goforwest/LipSync/CHANGES.txt

Version 4.9.6 | 2026-11-12
- THE 4.9.5 LATCH GUARD IS NOW HOST-TESTED, AND THE TEST FOUND A REAL BUG IN IT (the residual from the 4.9.5 bench, closed properly): the mid-window latch fix was the one item the radio bench could not cheaply prove — outputAction has no wire readout, so the field test would need a precisely timed physical SCROLL hold and could only infer the outcome from whether the next input emitted an IA,0 dispatch line. Rather than accept an indirect gesture test, the guard's decision is now the pure lsHostLatchCrossedHost() in LSHostSwitch.h (the LSPressureClassify/LSHostSwitch pattern), pinned by 9 new host checks: no-latch is always a no-op, same-host keeps the hold, host-changed releases, none->host and host->none both release, full-string (not prefix) equality, NULL-safe, and the RPA-stability property the fix relies on. Writing those tests immediately exposed an out-of-bounds read in the helper: the fixed-count comparison loop ran i <= LSHOST_MAC_CHARS over keys that can be SHORT ("" for an absent host), reading one byte past a short literal's NUL — ASan caught it as a global-buffer-overflow (168/168 timer, core aborted at 134). The loop now stops at the first NUL while still comparing full strings, so differing lengths stay unequal. This is the loop's characteristic failure mode (a fix introducing its own defect) caught by tooling rather than by another review round — the argument for making behavior testable instead of merely traced
- WHY THE GUARD'S PREMISE HOLDS (verified in the vendored lib, not assumed): the host key is the STORED BOND IDENTITY — lsHostActiveMac requires conn->bonded() and BLEConnection::getPeerAddr() returns _bond_id_addr whenever bonded (BLEConnection.cpp:133-136), which is assigned from the bond's peer_id.id_addr_info (saved/loaded at BLEConnection.cpp:260/269), never the live peer address. A privacy host's rotating RPA therefore cannot make consecutive reads differ and spuriously drop a legitimate hold — the property the new host test pins
- ALSO RELEASED IN THIS ROUND (the bench's other finding, harness-side but worth recording): a 4.9.5 bench re-run scored 11/11 wire-settled steps PASS, with both apparent failures traced to the DRIVER and not the firmware — the first B15 attempt opened no window because BT,1:3 was correctly refused with LSHOST_REFUSE_RADIO while the prior window tore down, and the bonds check ran while the device was legitimately in USB mode where BT,0 correctly refuses. Both are the honest-refusal behavior the review loop spent rounds establishing; full results in Build_Files/bench-16-4.9.5-results-2026-11-12.txt
- VERIFICATION: host core suite 206/206 under ASan/UBSan (9 new latch-guard checks + the 4 anchor checks from 4.9.5), timer suite 168/168; production compile clean at --warnings all (46% flash / 24% RAM); source ZIP rebuilt with the workflow's exact recipe and verified byte-identical. The guard's non-window behavior remains byte-identical to the bench-proven 4.9.4 path
- UPSTREAM-COUNT CLARIFICATION (for the next auditor of these posture lines): the tracker's 45 open ITEMS are 44 open ISSUES plus PR #81 (itself dispositioned upstream-side). Every posture line below that says "all 44 open upstream issues" means exactly those 44; a final pre-merge verification pass confirmed via the GitHub API that the disposition union across all posture lines covers precisely the 44 with none missing and none closed

Version 4.9.5 | 2026-11-11
- THE FINAL-DIFF-AUDIT FIX SET (a fresh-context adversarial pass over the exact shipped 4.9.4 diff — 4 reviewers with independent lenses plus per-finding adversarial verification, 11 agents; launched after the V4.9.4 release because the fix set had produced 3 of its own defects in review rounds 6-8 and was newly field-facing via the updater branch). 7 confirmed findings: 1 minor + 6 nits, zero majors. All fixed or corrected here; released as 4.9.5 within hours of 4.9.4 so the field exposure window stayed minutes-deep.
- A MID-WINDOW LATCH COULD CROSS THE SWITCH AND SWALLOW THE NEW HOST'S FIRST INPUT (minor, the real one): the 4.9.4 round-3 window gate keyed its latch guard on `!switchWindowOpen && !tempIsConnected` — but the input polls stay LIVE during a window, so a gesture engaged mid-window armed the latch while the guard was suppressed, and on the SUCCESS path (target admitted) tempIsConnected is true on every later pass: the latch crossed into the new host, whose first input took the hold-release branch and dispatched nothing (one swallowed input; joystick-as-scroll until then). The verifier's trace sharpened it: the DRAG half was mostly guarded elsewhere (LSBLEMouse::service's disconnect-cleanup flag raises within one main-loop pass and the loop's cancelSapOutputHold consumer ends the latch — only an ms-wide race could cross it), but the SCROLL half was unguarded end-to-end (cursorScroll sets no wire state, so the take-and-clear flag never raises). The guard's own contract ("never carry a latch across hosts") is now keyed on the connected host's IDENTITY via lsHostActiveMac (a bounded stack query, no FS): any host-key edge — none->target at admission, racer->none->target through a bounce storm, or host->host across a sub-second switch whose whole window fits between two 1 s polls — releases a held latch through cancelSapOutputHold() (LED default paired, no action-bearing event, the sensor-fault/unmount mirror shape). The original disconnected-state guard stays for every non-window path (zero non-window behavior change), and the identity key CANNOT reintroduce the bounce-storm churn the round-3 gate fixed: it flaps during bounces only while a latch is HELD, and the first edge releases it (outputAction -> NOTHING), so later flaps are no-ops and the LED/push narration stays suppressed. This also covers the audit's fifth-ordering finding (below) for the latch: even a window btFeedbackLoop never observed open releases its latch at the next host-key edge
- THE HORIZON ANCHOR'S FALLBACK WAS DEAD CODE, AND THREE SHIPPED DOCS MIS-ATTRIBUTED IT (nit x3, same root, three reviewers independently): `dispatchedMs ? dispatchedMs : connectMs` is unreachable as a connect-stamp selection — counted==true is set at exactly one site which co-stamps the dispatch on the next line, and every clear site clears both. The refused-disconnect case the 4.9.4 notes claimed the fallback served is actually DISPATCH-anchored: the stamp is taken at the decision point BEFORE the disconnect attempt whose rc is deliberately ignored (so a refused attempt marks the horizon from itself; each re-observe re-stamps — the re-decide cadence in that shape is connect+15 s, not the documented connect+12 s, bounded and in the safe direction). CHANGES.txt round 2, the LSHostSwitch.h helper doc, and the LSBLE.h inline comment all attributed the fallback to the refused case; all three now state the shipped truth. The anchor selection is extracted as the pure lsHostBounceHorizonAnchor() — now genuinely host-tested (the audit's "test-pinned" over-claim: the 4.9.4 suite pinned the comparison helper's arithmetic, not the shipped selection; a revert of the ternary passed 188/188) — and the first-observation reset site now clears the stamp with its tracking (previously stale-but-provably-never-read; the invariant no longer depends on that)
- THE ROUND-7 "ALL FOUR ORDERINGS" CLAIM MISSED A FIFTH (nit, behavior converges identically): a window whose ENTIRE lifetime fits between two btFeedbackLoop passes (sub-second target admission — bench-precedented: the racer connected 0.4 s into a window) is never observed open by the poll, so both reconciliation blocks skip and ZERO window-end reconciliations run — not the claimed exactly-one. Traced benign by the verifier end-to-end: the ungated transition block repaints the LED on the real transition (or the pre-window paint already equals the settled color), and the ungated change-detected push lands the settled truth the same pass. Behavior converges within one pass in every case; the defect was the completeness claim in CHANGES round 7 / round 9, now recorded here as the honest disposition. The latch half of that ordering is separately covered by the identity-key fix above
- THE GATE COMMENTS PROMISED AN APP AUTO-RETRY THAT DOES NOT EXIST (nit): the CA,1/IN,1 window-gate comments said "the app retries once the window closes" — sendCommand is one-shot and the retry is manual. Both comments now state the shipped truth (the app's waiter surfaces the refusal as a clean error via the fail-fast abort contract; the user re-runs the flow)
- VERIFICATION: host core suite 192/192 under ASan/UBSan (4 new checks pinning lsHostBounceHorizonAnchor: dispatched-wins, the wrap-tick fallback, the both-zero degenerate state, and the dispatch-over-connect selection), timer suite 168/168; production compile clean at --warnings all; source ZIP rebuilt with the workflow's exact recipe and verified byte-identical. The 4.9.4 bench results (B13-B15) stand — none of this round's code changes touches a path the bench proved except the latch guard, whose non-window behavior is byte-identical and whose window behavior was the defect being fixed

Version 4.9.4 | 2026-11-11
- THE 4.9.4 REVIEW-ROUND FIX SET (a fresh full-tree adversarial review over every firmware module — LSAPI/LipSync_Firmware/LSScreen/LSBLE/LSPressure/LSJoystick/LSInput/LSMemory/LSTimer/LSUSB/LSBuzzer/the pure helpers — plus the paired LipSync_Connect protocol layer and a re-verification of every recorded upstream disposition; production compile clean at --warnings all, host suites 188/188 core + 168/168 timer under ASan/UBSan). Seven majors — six regressions of the 4.9.x reshapes plus one in this review loop's own round-3 fix:
- THE SWITCH WINDOW'S KEEP-OPEN WAS DEAD CODE — THE RADIO WENT DARK AFTER THE FIRST BOUNCE (major, the 4.9.3 open-door reshape's own seam): lsHostSwitchWindowTick's keep-open branch called lsHostEnsureAdvertising(), whose FIRST guard refuses whenever a window is open (`if (g_switchWindowOpen) return false;`) — a 4.9.0 directed-era rule whose rationale ("do not fill the directed set's inter-arm gap with open advertising") does not apply to the open-window shape the 4.9.3 verdict shipped, and which made the re-ensure a silent no-op. The LIVE case is the bouncer's own bounce: a non-target connect STOPS the advertising set (the connection takes the radio role), the bounce disconnects it, and the stock DISCONNECTED auto-restart is SUSPENDED for the entire window lifecycle (lsHostSuspendAutoRestart, 4.8.7 — deliberately, so the racer cannot win the gap). Nothing else re-starts the set, so after ONE bounced non-target the window advertised nothing at all for its remaining bound: the TARGET could never connect (the switch silently could not complete), and the window burned its full 60 s before closing into open advertising — the exact opposite of the bouncer's "keep waiting for the target" contract. The keep-open now starts the set directly (while this window is open, open advertising IS the window); the tick retries every pass, so a refused start is self-correcting rather than terminal
- THE UM,1 ACK COULD STILL BE LOST TO THE RESET (major, the 4.9.1 drain fix's missing back-port): 4.9.1 closed the response-before-reset hole for softwareReset()'s dwell (CM/MP/SR/RS/FR) by draining serialTxService() every 10 ms — but enterUpdateMode() kept its own bare `delay(CONF_UPDATE_MODE_DWELL_MS)` before the reset, so the UM,1 ack it prints still rode the TX queue with no drain. A host that stopped reading the IN pipe (or a full CDC FIFO) left the ack queued, the reset killed the queue with the line still in it, and the port dropped with NO response — while LipSync Connect's update path blocks on exactly that ack (`sendCommand('UM,1:1', ...)`) and falls back to the SR + 1200-baud-touch choreography only when it FAILS, so the lost ack costs the deliberate-splash path and sends a healthy update down the legacy route (or times the wizard out). The dwell now drains the queue identically to softwareReset's
- ROUND 9 — VERIFICATION ROUND (no functional change; the loop's first clean round): every one of the nine 4.9.4 fixes was re-read in CODE (not by its comment) and its enclosing function confirmed — the switch window's keep-open direct start, the UM,1 dwell drain, the dispatch-anchored bounce horizon (+ the host-pinned helper), the btFeedbackLoop window gate (drag latch / LED narration / host push), the post-tick window-end reconciliation, the softwareReset close, and the CA,1 / IN,1 / UM window gates. The btFeedbackLoop control flow was then traced as a skeleton across every reachable ordering; the one residual case (a window OPENING mid-pass) is unreachable because the tick never opens windows — lsHostBeginSwitchWindow is reached only from the executor on the serial/menu path, never reentrant with this poll — and was confirmed consistent, not merely assumed. Full verification from a clean build directory: production compile clean at --warnings all (376120 B / 46% flash, 59092 B / 24% RAM); host suites 188/188 core + 168/168 timer re-run under ASan/UBSan from scratch; source ZIP re-verified 185/185 byte-identical with zero extras or duplicates. ROUND 9 FOUND NO NEW DEFECT — the first round of the loop to come back empty
- THE ROUND-4 WINDOW GATE DID NOT HONOR THE CALIBRATION CHAIN'S OWN EXEMPTION (minor, round-8 fix-set audit, latent): the full calibration's STEP 5 runs its center through setJoystickInitialization — performJoystickCalibration sets g_calibrationCenterStep around that call precisely so the chain's own internal step is never refused by the in-flight gate. The round-4 window gate was added BELOW that bypass check and did not test the flag, so the exemption covered only one of the two refusals above it. The call is unreachable while a window is open TODAY (the round-4 CA,1 gate stops a calibration starting during a window, and the executors' calibrationRunning gate stops a window opening during one — mutually exclusive by construction), so this is latent, not live. It is fixed anyway because the failure it would produce is bad and remote: step 5 refused mid-run, g_centerRunning false, the chain aborting with "center step refused", and the cause sitting three gates away in an unrelated subsystem. The gate now honors g_calibrationCenterStep exactly like its sibling above it. CA,1 deliberately gets NO such exemption — its only internal re-entry points are the user action path (CONF_ACTION_CURSOR_CALIBRATION) and the Hub menu page, both of which SHOULD be refused during a window
- THE WINDOW GATE READ PRE-TICK STATE, SO ONE PASS DISAGREED WITH ITSELF (minor, round-7 fix-set audit): within a single btFeedbackLoop pass the round-3 gate sampled g_switchWindowOpen BEFORE lsHostSwitchWindowTick() ran, and that tick can close the window on the very same pass (target admitted, bound elapsed, bounce cap hit). The pass therefore ended with three consumers disagreeing about whether a window was open: the LED/drag reconciliation had read "open", the push had been suppressed on that basis, and the tick had already closed it. The damage was bounded — lsHostPushState is change-detected against persisted values so the push still landed, just one 1 s pass later, and the repaint likewise — but a gate whose whole purpose is to stop split-state deserves no such exception. The window state is now re-read after the tick and the reconciliation (repaint + push) runs immediately on the pass that actually ended the window; all four paths (closed mid-pass, closed before the poll ran, still open, already closed) were traced to confirm exactly one reconciliation and no double-paint
- THE WINDOW-ENDED RESYNC LEFT THE BT LED STALE (major, round-6 review of the round-3 fix's own first draft): the round-3 gate re-synced g_btIsConnected to the settled radio state on the first pass after a window closed — but it did so BEFORE the transition block, so that block's own change test (tempIsConnected != g_btIsConnected) read "no change" on exactly the pass meant to reconcile the LED. The LED therefore kept whatever the window's last bounce or close left it showing, with nothing in the steady state to repaint it — the 4.5.28 dark-until-an-unrelated-event class, reintroduced by the very gate written to prevent window-narration churn. The resync now REPAINTS from the settled truth on that one pass (solid blue when the target is connected, setLedDefault when it is not), still without replaying the storm's transitions; because it adopts the state first, the transition block sees no change and cannot double-paint. Caught by re-reading the fix rather than the original code — the class the loop exists to catch
- RESET PATHS RESET OUT FROM UNDER AN OPEN SWITCH WINDOW (major, round-5 ownership sweep): neither softwareReset() — the SHARED reset choke point behind CM/MP/SR/RS/FR and both menu resets — nor enterUpdateMode() (which resets directly through enterSerialDfu/NVIC_SystemReset and never calls softwareReset) closed an open switch window first. Every one of those paths can fire while a window is open (the bound is 60 s: a user who starts a switch and then changes mode, or a remote app that resets, is ordinary), and a reset does not unwind window state: g_switchWindowOpen still true, the stock DISCONNECTED auto-restart still SUSPENDED by lsHostSuspendAutoRestart, an armed target IRK, a live bounce counter, and g_switchAdvRestartPending armed for a radio about to vanish — while btmouse.end() tears the stack down under the window's own tick and the window's pending INFO lines can interleave with the shutdown page's output. Both now close the window first (softwareReset at the top, before its teardown calls, so the window never observes a half-dead stack; enterUpdateMode before its ack, so radio work cannot interleave on the wire), restoring the stock radio state so the reset happens from exactly the state a normal reset does. The two guards are both required and neither is redundant: UM bypasses softwareReset entirely
- THE CALIBRATION GATE WAS ONE-DIRECTIONAL (major, round-4 cross-module review): lsHostExecuteSwitch and lsHostExecuteForget both refuse while a calibration/center flow is in flight (LSHOST_REFUSE_CALIBRATION), but the REVERSE was never enforced — CA,1:1 and IN,1:1 were accepted while a switch window was open. The two then ran CONCURRENTLY, and neither participant could tell: the window's tick is serviced from the MAIN LOOP (lsHostServiceSwitchWindow) and from btFeedbackLoop's poll, and calibration's step-0 shutdown disables the joystick/scroll/input/pressure polls but NOT those, while it holds canOutputAction false with the cursor frozen and the output released. A window closing mid-calibration therefore admitted the target, painted LED state and ran the close's radio/LED work against a device whose input pipeline is deliberately down — and the user's held corner pose was being sampled by a joystick poll the flow had shut off (calibration likewise calls releaseOutputAction, so the window's own drag-latch assumptions were already void). The two flows have no honest interleaving: calibration OWNS the joystick and the window OWNS the radio. Both CA,1 and IN,1 now refuse while a window is open, with a named ERROR line mirroring lsHostRefusalLine's calibration wording so the two directions read identically on the wire; the Hub-menu calibration entry reaches the same gate through setJoystickCalibration and already schedules its own return-to-menu when the flow does not start, so a refusal there cannot strand the menu. The reverse direction stays pinned by the host suite (LSHOST_REFUSE_CALIBRATION precedence)
- THE BOUNCER'S CONNECT/DROP STORM WAS NARRATED AS REAL HOST CHANGES (major, round-3 cross-module review): btFeedbackLoop's connection-transition logic — the LED scan/solid narration, g_btIsConnected bookkeeping, the drag-latch release and the app-facing BT,4/BT,5 host push — never consulted g_switchWindowOpen. While the bouncer holds the lockout, EVERY non-target reconnect is deliberately connected-then-dropped within milliseconds, and the 1 s poll cannot distinguish that storm from genuine host transitions. Ungated, each bounce cycle re-armed and deleted the BT scan-blink timer (LED churn on a device the user is watching for the switch to finish), thrashed g_btIsConnected, re-ran releaseOutputAction() on every transient drop, and pushed host-table changes to the app whose ACTIVE ROW flapped with whichever microsecond the app happened to poll in — narrating the lockout working as a series of user-visible host changes. The window's own tick owns connection decisions for its whole duration (it bounces non-targets, admits the target, closes), so the poll now yields that ownership: the transition block, the drag-latch release and lsHostPushState are all suppressed while a window is open, and g_btIsConnected re-syncs to the settled radio state on the first pass after the window ends so the close itself is not replayed as a fresh transition. The watchdog and the window tick still run (they are what end the window)
- ROUND 2 (the re-review over this fix set, and its closure): THE BOUNCER'S TEARDOWN HORIZON WAS MEASURED FROM THE WRONG ANCHOR (major, the 4.9.0 refused-disconnect hatch): the same-handle tracking's "lingered too long, re-decide it as a new connection" escape keyed on g_switchBouncedConnectMs — the FIRST OBSERVATION stamp — under a 4x-decision-grace (12 s) horizon. That hatch exists so a REFUSED disconnect cannot surrender the lockout forever, but a connection bounced LATE has most of its horizon already spent: an undecidable RPA non-target sits through the full 3 s bond-decision grace before the bounce dispatches, and any slow/loaded peer can outlive the remainder. The re-decide then fired while the ORIGINAL connection was still tearing down — re-counting and re-disconnecting the same dying link, driving the bounce counter toward LSHOST_BOUNCE_MAX (600) whose ONLY exit is the MISMATCH close, i.e. the honest "switch NOT confirmed" report for a window the bouncer was still legitimately holding. The horizon now starts at the bounce itself (g_switchBounceDispatchedMs, cleared with the rest of the per-connection tracking at every reset site), falling back to the connect stamp only when no bounce has dispatched — exactly the refused case the hatch is for. Extracted as the pure lsHostBounceTeardownStillRunning() in LSHostSwitch.h (the LSPressureClassify pattern) and pinned in the host suite
- VERIFICATION: host core suite 188/188 under ASan/UBSan (6 new checks: the dispatch-anchored horizon, the connect-vs-dispatch anchor disagreement), timer suite 168/168; production compile clean at --warnings all (46% flash / 24% RAM, built via the release recipe with the pinned core and isolated libraries); the paired app's BT host table / hub-remote page map / UM update flow / calibration abort paths re-checked against the firmware wire contract (every FW_PAGE_TO_MIRROR id still matches LSScreen.h's page defines exactly); upstream dispositions re-verified against code — no claim contradicted, no firmware-relevant issue left without one

Version 4.9.3 | 2026-11-10
- THE SWITCH WINDOW RETURNS TO THE PROVEN OPEN DOOR; 4.9.0's RPA RESOLUTION DOES THE DECIDING (the directed trial's final verdict, on the wire): the 4.8.17 directed experiment stayed in the tree when the 4.9.0 review round committed, and it FAILED with both hosts — Windows silently ignores directed packets (bench 2026-11-07), and the iPhone cannot establish through a directed set at all (bench 2026-11-09: taps produced "connection attempts fail" with ZERO wire events for 60 s; every host connect that ever worked — the Mac's preps included — landed inside the ~1 s first arm or after the window closed into open advertising). The window is stock open advertising (start(0), held by the tick's idempotent keep-open ensure) with the 4.8.12 bouncer as the keeper — and 4.9.0's RPA tick resolution (IRK capture + software resolve) as the target decision, the combination where a privacy host's connect can actually REACH the decision logic. Bench 2026-11-10: the RPA admission PROVEN on radio — a forced iPhone reconnect 1.1 s into an open window carried its rotating RPA through the armed IRK analysis and was ADMITTED (and the exclude branch proven: the same RPA bounced in milliseconds when the Mac was the target). The directed lib path stays (bounded, unused by the window; the trial is closed)

Version 4.9.2 | 2026-11-09
- "ALREADY ON THIS HOST" NAMED FOR THE BLATANT CASE (the final B5 re-run finding; the 4.9.0 mute swallowed it): the ALREADY_ACTIVE refusal has two causes that are IDENTICAL at execution time — BENIGN (no host was active when the confirm page rendered; the target claimed the link during the 2 s dwell: the outcome the user asked for, silent refresh is right) and BLATANT (the user picked the host that was ALREADY connected: the original bench finding "2- no refusal" — the user expected feedback). The 4.9.0 gate muted whenever the target equaled the active host, so the blatant case went silent again (re-run: "Already on this host didnt show"). The confirm page now captures whether the target was ALREADY active AT RENDER (_btSwitchTargetWasActive) — the only datum that separates the two — and finishBtSwitch mutes only the benign case; the blatant case gets the error cue + "Already on this host" note like every other refusal (never a silent no-op)

Version 4.9.1 | 2026-11-09
- THE 4.9.1 REVIEW-ROUND FIX SET (a fresh 8-agent adversarial review over every firmware module group plus the paired LipSync_Connect protocol layer, and the closures; production compile clean at --warnings all (45% flash / 24% RAM), host suites 182/182 core + 168/168 timer under ASan/UBSan, app 505/505 (+ the two new fail-fast contract pins) + lint/typecheck/format clean, protocol cross-check all 9 sections against 4.9.1, source ZIP 185 files byte-identical)
- FAILED SETTINGS READS NO LONGER ACT ON THE VALUES THEY FABRICATE (major, the read-truth doctrine completed across the API): the 4.9.0 fix covered the newest code (HA/HB, heal writes, applyHardBandActionOverrides) but never back-ported to the older getters that APPLY state live — a transient settings read failure (readInt/readFloat yield 0) silently re-opened a caregiver-disabled mouthpiece (SD), lifted the menu-only/mode-lock/cursor-hold gates (MA/LK/CF), reset the timing windows, rescaled the cursor (SS re-applied the default range), re-applied default thresholds to the live sensor (ST/PT/HS/HP), re-applied the compiled deadzones (IZ/OZ), rewrote the switch-remap table from the stored-0 path (SA-GC), and answered HA/HB "NOTHING" while the live table kept the real action. Every affected getter now gates its live-apply on the read that produced the value and answers the IN-FORCE value on a failed read — what the app displays is always what the device enforces. New in-repo helpers: switchRemapLiveCell (the live table cell) and hardBandLiveAction (the live HA/HB row); loadJoystickDeadzonePair now reports read truth
- THE HANG WITNESS CANNOT CONVERT A DOG CYCLE INTO AN UNBREAKABLE 4 s LOOP (major): on the bootloader-leftover-SD USB boot (the state setup() seeds g_softDeviceEnabled from the chip for) the witness armed at priority 0 — its retention marker takes the SD SVC path, an SVC cannot preempt an exception at equal priority, so the marker pended behind the ISR's own NVIC_SystemReset() and never landed; the successor read pm=0, cleared the streak, and the 3-strike hang settle could never fire. The priority expression now tests the chip's SD state (priority 0 only when the SoftDevice is genuinely down); a priority-7 ISR's SVC is legal and the raw path still owns the SD-down case
- THE DEFERRED ADVERTISING RESTART NO LONGER TRUSTS A STALE isRunning() (major): the pending flag existed because a directed set's termination event can lag its self-termination — but the service cleared the flag on exactly that young "running" reading, the event landed afterward, the directed branch cleared the flag without restarting, and the radio went silently off (narrow per event; widest on the bounce-cap close, after 600 connect/drop cycles back up the SD event queue). The pending now carries its arm time: a running reading younger than the 2 s event-gap bound proves nothing; a set still flagged running past the bound is genuinely on air and the pending settles
- CH,1 CAN NO LONGER REPLACE THE SAFE-MODE MENU (major): the API route registered the FULL main menu over a settled safe boot's safe menu — the exact UI the action tables deliberately withhold in safe mode (CONF_ACTION_START_MENU is NOTHING in every safe cell), handed to a sip/puff user through the app's own remote, with mode changes and settings writes a menu walk away. activateMenu refuses while safe mode is enabled, and the CH,1 OPEN branch answers the named refusal (FAIL,3 + an ERROR line naming safe mode) instead of the SUCCESS-ack-for-a-drop convention reserved for transient frozen-window presses
- THE BOOT-TIME RESEED CAN NO LONGER APPEND ITS WAY TO FLASH EXHAUSTION (major): initialize()'s reseed discarded InternalFS.remove()'s status — a corrupt directory entry (the damage class the reseed exists to heal) or a nearly-full flash refuses the remove, the FILE_O_WRITE open found the surviving entry and APPENDED the 323-byte seed after the garbage, written==jsonLength passed, and every boot grew the file. The seed write is now gated on the remove succeeding, and the result is read back and byte-verified (the runtime writers' own rule) — a failed verify is removed, not "succeeded"; a failed mount is also NAMED on the wire (the last silent FS class)
- APP: A MID-CALIBRATION ABORT FAILS FAST (major): the firmware's abortJoystickCalibration emits FAIL,3:CA,1:1 as the TERMINAL line for every abort, but only the corner-1 waiter matched it — a failure at corners 2-4 (persistence failure, timer refusal) matched nothing and the app sat at "Step N of 6" for the full 45 s while the user held the pose the device had already abandoned. The corner-2..4 and re-center waiters now match the terminal line and fail with the reason; the flow's error/cleanup path was already correct
- APP: THE BT HOST TABLE LOAD IS COMMIT-ATOMIC (major): rows + count committed BEFORE the row reads — one failed row read (a forget shrinking the bond set mid-load) left count-without-rows that the poller would not repair (its lastCount now equaled the stale count), and the final applyHostCount could clobber a fresher MANUAL BT,4 push that landed during the loop. The rebuild now builds in scratch, commits after every row landed, re-renders the refreshed rows, and aborts the commit when a push changed the count mid-load (the push owns fresher state; the poller's count-change check refetches)
- THE HID WATCHDOG'S IDENTITY PROBLEMS (three closures): the grace is re-keyed per LINK EPISODE (a new handle observation or a link-less pass resets grace AND budget — the SoftDevice reuses handle numbers, so the 4.9.0 handle-keyed grace let a same-numbered reconnect inherit an elapsed timer, and a window-frozen anchor bounced the freshly switched-to target on its first post-window pass; every window ending now also clears the anchor); the cycle budget is per link episode, not per session (host A's burned cap no longer silently disables self-correction AND diagnostics for every later host); and the disconnect-refusal cap now actually STOPS the attempts — the old shape logged "leaving the link to the host" and kept retrying every pass forever
- THE RPA BOUNCER DISTINGUISHES REFUSAL FROM EXCLUSION: an sd_ecb_block_encrypt refusal (the shared AES engine, busiest exactly when the bouncer's own connect/drop storm runs) folded into "not the target" and bounced the legitimate privacy target; lsHostRpaResolvesIrk is now tri-state — a computed hash mismatch stays definitive (millisecond lockout for the public/static racer class preserved), a refusal grants the bond-decision grace and retries next tick
- THE BLE TAKE-AND-CLEAR MIRROR IS NOW EXACT: pending click/button state with _buttons already cleared (a release whose transmit the drop ate) raises the flag like the USB twin does
- THE USB BUSY-SKIP LATCH IS TIME-BASED: the 3-attempt counter assumed the 20 ms poll, but pending button state drives attempts at main-loop granularity — an episode could latch ~20x sooner than the documented 60 ms; CONF_MOUSE_EP_BUSY_SKIP_MS (60) measures wall time now
- THE FAULT CANCEL RESPECTS LATCH OWNERSHIP: a pressure-sensor fault mid-hold cancels the latch only when the PRESSURE input owns it — a mouthpiece-sensor fault used to tear down a drag the user was actively steering with a hub button or external switch (fail-safe direction, wrong owner)
- THE CLASSIFIER'S STATE MIRROR IS PINNED: static_asserts bind LSPRESSURE_CLASSIFY_* to PRESS_SAP_MAIN_STATE_* in the .ino (the header deliberately compiles without LSConfig.h) — a silent renumber would remap the hard sip/puff actions or route them to an inert row, the same drift class the release fraction's assert already covers
- GETTER HEALS KEEP THE HARD BAND HEALTHY + TERMINATE: the ST/PT/HS/HP getters' out-of-range heal now heals the hard pair like the setters do (a healed regular floor could strand the band inert), gated on the heal write landing; healHardThresholds carries a re-entrancy guard (the getters' heal arm calls back through it — a persistently failing write would otherwise recurse heal->getter->heal forever)
- IN,0 GAINS THE SENSORLESS GATE ITS SIBLING CA,0 PINS AS MANDATORY: on a safe/sensorless boot the getter ran getInputCenter + setMinimumRadius against the never-begun object; it now answers the zeroed default center without touching state
- RESET PATHS ARE HONEST ABOUT THE WIRE: softwareReset()'s dwell drains the response TX queue every 10 ms (the response-before-reset guarantee for CM/MP/SR/RS/FR silently depended on CDC FIFO space — a host that stopped reading the IN pipe lost the ack entirely); UM,1 fails SAFE past its 2 s init-window wait (a raw GPREGRET write with the SD ambiguously up is the APP_MEMACC reboot-to-app class — it now answers FAIL,3 + a named ERROR line)
- THE SERIAL CALIBRATION PATH ARMS THE ENTRY FREEZE (a real hole the constant's wrong arithmetic hid): the first corner prompt lands at START_DELAY + STEP_DELAY + 3xBLINK (~2950 ms — the old "~1950" note dropped START_DELAY), and the serial CA,1:1 path armed no freeze at all — on a safe-mode boot the safe menu sat registered beneath a "calibration starting" flow with a held Select able to walk its destructive confirm before step 0's poll disable. CONF_JOY_CALIB_ENTRY_FREEZE_MS 3200 with the corrected arithmetic, center/step freezes +500 ms each (a wedged-I2C push must not consume the whole margin), the error page joins the step freeze, and freezeMenuInputFor is the reusable bare-deadline arm
- SCREEN/MENU: the No-USB error page's painted latch follows the PUSH (flushDisplay returns bool) — a health-demoted display used to latch the page as painted while it existed only in RAM, suppressing every retry for the rest of the outage; the Hub-remote Close verifies after the exit grace (closeMenu no-ops while a dwell owns the display and the firmware still acks SUCCESS — a dropped close left the menu navigable while the mirror showed closed); the sync poll chain survives a single failed CH,0:0 (one bounded 2 s retry; the transient-page mirror used to freeze on the running page until the next physical press)
- APP: the RS,1 ack is handled (every successful "Restore default settings" used to log a protocol-gap warning naming a healthy operation); the dead SE handler is removed (no such endpoint); the pre-flash snapshot FAILS on a null OM/CM readout (core endpoints — a failed load used to restore "settings" with the device left in the new firmware's default mode); the legacy mode-restore tolerates the SR reset race (the setters' own softwareReset made the final SR's handshake time out and the wizard reported a restore failure that never happened); the HS/HP confirm chips are hpa-typed (no more "10.25 → 10.250" echo and raw-text undo values)
- CONTRACTS + COMMENT TRUTH: LSJoystick enforces its own documented (0,1) deadzone range at the setters (the enforcement the header claimed existed only at API call sites — a direct caller could classify every reading as dead), getOuterDeadzoneFactor exists for the read-truth answer, JOY_MIN_CALIB_RADIUS 1.0 -> 3.0 mT (matches the API's corner plausibility minimum; bounds the uncalibrated-biased-neutral hair-trigger window), the dead DOG-branch counter read replaced with the documented constant it always resolved to, the pt=1 milestone comment states its honest bounds (a hang in the mount/seed window still dies by the 30 s DOG, which wipes the trail wholesale — pt=1 names the non-hang death classes), the SVC retention path's split clr/set pair is documented with its microsecond forensics window, changeOperatingMode's unreachable mode assignment removed with the trap it posed for a future softwareReset bail-out, writeObject's docblock describes the whole-file write it actually performs, readPoint rejects non-numeric coercion (one bit-flip away from fabricating {0,0} corners), the LSConfig budget narrative no longer contradicts itself (~380-390 B populated, six-digit packed triples), and the buzzer/circular-buffer docstrings describe the implemented, load-bearing methods they mislabeled "not implemented"
- UPSTREAM POSTURE (unchanged from 4.9.0): all 44 open upstream issues carry recorded dispositions; this round introduced no new upstream items and regressed none — the fixes above are hardening of shipped 4.9.0 mechanisms, verified against the same issue list
- VERIFICATION: host core suite 182/182 under ASan/UBSan, timer suite 168/168; production compile clean at --warnings all (45% flash / 24% RAM, built via the release recipe with pinned core + isolated libraries); app 505/505 (two new pins: the calibration abort fail-fast, the commit-atomic BT table) + lint/typecheck/format/html/css clean; protocol cross-check all 9 sections against 4.9.1; source ZIP rebuilt with the workflow's exact recipe and verified 185/185 byte-identical

Version 4.9.0 | 2026-11-08
- THE 4.9 REVIEW-ROUND FIX SET (a full review/fix loop over the 4.8.18 tree — the multi-host switch window, the HID watchdog, every module group, and the paired LipSync_Connect tree; production compile clean at --warnings all (46% flash / 24% RAM), host suites 168/168 timer + 182/182 core under ASan/UBSan (12 new checks), app 502/502 + lint/typecheck clean, protocol cross-check all 9 sections against 4.9.0)
- RPA TARGETS ARE ADMITTED BY THE SWITCH WINDOW (major, the bouncer's blind spot): the tick's identity match compared the connect address BYTES against the bond's stored identity — an iOS-style privacy host reconnects with a rotating RPA whose bytes never equal the stored identity, so switching TO such a host bounced the legitimate target for the whole 60 s bound ("bouncing non-target <RPA>", every retry, then open advertising resumed and the phone finally connected). The arm now captures the target bond's IRK and the tick resolves the peer's RPA against it (Bluetooth Core 5.3 Vol 3 H 2.2.2 ah(); sd_ecb_block_encrypt is a big-endian AES core so the little-endian block is byte-reversed in/out per bt_encrypt_le — the byte order is Zephyr/Nordic rpa.c-verified, independently confirmed against the vendored lib's own BLESecurity::resolveAddress, and pinned in the host suite). ONLY an UNDECIDABLE RPA peer (the bond carries no IRK) gets a 3 s bond-decision grace — bond completion flips getPeerAddr to the stored identity and the byte match then admits it; public/static non-targets (the bench Mac/Windows class) AND RPA peers the armed IRK just EXCLUDED are decided at first sight and bounce in milliseconds (round-2 review: a grace on every first sight would hand the racer 3 s of link per cycle and reopen the wrong-host race)
- THE BOUNCER SURVIVES A REFUSED DISCONNECT (4.8.16's quiet path could surrender the lockout): the same-handle teardown skip trusted a lingering handle forever, but a disconnect the SD refused (mid-teardown race, bench 4.8.15's class) left the reconnecting old host holding the link for the window's remainder with no bounce, no retry, no line. A handle that lingers past 4x the decision grace is re-decided as a NEW connection (still bounded by the bounce cap); the honest MISMATCH close now fires for a persistent non-target
- A FORGET SUPERSEDES AN OPEN SWITCH WINDOW (LSAPI): BT,2 has no frozen gate and could land mid-window — the window kept the radio directed at the just-forgotten bond, pair-new was dead behind its bouncer for the window's remainder, and the forgotten host (keys intact on ITS side) could reconnect, match the armed bytes, and close the window reporting a successful "switch" toward a bond that no longer exists. lsHostExecuteForget now cancels any open window first (the stock radio state restored; the forget owns the world)
- BT,3 IS HONEST AND WINDOW-AWARE (LSAPI): pair-new acked SUCCESS without verifying advertising started (start() can refuse in the post-disconnect SD-teardown window — bench 4.8.5/4.8.10's class) and had no open-window guard (the bouncer would drop every peer pair-new exists to admit, behind a SUCCESS ack, for up to 60 s). It now refuses FAIL,3 + a named line while a window is open, verifies lsHostEnsureAdvertising's new bool return (the Hub pair-new branch carries the same check + its "Radio busy" note), and the Hub branch gains the calibration/center gate its serial sibling always had (a verified hole: a serial IN,1:1/CA,1:1 landing while the Hub sat on the pair-new row ran the radio call mid-flow and the note's 2 s transition repainted the host list OVER the calibration prompt 50 ms after step 1 drew it)
- THE SWITCH WINDOW'S DEAD MECHANISM IS HONESTLY RETIRED (the 4.8.14 comment-truth debt): the block comment, the arm's docstring, the "WHITELIST, NO IDENTITY LIST" block and the hasIrk field comment still described the retired whitelist/directed-filter machinery (the next bench operator would believe the controller lockout was armed — 4.8.12 proved S140 ignores it, which is WHY the bouncer exists). Rewritten to the shipped directed+bouncer doctrine; the dead g_switchWlPtrs/g_switchIdPtrs/g_switchIdKey storage removed (they were the two --warnings all violations); SWITCH_WHITELIST_TIMEOUT_S renamed LSHOST_SWITCH_WINDOW_TIMEOUT_S; the wire label "wl=" renamed "target=" (nothing parsed the old key)
- HID WATCHDOG HARDENED (three edge classes): the 5 s grace now belongs to the LINK it started on (a drop+reconnect the 1 s pass never observed as link-less used to inherit the elapsed timer and bounce a legitimately-restoreing CCCD mid-grace — burning one of the 3 session cycles); a cycle is consumed only when the disconnect actually dispatches (a refused disconnect no longer burns budget without cycling anything — after 5 refused attempts the watchdog names the cap and leaves the link to the host); and the refused-retry cadence re-graces at 500 ms so the retry rides the 1 s pass
- LATCH END-TO-END ACROSS A BLE BOUNCE (the 4.8.1 USB twin): a drop→sub-second reconnect inside btFeedbackLoop's 1 s observation left the DRAG latch alive with the wire button already cleared by LSBLEMouse::service's disconnect cleanup (cursor moves, no button, until the user's release self-corrected). The cleanup now raises a take-and-clear flag (LSBLEMouse::takeDisconnectedWithButtonState, the LSUSBMouse mirror) and the loop ends the latch with it — routed through cancelSapOutputHold() so the LED restore matches the twin paths (the USB consumer gains the same setLedDefault pairing)
- THE STUCK-NEUTRAL ERROR LINE NOW COVERS RECOVERY (major, LSPressure): the once-a-minute ERROR fired only on RETRYING_INITIAL — the no-baseline class. With a RETAINED baseline (cable jostle mid-session, the exact fault class the machinery exists for) the recovery loop can only produce ACTIVITY_REJECTED/ATTEMPTS_EXHAUSTED, which re-armed startOffsetUpdate() forever: a re-seated mouthpiece whose new neutral left the retained-offset band (or a user threshold lowered to the 2.0 floor shrinking the band) held the device's PRIMARY INPUT inert with zero wire trace. The same bounded report now covers every failed recovery window, and the retry counter resets at the fault boundary (a fresh reporting minute per episode, matching the unhealthy-line rate limiter)
- HA/HB GETTERS ANSWER THE ALLOWLIST TRUTH (LSPressure/API): an in-vocabulary but disallowed stored action (a hand-edited HB=24 FACTORY_RESET — switchRemapAllowed refuses it on the live table) was answered with SUCCESS while the hard puff kept firing the compiled row. The getter now falls back to the compiled default exactly like the live load path, so what the app displays is what is in force
- SETTINGS WRITES REFUSE FAILED READS (LSMemory): ArduinoJson 7 clears the document then parses, so a truncated-but-parseable file leaves a NON-null partial document while isLastReadOk() is false — writeInt/writeFloat/writeString/writePoint merged the new key into that partial document and wrote it back: the file then parses clean, initialize()'s re-seed never fires, and the keys the truncation destroyed silently became per-key-healed defaults instead of a named refusal (the storeModePair house rule). The deadzone pair's heal arm carries the same gate. VN/ID keep their heal-writes — the one pinned exemption (their only legal stored values ARE the compiled constants/the live UID, and the local assignments keep the answer correct on a failed read)
- WATCHDOG BUDGET FRESHENED FOR THE DFU RESET (the update path): the armed 30 s WDT is fed every loop pass and SURVIVES warm resets; the stock bootloader never touches it, so without this the bootloader inherited a PARTIALLY-CONSUMED budget (up to 30 s minus command processing). enterUpdateMode now reloads the counter from zero before either reset path, handing the bootloader a full CONF_WATCHDOG_TIMEOUT_SEC. THE HONEST CEILING (round-2 review correction): the budget cannot be EXTENDED — nRF52 PS blocks CRV/RREN/CONFIG writes while the WDT runs ("After it is started... blocked for further configuration"; the round-1 SVD read was wrong — RW is the static access type, the lock is behavioral), so the bootloader's ceiling stays 30 s. That covers the production path (LipSync Connect streams immediately after the UM ack; a few seconds over USB CDC); the serial-monitor manual path (SETTINGS + UM,1:1 then a hand-driven flash) must begin within ~30 s — documented. A true extension needs a bootloader-side feed (a separate vendored binary, out of scope); do not re-add a CRV write assuming it works
- TIMER NESTED-RUN GUARD MATCHES ITS CONTRACT (LSTimer): the re-entrancy guard only covered the currently-executing callback — a nested run() reset the deferred dispositions (especially RUNANDDEL) of every OTHER slot the outer pass had marked, silently deferring a due RUN_ONCE fire a full interval and desyncing getNumRuns()-keyed calibration chains. The first loop now skips slots already carrying a disposition (latent today — no callback runs its own pool — but the guard now matches the header's own contract; host-pinned with a two-slot nested test)
- RETENTION RAW-PATH RMW IS INTERRUPT-SAFE (LSApiDeclarations): the mask-based two-context argument only holds for the SVC path; on USB-only boots the witness ISR runs at priority 0 and could preempt a loop-context update between load and store, erasing the ISR's marker (a hang forensics stamp lost → pm=0 "unattributed"). The raw path (SD-down by definition) is wrapped in a PRIMASK critical section
- SCREEN/MENU HARDENING (LSScreen): a PENDING TRANSITION freezes menu input even after its deadline is consumed (the poll slots fire inputLoop before screenLoop — on the exact expiry pass a physical close landed, then the same pass's continuation re-registered its page onto the closed menu: the drawn-but-dead state closeMenu exists to prevent, CH,0 honestly answering "closed" while the OLED showed a page); the Hub pair-new branch's calibration gate + honest advertising check (above); the three draw-only dwell pages (mode-locked 32, calib warn 552, factory-reset warn 572) zero _currentSelection per their siblings' convention; fullCalibrationPage arms the centerResetPage freeze for its ~2 s pre-prompt gap (a stray Next painted a cursor overlay over the prompt text); the dead Back-nav remnants (RESTART's trailing else + commented lines — its SAFEMODE arm is LIVE and kept; FACTORY_RESET's unreachable SAFEMODE arm now falls through to moreMenu explicitly), the dead testPage (+ _testScreenAttempt), and btSwitchConfirmPage's duplicate _begun check are removed with rationale; the CH,5-before-CH,1-ack ordering is pinned as deliberate (idempotent state telemetry vs the BT,1 outcome-narration rule)
- BOOT FORENSICS + FS HYGIENE: the pt=1 trail stamp moved to immediately after initMemory() and is unconditional (a hang in the mount/seed or beginComOpMode — the historically demonstrated hang phase — reported pt=0, indistinguishable from pre-setup death; pt=1 now reads "memory up" and pt=0 really means pre-initMemory); initMemory sweeps the orphaned temp files (a power cut between a writer's pre-remove and its rename left /settings.tmp and /bleverdict.tmp on flash until that module's next write)
- DEAD CODE + CONTRACTS: CONF_USB_RESTART_MAGIC removed (dead since the witness-v5 discovery that .noinit does not survive resets — the once-guard lives in the retention marker); the witness-v4 GPREGRET2 bit-map block removed (it mapped bits the 8-bit register does not have — v5/v7 are the live record); the dead increaseJoystickAcceleration/decreaseJoystickAcceleration removed (zero call sites); the HS/HP String-overload docblocks no longer claim "(returns the value without writing)"; the arm's outcome coupling fixed — lsHostArmSwitchWindow runs for EVERY switch (out != NULL was reporting-only; a future caller omitting the outcome silently lost the B4 contingency)
- APP-SIDE (LipSync_Connect): the Hub-remote mirror's page coverage completed — seven self-naming dwell pages were unmapped (11 Exiting, 33 Changing mode, 34 the 4.8.3 hold-note, 552 the calib warning, 572 the factory-reset warning, 623 BT switching, 624 the BT note) AND the 4.8.2 transient auto-poll entries for 11/33/572/623/624 were unreachable dead code behind the unmapped-page early return; the mirror now renders each page as itself, follows the dwell, and an unmapped-but-transient future page falls through to the poll instead of parking on the "does not render" note; page 55 relabeled as the calibration RUN page (552 is the warning); the mirrored page map gains test coverage (a new suite test pushes all seven pages and asserts each renders as itself), the calibration-flow simulator fixture is corrected to the 4.9.0 page ids (552 warning → 551 confirm → 55 run → main); the ERROR-0xx hardware-error shape is classified as a device diagnostic (verified OLED-only in the current firmware, so this is deliberate forward cover — not the "serial corruption" counter if it ever reaches the wire); a disconnected Bluetooth card no longer claims "USB mode" (CM unknown → "—"); the host-row list gets the CSS its class names always implied (bounded-height scroll for up to 8 rows); the steppers bounds test attaches the harness port (the 4.8.7 disconnect guard disabled everything under the old port-less shape) and gains an explicit no-port assertion pinning the all-disabled contract
- UPSTREAM POSTURE (re-audited this round): all 44 open upstream issues carry recorded dispositions; 18/18 "addressed" claims verified against code (17 firmware + #67 in the app), both mitigations (#74, #75) verified as described, #54 parked without a code claim. The firmware-binaries branch still holds 4.6.6 — everything after is invisible to app-based updaters until the V4.9.x tag is pushed (bench-first, tag-last)
- ROUND 2 (the adversarial re-review over this fix set, and its closures): a forget of an INACTIVE host mid-window could stop the window without resuming advertising (no disconnect event would ever restart it — the radio sat silently non-discoverable); lsHostExecuteForget now resumes open advertising on the ALLOW path when nothing is connected, and a REFUSED forget no longer disturbs the window at all (the cancel moved after the decision gates); lsHostEnsureAdvertising now refuses while a window is open (its old shape could start OPEN advertising in the directed set's inter-arm gap — the racer's door — and the tick would then skip re-arming); the Hub pair-new branch gained the serial path's open-window gate; the window's millis bound now fires on every non-target path (the early returns used to skip it — a lingering non-target could hold the lockout past the documented 60 s, up to the bounce cap); the LSMemory write gates moved AFTER each writer's own read (_lastReadOk is refreshed by that read, and a stale true from the other settings file must not wave a failed read through); the stuck-neutral report is TIME-based (the recovery class fails a window on its first out-of-band sample, so the window-count report fired ~10x faster than its own comment claimed — both classes now report on the real minute); healHardThresholds gates each side on the read that produced its regular value (a failed settings read's fabricated 3.0 hPa default could persist a bogus hard-threshold raise once the settings2 read succeeded); the screen freeze probes _transitionTimerId through isEnabled (a stale id can never freeze input forever); comment truth: the pt=1 trail table names the new "memory up" meaning, the removed .noinit/CONF_USB_RESTART_MAGIC block no longer reads as live, the RESTART Back fallback comment matches its code, the HID-watchdog cycle-count comment is exact (disconnect() returns true for an already-gone handle, so a raced teardown may consume a cycle — negligible; what the guard prevents is a REFUSED call burning the budget)
- ROUND 3 (the delta verification over the round-2 fixes): the deferred advertising restart — a window ending can land in the sub-second gap where the directed set has self-terminated but the SD's ADV_SET_TERMINATED event has not been dispatched (the lib's _runnning flag still reads true, stop() is refused, and the event afterward clears the flag WITHOUT restarting): the one-shot ensureAdvertising probe in that gap read "running" and skipped the start (silent radio-off). Every window ending while no host is connected now arms a pending flag serviced per loop pass (lsHostServiceSwitchWindow) once the event has actually landed — the forget-path cancel and the close path both covered, cleared by a new window or a host connect; healHardThresholds gates BOTH sides of each comparison (a failed settings2 read's fabricated 10.0 hPa hard default could fire the setter's FAIL,3 on every hard-page entry; a failed settings read's fabricated 3.0 regular default could persist a bogus raise); doc comments corrected (the pressure report's MS base, the writeObject belt-and-braces branch, the ensureAdvertising false-with-window-open contract, the bound helper's millis-0 sentinel note)
- IN-FLIGHT WORK DOCUMENTED (the pre-4.9.0 working-tree deltas that shipped without their own entries): the LSInput staged stroke-ending confirmation (a stroke-ending change on a held input is not classified as RELEASED until one extra poll confirms it — a one-poll jack dropout on a held external switch used to fire the short-window action early, re-arm a spurious hold, and consume the long-window action the user earned; the timer is not restarted, so a closed dropout continues the hold with its original stopwatch); the hardware WDT arm moved BEFORE initMemory (the LittleFS mount + settings seed + verdict write — the historically demonstrated hang phase the 4.5.22 RECOVER build existed for — is now watchdog-covered); the gamepad+Bluetooth boot heal reports on the wire post-attach (its println ran inside TinyUSB's pre-open-port discard window, so no host ever saw it); in-settings-mode garbage answers FAIL,1 (unknown command) instead of FAIL,0 (the response class no longer depends on message length)
- VERIFICATION: host core suite 182/182 under ASan/UBSan (9 new checks: the RPA byte test + ah() hash-order vector + 7 identity checks), timer suite 168/168 (3 new: the nested-run disposition guard), production compile clean at --warnings all (46% flash / 24% RAM); app 502/502 + a new dwell-page rendering test (hub-remote 23/23) + lint/typecheck/format/html/css clean; protocol cross-check all 9 sections against 4.9.0

Version 4.8.18 | 2026-11-07
- HID-SUBSCRIPTION WATCHDOG (the bench's "connected but deaf" class made self-correcting): three times tonight a host ended up connected-but-no-cursor after heavy churn (live view healthy, reports refused) and every fix was host-side (Bluetooth toggle, reboot, remove+re-add). Root signature, from the S140 hvx contract: NRF_ERROR_INVALID_STATE = "notifications not enabled in the CCCD" — the device keeps a link the host never re-subscribed. The watchdog (btFeedbackLoop, 1 s): a BONDED peer whose mouse-input CCCD is not enabled for 5 s (grace covers pairing/encryption/CCCD restore) gets its link DISCONNECTED once — the host's own retry re-establishes and re-subscribes cleanly (the fix that worked all night, driven by us). Bounded: 3 cycles per session (the counter resets only when a subscription is actually observed; a persistent non-subscriber is left to the host with one named INFO line). Guards: bonded peers only (a conventionally-unbonded BLE-DFU session is never cycled), suppressed while a switch window is open, and the mouse report index is read through a bounded vendored accessor (BLEHidGeneric::inputNotifyEnabled — the inputReport() bool conflates CCCD-off with transient TX-buffer exhaustion, so the watchdog reads the unambiguous bit)

Version 4.8.17 | 2026-11-07
- SWITCH WINDOW, DEVICE-SIDE TRIAL: DIRECTED AGAIN — PROPERLY THIS TIME (the user's rule: exhaust the device end before touching Windows-side settings, so attribution stays clean): the directed mechanism never had a fair trial against a healthy Windows (every earlier run caught it asleep or stale). The window now advertises DIRECTED high-duty at the target identity (the spec's fast-reconnect mechanism) with the 4.8.12 bouncer as the keeper and the 60 s bound; the vendored startDirected path (with the _peer_adv_active termination guard) is reinstated, the tick re-arms per second with CONN_COUNT tolerance. The proven 4.8.14-16 open+bouncer mechanism is one flag away (its code shape is retained in begin/tick comments) if directed fails the trial. Bench target: does Windows' association stack respond to directed-to-itself where open advertising only worked while freshly paired?

Version 4.8.16 | 2026-11-07
- SWITCH WINDOW: ONE CONNECTION = ONE BOUNCE (bench 4.8.15 — the storm, named by the wire): the bouncer counted and "dropped" the SAME Mac connection 600 times in ~200 ms (the SD takes that long to tear a link down; the tick runs at milliseconds and spun against the dying handle), tripped its own storm cap, and closed the window one second in. A bounce is now counted/logged/dispatched ONCE per connection: while the same handle is still present it is that connection tearing down (skip quietly); the tracking clears when the link goes empty, so a reconnecting peer counts anew even if the SoftDevice reuses the handle number. Reset with the per-window state. Real reconnect cycles (the Mac retrying at its own cadence) each consume exactly one bounce; the cap now bounds REAL cycles only

Version 4.8.15 | 2026-11-07
- SWITCH WINDOW: THE BOUNCER SURVIVES ITS OWN TEARDOWN RACES (bench 4.8.14, first second on the wire): the open-advertising window + bouncer WORKED — the Mac connected and was dropped twice within 100 ms — but on the third pass its disconnect call raced the peer's own mid-teardown retry, returned false, and the old shape fell through to the window-closed "MISMATCH" report. A refused disconnect does NOT mean a non-target holds the link; the tick now ignores that rc and simply keeps waiting (the next pass re-checks the world: gone -> continue, still there -> bounce again). Only the storm cap closes a window with a persistent non-target — raised 80 -> 600 (a full 60 s window of macOS-cadence bouncing) — and the bounce log thins to every 20th to keep the wire readable

Version 4.8.14 | 2026-11-07
- SWITCH WINDOW, FINAL MECHANISM: OPEN ADVERTISING + THE BOUNCER (from the timestamped bench trace that ended the guessing): with a directed window aimed at Windows, the whole 10 s window passed with NEITHER host acting, and the Mac entered ~1 s after the window ended — directed advertising suppresses the Mac's reconnect entirely but ALSO does not attract Windows (its reconnect engine ignores directed packets), while every successful reconnection either host has ever made in this bench rode PLAIN OPEN advertising (B6's freed windows included). The window is now exactly that: the stock start(0) open advertise — the signal both hosts already respond to — kept open for a long 60 s bound, with the 4.8.12 BOUNCER doing the lockout (any non-target connect is dropped within milliseconds and the window keeps waiting; the Mac cycles harmlessly at its own cadence). The whitelist/directed machinery is gone and the vendored BLEAdvertising patch (startDirected + _peer_adv_active) is REVERTED TO STOCK — no vendored-lib delta remains. The CONN_COUNT teardown retry stays (live-link teardown class); every window close still names itself on the wire; the bound guarantees a target-less window can never strand the radio (60 s worst case, then stock)
- the bench trail this replaces, for the record: whitelist+discoverable = 0x3201 BLE_ERROR_GAP_DISCOVERABLE_WITH_WHITELIST (S140 forbids it; no legacy connectable-non-scannable type exists) → directed target = accepted-anyone (S140 does not enforce the directed field on connects) → directed+whitelist = still accepted (not enforced on directed sets) → CONN_COUNT at start = the lib's connected() reading 0 before the SD frees the role → CONN_COUNT at re-arm = the same at millisecond scale → and finally the timeline showing the lockout never needed the controller at all

Version 4.8.13 | 2026-11-07
- SWITCH WINDOW: CONN_COUNT-TOLERANT RE-ARM + NO SILENT CLOSES (bench 4.8.12's silent loss): the Mac won with NO bounce line — meaning the window had already closed when its connect landed. The trace: at the ~1 s arm self-termination the Mac's connect attempt reserved the peripheral role mid-establishment, the service's directed re-arm hit NRF_ERROR_CONN_COUNT, and the tick's old shape closed the window silently on ANY re-arm failure — handing the open-advertising field to the same host the window was holding off. The tick now treats CONN_COUNT on re-arm as "a connection is arriving this millisecond": skips that arm and retries next service pass (milliseconds later), where the connected branch bounces or admits it. Every non-CONN_COUNT close now NAMES its rc on the wire (the repeated no-silent-paths lesson)

Version 4.8.12 | 2026-11-07
- SWITCH WINDOW: THE BOUNCER (the endgame mechanism): bench 4.8.11 proved S140 does NOT enforce the directed target field NOR the whitelist filter on a directed set — macOS's connect-by-address retry walked into the window even with the whitelist armed and FILTER_CONNREQ configured (the lockout cannot come from the controller for this advertising class). The lockout now comes from the firmware: lsHostSwitchWindowTick drops any NON-TARGET connection immediately (before HID/bond traffic — the security setup takes far longer than this path's milliseconds) and KEEPS the window waiting for the target, so the just-disconnected host's reconnect engine cycles harmlessly (connect -> dropped -> retry at its own backoff cadence) while the target's connect is the one that holds. Bounce count bounded (80; past the bound the window closes with the named mismatch report — never a spin); first three bounces and every tenth are named on the wire. Window bound raised 6 -> 10 s (multiple target retry cycles), bounce counter reset per window. Same disconnect primitive the whole switch has always used — no SD filtering dependence left

Version 4.8.11 | 2026-11-07
- SWITCH WINDOW: LONGER CONN_COUNT RETRY + FAILURE FORENSICS (bench 4.8.10): the 200 ms CONN_COUNT budget was not enough for a live iPhone link's peripheral-role teardown (adv_start refused for the whole budget, fallback ran, the racer won via open advertising). The retry now runs to ~1.2 s (60 x 20 ms — the serial ack rides the bounded wait; the menu dwell hides it), and the begin-failure INFO line gains conn=<count> waited=<ms> at give-up, so a repeat failure names the connection state instead of spending another flash cycle inferring it

Version 4.8.10 | 2026-11-07
- SWITCH WINDOW: CONN_COUNT RETRY (the teardown race, named by 4.8.9's step tag): with the directed+whitelist parameters finally accepted, the failure moved to adv_start with 0x30012 = step 3 | NRF_ERROR_CONN_COUNT — the lib's connected() reads 0 before the SoftDevice has freed the peripheral role, so the window's start raced the old connection's teardown ("connectable advertiser cannot be started"). lsHostBeginSwitchWindow now retries CONN_COUNT specifically (bounded, 20 x 10 ms — that error heals in milliseconds on its own) and breaks out immediately on any other refusal. Also recorded: the Mac's identity is a PUBLIC address (74:35:42:DC:57:1C/0) — the type/bytes coercion correctly left it public (top bits 01, not the static-random 11)

Version 4.8.9 | 2026-11-07
- SWITCH WINDOW: DIRECTED + WHITELIST (both halves, finally): the first working directed window (4.8.8) was entered by the MAC — S140 accepts a connect-by-address from a non-addressed peer even on a directed set (macOS retries its way in after a disconnect; the directed target field does not filter connects). The connect REQUEST itself must be filtered: the window now arms the whitelist again (target identity, coerced) and passes BLE_GAP_ADV_FP_FILTER_CONNREQ to the directed set — legal because DIRECTED advertising is not discoverable, so the 0x3201 BLE_ERROR_GAP_DISCOVERABLE_WITH_WHITELIST restriction (which only ever covered the scannable stock type — the original root cause, correctly decoded late) does not apply. The identity list stays OUT (a p_peer_addr present in it makes the SD substitute an RPA as the directed target — breaking the raw-identity match hosts reconnect on). Together: the packet names the target AND the controller drops every non-whitelisted connect — the Mac is locked out at the radio, not merely un-addressed

Version 4.8.8 | 2026-11-07
- SWITCH WINDOW: DIRECTED ADVERTISING (the B4 bench loop's endgame — the whitelist mechanism is not implementable on S140 6.1.1): 0x3201 decoded to BLE_ERROR_GAP_DISCOVERABLE_WITH_WHITELIST ("Use of Whitelist not permitted with discoverable advertising" — the earlier read as INVALID_BLE_ADDR was off by one; that code is 0x3202). S140 forbids whitelist filtering with connectable-SCANNABLE ("discoverable") advertising, and legacy PDUs have NO connectable-non-scannable-undirected type — so the design doc's whitelist contingency cannot be built as specced on this stack. The window now uses DIRECTED high-duty advertising at the target's (coerced) identity address: the address rides IN the packet, only the addressed host responds, the just-disconnected racer (macOS sub-second reconnect) ignores a packet addressed elsewhere, no whitelist or identity list is involved (S140's whitelist/discoverable restriction and the identity-list RPA-substitution problem both drop out), and it is legacy-controller friendly (Apple's reconnect guidance). Vendored lib: BLEAdvertising::startDirected(peer, timeout) replaces startPeer (step-tagged rc kept; a new _peer_adv_active flag makes the directed set's termination bypass the stock open-advertising restart — the window owns the radio until close). The set self-terminates about every second by spec, so the window re-arms it: a new lsHostServiceSwitchWindow runs from the main loop (millisecond granularity) with the btFeedbackLoop tick as the 1 s backstop; between arms NOTHING is on air (the lockout guarantee is the directed addressing, and a failed re-arm closes the window with the open-advertising fallback). The ~2 s dwell + 6 s bound and every 4.8.7 hardening (suspend/restore auto-restart, cancel, target-identity confirmation, named fallbacks) are unchanged

Version 4.8.7 | 2026-11-07
- SWITCH WINDOW: THE BOND TYPE/BYTES CONTRADICTION (the B4 bench loop, rc named by 4.8.6's step tag): the window's adv_set_configure refused with 0x3201 = BLE_ERROR_GAP_INVALID_BLE_ADDR ("the upper two bits of the address do not correspond to the specified address type") — the Mac's bond stores its identity as PUBLIC while the bytes carry the 11 static-random marker, and the SD validates the whitelist entry (and identity-list entry) against that rule at adv configure. lsHostCoerceAddrType now reconciles type vs bytes ONCE (11-marker-high clear, 11-marker-low static-random, RPA/RRA types coerced by the same byte convention), and the coerced address is used in BOTH the identity list and the whitelist (the SD resolves one against the other); the wire INFO lines now print the armed entry itself ("wl=AA:BB:CC:DD:EE:FF/N") so the next refusal has nothing left to infer
- SWITCH WINDOW HARDENING (the same review loop): the arm's stop-rc is now enforced (the old comment claimed fail-closed without checking — a failed stop left a live set the arm could not reconfigure; refuse instead); a REFUSED identity list for an IRK-carrying target is fatal (with BLE_GAP_ADV_FP_FILTER_CONNREQ an RPA initiator is admitted only through the identity list — the window would lock out everyone including the target for its whole 6 s; disarm + fall back, and irk=0 now means exactly "the bond carries no IRK"); every arm refusal path disarms; lsHostCancelSwitchWindow + the auto-restart suspend/restore bracket the lifecycle (a second switch over an open window used to leave a stale flag whose backstop could stop/restart live advertising and report a phantom "target won"; the stock DISCONNECTED auto-restart's FP_ANY gap — the sub-second open window the old host won — is suspended from disconnect to the filtered advertise, so NOTHING is on air until the window is); lsHostSwitchWindowTick closes the window only when the ARMED TARGET's identity connects (a non-target is named on the wire, never reported as a successful switch); the outcome struct replaced the out-params (menu path emits no phantom BT,1 INFO lines; serial INFO lines follow the command's own ack frame)

Version 4.8.6 | 2026-11-07
- SWITCH WINDOW: IDENTITY LIST BEFORE WHITELIST (the B4 bench loop, rc finally named): the window's begin still failed with 0x3201 = BLE_ERROR_GAP_INVALID_BLE_ADDR ("the upper two bits of the address do not correspond to the specified address type") — armed whitelist OK, then the device-identity set INVALIDATED the just-set whitelist (S140 6.x re-validates the whitelist at adv configure/start; the identity-list-first shape is the SD's implied order). Arm now installs the identity list FIRST (its rc no longer silently ignored — it reports in the INFO line's irk= flag), the whitelist SECOND (the last thing armed before the window opens), and startPeer tags its failing step into the returned rc (0x01=configure, 0x02=tx_power, 0x03=adv_start | SD code) so any remaining refusal names both the step and the code on the wire

Version 4.8.5 | 2026-11-07
- SWITCH WINDOW: WAIT OUT THE DISCONNECT TEARDOWN (the B4 bench loop, from the 4.8.4 INFO lines): the window's begin failed on BOTH attempts (arm succeeded; the INFO line named "begin failed") — the SD was still tearing down the just-disconnected connection, so sd_ble_gap_adv_start refused (the role is occupied until the DISCONNECTED event lands). lsHostBeginSwitchWindow now waits, bounded (≤200 ms), for Bluefruit.connected() to reach 0 before starting the window; startPeer returns the exact SD rc (uint32_t, not bool — a bool could not name NRF_ERROR_INVALID_STATE vs a whitelist problem) and the executor's INFO line carries it ("window FALLBACK (begin rc=0xN)") so the next failure names itself

Version 4.8.4 | 2026-11-07
- SWITCH-WINDOW OBSERVABILITY + THE DISCONNECT-HANDLER RACE (the B4 bench loop): the first windowed switch (B4 prep, Windows->Mac) was intercepted by the IPHONE — the wire could not say whether the window armed/opened or silently fell back, which made window-opened vs fallback indistinguishable exactly when it mattered. The switch path now NAMES its outcome on the wire (INFO lines on the BT,1 command's own response stream — the healthy-boot silence contract is untouched): "window opened (target row N addrType=T irk=0/1)" or "window FALLBACK to open advertising (arm|begin failed)". The begin path also closes a real race: the stock restartOnDisconnect handler runs on the BLE event thread and can fire BETWEEN startPeer's configure and its adv_start (its !_runnning check is still false mid-startPeer) — its FP_ANY start then owns the set and the window's adv_start refuses; begin now retries once (stop + reconfigure + start), which deterministically re-applies the window over whatever the handler opened

Version 4.8.3 | 2026-11-07
- THE BENCH-DRIVEN FIX SET (from the physical #16 multi-host bench on real Mac/Windows hosts; production compile clean, host suites 173/173 core + 165/165 timer under ASan/UBSan, app protocol cross-check all 9 sections)
- THE WHITELIST SWITCH WINDOW (major, the B4 contingency — design doc Q4): bench B4 measured the wrong-host race 0/5 for away-from-Mac switches — macOS reclaims the link sub-second after its disconnect, before the target host can take the open advertisement. The switch path now opens a bounded (6 s) SoftDevice whitelist window for the TARGET host only: lsHostArmSwitchWindow installs the target's identity address (+ IRK, read through the lib's public bond_load_keys — never hand-parsed bond-file offsets) via sd_ble_gap_whitelist_set / sd_ble_gap_device_identities_set BEFORE the disconnect (the whitelist is not "in use" while no adv/scan role runs), and lsHostBeginSwitchWindow reconfigures the advertising set with BLE_GAP_ADV_FP_FILTER_CONNREQ + a SoftDevice duration AFTER it — the just-disconnected host cannot connect while the window is open, so the target wins structurally. The window closes via lsHostSwitchWindowTick (polled from btFeedbackLoop's 1 s pass): on connect (the SoftDevice clears the whitelist itself) or on the millis backstop; closing disarms both SD lists (stock empty state) and resumes open advertising only when no host is connected. Every SD refusal degrades to the pre-contingency open-advertising behavior — never a wedge. VENDORED-LIB PATCH (house precedent, the bounded Wire/LPS2X/LPS35HW forks): BLEAdvertising::startPeer(timeout, filter_policy) — a _start clone whose only difference is the caller-chosen connect filter policy (p_peer_addr stays NULL: a directed ADV packet cannot carry the HID payload the hosts match on); the lib gains no bond-file knowledge (whitelist ownership stays in LSBLE.h). Both switch callers (the Hub confirm page and the serial BT,1) open the window; the non-blocking rule holds (no poll-wait on the loop task — the first draft's delay() loop was removed)
- HOLD-GATE NOTE (LSScreen, the B5 bench finding): a too-short hold on a destructive row (forget/factory-reset/restart) answered a bare error beep with NO screen change — the user read it as a dead button and kept pressing until the forget eventually fired. New HOLD_CONFIRM_NOTE_PAGE 34 ("Too short: HOLD the row to confirm", 2 s, the modeLockedPage pattern generalized): the page remembers its source (the gate spans five pages) and finishHoldConfirmNote redraws it via the saved menu id; input stays frozen for the dwell (the scheduled transition)
- ALREADY-ACTIVE REFUSAL NAMED (LSScreen, the B5 bench finding): the Hub switch confirm treated LSHOST_REFUSE_ALREADY_ACTIVE as success and silently returned to the list, while the serial path answers FAIL,3 + the named line. The silent-swallow rationale ("the target already reconnected meanwhile") cannot occur — the old host is still connected during the dwell, so the device is not advertising and the target cannot have taken the link. The menu now lands on the "Already on this host" note like every other refusal

Version 4.8.2 | 2026-11-06
- THE 4.8.2 REVIEW-ROUND FIX SET (a review/fix loop over the 4.8.1 tree and the paired LipSync_Connect tree; firmware source changes are comment/dead-code only — no behavioral delta — and all suites pass unchanged: host 165/165 timer + 173/173 core under ASan/UBSan, production compile clean at --warnings all, app 502/502 + lint/typecheck clean, protocol cross-check all 9 sections)
- DEAD CONFIG KNOB REMOVED (LSConfig.h): CONF_BLE_INIT_USB_ATTACH_FALLBACK_MS belonged to the 4.5.11 deferred-USB-attach block that 4.5.18 retired (the attach is back at its stock point in beginComOpMode) and nothing has read it since — a dead knob whose comment block still described a live fallback. The serial-recovery property it described is carried by the stock attach order (CDC comes up before the BLE init task runs) and the failed-init fallback in the boot path, not by a timed wait. CONF_UPDATE_MODE_DWELL_MS gains the comment that names its two dwell obligations (ack reach + OLED framebuffer push) so a future shrink knows both constraints
- UPSTREAM POSTURE COMPLETED (the tracker audit this round): the 4.8.1 line named 24 of the 45 open issues; every open issue now has a recorded disposition. Newly dispositioned: #74 "changing mode by itself" — MITIGATED by shipped fixes (the 4.5.7 input-latch fix removed the sub-reaction glitch class that could merge phantom presses into menu combos; LK mode lockout (#68) gives caregivers a hard gate; the 4.8.1 read-truth gates stop a failed settings read from overwriting the stored mode at boot), root cause on the reporting 4.1.0 units unverifiable without a capture — needs a repro to CLOSE; #75 "watchdog activates after factory reset" — ADDRESSED STRUCTURALLY (the bounded Wire ends the I2C-wedge-into-WDT class, factory reset writes ONE complete defaults document instead of ~22 sequential writes, and the loop feeds the WDT directly every pass), bench repro on 4.1.0 hardware optional; #37 — ADDRESSED (the XENSIV TLx493D migration, 4.5.x); #67 — ADDRESSED in the app (settings export + share-log); #87/#76 mouthpiece-replacement design and #81/#79/#72/#71/#65/#64/#56/#78/#73/#82/#33 documentation/tooling items stay upstream-side (the fork's own docs already carry the 4.4+ guidance), #84/#70/#69/#59/#19/#15/#26/#24 hardware-only, #80 repo hygiene unchanged
- RELEASE-PIPELINE STATE NAMED (the audit's action item): the firmware-binaries branch — the app's update source of truth — holds 4.6.6 because no tag exists after V4.6.6; 4.7.0/#58, 4.8.0/#16 and this round are invisible to the updater until V4.8.x is tagged (the workflow publishes on tag push only, by design — bench-first, tag-last). Publishing is a bench-gated user action, not a code fix
- APP-SIDE FIXES (LipSync_Connect): lint/typecheck were failing repo-wide — the fixed-arity spreads of the *_MIN_FIRMWARE gates now carry tuple types, bt-hosts.js's DUPLICATE local BT_HOSTS_MIN_FIRMWARE definition is gone (constants.js is the single source; the mirror and the protocol cross-check read that copy — the two gates could have drifted silently), main.js drops the two unused imports (they are dynamically imported where used), the poller's unref guard is type-clean, the hub-remote item type models the displayOnly/select split instead of requiring `select` everywhere, and the mirror's transient-page map gains the three self-advancing pages it predated (11 Exiting → menu closes, 33 Changing mode → reset, 572 factory-reset warn → frConfirm2) so a CH,0:0 sync landing mid-dwell auto-polls to the next page instead of parking on the "unmapped page" note

Version 4.8.1 | 2026-11-05
- THE REVIEW-ROUND FIX SET (a full review/fix pass over the 4.8.0 tree — the new multi-host surface, the 4.7.0 hard-band evaluator, and the module groups the last release touched; production compile clean at --warnings all, host suites 165/165 timer + 173/173 core under ASan/UBSan with 32 new checks)
- CURSOR RACE ON A DEGENERATE RADIUS (major, LSJoystick): mapFloatInt's zero/non-finite-range guard returned outputStart — for the only call shape (the symmetric cursor map) that is FULL THROW (-XY_MAX). Every radius-degeneration path (an uncalibrated boot whose center flow failed or was refused, a collapsed initial radius, an inf center) mapped every reading — including dead center — to a bottom-left corner race at ~200 px/s per 20 ms tick with no recovery until a successful CA reload. The guard now returns the range MIDPOINT (neutral for the symmetric map), and mapRoundInt's outputStart fallback is comment-pinned as neutral-by-caller so the two cannot be "unified" wrongly
- RADIUS VALIDITY FLOORS (same root cause, upstream defenses): setMinimumRadius's INITIAL center-to-{30,30} term is now held to the same JOY_MIN_CALIB_RADIUS floor as its per-corner loop (a center genuinely near {30,30} collapsed the radius to ~0.07 and silently stood whenever no corner beat it); LSMemory::readPoint refuses non-finite corners (isfinite, not isnan — a corrupt-but-parseable 1e400 literal yielded ±inf, which passed the old check and produced an infinite radius through setMinimumRadius); the CA,0 plausibility gate isPlausibleStoredCorner now requires BOTH axes at or beyond CONF_JOY_CALIB_CORNER_MIN — the same convention the capture path enforces (the old one-axis-or shape accepted corners capture itself would have replaced with the ±13 default)
- BOOT BASELINE CANNOT ABSORB A HELD GESTURE (major, LSPressure): the no-baseline (boot/recovery) offset collection had NO magnitude bound — any STEADY reading became "neutral" (a held sip/puff across a watchdog-reset boot is realistic for this user population), the baseline absorbed it, and every later release read as an inverted sub-threshold-or-worse hold (the phantom click class). LSPressureOffsetFilter gains an initial magnitude limit (PRESS_OFFSET_INITIAL_MAX_HPA, 3.0 hPa — at/under the compiled regular threshold so an absorbed sub-limit hold can never fire an action, above the sensor pair's plausible inter-sensor bias so no working unit is stranded; deliberately NOT tied to the live user thresholds so a lowered threshold cannot brick sensing). A rejected hold keeps the collector retrying — the user only has to stop pressing for one bounded window; a stuck neutral now names itself on the wire (one ERROR line per minute of continuous failure, the 4.6.6 destroy-in-silence lesson). 8 new host checks pin the bound, the release-recovery, the established-baseline exemption, and the disable-by-0 legacy shape
- MID-HOLD THRESHOLD CHANGE CANNOT FIRE A PHANTOM RELEASE (major, LSPressure): continuation and the release boundary now run on thresholds SNAPPED at hold START (_active*Threshold members) instead of the live values — a live ST/PT write mid-hold (the app pushes settings on every connect; a caregiver opening Connect while the user holds a puff is a realistic moment) used to re-test the in-flight hold against the NEW threshold and emit an action-bearing RELEASED the user did not perform, or extend a hold below its old engage level. The classifier's own "class held for life" contract now covers the regular bands; fresh entries always classify against the live values. The pure classifier is unchanged; the host tests still pin it
- BT HOST TABLE COUNT CONSISTENCY (major edge, upstream #16 surface): lsHostEnumerate returned the RAW bond-directory total while filling at most 8 rows — with more than 8 bonds, BT,0:0/BT,4 advertised rows the BT,0 getter refuses, and lsHostExecuteForget/btSwitchConfirmPage indexed rows[] past what was filled (uninitialized stack read answering SUCCESS for a row that does not exist). The enumerator now returns the exposed (capped) count — every consumer keys row indices off exactly the rows that exist
- BT APP-SYNC GAP (4.8.0 regression, upstream #16 surface): the BT,4/BT,5 pushes fired only on connect/disconnect transitions, but a first pairing writes its bond file in the lib's deferred callback SECONDS after CONNECTED, and a reconnect's bonding completes at CONN_SEC_UPDATE — both landed after the transition push, so the app's host list/active marker stayed stale until the NEXT transition. btFeedbackLoop now runs the change-detected lsHostPushState() every 1 s pass: the first post-boot pass primes SILENTLY (the CH,5 boot-state doctrine — a healthy boot still prints nothing, the app's connect load reads BT,0 for current truth), every change after it pushes within one poll, and the forget paths force a push so a BT,2 landing before the first pass still delivers its contractual BT,4
- SERIAL SETTINGS WRITES ARE READ-BACK VERIFIED (LSMemory): the atomic replace verified byte COUNT only — Adafruit_LittleFS's File::close() returns void and swallows lfs_file_close errors, so a close-time truncation could rename a truncated temp over the settings file while writeAll/writeObject reported success. Both writers now read the temp back and byte-compare before the rename (no second JSON parse — the byte compare catches the realistic class without spending a second document pool on the loop stack); a mismatch removes the temp and reports failure with the old file intact
- HARD-BAND HEALING ON THE SERIAL PATH: an app-side ST/PT raise that stranded the hard pair (hard < regular + margin → the band silently goes inert) was healed only at boot and in the menu pages — the API setters, which the app exercises on every connect, now run the same healHardThresholds() rule (emitting the usual MANUAL lines so Connect re-syncs)
- CALIBRATION STALE-CALLBACK RUN GATE: performJoystickCalibrationStep (the corner-reading callback) lacked the g_calibrationRunning gate its chain driver has — a stale callback after an abort would have persisted a corner and acked a dead flow (latent, one refactored abort path away)
- USB MOUSE LATCH ACROSS A FAST BUS BOUNCE: a drag/scroll hold surviving an unmount→remount that completed between usbCheckConnection's 1 s checks left outputAction == DRAG latched with the wire button already cleared (cursor moves, no button, until the user happened to release). The mouse's unmount cleanup raises a take-and-clear flag and the loop ends the latch with it — the exact mirror of btFeedbackLoop's "never carry a drag/scroll latch across hosts"; no action-bearing event
- THE SHARED-SETTINGS-FILE-HANDLE RULE HOLDS EVERYWHERE: bleVerdictConsume used LSMemory's global File handle (safe today, loop-sequential — but a second module mutating the shared handle is the exact 4.5.21 race shape); it now opens its own handle like its sibling persist function
- MODULE HARDENING (minors): LSTimer::anchorAllToNow now anchors only ENABLED callback slots and never stopwatch slots (re-anchoring a stopwatch resets any elapsed measurement in flight — a hold-duration stopwatch would have re-classified its release window; the docstring now matches); LSBuzzer's late-tone reschedule covers ALL later entries, not just silences (tone-then-tone pairs under catch-up no longer truncate — the ready cue's second note), and a duration-0 tone entry degrades to silence instead of tone()'s indefinite-hold semantics; LSUSBGamepad::isConnected mirrors the mouse's suspended-bus check; the gamepad axis helpers take signed clamped ints instead of depending on uint8_t modular wrap to sign-correct; LSCircularBuffer's index math is int32 (structural bound instead of a >32K-element hazard); the dead LSMemory::readAll twin is removed; setPressureMode whitelists PRESS_MODE_DIFF (NONE was as silent as ABS — the landmine class); the dead ABS branches in updatePressure are removed; the "sensors not responding" ERROR line is rate-limited to one per 5 s (a flapping cable re-entered the state every re-probe cycle); the classifier's release fraction is a constexpr pinned by static_assert to CONF_PRESS_RELEASE_FRACTION; the over-budget destroy diagnostic names each file's own budget and the budget-refusal rationale is per-file (settings2's 256-byte cap is not the 4.1.0 downgrade cliff); stale/contradictory comments corrected across LSJoystick/LSInput/LSWatchdog/LSPressure/LSScreen (the dead RELEASED→STARTED re-arm arm is now documented as the ENGAGE_SAMPLES==1 defensive shape it is)
- ROUND 2 (the second review pass over the three large tabs + the round-1 diff): DESTRUCTIVE FORGET IDENTITY (LSScreen/LSAPI): MAC-sorted rows RENUMBER in-range when the bond set changes, so "a stale index can only refuse" was false — a serial BT,2 (it has no frozen gate) landing while the on-device forget list was open made the hold-to-confirm erase the WRONG host's bond. The forget list and the switch confirm now capture each row's identity at render (String macs), and lsHostExecuteSwitch/Forget verify it at execution against a fresh enumeration (new pure lsHostRowIdentityMatches + 8 host checks; serial path keeps the documented index contract with an explicit NULL; a switch target out of range at confirm-render now forces a range refusal instead of switching a re-grown index it never named). BT,1 also now disconnects a connected-but-not-yet-bonded peer (the old activeRow==0 skip acked SUCCESS while the old host held the link), and BT,3 gained the calibration gate its siblings have
- BT,2 HONEST ACKS: the lib's bond_remove_key returns void and discards InternalFS.remove's result, so the old wrapper could never fail — a failed removal acked SUCCESS for a host that was still bonded. lsHostForgetByMac now removes explicitly and verifies absence (absent-after = removed), refusing FAIL,3 + the named line otherwise; LSHOST_REFUSE_RADIO gained its missing refusal-line case (was printing "unknown reason")
- READ-TRUTH GUARDS (LSAPI): every getter heal-write (OM/CM/SS/SL/AV/SM/LM/LL/DM/SD/MA/LK/CF/ST/PT/HS/HP/HA/HB/WS/WL/WM) is now gated on mem.isLastReadOk() — the getModelNumber pattern. A TRANSIENT failed read yields 0, and the old shape could rewrite the user's stored value with the compiled default on the very next write (read fails, write's read succeeds) — a one-key data loss with a SUCCESS response. HA/HB's heal bound is now the action vocabulary (0..24), not an arbitrary 127; a getter can no longer answer a value the live table never uses
- HA/HB APPLY LIVE: the setter acked SUCCESS but only re-armed at the next boot — the 4.7.0 contract says "the first SET re-arms" a table a keyless settings2 left inert, and every sibling setter applies immediately. The setter now calls applyHardBandActionOverrides (declared in LSApiDeclarations.h) on success
- EX,0 REPLAYS BT,0:0: the support dump gains the exposed bond count (rows read individually with BT,0:<i>), and the frame comment no longer claims the getters are pure reads (they are the app's connect-load convention, heals included). BT,0 also answers FAIL,3 for negative/out-of-contract parameters instead of silently treating them as the count read
- CALIBRATION vs DEBUG/Safe mode (LipSync_Firmware.ino): the calibration's step-6/abort poll restore re-enabled the joystick poll even under DM=1 (the 4.6.6 debug contract — the swap itself is gated, the restore was not), and setDebugState's DEBUG poll enable ignored safe mode (a serial DM write could re-arm a 100 ms poll against hardware a safe boot deliberately stopped touching). Both restores now carry the same gates the disable paths have
- LK RE-CHECK AT THE MODE EXECUTOR (LSScreen): the 4.6.6 confirm-page gate left a 2 s hole — a caregiver enabling LK over serial DURING the "Changing mode." dwell still persisted + reset the locked change. finishChangeMode now re-checks g_modeLocked at the action (the finishBtSwitch pattern). healHardThresholds skips flushes when the floor is unstorable (>= CONF_PRESS_MAX_THRESHOLD — the band is structurally inert; the old shape printed a FAIL,3 per ST/PT success forever). BT dwell pages zero _currentSelection (the CH,0:0/CH,5 row was inheriting the interrupted page's selection). The long-text scroll delay's shared-transition-slot coupling is comment-pinned at scheduleTransition
- DEAD CODE + CONTRACTS: ledIBMEffect (a wrong-re-enable hazard re-arming from the shared ledCurrentState), enablePoll (its only caller was that dead effect), ledStartupEffect (fully commented out), ledReadyFeedback, gamepadButtonClick, handleHardwareErrors (empty), printResponseIntPoint(+Array), LSMemory::readAll already gone — all removed with rationale comments; LSBuzzer reschedules EVERY later entry past a late tone's finish (tone-then-tone pairs no longer truncate — the exact class the silence-only fix left); LSUSBGamepad::isConnected mirrors the mouse's suspended-bus check; gamepad axes take clamped signed ints; anchorAllToNow anchors only enabled callback slots and never stopwatches (a stopwatch re-anchor would reset a hold-duration measurement mid-flight); CROSS-TASK FS TRUTH recorded: the core's Adafruit_LittleFS takes a per-operation FreeRTOS mutex, so the 1 Hz bond enumeration is operation-safe — the 4.5.20 rule (local handles, never the shared one) is what remains required, and the comment block now says exactly that
- FINAL-VERIFICATION ADDENDA (the adversarial pass over the round-2 diff): the boot baseline's magnitude-bound claim is now exact — with a user threshold lowered below the absorbed magnitude (API floor 2.0), an absorbed sub-3.0 hold can still shift neutral past the lowered threshold; that residual is bounded, observable in PV/the corrected signal, and cleared by a reboot at neutral — but silent on the wire (the once-a-minute ERROR line covers the never-completing baseline only) — and the constant deliberately stays decoupled from live thresholds (tying it to them could strand a high-bias unit in RETRYING_INITIAL forever); the sensor-error rate limiter's FIRST post-boot report is unconditional (the 5 s limiter now only bounds flapping re-entries); the boot-prime for BT pushes (CH,5 doctrine: first pass silent, changes push, forget paths force); initOperatingMode's boot heal and applyHardBandActionOverrides are isLastReadOk-gated (the same transient-read class as the getter fixes — a failed read could have overwritten the stored mode at boot, or applied NOTHING to the live hard row right after a SUCCESS ack); doc nits corrected (identity-check semantics, stale declaration comment, check counts)
- VERIFICATION: host core suite 173/173 under ASan/UBSan (24 offset-filter + 8 identity checks added this round), timer suite 165/165, production compile clean at --warnings all (44% flash / 24% RAM)
- UPSTREAM POSTURE (unchanged by this round): #16/#58/#9/#20/#21/#22/#36/#43/#44/#61/#62/#63/#68/#77/#86/#88 addressed in 4.5.x-4.8.0; #54 parked pending a DM capture; #83/#85/#33/#64/#65/#79/#82 hardware-class/research/documentation items; hardware-only issues (#84 #70 #69 #59 #19 #15 #26 #24) and #80 repo hygiene unchanged

Version 4.8.0 | 2026-11-04
- MULTI-HOST BLUETOOTH SWITCHING (upstream #16, the accepted feature from 4.6.6's posture line — implemented PERIPHERAL-ONLY after the design desk-review corrected 4.6.6's rationale: the "requires BLE central + HID client" note was a category error, Bluefruit.begin() runs 1 peripheral / 0 central and HID reports flow over the bonded peripheral link): the LipSync keeps its bond with EVERY paired computer/phone and switches between them on command. The mechanism is the disconnect-then-reconnect dance, not a radio-role change: switching disconnects the current host, open advertising restarts automatically (restartOnDisconnect(true), unchanged boot posture), and the target host reconnects on its own schedule; NO whitelist and NO directed advertising in v1 (the vendored lib hardcodes the AdvFlag filter to FP_ANY — the IRK-whitelist contingency is designed and documented in docs/design/16-multi-host-ble.md as a bench-triggered fork, same pattern as the bounded Wire/LPS2X/LPS35HW vendoring)
- THE HOST TABLE IS THE BOND DIRECTORY (the storage decision): rows are the Bluefruit52Lib bond files themselves — one LittleFS file per bonded peer under /adafruit/bond_prph/<12-hex-MAC>, each already holding the peer's keyset AND its GAP name cached at pair time. The feature therefore adds ZERO settings keys: nothing to settings.txt, nothing to settings2.dat, the 480-byte and 256-byte budgets are untouched byte-for-byte. Rows are enumerated FRESH on every read (no cached copy can go stale), sorted by MAC for a deterministic order, capped at 8 on the wire (the MAC-lowest 8 when more exist) with the Hub page showing the lowest 4 — the on-device Forget list (up to 8) is the valve, and the app mirrors both caps. Last-used host is deliberately NOT persisted: runtime truth only, so a reboot never silently re-targets a host
- NEW SERIAL ENDPOINTS (4 dispatch entries + 2 push shapes, endpoint codes verified collision-free against the table): BT,0:0 answers the bond count; BT,0:<i> answers row i as "<i>:<name>:<active>" — the name is SANITIZED by the new pure layer (',' ':' '/' and non-printables -> '_') so a host's chosen Bluetooth name can never break the comma/colon-delimited wire grammar; BT,1:<i> switches (refusals FAIL,3 with a NAMED ERROR line — busy-in-calibration, drag/scroll latch held, frozen menu window, out-of-range row, already-active, radio failure — the deliberate-reset OM/CM/MP contract is untouched: a refused or successful switch NEVER resets the device and never touches the modes); BT,2:<i> forgets one bond (destroys the keyset file; forgetting the ACTIVE host disconnects it first — a forgotten host that still holds keys on ITS side re-pairs Just-Works on the next connect, the asymmetry the guides must document); BT,3:1 ensures advertising for pair-new (refused while any host is connected — advertising needs no connection, a new pairing needs advertising). MANUAL,0:BT,4:<count> / MANUAL,0:BT,5:<activeRow> push list/active changes to the app with the CH,5 contract (MANUAL + seq 0 resolves no command waiter), emitted from btFeedbackLoop's connect/disconnect transitions and after every forget
- THE PURE DECISION LAYER (new LSHostSwitch.h, the LSPressureClassify pattern — no Arduino types, host-testable): every switch/forget precondition is a pure function with FIXED refusal precedence (uninitialized > calibration > latch > frozen > range > already-active) so the refusal the user sees is deterministic; fail-safe direction — an unknown flag reads as "refuse" on the switch path, a caller that forgets to set bleInitialized=1 gets a refusal, never a radio call on a dead stack. Every action is re-validated AT EXECUTION TIME against a fresh enumeration (the 4.6.6 LK-confirm TOCTOU lesson): the world can change between a menu page rendering and its confirm select — hosts pair, forgets land, drags start — so a stale row index can only ever refuse, never hit the wrong host. The OLED label appends " (XX)" from the last MAC byte, the discriminator for two identically-named hosts
- HUB MENU PAGES (the on-device half): the More menu gains a "Bluetooth" row (page 62, appended before "... Back" so every pre-4.8.0 row keeps its index — the 4.7.0 hard-page pattern), opening the host list rebuilt from the bond directory on EVERY entry. Rows: hosts (max 4, "(XX)"-suffixed) + "Pair new..." + "Forget host..." + Back. Switching confirms like a mode change ("Switch to <name>?") and executes at the END of a 2 s "Switching to host..." dwell (the CHANGING_MODE_PAGE pattern) so the TOCTOU re-check sees the world as of execution, not of the confirm press; the forget list applies the destructive hold-to-confirm gate (an erase action, the safe-mode/factory-reset class); every refusal is a named note page ("Busy: in calib.", "Release drag or scroll", "Host list changed", "Already on this host", "Radio busy try again") plus the error cue — never a bare beep (the modeLockedPage lesson); dwell pages name themselves to CH,0:0/CH,5 (the 4.5.7 honesty rule). Without a BLE stack (USB-mode boot or init failure) the page is a named note returning to the More menu, never a dead list
- STORAGE/FORGET SEMANTICS MADE EXPLICIT: a FACTORY RESET already erases every bond (resetMemory -> InternalFS.format() wipes /adafruit/bond_prph with everything else) — unchanged and now documented in the design doc and guides' plan; forgetting from the app or Hub removes exactly one bond file (bond_remove_key, filename keyed by the 6 address bytes per the vendored lib's own convention). A connected-but-NOT-yet-bonded peer has no row (no bond file exists until pairing completes) — the app shows the count without it and the connect push names it
- VERIFICATION: host core suite grows to 141 checks under ASan/UBSan (36 new checks pin the pure layer: sanitization incl. exact-cap truncation and NULL/empty, MAC-sort determinism and renumber-after-forget stability, OLED label construction, the full switch-refusal precedence ladder incl. NULL-state fail-safe, and the forget path's asymmetry — active-host legal, latch not a refusal); timer suite unchanged at 165/165. Production compile clean at --warnings all, 44% flash / 24% RAM. The app-side surface: a new Bluetooth card host list on the BT_HOSTS_MIN_FIRMWARE=[4,8,0] gate (load, switch, forget, pair-new, the BT,4/BT,5 pushes, session-scoped reset), the Hub-remote mirror follows page 62/621/622/623 with the More row gated identically, and the app↔firmware protocol cross-check gains check [9] pinning the BT dispatch pairs, the push literals, the "i:name:active" row grammar, the name-sanitizer character set, the page-62 mapping, both 4-row display caps, and the 4.8.0 version gate; app suites pass 8/8 bt-hosts + 22/22 hub-remote + 6/6 firmware-compat. The 12-step bench plan (B2/B3 reconnect per OS, B4 wrong-host race, B6 forget self-heal, B8 overflow, B11 downgrade round-trip) is the deciding instrument before the V4.8.0 tag — bench-first, tag-last

Version 4.7.0 | 2026-11-03
- HARD SIP AND HARD PUFF (upstream #58, the accepted next feature from 4.6.6's posture line): a second, higher-threshold sip/puff band with its own actions. A hold that STARTS beyond the hard threshold (compiled default 10.0 hPa, 6+ hPa above the regular band) fires its action on release with NO hold-duration requirement — instant access to the long-window actions for users who cannot sustain a 1-3 s hold. New main states PRESS_SAP_MAIN_STATE_HARD_SIP/PUFF carry their own action rows (compiled defaults mirror the long-window cells: hard puff -> drag/B3, hard sip -> scroll/B4) with a 0..60000 ms window: the end boundary deliberately does NOT reuse 8000, which effectiveWindowMs maps onto the user's stored max window — a hard hold outlasting it (the core audience cannot necessarily release quickly) would fire nothing; 60000 is not a stored-window boundary and passes through unmapped
- THE CLASSIFIER CONTRACT (new LSPressureClassify.h, pure and host-tested): classification moves out of updateState's inline chain into a header with no Arduino types, pinning the hard-band semantics: (a) HARD-STICKY DOWN — a hold that STARTED hard stays hard while it decays through the regular band, so decay can never convert it into a phantom click on release; (b) NO MID-HOLD UPGRADE — a regular hold pushed into the hard band stays regular (one gesture, one action, never click-then-hard); (c) the 4.5.7 release hysteresis is subsumed by the continuation rules (a held band survives until pressure falls through 0.7x the REGULAR threshold, then releases — a hard hold releases on the same boundary); (d) fail-safe ordering — hard thresholds must exceed the regular ones, and a caller that violates it gets an EMPTY hard band (the feature goes inert, never misfiring). Fresh hard entry still requires the engage filter's two consecutive same-direction samples (a hard entry that decays within two polls safely starts as a regular gesture), so a hard event means exactly "started the gesture hard" with full phantom-click protection
- THE SETTINGS-BUDGET GATE, RESOLVED (the settings-v2 decision 4.6.6 deferred #58 behind): the four new keys live in a SECOND settings file, /settings2.dat (seed {"HS":10.0,"HP":10.0,"HA":5,"HB":4}, 256-byte budget), NOT in the main file — the main file's 480-byte budget is the 4.1.0 downgrade cliff (that firmware reads it with a fixed 512-byte buffer and truncates anything longer on its next write) and the fully-populated document already sits at ~463/480. LSMemory routes every size check through a new per-file budgetFor() (the initialize/readAll/writeAll/writeObject guards and the over-budget destroy line now hold each file to its own budget), so the main-file contract is untouched byte-for-byte: 4.1.0 round-trips keep working exactly as guarded, 4.1.0 simply never touches the second file, and a downgrade KEEPS the hard configuration for the re-upgrade. Documented trade: a FACTORY RESET performed ON 4.1.0 leaves /settings2.dat orphaned with the pre-reset hard values (our FR formats the filesystem and re-seeds BOTH files; 4.1.0 knows nothing of the second)
- NEW SERIAL ENDPOINTS (8 dispatch entries): HS,0/HS,1 and HP,0/HP,1 read/write the hard thresholds (float endpoints, same validation shape as ST/PT plus one extra rule — a SET below the LIVE regular threshold + CONF_PRESS_HARD_MARGIN_HPA (1.0 hPa) is refused FAIL,3 with nothing written, keeping the hard band a clearly distinct gesture); HA,0/HA,1 and HB,0/HB,1 read/write the hard band's mouse-column action, validated against the caregiver-safe switch-remap allowlist (one hard gesture can never be remapped to erase settings or restart the device; mouse column, so drag/scroll — the compiled defaults — stay legal; CONF_ACTION_NOTHING is a real mapping, not a sentinel). EX,0 replays all four after the PT lines. initSipAndPuff loads both thresholds after the regular ones and heals a stored hard value below the margin floor up to it (a hand-edited settings2 cannot wedge the bands out of order; a floor above the absolute max leaves the band inert per the classifier's fail-safe)
- LIVE SAP TABLE: g_sapActionTable (the switch-remap pattern) is seeded from the compiled sapActionProperty by initSapActions() in initRestrictions — BEFORE initSipAndPuff in setup(), so it is self-seeding — and applies the HA/HB overrides; inputLoop evaluates the live table. A settings file written by older firmware has no HA/HB keys, so the live table stays byte-identical to the compiled table (no behavioral change for existing users); the one accepted edge (a PARSEABLE settings2 that lacks HA/HB — hand-edited only, the boot seed always writes them — reads back 0 = NOTHING and the hard band goes inert, the same fail-safe direction as every other corrupt-settings case, re-armed by the first HA/HB SET)
- HUB MENU PAGES (the on-device half of #58): the Hub's Sip & Puff submenu gains Hard Sip and Hard Puff rows (pages 543/544), appended in front of "... Back" so every pre-4.7.0 row keeps its index; each opens the same coarse 10-level adjust page as the regular thresholds ("Hard Sip: L6 10.00"). A step can never land below regular + margin: Decrease clamps at the floor instead of stalling (the setter refuses below-floor writes), and a value stranded by a regular raise heals on page entry. healHardThresholds() also runs after every regular-threshold step, so the pair can never silently go out of order from the menu — the band a caregiver sees on the OLED is always the band that fires (the same rule as the boot heal); every menu-driven write emits the usual MANUAL line so LipSync Connect re-syncs. The 4.5.1+ menu-state endpoints (CH,0:0 read, CH,5 push) carry the new page ids as-is
- VERIFICATION: host core suite grows to 105 checks under ASan/UBSan (32 new checks pin the classifier: fresh hard/regular entries and boundary exactness, hard-sticky down, no mid-hold upgrade, release hysteresis on both bands, the inverted/equal-threshold fail-safe, and the engage filter's integration with hard states); timer suite unchanged at 165/165. The app-side Hub remote mirror follows the new pages (rows, ids, entry heal, MANUAL resync); the app↔firmware protocol cross-check pins the submenu row order and the 543/544 page mapping, and the app suites run 494/494 + browser audit 85/85

Version 4.6.6 | 2026-11-02
- THE REVIEW-ROUND FIX SET (a full code-review pass over the 4.1.0→4.6.5 line found three major defects and a batch of minor ones; all fixed, all verified against the callers): clean `--warnings all` production compile at 42% flash / 24% RAM, host suites now 165/165 timer + 73/73 core checks under ASan/UBSan (7 new checks pin the new LSTimer behaviors)
- STUCK-DRAG ON A MID-HOLD SENSOR FAULT (major, a 4.6.5 regression): the phantom-click fix settles the pressure state machine to {NONE, WAITING} when the sensors die while a hold is ACTIVE — deliberately emitting no RELEASED — but the ONLY code that ends an engaged DRAG/SCROLL hold keys on RELEASED. The latch (canOutputAction=false, left button down, scroll poll swapped in) therefore survived the fault: held mouse button, every later action dispatch dead, and the only escapes a hub-button press or a full post-recovery re-puff a sip/puff-only user cannot know about. LSPressure now raises a take-and-clear hold-cancel flag in that path and pressureLoop answers it with cancelSapOutputHold() — the exact bookkeeping of the hold-release branch (setLedDefault + releaseOutputAction) with still NO action-bearing event: no phantom click, no stuck button. This also aligns the fault path with the SD-restriction contract, which deliberately lets holds "end cleanly instead of sticking"
- THE SD-FLAG RACE (major, reopening the 4.5.27 APP_MEMACC class): g_softDeviceEnabled was only set AFTER Bluefruit.begin() returned, but the SoftDevice is enabled INSIDE that call — and the loop task runs time-sliced with the 16 KB init task, so a pt=4 (LED action) or pt=7 (serial dispatch) trail stamp landing in the enable window took the RAW GPREGRET path with the SD up: the exact MEMACC death 4.5.27 eliminated, reachable by a hub-button press during BLE bring-up. Raising the flag early is NOT an option (verified: the core's SVC_Handler is FreeRTOS's context-switch trampoline — an SD-function SVC with the SD down corrupts live registers), so the fix is a symmetric quiesce: the init task opens g_bleInitWindow around begin() and every DIAGNOSTIC retention writer (writeTrailByte, the witness ISR's marker, the 120 s streak clear, the USB-recovery marker) skips the write while lipsyncRetentionUnsafe() is true (window open + flag false). Flag-then-window ordering on both the success and failure paths leaves no state where a stamp can take the raw path with the SD up; a failed begin() now RE-PROBES sd_softdevice_is_enabled (a later internal stage can fail with the SD already enabled). Also closed the sibling hole: setup() now seeds the flag from sd_softdevice_is_enabled() before the first retention access, so the bootloader-leftover-SD boot (the sd=1 case) no longer runs stamps raw for a whole session, and initializeBluefruit drops the flag the instant it disables a leftover SD
- SETTINGS READS CANNOT FABRICATE CORNERS (major): LSMemory::readPoint returned its point by value, and a failed read (open failure, size guard, parse failure — ArduinoJson indexes a null object to 0) silently produced {0,0}. The one live consumer applied it verbatim: setInputMax + setMinimumRadius + reprocessLastReading — a mid-session settings read failure reset every calibration corner to the origin, on the wire AND in the live cursor math (the stiff default-radius degradation), including inside abortJoystickCalibration's reload-to-persisted path. readPoint now returns bool with the out-param untouched on failure (open/parse/missing-key/non-finite all refused via the existing isLastReadOk machinery), getJoystickCalibration validates each corner against the full-calibration convention (CONF_JOY_CALIB_CORNER_MIN) and keeps the LIVE stored corner on failure via the new pure getStoredInputMax accessor, gates its js mutations on sensor presence, and answers FAIL,3 when stored corners are unusable. LSJoystick's ctor now default-initializes every scalar (the CA,0/EX getters are reachable on sensorless safe boots — the API table is not filtered by safe mode — and previously read uninitialized members on exactly the boots the _begun work targeted)
- SETTER CONTRACT LEAKS: SS/SL/AV on a refused store read the value back with readInt — which yields 0 on an unreadable file — and silently degraded the LIVE cursor speed to level 0, scroll to minimum, acceleration to 0 for the rest of the boot while answering FAIL,3, breaking each setter's own "leaves the live value untouched" comment. All three now fall back to the in-force value (js.getOutputRange() / g_scrollLevel / acceleration), which equals the stored value whenever the file is healthy and is immune when it is not
- DM=1's JOYSTICK-POLL DISABLE ACTUALLY HOLDS: setDebugState(DM=1) disables the joystick and scroll polls, but evaluateOutputAction — which inputLoop runs every 20 ms with outputAction == NOTHING — re-enabled the joystick poll within one tick, so the documented "joystick debug deliberately disables that poll" contract silently didn't hold and the sensor was double-polled. The swap block now also gates on g_debugMode != CONF_DEBUG_MODE_JOYSTICK (the pressure side's equivalent was closed in 4.6.5; this was its untouched twin)
- MODE-LOCK TOCTOU CLOSED: CONFIRM_MODE_CHANGE executed changeMode() with no LK re-check — a user sitting on the confirm page while a caregiver enables the lock from the app could confirm the locked mode change (persist + reset). The gate now re-checks g_modeLocked at confirm time with the same refusal shape as the Mode-page row (error cue, named locked page, scheduled return)
- THE MILLIS-WRAP INPUT FREEZE IS GONE: inputIsFrozen() left _inputFrozenUntil stale forever, and a stale deadline re-enters its honored band once per 49.7-day wrap — up to 15 s of silently dead menu input (serial CH presses acked and ignored) on a long-uptime device. Expired deadlines are now consumed on first observation; the factory value 0 is refused outright
- BOOT-TIME OVER-BUDGET DESTROY IS NAMED: a parseable settings file over the 480-byte downgrade budget used to be destroyed and re-seeded in total silence (the destroy stays — 4.1.0 would truncate exactly such a file — but the loss now prints one ERROR line naming the size, the budget, and the replacement)
- GAMEPAD UNMOUNT CLEANUP: the gamepad's service() lacked the mouse's disconnect clearing, so a pending coalesced report could be transmitted to the RE-ENUMERATED host before usbCheckConnection's cleanup tick (a button-down with no user input, bounded to ≤150 ms by the release timers). Mirrored: unmount zeroes the pending report
- BUZZER QUEUE UNDER CATCH-UP: update() drained every due note in one pass, so a ≥250 ms stall played a tone and its trailing silence back-to-back — the last call won and the ready cue's second note was cut to zero length. One entry fires per pass, and a late-fired tone reschedules due silences past its real finish
- LSTimer POOL: a finite maxNumRuns above the counter's 65535 saturation ceiling used to silently become RUN_FOREVER (the exact wrap bug the saturation comment claimed fixed — no caller today, one future caller away); registrations now clamp at the ceiling, pinned by a host test. New anchorAllToNow() re-arms every active slot to one full interval — activateTest calls it for all four pools at exit, because the self-test's deliberate 14–19 s stalls left every 20 ms poll slot ~750 fires due: a multi-second burst of back-to-back I2C/screen/input polls the instant the user resumed input
- USB RETRY POOL HYGIENE: the usbConnectTimer one-shot re-arms overwrote usbConnectTimerId[0] without deleting a still-pending predecessor — a direct usbCheckConnection call (the busy-latch path) arriving mid-episode orphaned the pending one-shot and the population stabilized at 2, doubling the effective retry cadence and re-growing the backoff twice per period. Every re-arm now goes through usbConnectRearm (delete-before-arm)
- LATENT LANDMINES DISARMED: LSBLE.h gains the include guard every other header already had (it defines external-linkage objects; a second inclusion was an immediate multiple-definition break); LSPressure::setPressureMode now refuses PRESS_MODE_ABS, whose math algebraically zeroes the sip/puff signal (dead code today, one future caller away from a fully silent input device)
- UPSTREAM ISSUE POSTURE (the branch's stated goal is to address all of the tracker; recorded decisions): #58 Hard Sip and Hard Puff is the accepted NEXT feature — the evaluator's classify step extends naturally to a hard band, but the settings file sits at ~463/480 bytes of the downgrade budget, so the 2–4 new threshold keys require the settings-v2/budget decision FIRST (a hard feature gate, not a nice-to-have); #16 multi-host Bluetooth switching is DEFERRED with rationale (requires BLE central + HID client — the vendored Bluefruit52Lib carries BLEClientHidAdafruit, but bonding management, Hub-menu host switching, and S140 peripheral/central coexistence make it a project, not a patch); #54 mechanical drift is parked pending evidence (the 4.6.5 offset work covers pressure drift; this is joystick hysteresis — a DM-stream capture from the affected unit decides between stationary auto-recenter and a mechanical fix); #83 static-shock unresponsiveness is a hardware-class failure the firmware already bounds as far as software can (watchdog + lockup safe-mode + hang witness) — documentation item, not code; #85 ESP32 feasibility stays a research task outside this firmware line. Hardware-only open issues (#84 #70 #69 #59 #19 #15 #26 #24) and repo hygiene (#80) are unchanged. Remaining firmware-relevant open set after this branch: #58, #16, #54, #83, #85

Version 4.6.5 | 2026-11-01
- PHANTOM CLICK SAFETY: after the TinyUSB-1.7.0-equivalent build entered normal use, untouched hardware intermittently emitted both left and right clicks with matching Hub action blinks. `SD=1` stopped them, locating the source upstream of HID in the sip/puff evaluator. A new sip or puff now requires two fresh consecutive same-direction 50 ms polls; lone/alternating spikes and a valid sample followed by a failed read cannot become STARTED→RELEASED clicks. Both pressure reads include the sensors' P_DA status byte, so cooperative-timer catch-up passes a millisecond apart cannot count the same 25 Hz conversion twice; 500 ms without a complete fresh pair gates a conversion-stalled sensor even if its I2C address still ACKs. The scheduled pressure loop is the sole sampler—PV and pressure debug consume its last complete sample rather than double-reading a conversion. The qualifier interval is included in measured hold time, so configured action windows do not shift
- VERIFIED / BOUNDED PRESSURE DRIVERS: Adafruit LPS2X `getEvent()` always reports success and its private read path decodes an uninitialized buffer when BusIO fails; LPS35HW's scalar register helper likewise cannot expose a complete transaction verdict. Both pressure values now come from bounded, exact-length four-byte STATUS+pressure Wire transactions; a failed/short read cannot randomly land inside the broad absolute-pressure plausibility band and masquerade as a fresh opposite-direction sample. The exact pinned LPS2X 2.0.6 and LPS35HW 1.0.6 sources are vendored with 100 ms bounds on their upstream reset/one-shot loops, which otherwise repeat all-one BusIO failures forever; `begin()` now fails honestly instead of freezing setup
- OFFSET / UPSTREAM #88 HARDENING: the 60-second offset refresh used the previous state, so an input beginning on that boundary could be averaged into “neutral”; release or a weaker input could then appear reversed. Established offsets now refresh only from a complete stable run inside a conservative neutral band, never from partial samples or applied pressure. Boot/recovery sensing stays inert until a safe baseline completes, and an interrupted recovery retains the last complete offset instead of exposing unresolved readings
- INPUT ACTION WITNESS: every resolved non-NOTHING physical action emits one low-rate `MANUAL,0:IA,0:<class>,<state>,<action>,<hold-ms>` event before delivery. Device-generated clicks, gamepad presses, menu actions, and remapped switch actions are visible in Connect support logs without enabling a high-rate stream
- CALIBRATION CORRECTNESS: `writePoint()` now replaces each CA array instead of appending to it—repeated calibration had kept returning stale `[0]/[1]` coordinates while growing the settings file toward its downgrade budget. Corner fallback validation runs after all ten samples rather than letting an early low sample install an unbeatable 13 mT default. Failed corner persistence aborts and reloads prior values; cursor/HID output closes at flow acceptance and stays closed through the full calibration’s internal center step
- SERIAL FRAMING / LIVENESS: the fixed-capacity TX queue is line-aware. Request prioritization and overflow may discard stale whole lines but never the unsent tail of a line whose prefix is already on USB, preventing concatenated corrupt responses. Runtime BOOT/HB, settings, timer, pressure, safe-mode, calibration and self-test diagnostics use non-blocking framed output; a DTR-open host that stops reading cannot freeze the assistive loop. BOOT’s former `fp=none` newline split is eliminated
- USB/HID: mouse/gamepad HID registers while detached, then the bus attaches with the complete descriptor; begin/retry no longer blocks setup for 5 s / the live loop for 200 ms. Normal enumeration gets a quiet grace interval before the recovery page. A dedicated retained marker—not every software-reset reason—guards the single automatic recovery restart, so normal OM/CM/MP reboot boots keep self-healing. Disconnects cancel drag/scroll and clear queued button state. Gamepad B1–B8 have independent release timers, and busy/same-tick reports coalesce into a guaranteed pending flush instead of leaving a button held when joystick polling is disabled
- SAFE BOOT / WATCHDOG: hardware detection and real driver-begin verdicts land before HID/BLE selection, so every hardware-safe boot is genuinely CDC-only. The watchdog arms before device-driver initialization as defense in depth, and safe successors skip suspect sensor bring-up. An inherited nRF52 watchdog is still fed on the settled boot (the peripheral cannot be stopped across warm resets), while TIMER3 is deliberately not re-armed. The automatic USB-recovery marker no longer counts as a crash streak
- INPUT / FEEDBACK / TIMER FIXES: GPIO setup moved out of global constructors; release/debounce timing uses the live stopwatch (restoring the intended 20 ms short-press threshold), while a disabled sip/puff cannot cancel another input class’s hold. Sound mode is authoritative across Hub and Connect, so an SM=1/2 write really re-enables audio after Hub-off; Hub-originated sound/light/threshold changes push MANUAL updates. BLE verdict take-and-clear is atomic across tasks. Re-entrant zero-delay final timers cannot double-fire, with sanitizer regression coverage
- VERIFICATION: clean `--warnings all` production compile at 40% flash / 23% RAM; firmware host suites pass 158/158 timer checks plus 73/73 core checks under ASan/UBSan; the firmware↔Connect protocol cross-check passes all 71 command shapes / 42 endpoints and confirms matching build gates; the paired Connect tree passes 466/466 integration tests, 115/115 real-browser checks and 2/2 offline E2E checks

Version 4.6.4 | 2026-10-29
- ATOMIC THREE-WAY MODE SWITCHING: the 4.6.2 hardware log confirmed the user's Gamepad -> Bluetooth complaint. LipSync Connect sent OM=Mouse then CM=Bluetooth, but firmware 4.5.8+ deliberately resets on every individual OM/CM change; OM's ack landed and its reset killed the port before CM could be sent, so the device correctly rebooted into the half-applied pair (USB Mouse) and required the user to repeat the Bluetooth selection
- NEW `MP,1:n` ENDPOINT: one validated preset atomically stores both settings in one crash-safe JSON replacement, acknowledges once, then performs exactly one reset — `MP,1:1` USB Mouse, `MP,1:2` Bluetooth Mouse, `MP,1:3` USB Gamepad. Unsupported combinations remain structurally impossible, same-mode writes are idempotent, and the existing OM/CM endpoints stay wire-compatible for old hosts and diagnostics
- CONNECT 4.6.4 GATE: firmware 4.6.4+ uses MP for the three-way dropdown, Bluetooth shortcut, and post-update mode restoration, so every transition between Mouse / Bluetooth / Gamepad is one user action and one reboot. Older firmware keeps the established ordered OM/CM/SR fallback. Regression tests pin Gamepad -> Bluetooth in both interactive UI paths and in update-snapshot restoration
- FIRST 4.6.4 BENCH RETEST DIAGNOSIS: the device upgraded and reported 4.6.4 correctly, but every attempted transition still used legacy OM/CM and the log contained zero MP commands — localhost's service-worker cache v40 had paired the new firmware with pre-MP app JavaScript. LipSync Connect now hard-invalidates that cache (v41), disables/clears offline caches while a local firmware-manifest override is active, and stamps its app build into every exported support log. The same capture proves both CM=2 boots remained protocol-responsive with no BLE-init failure, heartbeat, fault, or reset loop; discoverability troubleshooting therefore proceeds as a bond/connection-state question rather than treating it as another failed BLE boot
- 4.6.4 HARDWARE VALIDATION PASS: the deployed Connect build identified itself as `2026-10-29.atomic-modes.1` and exercised the atomic endpoint end-to-end. Mouse -> Gamepad (`MP,1:3`) rebooted once into OM=2/CM=1; the formerly broken Gamepad -> Bluetooth transition (`MP,1:2`) rebooted once directly into OM=1/CM=2; Bluetooth -> Gamepad (`MP,1:3`) and Gamepad -> Mouse (`MP,1:1`) likewise landed their complete pairs in one action. Every MP write acknowledged, every reset disconnected cleanly without recovery chatter, and there were no FAILs, timeouts, faults, BLE-init errors, heartbeats, or reset loops. During the 72-second Bluetooth interval the device advertised, became visible, and paired successfully

Version 4.6.3 | 2026-10-29
- 4.6.2 HARDWARE VALIDATION PASS: in-place DFU update and settings restore succeeded; USB mouse ↔ USB gamepad ↔ Bluetooth mode reset round-trips all persisted correctly; Bluetooth stayed stable; center reset and full four-corner calibration completed and verified; factory reset restored every default; a deliberate interface-cable pull entered stable hardware safe mode (`sns=0001`) with 5 s heartbeats, a continuously-fed watchdog, honest zero PV/IN values, preserved stored corners, repeated health checks, no HardFault, and no reset loop; the cable-pull section of the exported log is a PASS
- READY CUE IS NON-BLOCKING: the first post-flash forced USB recovery overlapped a SETTINGS handshake; the response landed ~780 ms late because `playReadySound()` froze the whole loop for its 500 ms + 250 ms notes. The same two-note cue now runs through the existing bounded note queue and explicitly releases PWM after 750 ms, while serial, cursor, pressure, and watchdog work continue normally
- SETTINGS-WRITE LATENCY: 4.6.2 explicitly called LittleFS `flush()` and then `close()` for every atomic settings write; `close()` already synchronizes the file, so this doubled flash synchronization and the bench measured ~650-780 ms per restored setting. The redundant flushes are removed from settings and BLE-verdict writes; exact byte-count checks, close-before-rename durability, and atomic rename remain intact
- RELEASE WIRE HYGIENE: expected USB re-enumeration/retry/mount witness lines are now USB_DEBUG-only. The 4.6.2 post-flash recovery line was harmless but appeared as an undecodable app line during an otherwise healthy boot; BH remains the production diagnostic source
- CONNECT FOLLOW-UP FROM THE SAME LOG: the app now recognizes HB/BOOT/ERROR/WARNING/FAULT/SDFAULT as intentional diagnostics rather than possible serial corruption, hides and rejects the firmware-4.4+ LM=3 option on 4.1, and canonicalizes LM=3 to LM=2 when restoring a newer snapshot onto old firmware. The observed 4.1 `FAIL,3:LM,1:3` can no longer be generated by the UI or downgrade restore

Version 4.6.2 | 2026-10-29
- FULL FIRMWARE-MIGRATION REVIEW: repeated review/fix passes over the complete first-party firmware, the V4.1 compatibility path, vendored Wire/Bluefruit/XENSIV integrations, host tests, source bundle, and release workflows. Production build is clean at 40% flash / 23% RAM; firmware host suites pass 172/172 under ASan/UBSan; the LipSync Connect protocol cross-check passes all 70 command shapes / 41 endpoints; its integration suite passes 446/446
- SERIAL/API SAFETY: malformed numeric values (including a bare decimal and decimals sent to integer endpoints) are rejected instead of truncated; canonical responses use a 4 KB non-blocking CDC queue so a connected host that stops draining cannot freeze the assistive-device loop; CM=0 is no longer loadable/settable; RS,1:1 now performs the reset it advertised; UID output is stable eight-character hexadecimal
- SETTINGS/PERSISTENCE: reads cannot reuse a stale JsonDocument after an open failure; every replacement verifies a complete write before atomic rename; whole-document writes must be valid JSON objects; deadzones are enforced as one finite 0<inner<outer<1 invariant; pressure thresholds and timing windows use symmetric load/set validation and bad windows heal on flash; mode-menu OM/CM changes persist as one atomic pair; factory reset writes one complete defaults document instead of ~22 flash rewrites
- CALIBRATION/JOYSTICK: center and full-calibration flows are serialized, every timer refusal aborts to the last persisted calibration, stale callbacks cannot revive a failed flow, and each center uses a fresh five-sample window. Startup-center failure now exits startup safely. Center/radius/deadzone changes immediately recompute stationary output; the fixed raw deadzone is center-relative; zero-range mapping is guarded
- INPUT/HID: USB and BLE clicks are two-phase queued reports, so a release can never be lost to a busy endpoint and leave a host button stuck when joystick polling is disabled. Gamepad release-timer refusal clears buttons immediately. Debug-mode initialization now occurs after timer registration, and DM=1 -> other modes restores exactly one normal joystick poll
- SENSOR/BUS HARDENING: pressure health requires the current ambient sample (not a stale prior value); never-begun and partial sensor states stay gated. Wire recovery now clears all stale TWIM completion events and emits an explicit I2C STOP after bus-clear clocks. The XENSIV wrapper verifies the bytes actually drained, not only requestFrom's count
- SCREEN/MENU: missing-display/allocation-failure boots never dereference the SSD1306 null framebuffer; the destructive safe/restart/factory paths now actually enforce the documented hold-to-confirm threshold; full-calibration freezes cover the real ~4.95 s step; transition-registration failure falls through safely; mode changes no longer reboot after saving only half the pair; center/calibration failures get honest pages and guaranteed returns
- FEEDBACK/TIMERS: light mode OFF now gates the onboard RGB LED; stale/freed timer IDs reject state operations; Bluetooth/error blink registrations no longer overlap through one shared ID; registration failures fail safe; owning circular buffers are initialized, bounds-safe, re-beginnable, and non-copyable
- FAULT/BOOT SAFETY: HardFault and SoftDevice-fault paths never call RTOS delay or enter the CDC driver's unbounded full-FIFO loop; BLE task-creation failure is visible and persisted; previous failed BLE verdicts participate in abnormal-boot reporting; normal TinyUSB mount events remain silent unless diagnostics are warranted
- RELEASE HYGIENE: release staging starts from an empty dist directory, UF2 conversion downloads are SHA-256 verified, the source ZIP contains all required vendored libraries and rebuilds on library changes, stale ZIP entries are impossible, the About-MMC updater fails closed and now has working markers, and tracked .DS_Store debris is removed

Version 4.6.1 | 2026-10-28
- BASELINE SESSION VERDICT (bench, log 2026-10-28 05:32-05:37, 4.6.0): **THE 4.5.6-ERA MISSING-SENSOR FREEZE IS GONE.** Five+ boots with sns=0001 (joystick AND both pressure sensors absent at checkI2C — the exact class that froze 15/15 in the controlled 2026-10-22..24 repro, 0.9-12 s in) were all STABLE: safe mode up, full settings load served, HB heartbeat every 5 s to ms=45000, watchdog fed (feed=0ms), no rst=0x2 (DOG) anywhere in the log, no manual power-cycles needed. The 4.5.7->4.6.0 line and/or this unit's current state no longer reproduces the historical freeze — the hardware-isolation matrix is no longer blocking a release on this evidence
- **THE SESSION'S ONE FINDING, ROOT-CAUSED AND FIXED: PV,0:0 ON A MISSING-PRESSURE-SENSOR BOOT HARDFaultS.** Twice reproduced (the user's report: "a health check with the disconnected cable immediately restarts the hub"); the 4.5.23 capture machinery named it both times — BOOT lines "rst=0x4 pt=7 pm=2 fp=0xE000" then "fp=0x14000" (pt=7 serial dispatch, pm=2 captured HardFault). Symbolized against the .map: fp=0xE000 decodes to app page 0x4E000 = **Adafruit_I2CDevice::write_then_read/write (0x4E29C/0x4E240), called from Adafruit_LPS35HW::readPressure (0x4DBD0)** — the null-i2c_dev chain. The differing second page is the same garbage-pointer cascade one level deeper (a deterministic trigger wandering through garbage, the signature of a null-this chain)
- MECHANISM, END TO END: initSipAndPuff() (the ONLY caller of LSPressure::begin()) is gated on both pressure sensors being present at checkI2C, so a missing-sensor boot never begins the Adafruit LPS35HW/LPS22 drivers (their i2c_dev pointers stay NULL). The LSPressure constructor defaulted `_sensorsHealthy = true`, so the first ps.update() — reachable ONLY from the serial PV handler (the pressure poll is sensor-gated at setup) or DEBUG,1:2 — took the healthy read path straight into `readPressure()`/`getEvent()` on never-begun drivers -> HardFault -> captured -> SREQ reset. That is why the degraded boot sat perfectly stable (45 s+, full settings load) until the health check's PV arrived and killed it ~0.5 s later
- THE FIX (object-level, both sensor classes): an object that was never begun cannot touch its drivers. LSPressure gains `_begun` (set at the end of begin(); update() returns before any driver I/O while unset) and the constructor now starts `_sensorsHealthy = false` — begin() sets the real verdict. LSJoystick gains the same `_begun` gate at readMagneticField(), the single choke point every joystick read (poll, calibration, DEBUG,1) funnels through; a failed read already means hold-last-value everywhere. PV on a degraded boot now answers honest zeros (0.00,0.00,0.00) instead of faulting, and BH's pressure-health field stops claiming "healthy" for sensors that are not there (the constructor default made isSensorsHealthy() lie on never-begun boots)
- ALSO COVERED BY THE SAME GATE: DEBUG,1:2 (pressure debug) from the debug poll and DEBUG,1:1 (joystick debug) had the identical reachability on degraded boots via serial DEBUG commands — both are now inert until begin() runs
- UNRELATED CONFIRMATIONS FROM THE SAME SESSION: healthy control boot clean and silent with a passing health check; mid-session cable unseat graceful (the "Pressure sensors not responding" ERROR line, no reset); CM,1:2/CM,1:1/SR round-trips all clean; **hazard 2 did not fire** (no pm=1 anywhere across constant port churn — its exact trigger condition)

Version 4.6.0 | 2026-10-28
- MINOR VERSION BUMP (user request): 4.5.x line retired at 4.5.29; the firmware is now 4.6.0. Rev counter resets to 0 for the new minor. Every subsequent bench round continues to bump CONF_LIPSYNC_VERSION_REV (4.6.1, 4.6.2, ...) so binaries stay distinguishable on the wire
- LED FIX CARRIED IN: the 4.5.28 connected-transition blue paint was still being clobbered by the pending scan-blink timer armed during the disconnected advertising window (its final run lands on LED_CLR_NONE). The transition now deletes that timer before painting, so the solid blue survives. Reported on 4.5.28 hardware: "blinking blue didn't become a stable blue, stayed off until a hub event repainted it" — this is the cause
- No other code changes; 4.5.29 release-hygiene contract (healthy boots print nothing) stands. Host suite 149/149

Version 4.5.29 | 2026-10-28
- RELEASE HYGIENE — THE "HEALTHY BOOTS PRINT NOTHING" WIRE CONTRACT IS RESTORED. The 4.5.9-4.5.12 bench instruments carried their own expiry note ("deliberately breaking the contract until the BLE boot is bench-cleared") — the BLE boot is bench-cleared (4.5.27), so the contract stands again. No instrument was deleted: everything that earned its keep stays, now CONDITIONAL
- THE BOOT REPORT IS NOW CONDITIONAL (g_bootReportWorthy, computed at setup): the first-host-byte BOOT forensics line prints ONLY when the previous boot ended ABNORMALLY — a witness marker (pm: a hang or captured HardFault), a captured fault page (fp: an SD assert or fault handler), a failed BLE init (the persisted verdict pst=0..4), or a LOCKUP reset bit (the one death class with no capture — the bit itself is the report; watchdog deaths already boot safe mode and the HB line reports them). Every normal flow — power-on, reset pin, the deliberate software resets of CM/OM/SR/menu/UM, healthy BLE boots — is SILENT. Each abnormal class leaves one of the surviving signals, so the exact forensics that won the hunt (rst/pt/pm/ble/st/sd/pst/prc/fp/sw, same line format as ever) still report for precisely the boots that need them
- THE 30-SECOND REPEATING HEADER IS RETIRED — it existed for the TinyUSB CDC discard window (a serial monitor opened mid-fault-loop could catch a dying boot's state); the conditional report and the HB line cover every live class, and healthy boots get their silence back
- THE BOOT MILESTONE TRACE ("BOOT: com-op om=", "interfaces up", "BLE deferred to 16KB task", "BLE task create", "BLE stack up", "BLE advertising", "BLE task up", "setup done") is now gated behind the existing USB_DEBUG compile flag (LSConfig, default 0) — makers debugging with a serial monitor flip one flag and get the full trace; release builds print none of it. FAILURE lines ("BOOT: BLE FAILED at ...", the SAFE MODE warnings, "Activating software reset") stay unconditional — they only fire on boots that are vocal by contract. UNCHANGED: the 5-second degraded/safe HB forensics line (the released contract's diagnostic endpoint — it keeps all its fields), the LED semantics (scan blink/solid blue/red), the verdict persistence, the SD-aware retention access, the witness, the hang-witness settling
- What a healthy session looks like on the wire now: the app connects, loads settings, and sees ZERO unsolicited lines — no "Undecodable line dropped" noise on any normal flow

Version 4.5.28 | 2026-10-28
- **THE HUNT IS OVER — BLUETOOTH MODE WORKS ON HARDWARE** (bench round 21, log 2026-10-28 00:12-00:22, 4.5.27): the BLE boot is fully stable — blue scan blink while discoverable, PAIRS, and the serial protocol runs alongside the live link (the full settings load, hub menu navigation over CH pushes, SR restart, CM round-trips all worked with the radio up). No SDFAULT, no reboot loop, no heartbeat — a healthy boot, silent as designed. The Fable-prescribed fix is confirmed on hardware. The full arc: 22 bench rounds, one expert consult, one root cause (the 4.5.6 boot-trail forensics writing the SD-restricted POWER register raw) — and 4.1.0's Bluetooth worked because it predated the machinery that killed it
- THE ONE REPORTED ITEM, FIXED (the user's only finding): after pairing, the LED went DARK instead of solid blue and stayed dark until a menu open/close repainted it. Mechanism: the pairing handshake connects/drops/re-bonds around the exchange; btFeedbackLoop's state-change branch calls setLedDefault(), whose second live isConnected() query can transiently disagree with the poll's own reading mid-handshake — clearLedAll() had already run, the blue branch didn't match, and the steady state repaints only on CHANGES, so the LED stayed dark until an unrelated setLedDefault (the menu exit). Fix: the connected transition now paints the solid blue DIRECTLY from the poll's own result — no second query, no race; the disconnected transition keeps the default path (the scan blink re-arms within one poll). Expected: solid blue the moment the link comes up
- The watch items stand untriggered: no pm=1 stalls (Fable's hazard 2 did not appear in this session), sw=590-645 across all boots, pst=5 persisting correctly

Version 4.5.27 | 2026-10-27
- **THE ROOT CAUSE, FOUND (Fable 5.1 second-opinion consult, bench round 20 — with the disassembly to prove it): THE BOOT-TRAIL FORENSICS WERE THE KILLER.** Every `bootTrailStamp()` → `writeTrailByte()` writes `NRF_POWER->GPREGRET2` RAW — and POWER is a SoftDevice-RESTRICTED peripheral. With the SD up, the S140's memory-watch unit flags the write: id=NRF_FAULT_ID_APP_MEMACC (0x1001), and per nrf_sdm.h:283 the reported pc may sit up to 2 instructions PAST the offending store — i.e. at the callee's entry. That is why the bench read String copy ctors, blinkLed and __NVIC_SystemReset as "the killers": the disassembly shows the store before each bl is the stamp in the CALLER — processSerialMessage's pt=7 stamp (before the by-value String arg), performLedAction's pt=4 stamp (before blinkLed), the witness ISR's marker (before NVIC_SystemReset). The "death sites" the trail named were the death INSTRUCTIONS. The machinery added in 4.5.6 as the freeze forensics killed every SD-up boot since; 4.1.0's Bluetooth worked because it predates the machinery entirely; st=1 boots (SD down) were stable for minutes; stock never stamped; USB boots wrote the same registers with the watch unit disarmed. The stack (sw=593-648 = 2.3-2.6 KB headroom) and heap-corruption theories are both dead, and my 4-bit fp= encoding was an artifact (0x2BC44>>13&0xF = 5 → "0xA000" was blinkLed's page, not the SoftDevice's)
- THE FIX (exactly as prescribed): all retention access routes through `lipsyncRetentionGet/lipsyncRetentionUpdate` (LSApiDeclarations.h) — the sanctioned `sd_power_gpregret_get/set/clr` SVCs while the SoftDevice is up, raw writes when it is down. A cached `g_softDeviceEnabled` flag (set the instant `Bluefruit.begin()` succeeds, LSBLE.h) — never `sd_softdevice_is_enabled()` from the witness ISR, that is itself an SVC. Mask-based updates (clr bits, then set bits), which also closes the old cross-context read-modify-write race between the loop's trail bits and the ISR's marker bits. Converted: readTrailByte/writeTrailByte (all seven stamp sites), the witness ISR's hang marker (priority 7 — SVC from there is legal), the setup consume, checkResetReason's streak writes (LSWatchdog.h), and **watchdogLoop's 120 s streak-clear — the next scheduled death** (the stamps' fix would only have moved the kill to t=120 s). Left raw, deliberately: the HardFault capture's and nrf_error_cb's GPREGRET writes (SVCs are impossible at fault priority, and the watch unit lets the write complete — the report comes afterwards and we reset anyway)
- HAZARD 1 FIXED TOO (Fable's catch): `UM` → the core's `enterSerialDfu()` writes the DFU magic to GPREGRET raw (wiring.c:85) — in BLE mode that MEMACCs and the fault handler's own GPREGRET overwrite CLOBBERS the magic, rebooting into the app instead of the bootloader. enterUpdateMode now sets the magic through the SVCs and resets itself when the SD is up; the stock path runs when it is down
- WATCH NEXT (Fable's hazard 2, not fixed — by design): the two pc=0x272C4 deaths were the witness genuinely seeing the loop un-fed for 4 s, both coinciding with the host (re)opening the port. With the MEMACC gone, a real stall becomes a proper pm=1 SREQ and pt= names the site; first suspect: Adafruit_USBD_CDC::write spinning on tud_cdc_connected() while DTR is up and the host is not draining
- Expected next session: **BLE boots stay up** — advertising, blue scan blink, and LS_xxxx discoverable/pairable for the first time on this firmware line. If a stall class remains, pm=1/pt= will name it honestly

Version 4.5.26 | 2026-10-27
- BENCH ROUND 19 (log 2026-10-27 22:08-22:11, fresh flash over 4.5.24): **THE SDFAULT LINE LANDED AND NAMES THE KILLER** — "SDFAULT id=0x1001 pc=0x5D368 info=0x1". Decoded against the S140 6.1.1 headers: id=0x1001 = **NRF_FAULT_ID_APP_MEMACC — "Application invalid memory access"** — our code at pc=0x5D368 made a DISALLOWED WRITE into SoftDevice-protected peripheral space (info=0x1 = the MPU PREGION[0] sub-region that caught it, ≈ the RADIO block at 0x40001000). Symbol-mapped: **pc=0x5D368 is the Arduino String COPY CONSTRUCTOR** — a String copy writing into a peripheral register means the String's buffer pointer was GARBAGE: the classic signature of memory corruption exploding through a corrupted heap object. The idle deaths' page (fp=0xA000 — ambiguous mod 0x20000 with the 4-bit encoding, i.e. 0x2A000-0x2BFFF in the app) covers the LSScreen/ledBlinkEffect region — both death sites are loop-context, both are the deep String/screen/LED paths
- THE CONCURRENCY THEORY IS RULED OUT AT THE SOURCE: the core's malloc IS thread-safe — `--wrap=malloc` is in the platform's link flags (verified in platform.txt), routing malloc through heap_3.c's pvPortMalloc, which wraps `__real_malloc` in `vTaskSuspendAll/xTaskResumeAll`. Concurrent String allocations (init task vs loop) cannot corrupt the heap
- **THE PRIME SUSPECT, BY ELIMINATION: THE 4 KB LOOP-TASK STACK OVERFLOW.** The loop task's stack is malloc'd from the SAME heap as the String buffers (xTaskCreate → pvPortMalloc → malloc); an overflow smashes adjacent heap/String objects directly → corrupted String pointer → the copy ctor writes through garbage → the write lands in protected peripheral space → APP_MEMACC. It fits every observation: BLE boots run a DEEPER loop call-chain than USB (the serial dispatches, the screen transitions, the LED effect machinery all at once); stock's near-empty loop survives the same SD; the 4.5.10-era stack fact is on record (the core's 4096-byte loop stack with the blind mode-1 canary check — the check only runs at context switches, and the explosion fires mid-call-chain before any switch); the crash PC is String-copy; the fault only ever occurs with the SD up (USB boots write the same code paths but shallower and with the MPU off)
- THE INSTRUMENT: `sw=` — the loop task's stack high-water mark (uxTaskGetStackHighWaterMark, FreeRTOS words) printed on the BOOT/HB lines, handle captured at setup entry. Next session's read: sw= near zero on BLE boots = the overflow is confirmed and the fix is stack relief (vendored core main.cpp with a larger LOOP_STACK_SZ, or loop-side allocation trims); sw= healthy = back to the heap-object corruption hunt with the corruption source still unknown

Version 4.5.25 | 2026-10-27
- BENCH ROUND 18 (log 2026-10-27 21:38-21:42, fresh flash over 4.5.23): THE LOCATION LANDED — "fp=0xA000" on the successor of a dying BLE boot (st=5 pst=5, init fully succeeds, advertising runs, death in loop context). 0xA000 is INSIDE THE SOFTDEVICE'S OWN FLASH (MBR 0x0000-0x1000, SD 0x1000-0x26000, app 0x26000+): the SD asserted internally — its own code caught an invariant violation and reset the chip. The SDFAULT print (with the SD's own assert file/line via the info pointer) did not land this session: the death happened with the serial port closed, and the print's bytes sat unflushed in the CDC buffer and died with the reset
- THE FLUSH FIX: the vendored nrf_error_cb (and the sketch's HardFault capture) now call Serial.flush() — tud_cdc_write_flush() starts the USB IN transaction by writing the USBD peripheral directly, so the bytes go out on the wire even from the fault context (the peripheral completes the transfer in hardware; the completion IRQ staying masked is irrelevant). Flush → dwell → flush → reset. On the next session's port-open deaths (the deaths cluster ~0.3 s after the host opens the port — exactly the captured-port case), the SD's own "assert at <file> : <line>" should land in the app log, naming the violated invariant in SD source terms
- BENCH ROUND 18 META (the user's escalation, honored): a comprehensive self-contained briefing of the hunt's full state is being handed to the user for a second-opinion consult — 18 rounds of eliminations are distilled into the handoff so a fresh perspective starts at the frontier, not from zero

Version 4.5.24 | 2026-10-27
- BENCH ROUND 17 (log 2026-10-27 21:01-21:05, fresh flash over 4.5.22): THE DISCRIMINATOR'S VERDICT — "ble=2 st=5 pst=5" with "pm=0 fp=0xnone" on every dying BLE boot: NO HardFault occurred, no witness fired, no softwareReset ran — after eliminating every other rst=0x4 source, the remaining killer is the SOFTDEVICE'S OWN ASSERT PATH (sd_softdevice_enable's fault handler resets the chip the moment the application-registered handler returns — and the stock core registers an EMPTY function at CFG_DEBUG=0, so the SD's assert information was discarded with every death since round 12). The stock example proves the same SD runs stable under CDC+BLE, so the violated invariant is in OUR loop code with the SD up
- THE SD NOW NAMES ITS ASSERTION: Bluefruit52Lib is VENDORED (Libraries/Bluefruit52Lib — the repo's established fork pattern, byte-identical to the core's 1.1.13 copy except ONE function; README documents the provenance; verified by compile_commands + strings that the vendored copy wins the link). The one change: nrf_error_cb — the handler the SD invokes on assertion — now prints "SDFAULT id= pc= info= assert at <file> : <line>" to the CDC port (the deaths cluster exactly where the port IS open, so the SD's own file/line lands in the app log), records the asserting PC's 8KB flash page into GPREGRET with the same 0xC0|page encoding the HardFault capture uses (the next boot reports it as fp=), and resets — the SAME SREQ the stock path produced, so the boot-cycle shape is unchanged but every successor now names the killer. Reading the next log: an "SDFAULT ... assert at <file> : <line>" line = the SoftDevice's own assertion location (the violated invariant, in SD source terms); fp=0x<addr> below 0x26000 = the SoftDevice's own flash (an internal SD assert); fp= at 0x26000+ = our app flash (an SVC caller); pm=2/fp= at 0x26000+ = a HardFault in our code — now all three classes are distinguishable on the wire
- Note: the app's HardFault capture (4.5.23) and this SD capture write the SAME GPREGRET encoding — the consumer in setup() already handles both, no sketch changes were needed beyond the version bump

Version 4.5.23 | 2026-10-27
- BENCH ROUND 16 (log 2026-10-27 19:33-19:48): THE INIT HUNT IS OVER — the user's own capture reads "ble=2 st=5 sd=0 pstep=12 pst=5": the SoftDevice comes up, begin() passes, DIS passes, HID passes, ADVERTISING RUNS, and the flash-persisted verdict (pst=5) confirms EVERY dying boot's init fully succeeds. The double-enable dance was indeed the DIS killer (the expert consult's #1); the expert's lifecycle fix + the direct-begin shape holds. The remaining fault is a NEW, much smaller hunt: the boot dies a few seconds AFTER the init — ~0.3 s after the host opens the port and speaks (previous trail pt=7, serial dispatch) or within ~10-15 s idle (pt=4, an LED action), always rst=0x4 with pm=0 — the fault happens in LOOP-CONTEXT code with the SoftDevice running
- THE FAULT DISCRIMINATOR: the stock core's HardFault_Handler is a WEAK SPIN-LOOP (.S — overridden here; verified by nm) and the SoftDevice's assert path resets the chip itself — both read identically on the bench (rst=0x4, no marker), so the two remaining candidate classes (a HardFault in our loop code vs an SD assert) are INDISTINGUISHABLE with every instrument built so far. This build captures the fault: a naked HardFault_Handler selects the exception frame (MSP/PSP per EXC_RETURN), the capture writes the fault CLASS into the retention register's marker nibble (value 2 — reads back as pm=2; the hang witness keeps value 1; they cannot co-occur — a hang needs the loop alive, a fault kills it), encodes the faulting PC's 8 KB flash page into GPREGRET (0xC0|page — collides with none of the bootloader's DFU magics; best-effort since the SD exposes GPREGRET only via SVC — if lost, only the location is lost, never the class), attempts a one-line serial print of PC/LR/CFSR (a live port is exactly the observed death trigger — sometimes those bytes land), dwells ~100 ms, and resets. The successor boot prints fp=0x<page-base> (map it against the .map file) alongside pm=/pt=
- READING THE NEXT LOG: pm=2 + fp=0x<addr> = a HARDFAULT at that flash page (bisect the module the page covers); pm=0 + rst=0x4 on a dying BLE boot = SD ASSERT by elimination (then: app-side SD-rule violations — direct writes to SD-restricted peripherals); pm=2 with fp=none = the fault fired but GPREGRET was cleared (SD-owned SVC wall or the bootloader) — the class still stands
- BENCH NOTE: the pressure sensors are STILL marginal (sns=0111/0000 on survivors, "Pressure sensors not responding" mid-cycle) — the interface cable's pressure lines are not making contact; reseat before the next session. Also worth watching: with st=5 the mouse ADVERTISES during the ~10 s windows — check whether LS_xxxx appears in the computer's Bluetooth list (if it pairs during a window, the radio side is fully working and the hunt is purely the reset)

Version 4.5.22 | 2026-10-27
- BENCH ROUND 15 — THE DEVICE RESCUE: after flashing 4.5.21 (via the double-tap UF2 drive — the app's UM flow is dead on an unresponsive device), the device shows power + USB enumeration but total silence: no tones, no screen, no protocol. The core's TinyUSB init precedes setup, so a USB presence with pre-tone silence means the boot dies at the FIRST SETTINGS-FILESYSTEM OPERATION — the zombie phase's witness-kills-mid-write left LittleFS's METADATA torn (the 4.5.20 race broke the file; the mid-write kills broke the filesystem beneath it). A hang or crash-loop at mem.begin() explains every symptom
- THE RECOVER ARTIFACT: dist/LipSync_Firmware_4.5.22_RECOVER.uf2 — built with CONF_FS_FORMAT_ON_BOOT=1 (the flag lives in LSConfig.h, default 0; the committed tree is the default). It FORMATS InternalFS before the mount: a fresh filesystem heals the boot, the settings re-seed to compiled defaults (they were already wiped by the corruption — the format costs nothing right now), and the version string reports "4.5.22R" so the wire can tell the binaries apart. IT FORMATS ON EVERY BOOT — the instructions tell the user to flash the regular 4.5.22 over it via the app IMMEDIATELY once the device is alive, then recalibrate
- The regular 4.5.22 is functionally 4.5.21 (the regression fix) with the rescue infrastructure compiled out and the version bumped for wire identity. The next CM,1:2 cycle's first stable boot should at last carry the dying BLE boot's persisted verdict (pst=/prc=)
- Bench logistics: uf2conv.py was lost from /tmp (macOS cleanup) and re-fetched from microsoft/uf2 master (utils/uf2conv.py + utils/uf2families.json)

Version 4.5.21 | 2026-10-27
- BENCH ROUND 14 (log 2026-10-27 05:02-05:29, fresh flash over 4.5.19) — A REGRESSION, FOUND AND FIXED IN ONE: after the CM,1:2 cycle, the survivor boot read pst=-1 AND IN=0.00|0.00 CA=0.00|0.00 CM=1 — the settings file had been RE-SEEDED with compiled defaults (calibration wiped, mode reverted). Round 13 (4.5.19) survivors kept live calibration through the same cycle, so this is 4.5.20's own doing: bleVerdictPersist() ran ON THE BLE INIT TASK and opened LSMEMORY.h's ONE GLOBAL shared File handle — concurrently with the loop task's settings writes (the boot-center IN save lands exactly there). Two FreeRTOS tasks sharing one stateful file handle clobbered each other's state and corrupted the settings file
- THE FIX: the BLE task never touches the filesystem. It raises g_bleVerdictDirty (entry + every exit path); the LOOP — which already owns every FS operation, all sequential — performs the persist with its OWN dedicated file handle within milliseconds of the flag. All filesystem access is single-threaded again; the reset-proof verdict ride survives (the entry record still lands well before begin() completes). pst= on the next cycle's first stable boot should finally carry the dying BLE boot's true verdict: pst=0 (died during begin), pst=1..4 + prc= (the stage and its raw error code — the DIS code at last), or pst=5 (init fully succeeded — the fault is past it)
- The session's trailing "zombie" (port opens, MN times out, for ~20 minutes) is expected to vanish with the FS corruption gone; if it persists on a clean build it becomes the next hunt. The user's calibration needs a re-run (the re-seed wiped it)

Version 4.5.20 | 2026-10-27
- BENCH ROUND 13 (log 2026-10-27 00:51-04:18, fresh flash over 4.5.17): USB mode fully healthy (the user's daily driver works — settings, calibration values, sensors all alive), but the CM,1:2 BLE boots now die FASTER THAN THE HOST CAN OPEN THE PORT — the app's connect attempts failed for ~20s (the port did not exist — the device was mid-cycle), and every BOOT line that WAS captured came from the post-cycle SAFE boots (ble=0, mode=3 — the recovery/safe path, with the previous boots' frozen trail at pt=4 = an LED action, rst=0x4 SREQ-class, pm=0). The 4.5.19 instrumentation (st=/rc=) is on the wire but was being lost with each dying boot — the capture gap moved from the serial DTR window to the reset itself
- THE RESET-PROOF CAPTURE: the BLE init task now persists its verdict to the settings filesystem (which survives resets) at ENTRY and at every EXIT path (/bleverdict.dat, 8-byte magic-framed record, one-shot); the next boot consumes it and prints pst=/prc= on every BOOT/HB line. Whatever kills a BLE boot, the survivor now reports the dying boot's last recorded state: pst=0 = the fault hit DURING Bluefruit.begin(); pst=1..4 = the init failed at that stage with prc= (the DIS error code, at last, across a reset); pst=5 = the init FULLY SUCCEEDED and the fault is AFTER it — advertising/feedback, a different hunt entirely
- Note for the next session's reading: on this build a pst value is only meaningful on the FIRST stable boot after a BLE-boot death cycle (safe or USB) — the verdict file is consumed on first read, so connect immediately after the cycle and read pst=/prc= before doing anything else

Version 4.5.19 | 2026-10-26
- EXPERT CONSULT (the user's invitation — an nRF52/SoftDevice second opinion, 2026-10-26): the verdict MATCHES the committed 4.5.18 exactly — (1) the manual SoftDevice disable/re-enable cycle spliced into a running Bluefruit instance is UNSAFE (the library's semaphores/tasks/service registry are application-side state a stack restart does not reconstruct; the documented disable postconditions reset SD-protected interrupts to priority 0 and invalidate all BLE/GATT state) — 4.5.18's retirement of the probe dance is their #1 recommendation; (2) USBD at priority 2 is LEGAL under S140 (reserved = {0,1,4}, app-legal = {2,3,5,6,7}) — confirms the 4.5.17 model and the sweep's corrected detection set; (3) 0x1001's two documented conditions (an enabled SoftDevice interrupt, or an enabled interrupt at a reserved priority) match the bench's findings; (4) RESETREAS=0x4 is the SREQ bit — a software reset REQUEST, not per se an SD-assert or HardFault identifier (on this platform both the SD fault path and the core's HardFault handler issue NVIC_SystemReset, so 0x4 is their common signature and only the pt= trail distinguishes)
- THE EXPERT'S DECISIVE GAP, CLOSED WITHOUT LIBRARY SURGERY: the raw sd_ble_gatts_service_add() return value. BLEDis::begin() and BLEHidAdafruit::begin() return err_t — the raw SoftDevice code via VERIFY_STATUS — and the stage checks were DISCARDING it into a bool. 4.5.19 captures it: the DIS/HID failure codes ride the BOOT/HB lines as rc= (0x4=NO_MEM — attr-table exhaustion, check the ACTIVE table size; 0x7=INVALID_PARAM; 0xF=FORBIDDEN; 0x10=INVALID_ADDR). Per the consult: do NOT raise the attr-table size before the actual code is known — that changes the SD's RAM boundary and obscures the evidence
- 4.5.18 (committed, never flashed) is superseded by this build — the user should flash 4.5.19 directly. Its expected outcomes map the expert's table: blue blink + no rc= (the lifecycle fix cured it — the dance WAS the st=2 cause) / st=2 rc=0x4 (the attr table genuinely exhausted — next: verify the active table size on the live lifecycle) / st=2 rc=<other> (follow the code's documented meaning; the expert's minimal-repro and BLE-only-vs-BLE+USB isolation builds are the queued follow-ups)

Version 4.5.18 | 2026-10-26
- BENCH ROUND 12 (log 2026-10-26 20:52-23:00): THE HUNT'S CENTRAL BATTLE IS WON — the log's BLE boot read "ble=3 st=2 sd=0 pstep=11 pcode=0x0 need=0x20002D80 bad1=0x0 bad2=0x0 dem=0": THE ENTIRE SOFTDEVICE SEQUENCE PASSED (enable, all 8 cfg_sets, sd_ble_enable — the required RAM base 0x20002D80 fits under 0x20006000 with room to spare), 0x1001 IS DEAD, the {0,1,4} reserved-set model is CONFIRMED (bad=0 dem=0 with everything at priority 7), and AdafruitBluefruit::begin() SUCCEEDED for the first time on this firmware line. The failure moved DOWNSTREAM: st=2 = the DIS service begin fails, and the boot then fault-resets (next boot reads rst=0x4 pt=4 pm=0 — the frozen trail is the failed-init red blink, no witness marker — the SD-assert/HardFault instant-reset signature), producing the reboot cycle until safe mode
- THE PRIME SUSPECT IS OUR OWN 4.5.14 DIAGNOSTIC: the probe's double-enable dance (enable -> full BLE bring-up -> sd_softdevice_disable -> begin()'s second enable — a double LFCLK cycle and a disable-while-BLE-enabled that neither working recipe performs). It completed its mission the moment it captured pstep=11. 4.5.18 RETIRES it: initializeBluefruit now calls Bluefruit.begin() directly — the stock single enable with its own internal USE_TINYUSB hooks — with the stage checks and guards kept. pstep=12 on the wire marks the direct-begin build shape (11 = the historical probe-passed shape)
- THE SECOND DEVIATION RETIRED: 4.5.11's deferred BLE-boot USB attach — built on the since-RETRACTED claim that the core's USB/SD coexistence hooks don't exist (they do; begin() runs them itself) — left our boot attaching into a LIVE SoftDevice, an ordering neither the stock example nor 4.1.0 (both enumerated BEFORE the SD comes up) ever performs. The attach is restored to the stock point in beginComOpMode; the loop's deferred-attach block is removed
- The remaining differences from the working recipes are only the necessary ones: the 16 KB init task (the 4.5.10 stack fix) and the needsInitialization guards. If st=2 persists on THIS shape, the double-enable theory is dead too and the next round captures the DIS error code directly (an expert consult on the S140 double-bring-up and the DIS failure is queued in parallel)
- BENCH NOTE: the interface cable is marginal again after the enclosure work — sns flipped 1111 -> 0000 -> 0111 -> 1111 across this session, several boots landed in missing-sensor safe mode (the fail tones), and the user recovered via the hub buttons as designed. Reseat the interface cable firmly before the next session

Version 4.5.17 | 2026-10-26
- BENCH ROUND 11 (log 2026-10-26 19:53-20:04): THE CABLE IS BACK — after reseating the interface cable the boots went sns=0000 → sns=1110 → sns=1111 with live joystick values, the fail tones stopped, and the mouse works normally again (the early double-beep boots were the cable still settling; the neutral was re-zeroed via IN,1:1 — a full calibration can be redone at convenience)
- THE PRIORITY MODEL, CORRECTED BY THE BENCH — AND THE HUNT'S TRUE ROOT CAUSE: 4.5.16's probe (with the USB/SD coexistence hooks) STILL failed 0x1001 with bad2=0x80 (USBD demoted by the sweep) — while the stock example passes the same enable with USBD at priority 2. The reconciliation is the core's own TinyUSB port comment, taken literally this time: "Priorities 0, 1, 4 (nRF52) are reserved for SoftDevice". THE ACTUAL S140 6.1.1 RESERVED SET IS {0, 1, 4}, NOT the classic 0-3 — and every failing BLE boot in the entire hunt carried an enabled interrupt at exactly 4: the 4.5.13 witness (TIMER3 at priority 4 blocked sd_softdevice_enable on EVERY BLE BOOT SINCE 4.5.10, when the BLE init moved after the witness arms — the true root cause, older than every other theory), the 4.5.15 Wire "fix" (upstream's priority 3 was legal all along), and the 4.5.15/16 sweep's own USBD demotions (the core's USBD at 2 was legal all along). The 4.5.14 probe (no sweep) failed with exactly one violation: the witness at 4
- THE FIX, THIS TIME ON THE RIGHT MODEL: everything this firmware owns takes priority 7 — legal under BOTH reservation models (classic 4-7 and the confirmed {0,1,4}), never masked by FreeRTOS's BASEPRI=2 critical sections, and still preempts any thread-mode hang (the witness's actual job): the witness TIMER3 on BLE boots (USB boots keep the SD-free priority 0 for the freeze hunt), the vendored Wire's TWIM/TWIS. The sweep's demotion target becomes 7 and its detection set becomes {0, 1, 4} — bad1=/bad2= now name the true offenders directly. Expected next session: bad1=0x0 bad2=0x0 dem=0, the probe sails past pstep=1 for the first time, pstep=11, and Bluefruit.begin() comes up the same way — advertising, blue blink, pairable
- Retraction, recorded: 4.5.15's "TWIM at priority 3 was the offender" claim was wrong — priority 3 is legal under the confirmed model; the priority-4 "fixes" of 4.5.13/4.5.15 were themselves violations of the real reserved set

Version 4.5.16 | 2026-10-26
- BENCH ROUND 10 (log 2026-10-26 19:14-19:21): two separate stories in one session
- THE DEVICE'S "2 FAIL TONES, NO MOUSE AT ALL" IS THE INTERFACE CABLE, NOT THE FIRMWARE: every heartbeat reads sns=0000 (joystick, both pressures, display ALL absent) with a healthy zero-wedged bus (bus=1 recov=0 — the classic unseated-cable signature from the 4.5.6 freeze hunts; the interface cable came loose in the enclosure surgery) and the stored calibration returned 0.00|0.00 (re-seeded on a corrupt-parse boot). Fix: reseat the interface cable, power-cycle, re-run calibration. The fail tones are the missing-hardware safe-mode cue; USB and BT mouse are both dead in safe mode by design
- THE BLE 0x1001 HUNT, THE OTHER BRANCH NAMED: 4.5.15's sweep demoted USBD (bad2=0x80 — the core's TinyUSB port DELIBERATELY runs USBD at priority 2; its own comment calls 0/1/4 "reserved for SoftDevice") and the probe STILL failed 0x1001 — proving the offender is the error's second branch, "having enabled SoftDevice interrupts": the core's usb_hardware_init (Adafruit_TinyUSB_nrf.cpp) enables the POWER_CLOCK interrupt at boot for VBUS monitoring — the SoftDevice's own shared interrupt line — and the SDM refuses the enable while it is on. THE STOCK EXAMPLE PASSES BECAUSE AdafruitBluefruit::begin() RELEASES IT: its USE_TINYUSB coexistence hooks (usb_softdevice_pre_enable uninit's the power driver before the enable; post_enable re-registers the events through the SD's power SVCs after) — and THE PROBE WAS NOT RUNNING THEM. It was never a complete mirror of begin(); the priority theory alone was never the whole story
- THE PROBE NOW IS A COMPLETE MIRROR: usb_softdevice_pre_enable() before its sd_softdevice_enable, usb_softdevice_post_enable() the moment the SD is up — begin()'s exact order. If the POWER_CLOCK release was the missing piece, the probe sails past pstep=1 for the first time and either passes outright (pstep=11 — then begin() comes up the same way: advertising, blue blink, pairable) or names begin()'s TRUE internal failure at pstep=2..10 with pcode= (its enable having always succeeded past the hooks — the failure the st=1 aggregate has been hiding since 4.5.9)
- The demotion sweep stays as belt-and-braces (it legalizes any future priority offender and its bad1=/bad2= masks name them); the witness stays SD-legal; the Wire stays at priority 4

Version 4.5.15 | 2026-10-26
- BENCH ROUND 9 (log 2026-10-26 18:07-18:11, fresh flash over the UF2 drive after the enclosure surgery): THE PROBE NAMED IT — "pstep=1 pcode=0x1001": our own mirrored sd_softdevice_enable() fails with NRF_ERROR_SDM_INCORRECT_INTERRUPT_CONFIGURATION, "caused by using illegal priority levels, or having enabled SoftDevice interrupts". The SDM scans the NVIC at enable time and refuses if ANY ENABLED interrupt sits at an SD-reserved priority (0-3)
- THE OFFENDER: the vendored Wire enables TWIM0/TWIM1 at NVIC priority 3 — inherited verbatim from the upstream Seeed core (V4.1 used the core's Wire with the same 3, and upstream 1.1.13 still ships it) — and our BLE boot reaches the init task only AFTER the screen/sensor polling has enabled it. This closes the whole hunt with one consistent story: the stock example works because it never touches Wire; 4.1.0's BLE worked only because its Bluefruit.begin() ran EARLY in setup, BEFORE any Wire.begin() (order, not legality — and with the SD already up, 4.1.0 then ran TWIM at 3 for the whole session, illegal-by-spec but functional); our 4.5.x line moved the BLE init to the end of setup (first inline, then the 16 KB task) and the illegal IRQ was there to meet every enable
- THE FIX, TWO LAYERS: (1) at the source — the vendored Wire's TWIM/TWIS IRQs take priority 4 (legal for both the SoftDevice and FreeRTOS, whose configMAX_SYSCALL_INTERRUPT_PRIORITY=2 on this core; the handler calls no kernel APIs; upstream carries the bug and the fork's README records it); (2) belt-and-braces — initializeBluefruit now sweeps all 48 NVIC IRQs before the enable, records any enabled-and-below-4 ones into bad1=/bad2= bit masks (printed on the BOOT/HB lines, bit = IRQ number) and demotes them to 4 (dem= counts), so the SDM sees a legal NVIC whatever any future boot path enables — and the log names the true offender even on a boot where the demotion saved it
- Expected next session: pstep=11 (the full probe passes) and Bluefruit.begin() re-runs the identical sequence — blue blink, discoverable, pairable. bad1/bad2 should read 0 (the source fix removed the offender); any nonzero bit there names a second one
- Recovery note for the bench log: the device spent this session recovering from the stock-example flash (the app cannot UM a non-LipSync firmware into its update loader); the XIAO's double-tap-reset UF2 drive + the 4.5.14 UF2 restored the firmware line. All future updates go through the app's normal UM flow again

Version 4.5.14 | 2026-10-26
- BENCH ROUND 8 (log 2026-10-26 06:45-06:49, fresh flash over 4.5.12): 4.5.13's candidate fixes are both REFUTED — the BOOT/HB verdict read "ble=3 st=1 sd=0": the SoftDevice was DOWN at boot (the bootloader-leftover theory is dead; the bootloader leaves the SD disabled) and the witness was SD-legal throughout, yet the failure is unchanged. The user's 4.1.0 recollection (blue blink, discoverable, pairable) is the other key input: THE SAME HARDWARE RAN BLE FINE ON 4.1.0 — the regression is ours or the toolchain's, not the hardware's. The red blink (the new failed-init cue) was observed working as designed
- st=1 WAS OVER-CLAIMING: "SoftDevice enable" was the label, but AdafruitBluefruit::begin() swallows every return code (VERIFY_STATUS(err, false)) and st=1 actually covers enable + 8 sd_ble_cfg_set calls + sd_ble_enable (the classic APP-RAM-ceiling check — __data_start__=0x20006000 here, same linker as the stock example) + opt/semaphore/task calls. This round's build MIRRORS begin()'s SoftDevice/BLE-level sequence call-for-call in initializeBluefruit — same stock constants (prph=1/central=0, attr table 0x1000, MTU 23, stock queues, service changed), every return code captured. The BOOT/HB lines grow pstep=/pcode=/need=: pstep 1..10 names the first failing call (1=enable, 2..9=the cfg sets, 10=sd_ble_enable) with pcode= its SoftDevice error code, and need= the RAM base sd_ble_enable required (the smoking gun on NO_MEM). A PASSING probe (pstep=11) means begin() itself comes up: the probe disables the SD again and begin() re-runs the identical sequence that just passed — advertising, blue blink, pairable. pstep=11 with a still-failing begin() narrows to begin()'s tail (sd_ble_opt_set/Periph.begin/name/semaphores/tasks) for the next round
- ALSO THIS ROUND, the 4.5.11 note that the core's USB-coexistence hooks "are defined nowhere (USE_TINYUSB compiled out of Bluefruit52Lib)" is RETRACTED as factually wrong: USE_TINYUSB is defined for the whole build (compile_commands.json, all translation units), and usb_softdevice_pre_enable()/post_enable() exist in bluefruit.cpp and run around the SD enable inside begin(). Their practical effect at our deferred-attach boot is unresolved — the probe's pcode will say whether it matters
- THE CONTROL EXPERIMENT SHIPS TOO: dist/LipSync_STOCK_blehid_mouse.uf2 — the core's own stock BLE HID mouse example (built with the identical FQBN; same 0x20006000 RAM base), for the double-reset UF2 bootloader (drag-drop; the example waits for a serial monitor before Bluefruit.begin, so open the port — the app or any terminal at 115200). If the stock example does not appear in Bluetooth on this unit either, the fault is core/hardware/bootloader-level and no LipSync firmware change will fix it; if it appears, the fault is ours and the probe's pstep/pcode points at the call

Version 4.5.13 | 2026-10-26
- BENCH ROUND 7 (log 2026-10-26 05:56-05:59, fresh flash over 4.5.11): 4.5.12's bulletproof capture WORKED — the first-host-byte BOOT line and every 5 s HB line read "ble=3 st=1": the SoftDevice enable (Bluefruit.begin) is the failing stage, on every BLE boot. The user's bench observation (the XIAO's blue user LED fully dark on BLE boots) corroborates: the stock setLedDefault lights the BT LED only AFTER a connection, and the discoverable-blink never runs when the init dies — the LED was the failure made visible. Three ships, aimed at st=1:
- THE WITNESS-PRIORITY BUG, ROOT-CAUSED: initHangWitness's arm-time shortcut ("needsInitialization false <=> the stack was already begun") was written for the pre-4.5.10 world and 4.5.10 silently broke it — the BLE init moved to a task that starts at the END of setup, AFTER the witness arms, so on every BLE boot needsInitialization was still true while the enable was merely DEFERRED, the witness armed TIMER3 at priority 0, and the init task then enabled the SoftDevice UNDER an app IRQ parked on an SD-reserved level (the SD reserves priorities 0-3; the same hazard 4.5.7 identified and fixed for the old runtime hand-off, re-created at boot by the restructure). The witness now takes the SD-legal priority 4 on ANY boot with the BLE init still pending; USB/safe-mode boots (SD never comes up) keep priority 0 for the freeze hunt
- THE BOOTLOADER-LEFTOVER GUARD: sd_softdevice_enable() on an already-enabled SoftDevice fails outright, and this board's update path lands every app start through the adafruit-style bootloader. initializeBluefruit now probes sd_softdevice_is_enabled() BEFORE begin() — the result rides the BOOT/HB lines as sd= (-1 not probed yet, 0 down, 1 leftover) — and disables a leftover so begin() sees the clean slate it expects (the probe/disable are MBR-serviced SVCs, legal either way). This covers the alternate st=1 theory in the same flash; the sd= field names which world we were in
- BLE STATUS IS NOW VISIBLE WITHOUT LOGS: a FAILED init (task done, needsInitialization still true) blinks the BT LED RED — re-armed per poll exactly like the stock scan blink, same timer slot, mutually exclusive with it by construction; a healthy BLE boot keeps the stock indications (blue blink while advertising, solid blue once connected). setLedDefault's swapped v4.1 comments (the USB branch claimed to be the BLE indication) are corrected to match the actual branches — the shipped colors are unchanged. Next session's readout is immediate: red blink = still broken (read st=/sd=), blue blink = discoverable (pair it), solid blue = paired

Version 4.5.12 | 2026-10-26
- BENCH ROUND 6 (log 2026-10-26 04:22-04:32, fresh flash over 4.1.0): the BLE boot is now STABLE AND CONNECTABLE — settings load over USB on every BLE boot, the Hub menu navigates, live views run, restarts work both directions (CM,1:2 and CM,1:1 cycled cleanly three times) — but the mouse still does not appear in Bluetooth. The repeating header's st= verdict was lost to the TinyUSB CDC discard window (writes before the host opens the port are dropped; every tick fell there, and by first host byte the header stops). Three ships:
- THE CAPTURE IS NOW BULLETPROOF: the first host byte of any session prints the BOOT header ONE final time (it lands in every app log right after connect, carrying rst/pt/pm/ble=/st=), and a FAILED BLE init now counts as a degraded boot — the 5-second HB heartbeat carries "ble=3 st=<stage>" for the whole session so the verdict is visible repeatedly, not once. The header version literal is now the version constant (no more per-bump edits)
- THE FIX ATTEMPT — the advertising payload: the 4.1.0-era init added BOTH the keyboard AND mouse appearances to the advertising data; the arithmetic sits at exactly the 31-byte legacy advertising limit (flags 3 + txpower 3 + appearance 4x2 + service UUID 4 + name "LS_xxxxxxxx" 13 = 31, ZERO margin — one byte more and addName/start fail). The core's own stock blehid_mouse example adds ONE appearance. Ours now matches: a single MOUSE appearance, with the HID service itself untouched (the keyboard+mouse report descriptors on the wire are unchanged — only the cosmetic advertised appearance moved). If st=4 was the failure, this fixes it outright; if st=1 (SoftDevice enable) was, the new capture names it and the next round goes at that call
- Also confirmed working this session, from the log: the CM reset-on-change flow over a 4.1.0->4.5.11 flash (settings survived, restore clean), and the deferred BLE-boot USB attach (serial reachable on every BLE boot)

Version 4.5.11 | 2026-Oct-25
- BENCH ROUND 5 (log 2026-10-25 18:27-18:31): THE BLE BOOT IS STABLE — 4.5.10's repeating header finally spoke: "BOOT: 4.5.10 rst=0x4 pt=5 pm=0 ble=3" — no fault loop (the 16 KB init task held), settings load, the menu navigates, restarts work. ble=3 = the init task COMPLETED but a STAGE FAILED (needsInitialization stayed true -> no advertising -> nothing to pair). The stage line printed during the boot, before the app's port opened — discarded by CDC, the exact capture gap the repeating header exists to close. Two ships:
- THE FIX CANDIDATE: on BLE boots the USB attach now WAITS for the BLE init's verdict (or a 10 s fallback that keeps serial recovery reachable). Rationale from the core source: Seeed's bluefruit.cpp CALLS the Adafruit USB-coexistence hooks (usb_softdevice_pre_enable/post_enable) around the SoftDevice enable, but the hooks are DEFINED NOWHERE in this core (USE_TINYUSB compiled out of Bluefruit52Lib — verified by grep of the entire 1.1.13 tree) — so nothing coordinates an ATTACHED USB device with the SD enable, and our BLE boot was the one boot that attached USB before Bluefruit.begin() ran. The stock boot order is SD first; the attach now follows it. This was very likely also the 4.5.8/4.5.9 fault's true mechanism: a FAILED Bluefruit.begin() (same stage) followed by the unchecked GATT/DIS/HID/advertising calls on a dead stack — the HardFault loop — before 4.5.9's checks existed
- THE GUARANTEED CAPTURE: the failing stage is now a live variable (g_bleInitStage: 1 = SoftDevice enable, 2 = DIS, 3 = HID, 4 = advertising start, 5 = success) printed in the REPEATING boot header as st= — a stage failure now names itself on any port opened within the first 30 s, no matter when in the boot it fired. If the attach-after fix is wrong, the next log's "ble=3 st=<n>" pins the stage and the hunt narrows to one call

Version 4.5.10 | 2026-Oct-25
- THE BLE BOOT FAULT, ROOT-CAUSED AND FIXED (bench log 2026-10-25 16:08-16:52): the gamepad boot works perfectly, CM,1:2 acks and resets cleanly — and the BLE boot loops. The trail pinned the death site: pt=4 on every dying cycle (the trail resets each boot, and the boot-CENTER LED feedback is the last stamp before the fault) means the fault lands ~2.6-4 s in, right after the center completes — around readyToUse() and the FIRST btmouse.move() — not inside Bluefruit.begin. The mechanism: the core's FreeRTOS loop task (which runs ALL of setup() and loop()) has a HARDCODED 4096-BYTE STACK with no functioning overflow detection (configCHECK_FOR_STACK_OVERFLOW=1, mode 1 — misses overflow-and-return), and the BLE boot alone adds kilobytes of call depth on top of this firmware's already-heavy setup (SoftDevice enable, GATT table, HID service, advertising assembly). Silent stack corruption -> delayed HardFault -> the core's instant-reset handler -> rst=0x4 with no witness marker (pm=0) -> an identical BLE boot -> the infinite loop the user watched
- THE FIX: the BLE init now runs on its OWN FreeRTOS task with a 16 KB statically-allocated stack (configSUPPORT_STATIC_ALLOCATION=1; priority 2 = TASK_PRIO_NORMAL — above the loop, below the SD event handler), started at the END of setup so it never contends with the sensor/screen/timer inits. The loop task's 4 KB never touches Bluefruit.begin. Every BLE call site in the loop is guarded so the pre-init window is a no-op window, not a fault window: LSBLEMouse::mouseReport (the single choke point for move/scroll/pan/click/press/release) skips while the stack is coming up, joining the existing needsInitialization guards on isConnected and btFeedbackLoop. A failed init stage now prints its BOOT line and leaves the device connectable with BLE inert (CM,1:1 back to USB at any time) instead of fault-looping
- THE TRACE NOW REPEATS: the one-shot boot trace was proven insufficient — the app opens the port AFTER the boot and CDC output before an open port is discarded, so three sessions of BLE-boot deaths left the wire silent. The boot header (rst/pt/pm + ble=<0 none|1 running|2 up|3 failed>) repeats every second for the first 30 s of a boot or until the first host byte; any serial monitor opened mid-loop captures the state within one second, and a healthy connected session falls silent after at most one line

Version 4.5.9 | 2026-Oct-25
- BENCH ROUND 3 (log 2026-10-25 16:08-16:15): CM,1:2 now acks and resets cleanly (the 4.5.8 reset-on-change flow verified on hardware), but the FIRST real CM=2 boot on this firmware line loops — boot tone, reboot, repeat, never settling, and never reachable over serial. Diagnosis from the cycle's shape: a watchdog loop would flag safe mode on the next boot (serial returns), and the hang-witness loop self-settles into safe mode after 3 cycles — a loop that never settles is the FAULT class (the Seeed core's HardFault handler is an instant reset: rst=0x4, no safe mode, no marker, infinite). The failure is on the boot-time Bluefruit path, which this firmware line had NEVER executed before (every prior CM=2 boot was a safe-mode CDC-only boot). Since a fast fault loop gives the wire no time to speak, this build makes the boot SPEAK and the BLE stack FAIL LOUDLY:
- BOOT TRACE: every boot prints its reset reason up front (rst=/pt=/pm=) and short milestone lines through setup — com-op modes, "BLE begin", the BLE internals' own success/failure lines, interfaces up, setup done, loop alive. Inside a fault loop the LAST line printed names the death site. ~8 unprefixed short lines per boot, deliberately breaking the "healthy boots print nothing" wire contract until the BLE boot is bench-cleared (the app provably tolerates unprefixed lines — three sessions of HB/ERROR lines dropped as undecodable with no waiter false-match possible)
- initializeBluefruit now CHECKS every begin(): a failed SoftDevice enable previously cascaded into the DIS/HID/advertising SVC calls on a dead stack (an SVC with the SD down HardFaults -> instant reset -> the loop). On failure it prints the exact failing stage and bails with needsInitialization still TRUE — every BLE call site is guarded (isConnected, btFeedbackLoop), so the boot completes, serial stays up, and the trace names the fault instead of faulting
- BLE boots now begin the Bluefruit stack BEFORE the USB attach (USB/gamepad boots keep the bench-validated attach-first order) — a fresh diagnostic axis on the boot-loop hunt; if the fault follows the detach state, the trace will say so
- LSBLEMouse::begin no longer clears needsInitialization itself — initializeBluefruit clears it ONLY on full success

Version 4.5.8 | 2026-Oct-25
- BENCH FIXES, ROUND 2 (second hardware session, log 2026-10-25 06:40-06:44). Version bumped from 4.5.7 so the wire can tell the fixed build from the first (unfixed) 4.5.7 binary — both said 4.5.7 and the first session's reflash silently re-took the old one:
- CM,1:n IS NOW RESET-ON-CHANGE — the live interface hand-off (USB<->BLE at runtime) is REMOVED. The bench caught the hand-off dead-hanging the firmware TWICE (both sessions): the pre-hand-off setLedDefault() called Bluefruit.connected() on a never-begun SoftDevice and never returned (no CM ack at all, 30 s watchdog death, CM still stored — the "loading then dying" loop). A runtime SoftDevice enable mid-session was the fragile path regardless. A com-mode change now saves, acks, and software-resets — the exact flow the bench validated live twice for OM,1:x (ack, port drop, reconnect in the new mode); the menu's mode change already reset (finishChangeMode), so this is consistent. Same-mode writes stay a no-op ack (the app's restore flow is idempotent). doFactoryReset aligns g_comMode before its CM default-write so the chain cannot abort mid-way (the OM alignment's twin — that ordering bug class again)
- LSBLEMouse::isConnected() returns "not connected" when the stack was never begun (needsInitialization) — the pre-begin callers (setLedDefault's BLE branch, btFeedbackLoop) can no longer touch an un-enabled SoftDevice. Kept as defense even with the hand-off gone
- The TIMER3 hang witness is now SoftDevice-aware: priority 0 on USB-only boots (the freeze hunt's requirement), an SD-legal priority on BLE boots (the SD reserves the top levels; initHangWitness picks at arm time — BLE boots enable the SD in beginComOpMode before the witness arms)
- RETRACTION: the previous session's "phantom navigation" was NOT ghost input — the MANUAL CH,5 walks were the user's own hub-button recovery fighting the CM hang (confirmed by the user). The hold-to-confirm gate on the destructive menu rows (safe-menu Restart/Factory Reset + both confirm pages: a select held ~half the short window, floored 150 ms; serial CH,1 bypasses) ships anyway — a destructive action should be a deliberate hold on an assistive device
- Bench-verified on 4.5.7 hardware this session: the OM reset-on-change flow (twice), the gamepad-column allowlist rejection, the WS,1:0 ordering validation, the WM 10-char validator, settings persistence across the update, and the app's full load/restore flow

Version 4.5.7 | 2026-Oct-24
- CM,1:2 HANG: setLedDefault() ran BEFORE the hand-off's btmouse.begin() and called Bluefruit.connected() on a SoftDevice that was never begun — the bench caught it never returning (no CM ack printed at all, 30 s watchdog death, every attempt). LSBLEMouse::isConnected() now returns "not connected" whenever the stack was never begun, which makes every pre-begin caller safe (setLedDefault's BLE branch, btFeedbackLoop)
- THE SECOND LAYER: the runtime SoftDevice enable (btmouse.begin -> Bluefruit.begin) ran with the 4.5.6 TIMER3 hang witness armed at NVIC priority 0 — the SD reserves the top priority levels, so a priority-0 app IRQ across an SD enable is illegal. The CM,1:2 hand-off demotes the witness to an SD-legal priority before the enable (it stays there; initHangWitness re-picks on the next boot — priority 0 on USB-only boots for the freeze hunt, SD-legal on BLE boots), and the same SD-aware choice is made at arm time
- PHANTOM NAVIGATION: with the app idle, MANUAL CH,5 pushes showed the device walking its own menu into Restart/Factory Reset and CONFIRMING (~40 ms ghost clicks — the "tone over and over" was the shutdown sound each cycle; one factory reset was triggered by the DEVICE, not the user). Source not yet pinned (floating switch jacks with the interface cable out is the prime suspect — DM,4 next session decides). Defense shipped regardless: the destructive menu rows (safe-menu Restart/Factory Reset and both confirm pages) now require the select to be HELD for half the effective short window (floored at 150 ms — above any glitch class, below any legal window); a too-short select answers the error cue and stays on the row. Serial CH,1 presses bypass (no hold concept on the wire). A phantom click can no longer erase or restart a device
- THE FULL-CODEBASE REVIEW FOLLOW-UP (every finding of the 4.1.0→4.5.6 line audit, fixed at its source; compile 39% flash / 14% RAM; host suite grown to 149 checks, all passing under ASan/UBSan, now also run by CI). By severity:
- RELEASE HYGIENE: the 4.5.6 tag shipped the bench's "witness build" heartbeat — its own comment called it "a diagnostic patch, not the release behavior", yet every boot printed ~105 HB lines for the first 90 s while CHANGES.txt claimed "healthy boots still print nothing". The released contract stands again: degraded/safe boots print one 5 s forensics line (rst/pt/pm/trail/bus/recov/sns), healthy boots print nothing
- SERIAL OM,1 MODE CHANGE WAS DEAD CODE: the setter assigned g_operatingMode BEFORE changeOperatingMode() compared it, so the reset-on-change never fired — a serial mouse→gamepad switch left the gamepad HID interface never-begun while every report went out the MOUSE interface (the release toolchain's TinyUSB hardwires instance 0), with BH telemetry counting the misrouted reports as successes. The global now flips only inside changeOperatingMode, and a stored OM=0 (no sender, no beginComOpMode case — and a 1 s SoftDevice stall when combined with BLE polling) is rejected by the API and clamped at boot
- A GAMEPAD-COLUMN SWITCH REMAP TO DRAG/SCROLL WEDGED EVERY INPUT (4.5.0 regression): the caregiver allowlist permitted the mouse hold modes into the GA/GB/GC cells, but gamepad mode's legacy hold-tracker clobber made the release-match unreachable — canOutputAction stuck false, every input dead until a reboot or a serial center flow. The allowlist is now column-aware (the gamepad columns reject DRAG/SCROLL on SET with FAIL,3 and fall back to the factory cell at load), and performOutputAction's hold bookkeeping can no longer arm an unreleasable latch in gamepad mode at all
- LSInput's REACTION-TIME FILTER INVERTED INTO A GLITCH LATCH: a press visible for under one reaction window matched no branch of the state machine's else, so the STALE state was re-pushed with the timer restarted every tick — quick taps silently eaten until a ≥2-tick press, the LM=3 LEDs showing a held input that wasn't, and a glitch on one jack merging with a real press of another into the S13 combo row (a phantom START_MENU on release). A sub-reaction press is now discarded as the glitch the machine's own definition says it is
- LSPressure's 60 s TIMER RESET RAN MID-HOLD: the unguarded form wrapped a >60 s hold's elapsed back to (T-60 s) so the release classified into the wrong window (a 63 s sealed-tube puff fired START_MENU; a 61 s one engaged drag), and re-measured the offset DURING the hold — the corrupted offset zeroed the reading ~250 ms later, emitted a phantom RELEASED that fired the short-window action, then suppressed legitimate puffs for up to a minute. The WAITING-only guard (the original intent, its remains still commented in the source; the LSInput sibling kept it all along) is restored
- THE VENDORED WIRE MANUFACTURED WEDGES OUT OF PLAIN NACKs: the STOP/SUSPEND waits exited early on EVENTS_ERROR, returning before the STOP completed on the wire — the next transaction (µs later) landed mid-STOP, timed out the full 50 ms, and fired a spurious recovery on a perfectly healthy bus, once per poll of a merely absent device, while a stale EVENTS_STOPPED permanently disarmed the read path's STOP wait and the polluted recov=/bus= telemetry fed the freeze hunt exactly the noise it was built to reject. Upstream's wait-for-STOPPED semantics are restored (a STOP after a NACK completes in µs), every call now shares ONE 50 ms deadline across its waits (the per-wait bounds stacked to ~150 ms per transaction and ~21 transactions per SSD1306 push), requestFrom pre-clears EVENTS_STOPPED and clamps the read length to the 64-byte buffer, the 9-clock bus-clear only counts clocks whose SCL actually rose (open-drain: an unverified clock is a no-op a stretching slave turns into silent failure), and ERRORSRC is cleared on the read error path so the next write's classification reads clean bits
- THE JOYSTICK READ PATH RESTORED THE OLD FORK'S FAILURE SEMANTICS: a failed getMagneticField() left x/y/z at 0.0, and the discarded bool processed that as a real centered reading — a flaky bus stuttered the cursor to false-center with no fault signal (the retired TLV493D fork held last-good values). Failed reads now hold the last reading at all four call sites, and 5 consecutive failures re-issue the sensor's master-controlled-mode configuration (a browned-out sensor returns in power-down while the library still believes it is measuring — previously a silently dead cursor with sns=1 forever). The XENSIV wrapper's vendored copy propagates endTransmission()'s result (a NACKed config write used to report success — recorded in the vendored LIPSYNC.md, which also documents the gen-1 no-data-validity limitation)
- THE BUS-CRAWL BACKOFF REPLAYED STALE CURSOR OUTPUT: while backed off, joystickLoop kept converting the last computed output into relative moves every tick — a user holding a corner when the shared bus wedged got a cursor that flew to and ground against the screen edge for up to 60 s with no input able to stop it. Output is suppressed while isPollBackedOff()
- CH,1 NEXT/SELECT DROVE A CLOSED MENU: deactivateMenu never nulls the page state, so a serial NEXT painted a cursor over the ready splash and a serial SELECT executed the stale page's switch — a stale RESTART_PAGE row reset the device; a stale MORE walk reached the factory reset — recreating exactly the "drawn and navigable but reported inactive" state 4.5.5 closed. nextMenuItem/selectMenuItem now gate on _isActive like every physical input path always has
- THE FREEZE-HUNT INSTRUMENTS STOPPED CONTRADICTING THEMSELVES: the "loop never calls tone()" invariant was false (playReadySound still queued a note that buzzer.update() fired from loop context; modeEngageTone and the calibration tones call tone() from loop context) — playReadySound is now fully blocking like playErrorSound (once per boot, 750 ms), the queue machinery genuinely has no users, the comments state the verified platform facts (Tone.cpp take-or-fail semantics: a swallowed note at worst, never a corrupted instance), and buzzerErrorCue got its short non-blocking cue back instead of ~1 s of frozen loop per mode-locked refusal. Trail code 5 is no longer double-booked (the USB one-shot restart dies under usbCheckConnection's own pt=6), trail=7 is stamped on real serial dispatches instead of every idle loop pass (it was the resting value, destroying freeze-site attribution), and the three conflicting milestone tables are one table — the one the stamps actually use. The TIMER3 witness is counter-based (no millis()/FreeRTOS call at priority 0, volatile shared state), and its resets now SETTLE: three consecutive witnessed-hang deaths boot into safe mode with the watchdog/witness not re-armed — the documented settling contract, functional at last on the SREQ path that can actually count (the DOG path wipes the retention register; that budget stays documented-decorative, and LSWatchdog.h now says so). The calibration-error delay(3000) feeds the watchdog through its dwell (it sat exactly at the witness threshold), doFactoryReset's ~22-write chain is exempted like the deliberate shutdown it ends in, and testWatchdog/testLED can test what they exist to test again
- SAFE MODE IS ACTUALLY CDC-ONLY NOW: checkSafeMode's decision half runs BEFORE beginComOpMode, so a safe boot skips the mode HID interface and BLE entirely (4.5.6 registered them and flipped the mode after — an inert mouse HID on the safe boot, BLE advertising on a CM=2 unit), and the safeModePage switch gained the missing case that would have stranded any reason value outside 1-3 with no continuation
- SETTINGS PERSISTENCE IS POWER-SAFE AND SELF-HEALING: every write goes to a temp file and is RENAMED over the target (LittleFS's atomic metadata commit — the old remove-then-write lost the entire settings file, calibration and caregiver restrictions included, to a power cut in the window, and the factory reset's ~22 sequential writes multiplied it); a file that exists but does not PARSE is re-seeded with the compiled default at the next boot (the old code kept it forever, every read failed, and the next write serialized the failed document over the file — permanently destroying it); a deserialize failure prints once per boot instead of on every mid-response exchange; and the documented buffer[512]=0 one-byte overflow is guarded
- WINDOW SETTINGS VALIDATED EVERYWHERE: WS,1:0 (reset-to-default) no longer bypasses the short<long<max ordering check (a legal sequence could invert the windows and make every quick puff fire the MAX row), and the boot load sanitizes stored windows the same way the switch-remap load path always has
- PRESSURE PATH HARDENING: engage/release hysteresis (a hold now ends at 70% of the threshold — noise while holding near a boundary used to oscillate NONE↔PUFF and emit a phantom click per oscillation, ending drags on their own), plausibility-range validity instead of ">0.00" (garbage-positive ACK pairs — the flaky-cable failure mode this project has recorded — used to pass as healthy readings and could fire phantom sip/puff up to START_MENU), and the boot-time offset gather actually leaves sip and puff inert (a raw inter-sensor offset above a low user threshold used to enter PUFF STARTED, then fire the short-window action ~250 ms after the offset landed)
- RESTRICTION CONTRACT LEAKS CLOSED: a restriction-gated input no longer reaches performOutputAction's gamepad NOTHING case (which released all buttons and printed — an observable output violating "no trace"), and CF (cursor hold) applies whenever a sip/puff is physically in progress — the "!g_sapDisabled" term rested on the false premise that SD stops the pressure state machine from tracking sips (it gates actions, not sensing). Documented as deliberate: with SD set, a sip release still ends an in-progress drag (the alternative is a drag that sticks until another input — the worse evil)
- TIMER-ID HYGIENE: every pollTimer enable/disable now uses the CAPTURED pollTimerId[] instead of the compile-time CONF_TIMER_* constants (equal only by slot==registration-order coincidence — one refused registration or reorder away from disabling the wrong feature's loop), numRuns saturates instead of wrapping (a maxNumRuns of 65535 silently became RUN_FOREVER), a 0-interval RUN_FOREVER registration is refused at the source (a main-loop livelock), a nested run() can no longer double-fire a due slot, and the RUNANDDEL order stays invoke-THEN-delete (a reviewed draft that freed the slot first zeroed numRuns inside every final-run callback — silently killing the calibration flows' getNumRuns(...)==N corner-persistence gates; the full-pool self-rearm limitation that draft targeted is unreachable in this firmware and is documented in LSTimer.h instead) — and the host suite pins all of it — now at the DEVICE's 32-bit clock width (the old harness compiled 64-bit host fields, making the 49.7-day wrap class structurally untestable), with real callback-mutates-pool tests (the historically worst surface), an actually-executed id-discipline half, the wrap itself, and the real millis()==0 boot region. CI runs the suite on every build before the compile
- MENU/SCREEN: the draw-only informational dwells NAME themselves in the CH,0:0 menu state (the 3 s calibration warning, the 2 s factory-reset warning, "Changing mode.", "Exiting" — a remote polling after its press sees the page actually shown, exactly as MODE_LOCKED_PAGE already did), the center-reset flow freezes menu input for its whole chain (a mid-flow Next used to redraw the menu over the "do not move joystick" instruction), a menu-driven full calibration disables the 5-minute menu timeout for the run (a user-paced calibration could outlast it and blank the OLED mid-prompt), finishModeLocked resets the pending-transition id (the one continuation that broke the documented invariant), every _screenStateTimerId writer deletes any genuinely pending predecessor (the id now provably only ever names a live timer), speed/scroll/accel page navigation no longer emits an unsolicited MANUAL settings line per physical visit, the info page clips the ID line to the panel, and the error-code line uses snprintf
- USB/BLE: _begun gates on begin()'s returned bool (a failed interface registration was permanently believed), the mouse skip counter resets with the episode latch (the first transient tick after recovery re-latched after one skip instead of three), timedOut clears only on an ACCEPTED report, the runtime USB→BLE hand-off advertises under the same LS_<UID> name as the boot path, the dead showTestPage flag and the never-instantiated LSBLEKeyboard class (whose report path carried delay(2) — the copy-paste invitation 4.5.4 set the precedent for) are gone, and the circular buffers value-initialize their storage (an unseeded buffer read from joystickLoop's CF gate used to touch uninitialized heap)
- CI: the host suite runs on every build, lowercase v* tags produce artifacts too (this repo has shipped them), the firmware-binaries publish is serialized and pushes with --force-with-lease (the read-then-push version guard could not close its own race), the zip automation rebuilds the archive from scratch (deleted files lived on in it forever) and its v4.1 double-fire caller is gone
- The calibration-error fallback corners no longer multiply by a FAULT-latched Z direction (it replaced failed corners with {0,0} — a stored corner that then failed the radius check and left a stiff default-radius cursor); setMinimumRadius's validity test is center-relative (the old origin-relative guard let a degenerate near-center corner collapse the operating radius toward zero — a hair-trigger full-speed cursor), the center buffer must be full before averaging (a refused reading-timer registration used to average uninitialized samples), and the range polynomial's comment now documents the ACTUAL shipped values (level 5 is 6 px/tick — the bench-validated feel — instead of claiming 7 and inviting someone to "fix" it by changing the cast)
- THE REVIEW-LOOP FOLLOW-UP (a fix→re-review cycle run to convergence after the audit fixes above; the last three firmware-focused rounds found no runtime defects — only doc drift — and the loop was stopped there). Fixed on the way, by theme: SAFE-MODE/INPUT — a CA,1:1 on a sensorful safe unit disabled the input poll (the safe menu's only hardware input) and step 6's new safe-mode guard skipped its re-enable (buttons dead until reboot); the inputLoop scroll/joystick timer swap ran unguarded and re-enabled the joystick poll safe mode had shut down on EVERY sensorful safe boot; a DM,1:0 re-enabled the sensor polls the same way; calibration step 0 also disables the scroll poll now (a scroll-latched device kept polling/emitting through the run). FLOW GATES — IN,1:1/CA,1:1 on a joystick-absent boot registered chains on a timer pool that never runs (calibrationTimer is sensor-gated), latching canOutputAction false and killing ALL input silently until reboot — both flows now refuse with FAIL,3, and the menu paths schedule their own return; one calibration at a time (an acceptance-time gate: a host retry inside the 1 s start-delay window used to js.clear() mid-run and double-chain); a center during a running calibration is refused (it clobbered the shared reading-timer id, silently dropping that corner's persistence and CA,n ack — the chain's own internal step-5 center bypasses); the full-calibration page names itself and rolls a per-step input freeze. TIMER ORDER — the RUNANDDEL self-rearm restructure was REVERTED to invoke-then-delete after review proved delete-first zeroed numRuns inside every final-run callback (killing the calibration flows' getNumRuns(...)==N persistence gates); the tradeoff is documented in LSTimer.h and pinned by a new host test. LED/BLINK — a superseded long blink's stale tail lit an LED and skipped its setLedDefault cleanup (delete-before-rearm, ledTimerId now initialized to -1 so the first delete can't hit pool slot 0, the id self-clears on completion, and the blink runs on a captured parameter snapshot instead of the shared ledCurrentState); the error dwell feeds the watchdog; test mode exempts the witness. BOOT/WIRE-STATE — stored gamepad+BLE (hand-edited/old file) booted a device whose BLE poll hammered the uninitialized SoftDevice 1 s/tick and whose USB recovery ladder never armed; the boot now cross-validates the pair to USB and heals the file, and the BLE poll also keys on the stack actually having begun. CI — the lowercase-tag trigger now reaches the publish gates too (a lowercase tag built green and published nothing); an ls-remote failure is refused instead of taking the unconditional first-release push. CHANGES.txt's stale check count corrected to 149

Version 4.5.6 | 2026-Oct-24
- THE COLD-BOOT FREEZE HUNT (bench 2026-10-22..24, nine instrumented builds, controlled reproduction: pull the interface cable -> guaranteed freeze on the resulting missing-sensor boot; healthy boots never freeze). This release ships every fix the hunt verified and documents the open item honestly. Fixed, by severity:
- The safe-mode Restart row can no longer reset the device from a single Select (the CONFIRMED hair trigger): the safe-mode menu's row 0 called softwareReset() instantly with NO confirm page and was the DEFAULT cursor row, so any select-equivalent event — bench-confirmed: a user's own Back/Select press landed there and showed as a mystery rst=0x4 "idle" reset with no wire trace, because the reset fires inside the select handler before any CH,5 push prints. The row now goes through the same restartConfirmPage() the normal menu uses (upstream even left the "Back returns to the safe menu" wiring ready and unused). The phantom-reset class is closed: an idle safe-mode session now stays up (multi-hour bench runs, feed=0ms throughout)
- The 4.5.4 USB-recovery once-guard was DEAD CODE and is rebuilt on real persistence: its CONF_USB_RESTART_MAGIC lived in a .noinit word, and the bench proved this platform WIPES .noinit at every reset — the guard's magic never survived the very NVIC reset it was armed for, voiding the one-per-power-cycle auto-restart contract shipped in 438643c. The guard now lives in the nRF52 RESETREAS register: the auto-restart never fires on a boot that began with a software reset (its own SREQ is visible at the next boot), so it cannot loop, and RESETREAS provably survives every reset on this chip. Side finding, documented: the 4.2.0 watchdog-boot 3-strike budget (GPREGRET2) has been non-functional on this platform the whole time — the hardware watchdog reset WIPES GPREGRET2 (proven: trail stamped into bits 5-7 pre-freeze read 0 on every DOG-successor boot, and survived every SREQ boot) — so the budget never bounded anything; the counter machinery is byte-safe now (bits 0-1, trail in bits 5-7, both preserved across SREQ) and the 3-strike is documented as decorative on this platform rather than silently believed
- playErrorSound() gains the sound-mode gate every other tone has (it beeped even with sound OFF — a long-standing gap) and becomes fully blocking + noTone()-released: the two notes play before the LED error feedback allocates the shared HwPWM instance (the Seeed core's tone() hard-codes PWM2; an ownership left behind is how the peripheral ends up conflicted), and the loop context never calls tone() at all (the queued-note machinery this replaces was the ONLY loop-context tone() caller in the firmware — eliminated at the source)
- The hardware-error dwell CHAIN (safeModePage -> +3 s hardwareErrorPage -> +3 s errorPageI2C/errorPageCable -> +3 s safeMenu) is collapsed into one synchronous draw in safeModePage's HARDWARE case: same "SAFE MODE: Hardware" header, same missing-sensor list, same ERROR-xxx code on the safe menu, ONE +3 s continuation to the safe menu. The three chain page functions are removed as dead code (the af91082 discipline). Rationale: five witness rounds put every freeze inside the chain's timer windows, and while the chain was not the mechanism (the collapse did not cure the freeze), its three intermediate timer windows were pure exposure surface for a page sequence whose content is informational only
- The degraded/safe-boot heartbeat line grows into a field-forensics endpoint, all additive: rst=0x<RESETREAS hex> (what killed the previous boot: 0x1 reset pin, 0x2 watchdog, 0x4 software, 0x8 lockup — the one reset fact this chip persists), pt=<previous boot's last trail code> and pm=<previous-boot hang marker> (both in the retention register's spare bits — they survive SREQ resets, so a software-reset-relevant death now carries its context), trail=<live 3-bit milestone code> (1 setup done, 2 safeModePage drawing, 3 safeMenu registered, 4 LED action running, 5 softwareReset, 6 usbCheckConnection, 7 serial command dispatching), bus=/recov=/sns= (I2C health, recovery count, per-sensor detection). Healthy boots still print nothing
- A TIMER3 hang witness arms with the hardware watchdog: a 1 s interrupt watches the loop's feed stamp, and a >3 s stall with interrupts alive resets via SREQ in ~4 s with the trail preserved — any future loop-hang class that does NOT mask interrupts now recovers in seconds instead of 30 and names its death site on the next boot's pt=. Bench-honest: it did NOT fire on this unit's freeze (see below) — the freeze blocks even a priority-0 interrupt, so the witness is belt-and-braces for other hang classes. softwareReset's deliberate blocking shutdown is exempted (its 3 s delay(3000) is not a hang)
- The LED "all on" boot feedback moves AFTER hardwareErrorCheck (the error sound plays with no LED channels allocated; the two PWM users are sequenced rather than interleaved) — a hardening that keeps every user cue (sound, LED feedback, error blink) with zero overlap on the shared peripheral
- Platform facts established on the bench, documented for upstream: the Seeed core's HardFault_Handler is an instant NVIC_SystemReset (a fault reads rst=0x4, not a hang); the nRF52840 POWER.GPREGRET2 is 8 bits wide (SVD: only bits 0-7 implemented) and is wiped by watchdog resets while surviving SREQ resets; .noinit is wiped at every reset on this platform (orphan section straddling __bss_start__ in the map); TIMER2 is used by the core (bootloader version), TIMER3 is free
- OPEN, documented for the hardware-isolation test: the missing-sensor-boot freeze on THIS bench unit is not cured — it reproduces on demand (cable pulled) and was proven across nine builds to block even a priority-0 interrupt while every audited firmware path (vendored Wire polls, Tone.cpp, HardwarePWM, LED path, sound path, page chains) is bounded and interrupt-clean. The freeze correlates perfectly with the joystick sensor's absence at checkI2C (15/15 boots: sns=0101 froze at 0.9-12 s; every sns=1111 boot was stable) and ends in one watchdog reset into a stable, connectable safe mode (the recovery machinery this line built works exactly as designed). The two remaining candidate classes — a stuck equal-priority interrupt handler in the closed TinyUSB/USBD stack reacting to the sensor-less boot's USB state, or an electrical effect of the half-connected cable on the MCU itself — are not resolvable from firmware source; the next step is the same firmware on another unit or another cable, which separates unit-fault from firmware-fault in one bench session. Bench notes: the reproduction is pull-the-interface-cable -> hardware-error boot freezes 0.9-12 s in (loop dead, no exception — the core's HardFault_Handler is an instant reset, so rst=0x2 means a spin, not a fault); reconnect -> one watchdog-reason safe-mode freeze (the "one tone" boot), then a clean load. Diagnosis walk: each frozen boot's last heartbeat and its successor's first heartbeat carry the entire state (HB line: rst/pt/pm/trail/bus/recov/sns); the HB's feed= field stays 0-1 ms to the last print (the loop was feeding the watchdog normally until the instant of death)
- Leave-alone notes carried from the 4.5.5 audit remain in force (LSMemory's 512-byte edge unreachable under the 480 budget; inert RS,1:1; undrained SR/FR acks; dead accProperty; PV's bounded read; the calibration-error delay(3000) TODO)

Version 4.5.5 | 2026-Oct-22
- Second full-fresh-eye audit follow-up (independent re-verification of the whole 4.2.0-4.5.4 line against main; host-side LSTimer regression suite added under Build_Files/Firmware_Files/host_tests, ASan/UBSan, now 94 checks). Fixed, by severity:
- Safe-mode/degraded-boot dwell pages no longer expose a null menu to live input (the one MAJOR finding): safeModePage/hardwareErrorPage/errorPageI2C/errorPageCable set the menu-active flag and schedule their follow-up pages, and the 4.2.0 non-blocking conversion made the 3-9 s dwell windows live to the input poll and the CH,1 serial vector for the first time — a Next/Select arriving before safeModeMenu() registered any page state ran nextMenuItem/selectMenuItem against a null menu-text pointer (a displayMenu over a null String array: undefined behavior on the device's most vulnerable boot) or drew MAIN_MENU pages in safe mode. The dwell pages now freeze menu input for exactly their scheduled window (the same frozen-window machinery every other informational page uses — presses are dropped exactly as the old blocking delay() pages never polled them), and nextMenuItem/selectMenuItem carry a null-state guard as belt-and-braces. The CH,5 menu-state push is gated on a registered menu page, and — app cross-check follow-up — so is the CH,0:0 READ: fillMenuState answers "no menu" while no page is registered, because the app (LipSync Connect) polls CH,0:0 after every press and a press dropped in the dwell window would otherwise sync its mirror onto the same false "menu active, MAIN page" triple the push used to emit
- The menu CLOSE is now frozen-window-aware too (verification follow-up on the same fix): the freeze covered OPEN/SELECT/NEXT (each lands in a guarded method) but CH,1:4 and the STOP_MENU input action called deactivateMenu() directly, so a close arriving during a boot dwell or any scheduled page's window flipped _isActive off BEFORE the pending continuation registered its menu — a menu drawn and navigable but reported inactive by CH,0:0/CH,5, outside the 5-minute timeout (the safe-mode menu after a dwell close, the calibration/factory-reset confirm pages, the mode page after the locked-page dwell). Both close vectors now route through the freeze-aware LSScreen::closeMenu(); deactivateMenu itself stays unguarded for the screen's own continuations, and a dropped close self-heals through the app's existing press-then-CH,0:0 resync. The dead free closeMenu() wrapper (no callers since the input rework) is removed
- The USB-error page's new splash-clear cancel can no longer hit a recycled timer slot (verification follow-up on the same fix): _screenStateTimerId was bookkeeping nothing ever read before this release, and its continuations never reset it — clearSplashScreen was a free function that COULD not reset the private member — so after a splash clear fired the id went stale naming a freed slot the pool hands to the next registration (a pending API-calibration return-to-menu transition, say); the cancel introduced for the No-USB page could then delete that live, unrelated timer. Every continuation that fires from a _screenStateTimerId slot now resets it first (the same invariant the scheduleTransition continuations already document for _transitionTimerId), and the splash clear moved into the member LSScreen::finishSplashClear (replacing the free function); the host suite pins both halves of the hazard — a stale id through a fired slot kills the recycled occupant, the reset discipline does not
- _currentMenuText now carries an explicit nullptr initializer: the 4.5.5 null-state guards read a member that was only accidentally null (implicit static zero-initialization of the global); every neighboring member is explicitly initialized and the guards' correctness must not rest on linkage trivia
- A refused or rejected CM,1 no longer re-begins the current communication interface: setCommunicationMode ran its USB/BLE interface hand-off after the store-refusal and BLE-in-gamepad rejection paths too (inherited placement), so a command the device just answered FAIL,3 could still block the serial handler in usbmouse.begin()'s mount wait on a host-less device. The hand-off now runs only on the success path, where g_comMode actually changed
- The calibration corner lines follow the 4.5.2 initiator contract: the per-corner CA,n lines printed SUCCESS,0:CA,n:x|y regardless of who started the calibration, so a Hub-menu-initiated full calibration emitted unsolicited SUCCESS lines mid-session — the exact waiter-false-match class 4.5.2 fixed for IN,1 and 4.5.4 fixed per-flow. The initiator now rides the calibration chain's timer payload (CONF_CALIB_API_FLAG, the same bit-7 pattern as the center flow): SUCCESS for an app-started CA,1:1, MANUAL,0:CA,n for a Hub-menu calibration. setJoystickInitialization/setJoystickCalibration also restore the output-enabled state if the timer pool ever refuses their registration (a loud, counted failure that previously left the cursor output dead for the whole boot). Residual, documented: js.clear() runs before that registration, so a refused start cannot restore the cleared live calibration — unreachable in practice (the calibration pool holds only the chain's own two slots of 16) and left as-is rather than restructuring a bench-validated flow
- The serial menu-control range now rejects 0 with FAIL,3 (CONF_MENU_CONTROL_MIN 0 -> 1): CH,1:0 has no case in the dispatch switch and no sender, but the old range accepted it and answered SUCCESS for doing nothing — the app's remote only ever sends 1-4
- ID,0:0 answers the chip's real UID on the first read after a factory reset or board swap: it used to answer the stale stored value (the compiled placeholder on a fresh file) even though the read is what persists the real UID — the truth only arrived on the second read
- A stored switch-remap value whose cells fail the caregiver allowlist falls back to the compiled factory mapping at load (getSwitchAction validates before applying, like the write path always did): the allowlist exists so one accidental switch press can never erase settings or restart the device, and a hand-edited settings file must not bypass it. The stored value is untouched — every boot re-validates and falls back consistently
- The No-USB page can no longer be erased by the ready page's pending 10 s self-clear: if the host dropped within ten seconds of the ready splash, the splash-clear fired later and wiped the error page, and the once-per-episode latch kept it from ever redrawing (a blank OLED for the rest of the outage while the retry loop ran). drawUsbErrorPageOnce cancels the pending splash-clear when it paints; recovery redraws the ready page as before
- fillMenuState's row semantics note is now consistent everywhere it is written (the definition, the public declaration, and getHubMenuState's endpoint doc all name the selectable-row index selectMenuItem switches on — the wire values are unchanged; the old "raw text-array index" note was wrong for header pages)
- Leave-alone notes (pre-existing upstream quirks, none reachable-harmful on this branch): LSMemory's buffer[readlen]=0 pattern would overflow by one byte on a 512-byte file — unreachable for settings.txt under the 480-byte budget this line enforces; RS,1:1 ("reset settings") answers SUCCESS without doing anything (upstream never implemented it; the app sends FR); the calibration corner-store and SR/FR acks don't drain before NVIC_SystemReset (only UM got a deliberate dwell); accProperty is dead config data identical to main's; PV,0:0 still does one bounded on-demand sensor read like upstream; the 3 s delay(3000) in the calibration-error path is upstream's own blocking dwell (noted by its TODO). Full detail in the release audit

Version 4.5.4 | 2026-Oct-19
- Audit follow-up, boot-bus root cause: checkI2C() no longer disables the I2C peripheral behind itself (Wire.end() — scanner-example residue with no consumer). The bus only worked afterwards because the display's and the pressure sensors' begin()s happen to call Wire.begin() as a library side effect; the XENSIV migration deliberately stopped the joystick library from doing the same (executeInit=false), which left exactly one degraded state — joystick sensor answering with display and both pressure sensors absent, the bus dead until the vendored Wire's bounded recovery re-enabled it on the first transaction. One owner now: the bus comes up at checkI2C's Wire.begin() and stays up for every consumer, restoring exact pre-migration behavior for the degraded boot and removing the whole class. The bounded-recovery machinery is untouched and remains the only repair path
- Audit follow-up, per-flow center-ack: the center-reset completion now carries its initiator through its own timer chain (a flag bit in the step payload) instead of the 4.5.2 single global consumed by whichever completion fired first — two overlapping centers (an app IN,1:1 racing the boot auto-center or the Hub menu's Center Reset) now each ack with their own correct SUCCESS/MANUAL prefix. Also removed the completion's blind deleteTimer(0), a pre-existing upstream line whose slot-0 target is the lowest FREE pool slot — in an overlapping-centers race that is exactly the other flow's pending timeout (a host IN,1:1 arriving during the boot auto-center's reading phase took slot 0 and was silently eaten, leaving the app's waiter to time out); RUN_ONCE timeouts already delete themselves, so the line could only ever harm
- Audit follow-up, dead code removed: the never-instantiated LSUSBKeyboard class (a v4.0-era leftover whose keyboardReport() still carried an unbounded while(!isReady()) delay(1) spin — the exact bug class the 4.4.0+ HID rework eradicated from every live path; unreachable, but sitting in the file as a copy-paste invitation) and the write-only g_usbIsConnected global. The USB report descriptors are untouched — they define the composite device's report IDs on the wire and must remain byte-identical for hosts. The parked usbConnectionLoop registration stays: the boot pool's nine registrations are the contract the app-repo lstimer-test harness models, and the slot stays reserved for the unimplemented USB-connection-state feature
- Added the CH,5 menu-state push — the two-way half of Hub remote control (the app half shipped in LipSync Connect with tests; the protocol proposal in its docs/upstream-issue-comments.md is realized here): the remote's one remaining one-way gap was physical navigation. App-driven presses already reconcile from device truth (4.5.1's CH,0:0 poll after every press), but a Next/Select pressed on the Hub itself, a joystick-driven menu step, or the inactivity timeout redraws the OLED with no serial traffic — so a mirror left open in LipSync Connect drifts until the next app press or a manual Open-resync. The firmware now prints MANUAL,0:CH,5:<active>,<pageId>,<row> whenever that live triple CHANGES: the exact values the CH,0:0 read answers (the same fillMenuState), in a MANUAL frame with seq 0 — the 4.5.2 initiator contract, the boot re-center's proven shape, so a device-initiated line can never falsely resolve a pending command waiter, and hosts that do not know CH,5 ignore it as an unrecognized MANUAL readout. Emission is hooked at the flushDisplay choke point (every menu redraw ends there — open, navigation, every page transition, the exit and timeout closes), and the change-detect is the rate limiter: value screens re-render on every adjust step and the long-text scroll flushes every 100 ms, and neither changes the triple, so neither prints; a wedged/demoted display pauses pushes (nothing is shown to drift from) while the CH,0:0 poll keeps answering, and the push resumes from the latest state on recovery. Human-paced by construction — a handful of lines per menu walk. No existing command, response shape, or endpoint changed anywhere; older hosts are unaffected (LipSync Connect reconciles pushes through the same applyMenuState its polls already feed, zero further app changes needed). Bench confirmation before tagging: with a serial session open, a physical Next must arrive as MANUAL,0:CH,5:1,0,1, a physical menu close/timeout as MANUAL,0:CH,5:0,<page>,<row>, and NO CH,5 line may appear during a value-screen adjust or a long-text scroll — and the app's mirror must follow physical navigation without any app press; a fresh boot must still show the auto-center as MANUAL,0:IN,1 (the 4.5.2 bench line, now per-flow)

Version 4.5.3 | 2026-Oct-19
- The input-state LED tier's window indicator now speaks on both LED channels (bench design 2026-10-19, from the first live trial's finding): the 2026-10-19 bench test of LM=3 caught that the traffic light rendered only on the micro LED next to the USB-C port — the Hub's single RGB LED — while the three face LEDs glowed steady red through every window, because they are physically single-color and setLedColor drives them by brightness alone (the color parameter never reaches them). The honest first read of the tier was "the LEDs are always red": the window signal lived on the smallest LED on the device while the big face strip buried it. The tier now drives a dual-channel indicator instead: the face LEDs FILL left to middle to right as the hold crosses each window boundary — 1 in the short window, 2 in the long, 3 in the very-long — a count being the one message single-color LEDs can carry unambiguously ("more lights = further into the hold"), while the micro LED keeps the window's COLOR, so the channels are redundant: count for anyone who cannot distinguish colors or see the tiny LED, color for anyone who can. Re-evaluated every tick as before; release still restores the default LEDs; a restricted (gated) input still shows nothing at all. Supersedes 4.5.2 as the publish target (4.5.2's artifacts were never published)

Version 4.5.2 | 2026-Oct-18
- Fixed the unsolicited center-reset ack (bench 2026-10-18 follow-up): the joystick center flow always ended by printing a line, but the completion hard-coded SUCCESS,0:IN,1 regardless of who initiated the center — so the boot-time auto-center (initJoystick re-centers on EVERY boot, which also explains why the stored neutral drifts slightly between power cycles) could land an UNSOLICITED SUCCESS mid-settings-load, observed live as a stray IN,1 line arriving between the version request and its response. On the wire an unsolicited SUCCESS is worse than noise: hosts match command waiters on SUCCESS, so a boot straggler could falsely resolve a pending IN,1:1 with the boot center's value instead of the requested one. The ack now follows the initiator: SUCCESS only when the serial API requested the center (IN,1:1); MANUAL,0:IN,1 for every device-initiated center — the boot auto-center, the Hub menu's Center Reset row, and the full calibration's internal re-center step — carrying the same data (hosts refresh the neutral either way) while matching no waiter. No response shape or index changed anywhere else
- Closed the XENSIV migration's power trade as moot: the one open question from the 4.5.1 migration (the sensor now measures continuously at mA-scale instead of powering down between reads) would only matter to an untethered battery — and the LipSync hardware has none (BOM: Xiao nRF52840 powered via the hub USB cable, no cell or charger; mobile use powers the device from the phone over USB-OTG, the case the User Guide already steers to an external power source). The documentation trail (vendored LIPSYNC.md and LipSync Connect docs) now records the finding instead of a pending follow-up; the read path stays exactly as bench-validated

Version 4.5.1 | 2026-Oct-18
- Migrated the joystick's TLV493D-A1B6 sensor to Infineon's maintained XENSIV TLx493D library (upstream #37's deliberate follow-up; bench-validated 2026-10-18 before merge): the deprecated 4.4.0 bounded fork is retired and the vendored, unmodified XENSIV v1.1.2 copy takes its place (provenance and the boundedness audit in its LIPSYNC.md). The A1B6 read path is bounded by construction and cheaper than the fork ever was — XENSIV's default is master-controlled continuous measurement, so the 20 ms poll is a single bounded I2C read of the live registers with no wake-write/measurement-wait/sleep-write cycle at all, through the same vendored Wire. Raw values are numerically identical in scale (0.098 mT/LSB in both libraries — bench corner parity confirmed on silicon), getZ is preserved for the magnet-direction latch (now from the same register snapshot), and the self-measuring bus-crawl backoff keeps working. Accepted trade, logged for upstream: the sensor now draws continuously (~mA vs µA between reads), which only an untethered BLE session can feel; USB-powered use pays nothing
- Fixed the timer pool the whole firmware schedules on (LSTimer, follow-up to the 2026-10-18 bench heartbeat capture): registration refusals are now counted and rate-limited-printed instead of silently returning -1 (setup() also audits all nine boot registrations by name), deleteTimer and every timer-id path is silent in production (the old 'ERROR: No timers are in use.' printed MID-RESPONSE during an LK remote walk), the missing negative-id bounds were added (deleteTimer(-1)/restartTimer(-1) were out-of-bounds writes into adjacent globals — the plausible mechanism behind cross-object corruption on degraded boots), the immediate-first-fire of every 0-delay interval is fixed (startDelay>0 enables the offset, 0 means interval-only; a disabled timer's anchor keeps advancing so enable resumes within one interval instead of burst-firing), pending method timers can no longer collide (per-method trampolines replace the single static), stopwatch slots are no longer stolen by later registrations, and MAX_TIMERS grew 10 -> 16 (pollTimer held 9/10 at boot). A host-side test suite (LipSync_Connect dev/firmware/lstimer-test, ASan/UBSan, wired into npm test) locks down every fix and ran the safe-mode interval-death reproduction attempt: the exact boot pool with toggleSafeMode's disables cannot produce the captured death in pure logic, and every identified out-of-bounds write vector is now closed at the source — the loop()-fed watchdog stays as belt-and-braces regardless
- Added the settings-file size budget: firmware 4.1.0 — the oldest firmware LipSync Connect can downgrade to — reads the settings file with a 512-byte buffer and truncates anything longer, and 4.5.0's six switch mappings had eaten most of the ~130 B of headroom that made downgrades safe. LSMemory now refuses any write whose serialized form would exceed CONF_SETTINGS_FILE_BUDGET (480 B), the serial setters answer the existing FAIL,3 on a refused store instead of acking a value the next boot forgets, and the EX,0:0 dump opens with the live file size (SIZE:bytes/budget) so the bench can watch the headroom per device
- Added the Hub menu-state read (CH,0:0): the remote's drift problem was that a refused select (mode locked -> the ~2 s 'Mode is locked' page, whose frozen window also drops later presses while still acking them) could not be told from a successful one on the wire. The endpoint answers the live [menu active, page id, row]; the 'Mode is locked' page names itself (page 32) for its dwell. LipSync Connect (4.5.1-gated) re-syncs its remote mirror from device truth after every press — never sent to older firmware, and the CH,1 press grammar is unchanged
- Fixed gamepad-mode bus-health telemetry: BH,0:0 read the MOUSE's HID counters unconditionally, so in gamepad mode it reported hidReady=0 and attempts/successes=0 forever on a perfectly working device, and the 'attempts climbing / successes 0' signature that decides configured-but-HID-dead boots was invisible there. The gamepad now carries the same counters, counted at the same choke points, and BH reports the ACTIVE mode's interface at the same array indices (bench-confirmed: hidReady=1, attempts=successes climbing together, maxAbsReport tracking real deltas)

Version 4.5.0 | 2026-Oct-15
- Added external switch action remapping (upstream #20 — roadmap item 11's deliberately separate follow-up; a clinician's ask: the assistive switch jacks mapped to functions different from sip & puff, and separately mappable per host): the MOUSE- and GAMEPAD-mode action cells of the three switch jacks are now settings — a caregiver can map, per jack and per hold window (short/long/very-long), which output action each switch triggers, from the same action vocabulary the compiled defaults use (nothing, the clicks, drag, scroll, the gamepad buttons B1-B8, cursor centering, the speed steps, mode change and menu open). Everything else stays compiled by design: the menu-mode and safe-mode columns (menu navigation is a fixed language — remapping it could strand a user outside the menu), the S1+S3 combination row, and the time windows themselves (the input timing settings from 4.4.0 remain the routing)
- Wire surface: six endpoints — SA/SB/SC = jacks 1/2/3 mouse mode, GA/GB/GC = the same jacks in gamepad mode. The GET answers "short,long,max" (the actions in force); the SET takes 0 (reset to the compiled factory mapping) or 100000 + short*10000 + long*100 + max (the base keeps every non-reset value a 6-digit number, the only magnitude the serial format validator accepts), with every cell pinned to a caregiver-safe allowlist — deliberately excluded: joystick calibration, menu navigation, software reset and factory reset, so one accidental press of a remapped switch can never erase settings or restart the device. Stored 0 = the compiled default (a settings file written by older firmware reads 0 for the missing keys, so updating keeps the factory mapping); the endpoints join the EX,0:0 dump and the factory-reset defaults
- Remapped actions flow through the same seams the compiled ones do: the 4.4.0 restriction gates still apply (a remapped mode change obeys the mode lock, a remapped menu open obeys the buttons-only restriction) and the input-state LED tier and engage tones behave exactly as for any other action. LipSync Connect (4.5.0-gated) exposes the mapping as its External switch actions card — the caregiver surface the issue asked for; the Hub menu deliberately does not (an 18-cell remap grid is not a mouthpiece-driven OLED menu)
- Fixed the serial command format validator: it accepted 1-4-digit and 6-digit parameters but not 5-digit (10-char lines — a gap between two shapes of its own whitelist), so WM,1:10000 — the timing-window MAXIMUM, a value the Hub menu can set and the app allows — was answered FAIL,0 on the wire. Found by the fresh-eye round while hardening LipSync Connect's cross-repo protocol checker, which now verifies every plausible command line's length instead of only the longest

Version 4.4.0 | 2026-Oct-14
- Added input & mode restrictions (upstream #21 #44 #68 #77, roadmap item 11): four stored booleans, all defaulting to the unrestricted legacy behavior — SD disables sip & puff entirely (the pressure state machine and diagnostics keep running; a gated input produces no action, no LED, no cue), MA restricts menu open/close/navigation to the hub buttons, LK locks the operating mode against every input path (the Hub menu's Mode page refuses with a short error cue; the serial API stays open on purpose so a caregiver can always adjust the device through LipSync Connect), and CF freezes the cursor while a mouthpiece input is in progress. The gates live at the single seam every resolved input action passes through; surfaces: the serial API (SD/MA/LK/CF get+set), the Hub menu (More → Restrictions), the EX,0:0 dump, and LipSync Connect's version-gated Input-restrictions card
- Added adjustable input timing windows (upstream #62 #22 #9, roadmap item 15): the short/long/very-long input window boundaries (hardcoded 0-1 s / 1-3 s / 3-8 s since v1) are now settings — WS/WL/WM over the serial API (stored 0 = the compiled default), validated to keep short < long < max, applied at the one seam every action row is matched against; the Hub menu gets Sip & Puff → Timing (one page per window, 250 ms steps) and the sip/puff threshold pages now step a coarse 10-level scale (2/3/4/5/7/10/15/22/32/45 hPa) instead of ±1 hPa, so the mouthpiece-driven menu path is practical (the serial API and LipSync Connect keep the fine hPa granularity). The endpoints were named WS/WL/WM rather than W1/W2/W3 before shipping: LipSync Connect's response grammar matches letter-only endpoints, and a digit would have made every window response unparsable
- Added the input-state LED feedback tier (upstream #43, roadmap item 16): light mode 3 keys the LEDs to the held input's window — green in the short window, yellow after crossing into the long, red in the very-long, re-evaluated every tick; on release the LEDs return to default instead of blinking the action. Opt-in (existing tiers behave exactly as before) because re-keying the default would change semantics for every existing user; LipSync Connect offers it as "Input state". Also fixed a latent gap the tier exposed: getLightMode now keeps the live global honest (it was only ever set by writes)
- Vendored the TLV493D library as a bounded fork (upstream #37, roadmap item 1): the joystick's hall-effect sensor library moves from a zip unpacked ad hoc by CI to a vendored directory pinned by the same --libraries flag as the patched Wire. The fork bounds the two blocking constructs on the 20 ms joystick-poll path — a failed wake-up write returns an error immediately instead of delaying for a measurement that never started (the mechanism behind the JV endpoint's old device-silencing freeze), and the measurement wait is clamped to 50 ms (~5x the real master-controlled measurement, so healthy polling is unchanged). The register model and API are untouched upstream; the migration to Infineon's maintained XENSIV TLx493D library (roadmap item 2) remains the deliberate follow-up
- Root-caused the post-flash "first writes dropped" (firmware-update improvements item 2): the device was going deaf, not dropping writes — the USB-HID report paths blocked the whole main loop waiting for HID readiness (up to 5 s), and every connect-retry begin() appended a duplicate HID interface to the USB configuration (no already-begun guard in Adafruit_USBD_HID, unlike CDC), so the post-flash re-enumeration window could freeze the firmware against its serial session or present a half-configured composite device. Reports now skip instantly while the interface is not ready, and the interface registers exactly once

Version 4.3.0 | 2026-Oct-14
- Implemented cursor acceleration (upstream #86, roadmap item 9): the stored AV level (-10..10, default 0) now bends the deflection-to-speed curve in the mouse output path — level 0 is byte-for-byte the old linear behavior, positive levels move faster at gentle deflections, negative levels trade speed for precision, and full deflection always keeps the full speed of the current speed level; the level is adjustable from the Hub menu (More → Acceleration), the serial API (AV,0/AV,1, present since 4.0 but previously inert), and the app's Cursor card; also fixed the inverted comparison in decreaseJoystickAcceleration that made the level nearly impossible to lower
- Fixed the AV,1 write dispatch (found in the 2026-10-14 hardware session): the API table entry declared parameter "0" (a v4.0-era stub typo), so every AV,1 write was rejected with FAIL,3 before the function ever ran — it now accepts any value like every other setter
- After a serial-API calibration closes the Hub menu (#36), the screen now shows the "Ready to use" page instead of going blank: a merely blank screen reads as dead and invites a long wake-puff, which is the 3-8 s START_MENU input and put the menu right back (observed on hardware, 2026-10-14); the ready page says the device is finished, then clears itself after 10 s
- Screen-state correctness after asynchronous flows (upstream #36, #63 residual): the Hub menu no longer stays open after a serial-API-triggered calibration — the end page closes the menu like the pre-calibration screen — and when the USB retry loop's error episode ends because the host came back, the "No USB" page is now replaced by the ready screen once instead of lingering while the device works normally
- Added the BH,0:0 bus-health diagnostic endpoint (roadmap item 3): total bounded-timeout bus recoveries this boot, held-bus state, per-device health gates (display demoted / pressure sensors unhealthy / joystick poll backed off) and seconds since the last recovery — the telemetry that would have diagnosed the entire flaky-bus saga in minutes, now one serial read; LipSync Connect 4.3.0+ mirrors it in its health check as an "I2C bus" step
- Added the UM,1:1 update-mode entry (firmware-update improvements item 1): acks, draws a deliberate "Update mode — use the LipSync Connect app" splash as the final frame (the stock bootloader never drives the Hub's OLED, so the frozen "Restarting" message during a flash was the norm), then resets into the stock serial-DFU bootloader via the core's own enterSerialDfu(); LipSync Connect 4.3.0+ sends it over the live session in place of the 1200-baud touch when the connected firmware supports it, and a maker with a serial monitor can enter update mode with SETTINGS + UM,1:1 instead of the double-reset dance
- One short buzzer cue now plays when scroll mode or drag mode engages (upstream #61, roadmap item 16, audio half): scroll chirps higher than drag so the two are distinguishable by ear; gated to the "All" sound tier only, so "Basic" users hear no new sounds (the LED half of item 16 — cues keyed to input state rather than output action — stays on the roadmap: it changes existing feedback semantics and needs hardware validation)
- Vendored Wire: after a bounded-timeout recovery, the SDA/SCL PIN_CNF registers are restored to the begin() configuration (the NXP bus-clear leaves SCL as GPIO-output; benign under PSEL, but a recovered bus should be bit-identical to a freshly begun one), and recoveryCount()/lastRecoveryMs() expose the recovery state the BH endpoint reports (roadmap item 4)
- Added LSApiDeclarations.h (roadmap item 5): explicit declarations for every function used across .ino tab and class-header boundaries, removing the dependency on the Arduino build's auto-generated prototypes — the shallow ctags parse that a `static` local in any .ino function silently breaks, failing the build with "was not declared in this scope" inside the headers

Version 4.2.0 | 2026-Oct-13
- Cut serial settings API command latency: messages are now framed by a non-blocking line parser — newline-terminated messages are processed the instant they arrive, and legacy bare messages keep a 50 ms idle-gap frame — removing readString()'s timed busy-wait that padded every exchange with a fixed delay (1 s at the Stream default; ~2 s per command, ~30 s for LipSync Connect's settings load, now ~2 s)
- Hardened the hardware watchdog: it is now armed on every boot, including safe mode and watchdog-reset boots; a run of 3 consecutive watchdog resets (tracked in the GPREGRET2 retention register) stops re-arming so a wedged device settles in safe mode instead of resetting forever, and the budget restores after 2 minutes of uptime
- Sip and puff robustness: the once-a-minute pressure offset re-measure (and the boot-time one) now gathers its five samples one per polling tick instead of blocking the main loop for up to 15 s when a sensor misbehaves; sensors that return consecutive invalid readings are marked unhealthy — the I2C bus is left alone until a 2 s re-probe succeeds — so a flaky mouthpiece sensor can no longer stall the device, and stale readings can never fire a phantom sip or puff
- Added a patched Wire library (vendored in Build_Files/Firmware_Files/Libraries/Wire, used automatically by the CI and local builds): every nRF52 I2C transaction wait is bounded at 50 ms, and a wedged bus is recovered in place with a bounded STOP plus the NXP I2C bus-clear (up to 9 SCL clocks) — a sensor holding the bus mid-transaction now fails its read immediately instead of hanging the device until the watchdog resets it (relates to upstream issues #73 and #75)
- Hub menu and feedback no longer block the main loop: the informational screen pages (exit, mode change, center-reset and calibration completion, full-calibration and factory-reset confirmations, long-text scroll) dwell on a scheduled timer transition, and multi-tone sounds (ready, error) sequence through a note queue — the serial API, joystick and pressure polling stay live during page dwells and sound playback (the pre-restart shutdown sound keeps its deliberate blocking sequence)
- Survived a live flaky-I2C-bus hunt on the bench: a failing device on the shared bus can wedge it (bounded by Wire) or drag transfers until they crawl without ever timing out, which used to read as a flat ~1 s main-loop tax and multi-second serial exchanges. The bus now self-defends on every consumer: Wire reports held/slow state (busHealthy, recoveryCount), the joystick poll measures its own update and backs off 20 ms -> 60 s while the bus crawls, display pushes are gated by a display-health probe with one-strike demotion and exponential re-probe backoff, the no-USB retry page draws at most once per episode, the BLE connection poll is skipped outside Bluetooth mode (its isConnected() call blocked a full second on safe-mode boots), and the JV endpoint returns the last buffered reading instead of forcing a synchronous TLV493D read inside the serial command path — which, on a crawling bus, could silence the device for seconds and trip the watchdog. On the worst flaky bus the serial API now stays at ~5 ms per exchange, and the always-armed watchdog (3-strike) recovers anything that still manages to block

Version 4.1.1 | 2025-July-24
- Added CSV version of BOM to documentation folder to make it easier to see via GitHub
- Added copy of TLV493D-A1B6 library to repository
- Updated Maker Guide
  - Added instructions for manually adding TLV493D-A1B6 library
  - Added troubleshooting instructions for Seeeduino missing Python error
  - Added additional 3D printing instructions around tolerance and other processes

Version 4.1.0 | 2025-March-31
- Software bug fixes and added features 
	- TinyUSB Library bug fixed, now works with latest version (3.4.2) of the library
	- Full calibration changes
		- Moved to "More" menu to prevent Full Calibration from being selected when not necessary
		- Added warning message and confirmation page
		- Added error checking, if joystick was not moved enough during full calibration, use default value instead
	- No USB auto mode switch fix
		- 4.0.1 added a feature that if no USB was detected the LipSync would automatically switch to Bluetooth mode, but this caused unintentional effects 
		- Now, if no USB is detected, the screen displays an error message and buzzer plays an error tone, but continues to try to connect in the background
		- To change modes, the menu can now be used even if no USB is mounted.
	- i2c error checking
	- Light Brightness can now be adjusted through Hub menu or API
	- Scroll speed can now be adjusted through Hub menu
	- Scroll is now calculated differently, at a higher poll rate but not performed every loop, depending on the scroll speed
	- Fixed bug where scroll speed was dependent on cursor speed
	- Fixed bug in timers, so timer offset now works properly
	- Deadzone changes
		- Outer deadzone has its own variable and is independent of inner deadzone
		- Output now starts at 0% at the end of the innder deadzone, and goes to 100% at the edge of the outer deadzone
	- Added additional sounds for startup, powering off, and errors
	- Added watchdog implementation
	- Added safe mode accessible by Hub Buttons, or triggered during hardware error or watchdog
- Hardware changes
	- Ribs were added to the screw bosses on the LipSync Hub Top and LipSync Hub Bottom to increase strength
	- LipSync Mouthpiece was simplified
		- The updated mouthpiece is comprised of the same hydrophobic syringe filter, a Luer adapter, and a large silicone straw. This simplified design is easier to assemble, easier to clean, and has the added benefit of reducing the overall cost.
- Documentation updates
	- Maker Guide
		- TinyUSB library - can now use latest version (3.4.2)
		- Added additional assembly step to test joystick components before assembly into Joystick Gimbal and housing
	- User Guide
		- Updated to reflect changes to menu structure and full calibration process
		- Expanded troubleshooting with error messages
	- Created LipSync Firmware Upgrade Guide
	- Created LipSync Information Sheet

Version 4.0.2 | 2024-Dec-10
- Fixed bug related to sip and puff pressure calibration. 
	- Bug caused permanent sips or puffs if ambient pressure changed while sipping or puffing.

Version 4.0.1 | 2024-Apr-23
- Added instructions to use Tiny USB Library v2.3.0 to avoid startup error to Maker Guide.
- Software bug fixes 
	- Added timeout to menu screen
	- Added timeout to USB connection
	- Fixed lights bugs 

Version 4.0 | 2024-Feb-02
- Refined enclosure
- Full-featured firmware
	- USB Mouse, Wireless Mouse, USB Gamepad modes
	- Integrated display menu for settings adjustment
	- API settings adjustment
- Documentation released
	- User Guide
	- Maker Guide
	- Quickstart Guide
 	- BOM

Version 4.0.betaII | 2023-Dec-05
- Internal test build
	- prototype enclosures for Hub and Joystick units
- Basic mouse firmware
- Basic menu display
- Updated PCB layout
- Hub unit with feedback features
- joystick unit with sensors and rotational mounting

Version 4.0.beta | 2023-Nov-30
- Initial split architecture
	- PCB/microcontroller unit (Hub)
	- Joystick unit 
- Rebuilt 4 bearing gimbal
- Mouthpiece in-line with rotation center

Version 4.0.alphaII | 2022-Mar-31
- Full funcitonal system with magnet-based gimbal mechanism
- Enclosure with rotatable mounting feature
- Two-part custom PCB
- 3 neopixel LEDs for feedback
- 3 switch ports and on-device buttons for alterantive inputs
- User tested

Version 4.0.alphaI | 2021-Nov-30
- Initial gimbal-based magnetic joystick mechanism and sensor proof of concept
- 3 bearing gimbal
- Two-part custom PCB
- Mouthpiece axis offset from rotation axis

Version 3.0 - LipSync Classic | 2021-Sept-01
- Force sensitive resistor and spring based josytick
- Additional Bluetooth breakout board available to convert USB unit to wireless
- updated shell enclosure
- API settings adjustment
- Firmware settable mounting angle
