goforwest/LipSync/Build_Files/Firmware_Files/LipSync_Firmware/LipSync_Firmware.ino

/* 
* File: LipSync_Firmware.ino
* Firmware: LipSync
* Developed by: MakersMakingChange
* Version: v4.1 (28 March 2025)
  License: GPL v3.0 or later

  Copyright (C) 2024 - 2025 Neil Squire Society
  This program is free software: you can redistribute it and/or modify it under the terms of
  the GNU General Public License as published by the Free Software Foundation,
  either version 3 of the License, or (at your option) any later version.
  This program is distributed in the hope that it will be useful, but WITHOUT ANY WARRANTY;
  without even the implied warranty of MERCHANTABILITY or FITNESS FOR A PARTICULAR PURPOSE.
  See the GNU General Public License for more details.
  You should have received a copy of the GNU General Public License along with this program.
  If not, see <http://www.gnu.org/licenses/>
*/

#include <WString.h>
#include <Wire.h>
#include <FreeRTOS.h>  // 4.5.10: the BLE init task's static allocation (see setup)
#include <task.h>
#include "LSUtils.h"
#include "LSApiDeclarations.h"  // Explicit cross-tab declarations (roadmap item 5) — early so every tab sees them
#include "LSConfig.h"
#define LSTIMER_USE_SERIAL_TX_QUEUE 1  // Normal-context timer diagnostics share the line-safe CDC queue
#include "LSTimer.h"
#include <ArduinoJson.h>
#include "LSOutput.h"
#include "LSUSB.h"
#include "LSBLE.h"
#include "LSCircularBuffer.h"
#include "LSInput.h"
#include "LSPressure.h"
#include "LSJoystick.h"
#include "LSMemory.h"
#include "LSScreen.h"
#include "LSBuzzer.h"
#include "LSWatchdog.h"

// 4.9.1: the host-compiled classifier's state numbers are mirrored into the
// SAP action-table rows by hand (LSPressureClassify.h deliberately compiles
// without LSConfig.h, so the pin lives HERE, where both headers are
// visible) — the same static_assert treatment the release fraction already
// has in LSPressure.h. A silent renumber of either side would remap the
// hard sip/puff actions or route them to an inert row: the hard rows are
// the mobility-critical instant-DRAG/SCROLL path for users who cannot
// sustain holds.
static_assert(LSPRESSURE_CLASSIFY_NONE == PRESS_SAP_MAIN_STATE_NONE &&
              LSPRESSURE_CLASSIFY_SIP == PRESS_SAP_MAIN_STATE_SIP &&
              LSPRESSURE_CLASSIFY_PUFF == PRESS_SAP_MAIN_STATE_PUFF &&
              LSPRESSURE_CLASSIFY_HARD_SIP == PRESS_SAP_MAIN_STATE_HARD_SIP &&
              LSPRESSURE_CLASSIFY_HARD_PUFF == PRESS_SAP_MAIN_STATE_HARD_PUFF,
              "LSPressureClassify state numbers must mirror PRESS_SAP_MAIN_STATE_*");

// Unique ID
String g_deviceUID = "";  // Global variable for storing unique identifier for board

// Communication mode and debug mode variables
int g_comMode;        // 0 = None , 1 = USB , 2 = Wireless
int g_operatingMode;  // 0 = None, 1 = Mouse, 2 = Gamepad, 3 = Safe
int g_soundMode;      // 0 = None, 1 = Basic, 2 = Advanced // TODO 2025-Feb-05 Currently not used - buzzer.begin sets sound mode from memory
int g_lightMode;      // 0 = None, 1 = Basic, 2 = Advanced

int g_debugMode;  // 0 = Debug mode is Off
                  // 1 = Joystick debug mode is On
                  // 2 = Pressure debug mode is On
                  // 3 = Buttons debug mode is On
                  // 4 = Switch debug mode is On
                  // 5 = Sip & Puff state debug mode is On

int g_errorCode = 0;  // Global variable for storing error code. 0 is no error. Additional errors defined in LSConfig.h

uint32_t g_lastRebootReason = 0;
bool g_watchdogReset = false;
uint8_t g_watchdogBootCount = 0;  // Consecutive watchdog-reset boots (see LSWatchdog.h)
uint8_t g_hangBootStreak = 0;     // Consecutive TIMER3-witnessed loop-hang deaths (survives the SREQ resets via GPREGRET2 bits 0-1 — see checkResetReason)
bool g_usbRecoveryRestartedPrev = false; // True only on the immediate successor of the automatic USB-recovery reset
bool g_safeModeEnabled = false;
int  g_safeModeReason = 0;
bool readyToUseFirstTime = true;

bool g_btIsConnected = false;   // Bluetooth connection state

bool g_displayConnected = false;                   // Display connection state
bool g_joystickSensorConnected = false;            // Joystick sensor connection state
bool g_mouthpiecePressureSensorConnected = false;  // Mouthpiece pressure sensor connection state
bool g_ambientPressureSensorConnected = false;     // Ambient pressure sensor connection state

// LED module variables. Static storage avoids a boot-time heap allocation for
// an object that lives for the entire firmware lifetime.
ledStateStruct ledCurrentStateStorage = {0, 0, 0, 0, 0, 0};
ledStateStruct* const ledCurrentState = &ledCurrentStateStorage;
bool ledActionEnabled = false;

// Input module variables
int buttonActionSize, switchActionSize;
unsigned long buttonActionMaxTime, switchActionMaxTime;
inputStateStruct buttonState, switchState;

int inputButtonPinArray[] = { CONF_BUTTON1_PIN, CONF_BUTTON2_PIN };
int inputSwitchPinArray[] = { CONF_SWITCH1_PIN, CONF_SWITCH2_PIN, CONF_SWITCH3_PIN };

LSInput ib(inputButtonPinArray, CONF_BUTTON_NUMBER);  // Instance of input button object (tactile buttons on Hub)
LSInput is(inputSwitchPinArray, CONF_SWITCH_NUMBER);  // Create an instance of the input switch object (external switches)

inputStateStruct sapActionState;

int sapActionSize;
unsigned long sapActionMaxTime = 0;

// Timer related variables
int actionTimerId[8] = {-1, -1, -1, -1, -1, -1, -1, -1};  // Independent B1-B8 pulse-release timers
LSTimer<int> actionTimer;

int calibrationTimerId[2] = {-1, -1};  // 2 calibration timers: 0 - , 1-
LSTimer<int> calibrationTimer;

int pollTimerId[10] = {-1, -1, -1, -1, -1, -1, -1, -1, -1, -1};  // 9 poll timers — the CAPTURED ids (4.5.7 review): every enable/disable path must use these, not the CONF_TIMER_* constants; the two are equal only while every boot registration lands sequentially into an empty pool, and one refused registration or reorder away from the constants is disabling the WRONG feature's loop
LSTimer<void> pollTimer;

int ledTimerId[5] = {-1, -1, -1, -1, -1};  // LED timers 0 - startup feedback, 1 - IBM, 2- normal blinks, 3 - Bluetooth Status, 4 - error — -1 = none registered (4.5.7 review: zero-init made blinkLed's delete-before-rearm guard delete pool slot 0 on its first call)
LSTimer<ledStateStruct> ledStateTimer;

int usbConnectTimerId[1] = {-1};
LSTimer<int> usbConnectTimer;
static void usbConnectRearm(unsigned long delayMs);  // 4.6.6: delete-before-arm one-shot re-arm — defined before usbCheckConnection; called from setup() (no Arduino auto-prototype reliance, the 4.3.0 discipline)

unsigned int g_usbConnectDelay = CONF_USB_HID_INIT_DELAY;
unsigned long g_usbNotReadySinceMs = 0;  // When the current HID-not-ready stretch began; 0 = none in progress
unsigned int g_usbReenumCount = 0;        // Forced re-enumerations spent on the current episode
unsigned long g_watchdogLastFeedMs = 0;   // Loop-liveness witness (bench 2026-10-18): ms timestamp of the last watchdog feed
volatile bool g_watchdogArmed = false;   // True from initWatchdog() until the retry limit stops re-arming (ISR-read by the TIMER3 witness — 4.5.7 review)
// The USB-recovery auto-restart once-guard: a full chip reset is the one cure
// that has cleared every configured-but-HID-dead boot on the bench
// (2026-10-17: a wedge survived all three forced re-enumerations), but an
// automatic restart must never loop. (4.9.0 review: this block formerly
// described a .noinit word written with CONF_USB_RESTART_MAGIC — both the
// macro and the mechanism are GONE: the bench proved .noinit does not
// survive resets on this platform, and the guard lives in the retention
// marker CONF_RETENTION_MARKER_USB_RECOVERY / g_usbRecoveryRestartedPrev
// since witness v5. Do not resurrect the .noinit word.)
// WITNESS v4 + PLATFORM FIX (bench 2026-10-23): the .noinit section DOES NOT
// survive resets on this platform — the bench proved it (every soft-reset and
// watchdog boot read boot#1/ptrail=0 back; the map places the section at
// 0x20007bac but its content is zeroed by the time the next boot's setup()
// runs — the bootloader/core scrubs it). Every cross-reset word therefore
// moves to the nRF52 POWER RETENTION REGISTERS, which survive every warm
// reset and clear only on cold power-on. (4.9.0 review: the v4 bit-map block
// below was removed — it mapped GPREGRET2 bits 8-31 to trail/USB-guard/boot
// counter, a layout the register does not have; witness v5 corrected it
// (GPREGRET2 is 8 bits wide) and v7 is the live record of the real layout.
// A future contributor reading only v4 would have written fields into
// unimplemented bits and silently lost them.)
// WITNESS v5 (bench 2026-10-23): the platform offers NO reliable cross-reset
// storage — the retention register GPREGRET2 is 8 bits wide (SVD: only bits
// 0-7 implemented; the 4.2.0 watchdog counter lives there), GPREGRET belongs
// to the bootloader's DFU magic, and the .noinit section is wiped by the
// boot path (the map even shows its orphan placement straddling
// __bss_start__, so most of it lands inside the bss-clear loop). The trail
// is therefore a plain RAM byte, printed live by the HB line: for a freezing
// boot, the LAST PRINTED trail names the site the loop died at. Cross-reset
// questions are answered by rst= (the nRF52 RESETREAS register — the one
// reset fact that does survive).
// WITNESS v7 (bench 2026-10-23): the freeze's CPU does NOT hardfault (the
// Seeed core's HardFault_Handler is an instant NVIC_SystemReset — a fault
// would read rst=0x4 on the next boot; every freeze successor reads rst=0x2,
// the 30-s watchdog: the CPU is SPINNING, not faulting) — and every bounded
// wait in the Wire/Tone/HardwarePWM paths checks out, so the spin site is
// somewhere no witness has survived to report: RAM dies at the reset. The
// trail therefore moves into the retention register's spare bits
// (GPREGRET2 bits 5-7 — the watchdog counter only needs bits 0-1): the last
// 3-bit milestone a dying boot stamped SURVIVES the watchdog reset, and the
// next boot prints it as pt=. Trail codes (3 bits): 1 setup-done, 2
// safeModePage, 3 safeMenu, 4 LED action, 5 softwareReset, 6
// usbCheckConnection.
uint8_t g_bootTrailPrev = 0;  // The DEAD boot's last trail code (read from retention at setup)
uint8_t g_hangMarkerPrev = 0;  // The DEAD boot's hang-witness marker (retention bits 2-4)
volatile bool g_shutdownInProgress = false;  // witness v9: softwareReset's deliberate blocking shutdown is NOT a hang — the witness exempts it
// (4.5.7 review) Seconds since the loop last fed the watchdog, counted BY
// THE WITNESS ITSELF: the old ISR called millis() (a FreeRTOS xTaskGetTickCount
// read — unsupported use at interrupt priority 0) and read non-volatile
// globals shared with loop context. The counter is a single aligned volatile
// word: the ISR increments it on every 1 s tick, watchdogLoop() (loop
// context) writes it back to 0 on every feed — a 32-bit aligned store/load
// is atomic on the ARM, so the worst case of the race is one tick of lag.
// >3 consecutive un-fed seconds (counter reaches 4) is a loop hang.
volatile uint32_t g_witnessSecondsUnfed = 0;
// 4.5.27 (Fable 5.1 consult): these were RAW POWER-peripheral writes — the
// SoftDevice's watch unit flags every one with the SD up (APP_MEMACC, the
// root cause of the entire 4.5.6-4.5.26 BLE death saga: the stamps were the
// killer, the "death sites" the stamps named were the stamp's own callers).
// Both now route through the SD-aware helper: the SVC path with the stack
// up, the raw write when it is down.
uint8_t readTrailByte()            { return (lipsyncRetentionGet(1) >> 5) & 0x07; }
void writeTrailByte(uint8_t step)  {
  // 4.6.6: inside the Bluefruit.begin() window the SD is already enabled but
  // g_softDeviceEnabled cannot be true yet (raising it early would send SD
  // SVCs into the core's FreeRTOS SVC trampoline with the SD down — worse
  // than the fault). The loop task runs time-sliced with the 16 KB init
  // task, so a pt=4 (LED action) or pt=7 (serial dispatch) stamp landing in
  // that window would take the RAW GPREGRET path with the SD up — the exact
  // APP_MEMACC death 4.5.27 eliminated. Stamps are pure forensics: skip the
  // write for the sub-second window; every post-init path stamps normally.
  if (lipsyncRetentionUnsafe()) return;
  lipsyncRetentionUpdate(1, 0xE0, (uint8_t)((step & 0x07) << 5));
}

// WITNESS v8 — THE HANG WITNESS (bench 2026-10-23): this round proved the
// freeze ends in a WATCHDOG reset that WIPES GPREGRET2 (every freeze
// successor read pt=0 while the dead boot demonstrably stamped trail=1/3;
// SREQ resets preserve it — pt=5 survived every SR). So the freeze's death
// site could never be reported. This converts the freeze's silent DOG death
// into an SREQ the trail survives: TIMER3 (free — the core only touches
// TIMER2 read-only for the bootloader version) fires an interrupt every
// second and watches the loop's watchdog feed stamp — the loop pass
// refreshes it on every iteration. If the loop hangs for >3 s, the IRQ
// writes a hang marker into retention bits 2-4 and resets via
// NVIC_SystemReset (SREQ): the trail bits 5-7 SURVIVE, the next boot prints
// pt= (the last milestone the dead boot stamped) and pm=1 (hang witnessed),
// and the bench cycle drops from 30 s to ~4 s. If the hang instead masks
// interrupts, the IRQ never fires and the hardware DOG still ends it
// (pt=0) — that split (pm=1 vs pm=0) is itself decisive: IRQs-live hang vs
// IRQs-masked hang.
//
// 4.5.13: declared up here because initHangWitness() reads it at ARM time.
// A BLE boot has the SoftDevice enable still PENDING when the witness arms
// (the init task starts at the very END of setup), so the witness must
// take an SD-legal priority from the start — see the priority note in the
// body below. g_bleInitPending is set by beginComOpMode long before this
// point in setup.
static volatile bool g_bleInitPending = false;   // a BLE boot deferred its init to the task
void initHangWitness() {
  NRF_TIMER3->MODE = TIMER_MODE_MODE_Timer << TIMER_MODE_MODE_Pos;
  NRF_TIMER3->BITMODE = TIMER_BITMODE_BITMODE_32Bit << TIMER_BITMODE_BITMODE_Pos;
  NRF_TIMER3->PRESCALER = 9;                       // 16 MHz / 512 = 31.25 kHz
  NRF_TIMER3->CC[0] = 31250;                       // 1 s
  NRF_TIMER3->SHORTS = TIMER_SHORTS_COMPARE0_CLEAR_Enabled << TIMER_SHORTS_COMPARE0_CLEAR_Pos;
  NRF_TIMER3->INTENSET = TIMER_INTENSET_COMPARE0_Msk;
  // witness v9 + bench fix: HIGHEST priority — a hang that still blocks it
  // can only be PRIMASK-level masking. BUT the SoftDevice reserves specific
  // priority levels when it is enabled, and the bench (2026-10-26, rounds
  // 8-11) pinned the ACTUAL reserved set for this S140 6.1.1 to {0, 1, 4} —
  // the core's own TinyUSB port states it verbatim ("Priorities 0, 1, 4
  // (nRF52) are reserved for SoftDevice"), the stock example passes the
  // SDM's enable check with USBD at priority 2, and every failing BLE boot
  // in the hunt had an enabled interrupt at exactly 4 — including this
  // witness itself, whose 4.5.13 move to 4 (based on the WRONG "app-legal
  // = 4-7" model) blocked sd_softdevice_enable with 0x1001 on every BLE
  // boot since 4.5.10, when the BLE init moved AFTER the witness arms.
  // Priority 7 is legal under BOTH models (classic 4-7 and the confirmed
  // {0,1,4}-reserved). MASKING TRUTH (4.8.1 comment fix): a FreeRTOS
  // critical section at BASEPRI=2 DOES mask numeric priorities >= 2 — a
  // hang inside a held critical section is unwitnessed and dies on the
  // 30 s hardware DOG (pt=0) instead of the ~4 s witnessed SREQ; the
  // witness's pm=1/pm=0 split still names which class happened. What
  // priority 7 guarantees is preemption of any ordinary thread-mode hang
  // (BASEPRI = 0 there) — the witness's actual job — plus legality under
  // both priority models. USB-only boots (SD never comes up) keep priority
  // 0 for the freeze hunt — 4.9.1: the leftover-SD USB boot (the
  // bootloader-left-the-SoftDevice-up state this file seeds
  // g_softDeviceEnabled from the chip for) must NOT take priority 0: its
  // retention writes route through the SD's SVCs, and an SVC cannot
  // preempt an exception at equal priority — the hang marker would pend
  // behind the ISR's own NVIC_SystemReset() and never land, the successor
  // read pm=0/streak-cleared, and the 3-strike hang settle became an
  // unbreakable ~4 s SREQ loop (strictly worse than the 30 s DOG cycle it
  // replaces). The SD-up chip state is the decider, not the com mode.
  NVIC_SetPriority(TIMER3_IRQn, (needsInitialization && !g_bleInitPending && !g_softDeviceEnabled) ? 0 : 7);
  NVIC_ClearPendingIRQ(TIMER3_IRQn);
  NVIC_EnableIRQ(TIMER3_IRQn);
  NRF_TIMER3->TASKS_START = 1;
  g_witnessSecondsUnfed = 0;
}
extern "C" void TIMER3_IRQHandler(void) {
  NRF_TIMER3->EVENTS_COMPARE[0] = 0;
  // Counter-based hang detection (4.5.7 review — see g_witnessSecondsUnfed):
  // no millis() call, no non-volatile reads; the only loop-context writer is
  // watchdogLoop()'s reset. 4 consecutive un-fed seconds = the loop stalled
  // past 3 s with interrupts alive.
  if (!g_shutdownInProgress && g_watchdogArmed && ++g_witnessSecondsUnfed >= 4) {
    // 4.6.6: inside the Bluefruit.begin() window neither retention path is
    // safe (see lipsyncRetentionUnsafe) — skip the marker write; the reset
    // itself (SREQ) still fires and the DOG/watchdog successor boots still
    // settle the streak. A witness fire during the init window requires a
    // >3 s loop stall while begin() runs, which the init task's separate
    // stack and priority make effectively unreachable — this gate is
    // belt-and-braces so the marker can never be the MEMACC trigger.
    if (!lipsyncRetentionUnsafe()) {
      lipsyncRetentionUpdate(1, 0x1C, (uint8_t)(CONF_RETENTION_MARKER_HANG << 2));  // SD-aware marker write; trail bits preserved
    }
    NVIC_SystemReset();  // SREQ — retention survives; the next boot reports pt=/pm=
  }
}

// Live boot trail (witness v7, 4.5.7 review reconciliation) — ONE table,
// the one the stamps actually use. 3 bits, codes 1-7:
//   1  memory up                     (stamped immediately after initMemory()
//                                      returns — 4.9.0: the stamp MOVED from
//                                      the end of setup() and is now
//                                      unconditional, so a hang in the
//                                      mount/seed or beginComOpMode names
//                                      itself instead of reading pt=0)
//   2  safeModePage drawing           (LSScreen::safeModePage)
//   3  safe-mode menu registered      (LSScreen::safeModeMenu)
//   4  LED action running             (performLedAction)
//   5  softwareReset starting         (softwareReset — menu/serial/confirm resets)
//   6  usbCheckConnection running     (its entry stamp; the USB one-shot
//                                      restart resets from INSIDE this
//                                      context, so pt=6 names it truthfully
//                                      and pt=5 stays unambiguous)
//   7  serial command dispatching     (processSerialMessage — stamped when
//                                      a real message is handled, not on
//                                      every idle loop pass, so pt=7 names
//                                      an actual dispatch site)
// pt=0 means the dead boot never stamped (a pre-setup death).
void bootTrailStamp(uint8_t step) {
  writeTrailByte(step);
}

// 4.5.23 — THE FAULT DISCRIMINATOR (bench round 16: the BLE init now FULLY
// SUCCEEDS — st=5, pst=5, advertising runs — and the boot dies a few seconds
// AFTER it: ~0.3 s after the host opens the port (pt=7, serial dispatch) or
// within ~10-15 s idle (pt=4, an LED action), always rst=0x4 with pm=0. The
// remaining hunt splits on one question the stock core cannot answer: its
// HardFault_Handler is a WEAK spin-loop (.S) and the SoftDevice's assert
// path resets the chip itself — both read identically (rst=0x4, no marker).
// This override captures the fault: the class marker (retention bits 2-4 =
// 2, reading back as pm=2 — bit 3, the unused half of the marker nibble)
// names "a HARDFAULT killed the previous boot" on the next boot's wire;
// pm=1 keeps its meaning (witnessed hang); pm=0 + a dead BLE boot now means
// "SD assert / non-HardFault reset" by elimination. The capture ALSO
// encodes the faulting PC's 8 KB flash page into GPREGRET (0xC0|page —
  // values 0xC0-0xFF collide with none of the bootloader's DFU magics
// 0x4e/0x57/0xa8; the SD exposes GPREGRET set only via SVC, so the write is
// best-effort from fault context — if the SD eats it or the bootloader
// clears it, only the location is lost, never the class). The successor
// prints it as fp=0x<page-base>. A best-effort serial print of the frame
// is attempted first (usually lost — interrupts are masked in the fault)
// because a live port is exactly the death trigger the bench observed.
volatile uint32_t g_faultFramePc = 0;
volatile uint32_t g_faultFrameLr = 0;
volatile uint32_t g_faultHfsr = 0;
volatile uint32_t g_faultCfsr = 0;
uint8_t g_faultPrevPage = 0xFF;  // the PREVIOUS boot's fault PC page (0xFF = none) — consumed from GPREGRET at setup

extern "C" __attribute__((used, noinline)) void lipsyncFaultCapture(uint32_t* frame, uint32_t hfsr, uint32_t cfsr);
extern "C" __attribute__((used, noinline)) void lipsyncFaultCapture(uint32_t* frame, uint32_t hfsr, uint32_t cfsr) {
  g_faultFramePc = frame[6];  // the stacked PC — the faulting instruction
  g_faultFrameLr = frame[5];  // the stacked LR — the caller
  g_faultHfsr = hfsr;
  g_faultCfsr = cfsr;
  // class marker: retention bits 2-4 = value 2 (bit 3) — reads back as pm=2.
  // The hang witness uses value 1 (bit 2); they cannot both occur in one
  // boot (a hang needs the loop ALIVE, a fault kills it). checkResetReason
  // treats any nonzero marker as streak-worthy — correct here too: three
  // straight fault deaths SHOULD settle in safe mode.
  // RAW, deliberately (4.5.27): SVCs are impossible at fault priority, and
  // the SD's watch unit is a WATCH — the write itself completes, the
  // violation is only reported afterwards, and we reset 100 ms later anyway.
  NRF_POWER->GPREGRET2 = (NRF_POWER->GPREGRET2 & ~0x1CUL) | ((uint32_t)CONF_RETENTION_MARKER_HARDFAULT << 2);
  // location: the faulting PC's 8 KB flash page into GPREGRET (best-effort —
  // see the header note). The app's flash spans 0x26000-0x75000, so
  // (pc >> 13) fits in 6 bits across the whole nRF52840 flash. The previous
  // 4-bit mask aliased app pages 0x26000+ into the SoftDevice range and made
  // fp= point at the wrong module. 0xC0 marks the record; low 6 bits retain
  // the complete 8 KB page index.
  NRF_POWER->GPREGRET = 0xC0UL | ((g_faultFramePc >> 13) & 0x3FUL);
  // Best-effort, strictly non-blocking print. Adafruit_USBD_CDC::write()
  // otherwise yields forever when DTR is up but the host is not draining;
  // fault context must always reach the reset. The retention markers above
  // remain authoritative when the whole line does not fit immediately.
  char faultLine[80];
  int faultLen = snprintf(faultLine, sizeof(faultLine),
                          "FAULT pc=%lx lr=%lx cfsr=%lx\n",
                          (unsigned long)g_faultFramePc,
                          (unsigned long)g_faultFrameLr,
                          (unsigned long)g_faultCfsr);
  if (faultLen > 0 && faultLen < (int)sizeof(faultLine) &&
      Serial.availableForWrite() >= faultLen) {
    Serial.write((const uint8_t*)faultLine, (size_t)faultLen);
    Serial.flush();
  }
  for (volatile uint32_t i = 0; i < 2000000; i++) { }  // ~100 ms dwell for any already-buffered CDC byte to drain
  NVIC_SystemReset();  // SREQ — retention + GPREGRET survive (or the bootloader clears GPREGRET; the class marker survives regardless)
  while (1) { __WFE(); }          // never returns; do not call RTOS delay() from fault context
}

// The strong override of the core's weak (.S) spin-loop handler. Naked: the
// exception frame is still on the stack; select MSP or PSP per EXC_RETURN
// bit 2 and branch to the capture with the frame pointer in r0.
extern "C" __attribute__((naked)) void HardFault_Handler(void);
extern "C" __attribute__((naked)) void HardFault_Handler(void) {
  __asm volatile (
    "tst   lr, #4              \n"  // EXC_RETURN bit 2: 0 = main stack (ISR context), 1 = process stack (task context)
    "ite   eq                  \n"
    "mrseq r0, msp             \n"
    "mrsne r0, psp             \n"
    "ldr   r1, =0xE000ED2C     \n"  // SCB->HFSR
    "ldr   r2, =0xE000ED28     \n"  // SCB->CFSR
    "ldr   r1, [r1]            \n"
    "ldr   r2, [r2]            \n"
    "b     lipsyncFaultCapture \n"
  );
}

// 4.5.10 BENCH FIX — the BLE init task. The core's loop task (which runs
// setup() and loop()) has a hardcoded 4096-byte stack and configCHECK_FOR_
// STACK_OVERFLOW=1 (mode 1 — misses overflow-and-return), and the BLE boot's
// only-in-that-path call depth (Bluefruit.begin: SoftDevice enable, GATT
// table, HID service, advertising assembly — kilobytes) silently corrupted
// it: a delayed HardFault at ~2.6-4 s into the boot (rst=0x4, pm=0, pt=4 —
// after the boot-center LED stamps, around readyToUse and the first
// btmouse.move), instant reset, infinite BLE boot loop. The gamepad boot
// (no Bluefruit.begin) worked perfectly on the same bench session. The BLE
// init now runs on its own task with a 16 KB static stack, started at the
// end of setup; every BLE call site in the loop is guarded so the pre-init
// window is a no-op window, not a fault window.
volatile int g_bleInitStage = 0;                 // 4.5.11: init-task progress/failure stage (see LSApiDeclarations.h)
volatile int8_t g_bleSdWasEnabled = -1;          // 4.5.13: the init task's SD probe: -1 = not probed yet, 0 = the SoftDevice was down (normal), 1 = it was ALREADY enabled when the app started (bootloader leftover — see LSBLE.h)
volatile bool g_softDeviceEnabled = false;      // 4.5.27: THE SoftDevice is up (set right after Bluefruit.begin() succeeds) — every retention-register access routes through the SD SVCs while this is true; see LSApiDeclarations.h
volatile bool g_bleInitWindow = false;          // 4.6.6: the BLE init task raises this for the duration of Bluefruit.begin() — see lipsyncRetentionUnsafe() in LSApiDeclarations.h
volatile uint8_t g_bleProbeStep = 0;             // 4.5.14: the begin()-mirror probe's first failing call (0 = not run/non-BLE, 1..10 = that call failed, 11 = all passed) — see LSBLE.h
volatile uint32_t g_bleProbeCode = 0;            // 4.5.14: the failing call's SoftDevice error code (0 = none)
volatile uint32_t g_bleProbeNeed = 0;           // 4.5.14: sd_ble_enable's required app RAM base (on NO_MEM, the smoking gun vs 0x20006000)
TaskHandle_t g_loopTaskHandle = NULL;             // 4.5.26: the loop task's handle (captured at setup entry — the loop task runs setup) for the stack high-water print
volatile UBaseType_t g_loopStackHwm = 0;
bool g_bootReportWorthy = false;                  // 4.5.29: computed at setup — true only when the PREVIOUS boot ended abnormally (witness marker, captured fault page, failed BLE init, or lockup). The first-host-byte BOOT report prints only when this is set; healthy boots are SILENT (the released wire contract, restored)
bool g_comModeHealedThisBoot = false;             // 4.8.7 review: setup's gamepad+Bluetooth heal fired — the correction must reach the wire (the in-place Serial.println ran pre-attach, inside TinyUSB's pre-open-port discard window, so no host ever saw it); the first-host-byte report block emits the named line           // 4.5.26: the loop task's minimum-ever free stack (FreeRTOS words, 4 bytes each) — printed as sw= on the wire; near-zero on BLE boots = the 4 KB loop stack is overflowing into the heap
volatile uint32_t g_bleInitRc = 0;              // 4.5.19 (expert consult): the RAW err_t from the failing DIS/HID begin — sd_ble_gatts_service_add's own code on the st=2 path (0x4=NO_MEM, 0x7=INVALID_PARAM, 0xF=FORBIDDEN, 0x10=INVALID_ADDR)
volatile uint32_t g_bleIrqBad1 = 0;              // 4.5.15: pre-demotion mask of enabled IRQs 0-31 found at an SD-reserved priority (< 4) at BLE-init time (bit = IRQ number)
volatile uint32_t g_bleIrqBad2 = 0;              // 4.5.15: the same mask for IRQs 32-47
volatile uint8_t g_bleProbeDemoted = 0;          // 4.5.15: how many the sweep demoted to 4 before the enable
volatile int8_t g_blePrevSt = -1;                 // 4.5.20: the PREVIOUS BLE boot's flash-persisted init verdict (-1 = none, 0 = died DURING begin, 1..4 = failed at that stage, 5 = init fully succeeded) — read+consumed from /bleverdict.dat at boot
volatile uint16_t g_blePrevRc = 0;                // 4.5.20: that boot's DIS/HID raw error code
static volatile bool g_bleInitDone = false;       // the task finished (success or failure)

// 4.5.20/4.5.21 — BLE-VERDICT PERSISTENCE (the reset-proof capture): the
// BLE boots of rounds 13+ die faster than the host can open the port, so
// st=/rc=/pstep= were being lost with the boot itself. The verdict goes to
// the settings filesystem (which survives resets), and the next boot prints
// it as pst=/prc= and consumes the file.
//
// 4.5.21 REGRESSION FIX — THE BLE TASK NO LONGER TOUCHES THE FILESYSTEM. The
// 4.5.20 shape called bleVerdictPersist() from the init task, which opened
// LSMEMORY.h's ONE GLOBAL shared File handle concurrently with the loop
// task's settings writes — two FreeRTOS tasks sharing one stateful handle
// clobbered each other's file state and corrupted the settings file (bench
// round 14: after a CM,1:2 cycle the survivor read IN=0.00|0.00 CA=0.00|0.00
// CM=1 — the re-seed signature; the calibration was wiped and the mode
// reverted to the compiled default). The task now only raises a flag; the
// LOOP — which already owns every other FS operation, all sequential —
// performs the persist. All filesystem access is single-threaded again, and
// the verdict ride survives. The entry record still lands well before
// begin() finishes (the loop services the flag within milliseconds).
// 8-byte record with magic headers both ends: a torn write fails the magic
// check and reads as absent.
static const char* const BLE_VERDICT_FILE = "/bleverdict.dat";
static const char* const BLE_VERDICT_TMP_FILE = "/bleverdict.tmp";
volatile bool g_bleVerdictDirty = false;  // raised by the init task, serviced by the loop — the ONLY cross-task handoff (no FS access off-loop)
void bleVerdictPersist() {  // LOOP-CONTEXT ONLY (see the 4.5.21 note above)
  File verdictFile(InternalFS);  // its own handle — never the shared settings object
  InternalFS.remove(BLE_VERDICT_TMP_FILE);
  delay(1);
  if (verdictFile.open(BLE_VERDICT_TMP_FILE, FILE_O_WRITE)) {
    uint8_t rec[8] = { 0xB5,
                       (uint8_t)g_bleInitStage,
                       (uint8_t)g_bleProbeStep,
                       (uint8_t)(g_bleSdWasEnabled & 0xFF),
                       (uint8_t)(g_bleInitRc & 0xFF),
                       (uint8_t)((g_bleInitRc >> 8) & 0xFF),
                       g_bleProbeDemoted,
                       0xA5 };
    const size_t written = verdictFile.write(rec, sizeof(rec));
    delay(1);
    verdictFile.close();
    if (written == sizeof(rec)) {
      if (!InternalFS.rename(BLE_VERDICT_TMP_FILE, BLE_VERDICT_FILE)) {
        InternalFS.remove(BLE_VERDICT_TMP_FILE);
      }
    } else {
      InternalFS.remove(BLE_VERDICT_TMP_FILE);
    }
  }
}
void bleVerdictConsume() {
  g_blePrevSt = -1;  // absent until proven present
  g_blePrevRc = 0;
  File verdictFile(InternalFS);  // its own handle — never the shared settings object (the 4.5.21 single-task-FS rule)
  if (verdictFile.open(BLE_VERDICT_FILE, FILE_O_READ)) {
    uint8_t rec[8];
    const size_t n = verdictFile.read(rec, sizeof(rec));
    verdictFile.close();
    if (n == sizeof(rec) && rec[0] == 0xB5 && rec[7] == 0xA5) {
      g_blePrevSt = (int8_t)rec[1];
      g_blePrevRc = (uint16_t)rec[4] | ((uint16_t)rec[5] << 8);
    }
    InternalFS.remove(BLE_VERDICT_FILE);  // one-shot: the verdict describes the immediately-previous boot only
  }
}
static char g_bleDeviceName[CONF_BLE_DEVICE_NAME_SZ] = {0};  // the advertising name (static: outlives setup's frame)
static StackType_t g_bleInitStack[CONF_BLE_INIT_TASK_STACK_BYTES / sizeof(StackType_t)];
static StaticTask_t g_bleInitTCB;
static volatile bool g_hostHasSpoken = false;     // 4.5.10: the repeating boot header stops at the first host byte

// Joystick module variables and structures
int acceleration = 0;
int g_scrollLevel = 0;
uint32_t g_scrollNumRuns = 0;  // unsigned wrap is defined for long-lived scroll sessions

int outputAction;
bool canOutputAction = true;
int g_outputHoldInputClass = -1;  // Input class that owns the active drag/scroll latch
// 4.5.7 bench fix: the hold duration (ms) of the input that is CURRENTLY
// dispatching, for selectMenuItem's hold-to-confirm gate on the destructive
// rows. Set fresh on every evaluateOutputAction pass (0 = no input in
// flight — a stale value can never leak into a later decision), set from
// the releasing input's elapsed right before performOutputAction, and set
// to "always pass" by the serial CH,1 path (no hold concept on the wire).
unsigned long g_menuInputHoldMs = 0;
bool g_startupCenterReset = true;
bool g_resetCenterComplete = false;  // global variable for center reset status
bool g_centerRunning = false;        // center sample buffer/timer ids are shared; serialize center and full-calibration flows
bool g_calibrationError = false;     // Global variable for error in full calibration
bool g_calibrationRunning = false;   // 4.5.7 review: a full-calibration chain is in flight — CA,0/EX reads must not overwrite the accumulating corner slots (see getJoystickCalibration)
bool g_calibrationCenterStep = false;  // 4.5.7 review: the calibration chain's OWN internal step-5 center is starting (synchronous bypass for the center-flow in-flight gate — both chains share the calibrationTimerId[] variables, so a concurrent center would clobber the corner reading-timer id and silently drop the corner's persistence + ack)

bool settingsEnabled = false;  // Serial input settings command mode enabled or disabled

// Input restriction state (roadmap item 11) — loaded from the stored settings
// by initRestrictions(); the serial API setters keep them live.
bool g_sapDisabled = false;        // SD — sip & puff inputs cannot fire actions
bool g_menuButtonsOnly = false;    // MA — only the hub buttons may control the menu
bool g_modeLocked = false;         // LK — inputs cannot change the operating mode
bool g_freezeCursorDuringSap = false;  // CF — cursor output freezes while a sip/puff is in progress

// Input timing windows (roadmap item 15, upstream #62/#9) — stored 0 means
// the compiled default; the getters/setters keep these live. These are the
// STORED values; effectiveWindowMs() maps them onto the action tables.
unsigned long g_inputWindowShortMs = 0;  // WS — short | long boundary
unsigned long g_inputWindowLongMs = 0;   // WL — long | very-long boundary
unsigned long g_inputWindowMaxMs = 0;    // WM — very-long boundary

// External switch action remapping (roadmap item 11's #20 follow-up,
// firmware 4.5.0): the live copy of switchActionProperty the input loop
// evaluates against. initInput() seeds it from the compiled table and
// initSwitchActions() (called from initRestrictions, with the other
// input-related stored settings) overlays any stored remaps — so a device
// with no stored mapping (every settings file written by older firmware)
// behaves byte-for-byte like the compiled table.
inputActionStruct g_switchActionTable[sizeof(switchActionProperty) / sizeof(inputActionStruct)];

// Upstream #58: live SAP action table. initSapActions() (called from
// initRestrictions, with the other input-related stored settings) seeds it
// from the compiled sapActionProperty and overlays the hard-band action
// overrides (HA/HB) — a settings file written by older firmware has no
// HA/HB keys, so the live table stays byte-identical to the compiled table
// (no behavioral change for existing users).
inputActionStruct g_sapActionTable[sizeof(sapActionProperty) / sizeof(inputActionStruct)];

// Timing Variables for Debugging
unsigned long beginMillis;
unsigned long beforeComOpMillis;
unsigned long afterComOpMillis;


// Create instances of classes
LSMemory mem;     // Create an instance of LSMemory for managing flash memory.
LSJoystick js;    // Create an instance of the LSJoystick object
LSPressure ps;    // Create an instance of the LSPressure object
LSOutput led;     // Create an instance of the LSOutput LED object
LSScreen screen;  // Create an instance of the LSScreen Object for OLED Screen
LSBuzzer buzzer;  // Create an instance of the LSBuzzer Object

LSUSBMouse usbmouse;   // Create an instance of the USB mouse object
LSBLEMouse btmouse;    // Create an instance of the BLE mouse object
LSUSBGamepad gamepad;  // Create an instance of the USB gamepad object


//***BLE INIT TASK BODY***//
// Function   : bleInitTaskBody
//
// Description: Runs the full BLE stack bring-up (btmouse.begin ->
//              initializeBluefruit: SoftDevice enable, DIS, HID, advertising)
//              on a 16 KB static stack instead of the loop task's 4 KB.
//              On failure the failing stage's BOOT line has already printed
//              (initializeBluefruit checks every begin()); needsInitialization
//              stays true and every guarded call site stays inert. The task
//              suspends itself — it never returns.
static void bleInitTaskBody(void* arg) {
  (void)arg;
  btmouse.begin(g_bleDeviceName);
  g_bleInitDone = true;               // completion flag first...
  if (needsInitialization) {          // ...then the verdict (true = a stage failed)
    if (USB_DEBUG) { Serial.println(F("BOOT: BLE task FAILED (see stage line above)")); }
  } else {
    if (USB_DEBUG) { Serial.println(F("BOOT: BLE task up")); }
  }
  vTaskSuspend(NULL);  // a FreeRTOS task must never return
}

//***MICROCONTROLLER AND PERIPHERAL CONFIGURATION***//
// Function   : setup
//
// Description: This function handles the initialization of variables, pins, methods, libraries. This function only runs once at powerup or reset.
//
// Parameters :  void
//
// Return     : void
//*********************************//
void setup() {
  g_loopTaskHandle = xTaskGetCurrentTaskHandle();  // 4.5.26: the loop task runs setup — capture its handle for the stack high-water print
  initGlobals();  //  Intialize global variables to default values
  // 4.6.6: seed the SD-up flag from the chip itself BEFORE the first
  // retention access. checkResetReason() below writes through the SD-aware
  // helper, and on the bootloader-leftover-SD boot (the sd=1 case the 4.5.13
  // guard exists for) initializeBluefruit never runs on a USB-only boot —
  // the flag would stay false for the whole session and every stamp would
  // take the raw GPREGRET path with the SD up. sd_softdevice_is_enabled is
  // the MBR-serviced SVC that is legal in every state (LSBLE.h probes it the
  // same way); from setup's thread mode it is the canonical context.
  {
    uint8_t sdUpAtEntry = 0;
    (void) sd_softdevice_is_enabled(&sdUpAtEntry);
    g_softDeviceEnabled = (sdUpAtEntry != 0);
  }
  checkResetReason();  //  Check reason for reset and reset the reset-reason register

  // Witness v7: capture what the DEAD boot last stamped (survives the reset
  // in the retention register), then start this boot's trail.
  g_bootTrailPrev = readTrailByte();
  g_hangMarkerPrev = (lipsyncRetentionGet(1) >> 2) & 0x07;
  lipsyncRetentionUpdate(1, 0x1C, 0);  // consume the marker — one hang reports once (4.5.27: SD-aware)
  // Marker 3 is a deliberate USB-recovery reset, not an abnormal boot. Its
  // boolean guard was captured by checkResetReason(); suppress it from the
  // crash report while retaining the one-shot decision for this whole boot.
  if (g_hangMarkerPrev == CONF_RETENTION_MARKER_USB_RECOVERY) {
    g_hangMarkerPrev = 0;
  }
  // 4.5.23: consume the previous boot's HardFault PC page (written by
  // lipsyncFaultCapture into GPREGRET; 0xC0|page — see the discriminator
  // note above the handler). Absent/cleared → 0xFF = "no fault recorded".
  const uint32_t faultReg = lipsyncRetentionGet(0);
  if ((faultReg & 0xC0UL) == 0xC0UL) {
    g_faultPrevPage = (uint8_t)(faultReg & 0x3FUL);
    lipsyncRetentionUpdate(0, 0xFF, 0);  // consume — one fault reports once (4.5.27: SD-aware)
  } else {
    g_faultPrevPage = 0xFF;
  }
  writeTrailByte(0);

  // 4.5.29 — THE CONDITIONAL BOOT REPORT (release hygiene, restoring the
  // "healthy boots print nothing" wire contract the 4.5.9-4.5.12 bench
  // instruments deliberately broke "until the BLE boot is bench-cleared" —
  // it now is). The first-host-byte BOOT line prints ONLY when the previous
  // boot ended abnormally; every normal flow (power-on, reset pin, the
  // deliberate software resets of CM/OM/SR/menu/UM) is silent. The
  // abnormal classes, each covered by a surviving signal:
  //   - a witnessed loop hang or a captured HardFault → the retention
  //     marker (pm) is nonzero;
  //   - an SD assert or our fault capture → the fault page (fp) is present;
  //   - a failed BLE init → the persisted verdict (pst) is 0..4;
  //   - a LOCKUP reset → the RESETREAS lockup bit (no capture exists for
  //     this class — the bit itself is the report);
  //   - a watchdog reset → already boots safe mode → the HB line reports it.
  // If a future death class leaves none of these, it stays silent by design
  // — silence IS the contract, and the degradation that matters (a dead or
  // broken boot) always has the HB line or this report.
  g_bootReportWorthy = (g_hangMarkerPrev != 0)
                     || (g_faultPrevPage != 0xFF)
                     || (g_blePrevSt >= 0 && g_blePrevSt < 5)
                     || ((g_lastRebootReason & NRF_POWER_RESETREAS_LOCKUP_MASK) == NRF_POWER_RESETREAS_LOCKUP_MASK);

  beginMillis = millis();  // Intialize timer

  // Keep the bus dark until the composite descriptor is complete. The core
  // pulls D+ (so the host can start enumerating) before setup() runs, and
  // the slow parts of boot (LittleFS mount, settings load) leave a long
  // window where only the CDC interface is registered: a host that is
  // actively hunting for the post-flash port can enumerate that CDC-only
  // device and never re-enumerate, leaving the HID interface down for the
  // whole boot (bench 2026-10-16: BH showed usbMounted=1, hidReady=0,
  // attempts climbing, successes=0 until a manual restart). Detaching here
  // makes every premature enumeration attempt fail; beginComOpMode()
  // attaches once the full descriptor exists.
  USBDevice.detach();

  Serial.begin(115200);

  // BOOT TRACE (4.5.9 bench round 3) — 4.5.29 RELEASE HYGIENE: the
  // unconditional announcement is retired with the bench hunt it carried
  // ("until the BLE boot is bench-cleared" — cleared at 4.5.27). The line
  // now prints only when the previous boot ended abnormally (see
  // g_bootReportWorthy above); the milestone prints below are gated behind
  // USB_DEBUG. Unprefixed lines remain app-tolerated (proven across many
  // sessions; dropped as undecodable, no waiter false-match possible).
  if (USB_DEBUG || g_bootReportWorthy) {
    Serial.print(F("BOOT: "));
    Serial.print(CONF_LIPSYNC_VERSION_STRING);
    Serial.print(F(" rst=0x"));
    Serial.print(g_lastRebootReason, HEX);
    Serial.print(F(" pt="));
    Serial.print(g_bootTrailPrev);
    Serial.print(F(" pm="));
    Serial.println(g_hangMarkerPrev);
  }

  // Arm the hardware watchdog BEFORE the filesystem and third-party device
  // code runs (4.8.7 review: the arm used to sit after checkSafeMode, so the
  // historically demonstrated hang phase — the LittleFS mount + settings
  // seed + persisted-verdict write inside initMemory(), the exact phase the
  // 4.5.22 incident needed a custom RECOVER build for — was unrescued: a
  // hang there got no DOG reset, no safe-mode settling, and a power cycle
  // cleared the streak). The arm decision keys on state computed in
  // checkResetReason() above, so the earlier arm is decision-identical;
  // checkSafeMode() below still runs under the same armed (or inherited)
  // watchdog, and the pinned Adafruit pressure drivers' unbounded
  // software-reset-bit loops stay covered exactly as before: on an I2C
  // failure their BusIO read returns all ones, which those loops interpret
  // as "still resetting" forever. A normal boot can now lose at most one
  // watchdog interval, and its watchdog-safe successor skips the suspect
  // sensor initialization below and remains recoverable over CDC.
  if (CONF_ENABLE_WATCHDOG && g_watchdogBootCount < CONF_WATCHDOG_BOOT_RETRY_LIMIT) {
    initWatchdog();
  } else if (NRF_WDT->RUNSTATUS != 0) {
    // nRF52 WDT cannot be stopped once started and survives warm resets.
    // The settled safe boot (or a developer build that disables future WDT
    // starts) must keep feeding an inherited instance even though it does not
    // arm another hang-witness cycle.
    g_watchdogArmed = true;
    watchdogLoop();
  }

  initMemory();  // Initialize Memory
  // (4.9.0 review; 4.9.1 HONEST BOUNDS) the trail's mid-boot milestone:
  // writeTrailByte(0) means "pre-setup death", so a NON-hang death inside
  // initMemory or beginComOpMode — a fault-capture SREQ, the classes that
  // preserve GPREGRET2 — now names its phase as pt=1 instead of pt=0.
  // A HANG in that window still reads pt=0/pm=0 on the successor: the 30 s
  // hardware DOG catches it (the arm above covers the phase — this is the
  // fix that matters operationally), and a DOG reset wipes the retention
  // register wholesale (the witness-v8 fact), stamp included. pt=1 therefore
  // reads "memory up" for every death class the trail can observe; it does
  // NOT claim hang forensics for the mount/seed window — the DOG -> g_watchdogReset
  // -> safe-mode settle is that hang's recovery path. Trail codes 0-7 are all
  // assigned (v7), so this milestone REUSES code 1 with the narrowed meaning,
  // stamped unconditionally (the old stamp sat behind the witness gate, so a
  // settled safe boot never stamped anything either). Deaths after this
  // point are loop-phase as before.
  bootTrailStamp(1);

  // bleVerdictConsume() runs inside initMemory(), so only now can a failed
  // previous BLE initialization contribute to the abnormal-boot report.
  // The pre-filesystem calculation above still covers fault/retention data
  // for the early setup print.
  if (g_blePrevSt >= 0 && g_blePrevSt < 5) {
    g_bootReportWorthy = true;
  }

  //initUID(); // Intilize unique identifier
  getDeviceID(false, false);       // Retrieve Device ID from memory
  getVersionNumber(false, false);  // Retrieve version number from memory

  initLed();  // Initialize LED Feedback

  initBuzzer();  // Initialize Buzzer

  initInput();  // Initialize input buttons and input switches

  initRestrictions();  // Load the input restriction settings (roadmap item 11) before any input can fire

  // Safe-mode decision BEFORE any interface begins (4.5.7 review): the
  // decision half of checkSafeMode (button debounce + reset reason + the
  // hang-witness settling below) has no side effects on timers or the
  // screen — those live in toggleSafeMode, still called at its original
  // place below. Deciding first lets beginComOpMode skip the mode HID
  // interface and BLE on a safe boot, making the documented "safe mode
  // comes up CDC-only: serial recovery is the whole point" actually true
  // (4.5.6 shipped with the interfaces registered BEFORE the flip — an
  // inert-but-present mouse HID on a safe boot and BLE advertising on a
  // CM=2 safe boot).
  checkSafeMode();

  // Missing required hardware is also a safe-mode DECISION and must land
  // before beginComOpMode() registers HID or defers a BLE initialization
  // task. The old order probed I2C afterwards, so a degraded CM=BLE boot
  // still attached and started the SoftDevice task before calling itself
  // safe. Every safe boot's recovery surface is CDC-only, regardless of the
  // reason that selected it.
  checkI2C();  // Check that I2C devices are connected

  if (!g_displayConnected || !g_mouthpiecePressureSensorConnected
      || !g_ambientPressureSensorConnected || !g_joystickSensorConnected) {
    g_safeModeEnabled = true;
    g_safeModeReason = CONF_SAFE_MODE_REASON_HARDWARE;
    g_operatingMode = CONF_OPERATING_MODE_SAFE;
  }

  // Initialize every detected device before committing to an HID/BLE
  // interface. An address scan can ACK while the driver's configuration
  // still fails; the begin verdicts below update the same connection globals
  // used by the hardware-safe decision.
  if (g_displayConnected) {
    initScreen();
  }
  if (!g_safeModeEnabled && g_mouthpiecePressureSensorConnected && g_ambientPressureSensorConnected) {
    initSipAndPuff();
  }
  if (!g_safeModeEnabled && g_joystickSensorConnected) {
    initJoystick();
  }
  initAcceleration();  // Load the stored cursor acceleration level (roadmap item 9)

  if (!g_displayConnected || !g_mouthpiecePressureSensorConnected
      || !g_ambientPressureSensorConnected || !g_joystickSensorConnected) {
    g_safeModeEnabled = true;
    g_safeModeReason = CONF_SAFE_MODE_REASON_HARDWARE;
    g_operatingMode = CONF_OPERATING_MODE_SAFE;
  }

  beforeComOpMillis = millis() - beginMillis;  // Note time before USB/BT connection
  beginComOpMode();                            // Initialize Operating Mode, Communication Mode, and start instance of mouse or gamepad
  afterComOpMillis = millis() - beginMillis;   // Note time after USB/BT connection

  if (USB_DEBUG) {
    unsigned long startSerialWaitTime = millis();
    unsigned long currentSerialWaitTime = millis();
    const unsigned long SERIAL_WAIT_TIMEOUT = 30000;
    if (g_displayConnected && !Serial) {
      screen.print4LineString("Waiting", "for serial", "connection", "...");
    }
    while (!Serial) {  //wait for serial connection to establish
      if (g_watchdogArmed) watchdogLoop();
      delay(1);
      currentSerialWaitTime = millis();
      if (currentSerialWaitTime - startSerialWaitTime > SERIAL_WAIT_TIMEOUT){
        break;
      }
    }
    Serial.println("USBDEBUG: Serial Connected");
    if (g_displayConnected) {
      screen.print4LineString(" ", "Serial", "connected.", " ");
    }
  }

  if (g_displayConnected) {
    screen.splashScreen();
  }

  startupFeedback();  // Startup LED Feedback

  if (USB_DEBUG) { Serial.println("USBDEBUG: Initialize timers."); }
  // Configure poll timer to perform each feature as a separate loop
  pollTimerId[CONF_TIMER_JOYSTICK] = pollTimer.setInterval(CONF_JOYSTICK_POLL_RATE, 0, joystickLoop);  // poll rate, start delay, function
  pollTimerId[CONF_TIMER_PRESSURE] = pollTimer.setInterval(CONF_PRESSURE_POLL_RATE, 0, pressureLoop);
  pollTimerId[CONF_TIMER_INPUT] = pollTimer.setInterval(CONF_INPUT_POLL_RATE, 0, inputLoop);
  pollTimerId[CONF_TIMER_BLUETOOTH] = pollTimer.setInterval(CONF_BT_FEEDBACK_POLL_RATE, 0, btFeedbackLoop);
  pollTimerId[CONF_TIMER_DEBUG] = pollTimer.setInterval(CONF_DEBUG_POLL_RATE, 0, debugLoop);
  pollTimerId[CONF_TIMER_SCROLL] = pollTimer.setInterval(CONF_SCROLL_POLL_RATE, 0, joystickLoop);
  pollTimerId[CONF_TIMER_SCREEN] = pollTimer.setInterval(CONF_SCREEN_POLL_RATE, 0, screenLoop);
  pollTimerId[CONF_TIMER_USB] = pollTimer.setInterval(CONF_USB_POLL_RATE, 0, usbConnectionLoop);
  pollTimerId[CONF_TIMER_WATCHDOG] = pollTimer.setInterval(CONF_WATCHDOG_POLL_RATE, 0, watchdogLoop);

  // Boot-time registration audit (bench 2026-10-18, pool hygiene): a refused
  // registration returns -1 and every caller used to ignore it — a
  // "registered" loop that silently never ran is how a pool death hides
  // (the LSTimer now refuses loudly and counts, but the ids must be checked
  // at least once at the place they're captured). With the pool raised to
  // 16 this cannot fire today; if a future feature exhausts it, this line
  // names the dead feature at boot instead of leaving it a mystery.
  for (int timerIdx = 0; timerIdx < CONF_TIMER_NUM; timerIdx++) {
    if (pollTimerId[timerIdx] < 0) {
      String timerError = "ERROR: poll timer ";
      timerError += String(timerIdx);
      timerError += " failed to register — that loop WILL NOT RUN";
      serialTxEnqueueLine(timerError);
    }
  }


  pollTimer.disable(pollTimerId[CONF_TIMER_USB]); // TODO 2025-Feb-21 Disable usbConnectionLoop until implemented
  // If USB is not connected, try to reconnect
  if (g_comMode == CONF_COM_MODE_USB) {
    usbConnectRearm(g_usbConnectDelay);  // 4.6.6: delete-before-arm (first arm — the id holder starts at -1)
  }


  // (enablePoll(true) — removed 4.8.1 with the function; setup's explicit
  // per-poll registration/enable below is the single source of truth.)

  ledActionEnabled = true;

  // (ledReadyFeedback() — removed 4.8.1 with the function; the ready cue is
  // the buzzer's playReadySound plus the LED defaults.)

  if (g_displayConnected) {
    pollTimer.enable(pollTimerId[CONF_TIMER_SCREEN]);
  } else {
    pollTimer.disable(pollTimerId[CONF_TIMER_SCREEN]);
  }

  if (g_mouthpiecePressureSensorConnected && g_ambientPressureSensorConnected) {
    pollTimer.enable(pollTimerId[CONF_TIMER_PRESSURE]);
    if (USB_DEBUG) { Serial.println("USBDEBUG: Pressure timer started."); }
  } else {
    pollTimer.disable(pollTimerId[CONF_TIMER_PRESSURE]);
    if (USB_DEBUG) { Serial.println("USBDEBUG: Pressure timer NOT started."); }
  }

  if (g_joystickSensorConnected) {
    pollTimer.enable(pollTimerId[CONF_TIMER_JOYSTICK]);
    pollTimer.enable(pollTimerId[CONF_TIMER_SCROLL]);
  } else {
    pollTimer.disable(pollTimerId[CONF_TIMER_JOYSTICK]);
    pollTimer.disable(pollTimerId[CONF_TIMER_SCROLL]);
  }

  // Timer IDs are valid only after registration. Running initDebug before
  // this point made every enable/disable target slot 0 from zero-initialized
  // storage, while the real debug timer subsequently started enabled.
  initDebug();

  // If any devices are not connected, handle error
  if (!g_displayConnected || !g_mouthpiecePressureSensorConnected || !g_ambientPressureSensorConnected || !g_joystickSensorConnected) {
    hardwareErrorCheck();
  }

  // THE FREEZE FIX, round 2 (bench 2026-10-23, the correlation that closed the
  // hunt): ledWaitFeedback used to run BEFORE checkI2C, allocating the LED
  // brightness channels on the shared HwPWM instance; hardwareErrorCheck's
  // playErrorSound then called tone(), and the Seeed core's tone() CLAIMS
  // THAT SAME PWM PERIPHERAL (Tone.cpp hard-codes PWM2) and rewrites its
  // sequence/loop configuration under the live LED channels — the first
  // note plays, the peripheral is left in a conflicted state, and the loop
  // froze 0.9-8.6 s later on 15/15 boots whose joystick sensor was absent
  // (the only boots that ever play the error sound; all-sensor safe boots
  // and healthy boots never froze). The two PWM users are now SEQUENCED:
  // the error sound plays first (with no LED channels allocated), releases
  // the peripheral via noTone(), and the all-LEDs-on feedback runs here —
  // after any sound, on every boot. Same cues for the user, no overlap.
  ledWaitFeedback();  // Turn on all LEDS (moved from before checkI2C — see above)

  // (handleHardwareErrors() — removed 4.8.1 with the empty function; the
  // real hardware-error handling is checkI2C + checkSafeMode + BH.)

  toggleSafeMode(g_safeModeEnabled);

  // The hardware WDT was armed before device-driver initialization above.
  // Arm its TIMER3 hang witness only while the crash budget remains. On the
  // settled safe boot an inherited (unstoppable) WDT is still fed, but no new
  // witness SREQ is allowed to extend the reset chain.
  if (CONF_ENABLE_WATCHDOG && g_watchdogArmed && g_watchdogBootCount < CONF_WATCHDOG_BOOT_RETRY_LIMIT) {
    initHangWitness();  // witness v8: the TIMER3 hang witness — converts a loop hang into an SREQ that preserves the trail
    // (4.9.0 review: the pt=1 trail stamp moved to immediately after
    // initMemory() and is unconditional there — see the milestone comment.
    // This gate now arms only the witness.)
  }

  // 4.5.10: the BLE init task starts LAST — after every sensor, screen and
  // timer init has completed on the loop task's stack, so the two never
  // contend for stack and the loop's guarded BLE calls stay inert until the
  // stack is up (needsInitialization is the gate).
  if (g_bleInitPending) {
    if (USB_DEBUG) { Serial.println(F("BOOT: BLE task create")); }
    TaskHandle_t bleTask = xTaskCreateStatic(bleInitTaskBody, "bleInit",
                                             CONF_BLE_INIT_TASK_STACK_BYTES / sizeof(StackType_t),
                                             NULL, CONF_BLE_INIT_TASK_PRIORITY,
                                             g_bleInitStack, &g_bleInitTCB);
    if (bleTask == NULL) {
      g_bleInitStage = 1;
      g_bleInitDone = true;
      g_bleVerdictDirty = true;
      if (USB_DEBUG) { Serial.println(F("BOOT: BLE FAILED to create init task")); }
    }
  }

  if (USB_DEBUG) { Serial.print("USBDEBUG: lastRebootReason: "); Serial.println(g_lastRebootReason); }
  if (USB_DEBUG) { Serial.println("USBDEBUG: Setup complete."); }

  if (USB_DEBUG) { Serial.println(F("BOOT: setup done")); }

}  // end setup


//***START OF MAIN LOOP***//
// Function   : loop
//
// Description: This function loops consecutively and responses to changes.
//
// Parameters :  void
//
// Return     : void
//*********************************//
void loop() {
  serialTxService();
  bool bootReportPendingThisPass = false;
  // 4.5.10: any host byte stops the repeating boot header (below) — the
  // app's connect sends SETTINGS within milliseconds of opening the port,
  // so a connected session falls silent after one extra line at most.
  static bool finalBootLinePrinted = false;
  if (Serial.available() > 0) {
    // 4.5.12: the FIRST host byte also prints the header one final time —
    // the repeating ticks all fall inside TinyUSB's DTR-gated discard
    // window (writes before the host opens the port are dropped), which
    // is how three BLE boots' worth of st= data was lost. This line lands
    // in every session log right after connect, carrying the BLE verdict.
    if (!g_hostHasSpoken && !finalBootLinePrinted) {
      finalBootLinePrinted = true;
      // 4.5.29: the report prints ONLY when the previous boot ended
      // abnormally (g_bootReportWorthy — see setup). Healthy boots stay
      // SILENT on the wire: the released contract ("healthy boots print
      // nothing") is restored now that the BLE boot is bench-cleared. The
      // 4.5.12 "bulletproof capture" served its hunt; the abnormal-boot
      // classes keep it — each one leaves a marker, a fault page, a failed
      // verdict, or a lockup bit, and this line still carries the full
      // forensics for exactly those boots.
      bootReportPendingThisPass = g_bootReportWorthy;
    }
    g_hostHasSpoken = true;
  }

  // REPEATING BOOT HEADER — RETIRED (4.5.29): the 1 s × 30 s repeat lived
  // for the TinyUSB CDC discard window (pre-open-port writes are dropped),
  // so a dying boot could still be caught on a serial monitor mid-loop.
  // The hunt it served is closed and the conditional first-host-byte report
  // above carries every abnormal class — healthy boots are silent again.

  // Feed the hardware watchdog directly from the live loop (bench
  // 2026-10-18, the unbreakable safe-mode reset cycle): the heartbeat
  // witness proved that in a safe-mode boot the feed's soft timer on the
  // shared pollTimer pool stops firing — feed= froze at 4428 ms while
  // mode=3 safe=1 wdt=1 and the loop printed heartbearts for another
  // minute — so the armed 30 s watchdog starved, reset the device, whose
  // watchdog flag booted it into safe mode again, where the feed died
  // again: a 30 s reset cycle unbreakable until the cable was re-seated.
  // The loop itself demonstrably stays alive, so feed here on every pass:
  // the feed no longer depends on any timer machinery, and the watchdog
  // keeps its true job — catching a genuinely dead loop. The 5 s
  // pollTimer registration stays as a harmless second feeder.
  if (g_watchdogArmed) {
    watchdogLoop();
  }

  // Button/click transitions must not depend on a later joystick movement
  // report to reach the host (joystick debug mode deliberately disables that
  // poll). This service is non-blocking and sends only when HID is ready.
  usbmouse.service();
  btmouse.service();
  gamepad.service();

  // 4.8.1: the mouse's unmount cleanup raised its take-and-clear flag — the
  // USB host went away while click/drag state was held. End the DRAG mode
  // latch the same way btFeedbackLoop does for a BLE host change ("never
  // carry a drag/scroll latch across hosts"): usbCheckConnection's not-ready
  // branch misses a fast unmount->remount between its checks, and without
  // this the latch survived with the wire button already cleared. No
  // action-bearing event is emitted — the hold simply ends. (The scroll
  // latch is deliberately NOT ended here: a scroll hold carries no wire
  // button state — see LSUSBMouse::service's unmount comment — and ends at
  // the input release as usual.)
  // 4.9.0: routed through cancelSapOutputHold() — the mirror paths (the
  // sensor-fault hold-cancel, the hold-cancel branch) pair the release with
  // setLedDefault(), and the USB-bounce consumer used to leave the hold's
  // window color on the LEDs until the next input event repainted.
  if (usbmouse.takeUnmountedWithButtonState()
      && (outputAction == CONF_ACTION_DRAG || outputAction == CONF_ACTION_SCROLL)) {
    cancelSapOutputHold();
  }

  // 4.9.0: the exact BLE mirror — a drop→sub-second-reconnect inside
  // btFeedbackLoop's 1 s disconnected-observation (bench 4.8.14: macOS
  // reclaims the link sub-second) left the DRAG latch alive with the wire
  // button already cleared by LSBLEMouse::service's disconnect cleanup.
  // The flag bridges the gap; same scroll-latch caveat and same
  // no-action-bearing-event rule as the USB twin above.
  if (btmouse.takeDisconnectedWithButtonState()
      && (outputAction == CONF_ACTION_DRAG || outputAction == CONF_ACTION_SCROLL)) {
    cancelSapOutputHold();
  }

  // Degraded-state heartbeat (bench 2026-10-18, boot-with-unseated-cable
  // forensics): a 4.5.0 boot with the interface cable unseated reset at an
  // exact 30 s cadence — the app connected into the window, loaded ~19
  // settings, then the device vanished ("connection lost"), cycle after
  // cycle, unrecoverable until the cable was re-seated. Every static
  // suspect is ruled out (the vendored Wire bounds every transaction at
  // 50 ms and recovers wedges; the joystick/pressure/screen paths back
  // off; the safe-mode path leaves the watchdog timer enabled; the API
  // table is not filtered by safe mode) — so the freeze mechanism needs a
  // witness that survives it. A degraded or safe-mode boot prints one line
  // every 5 s; a healthy boot prints nothing. The line's very existence
  // proves the main loop is alive, and the three numbers split the
  // remaining hypotheses: feed= growing past 30 s while lines keep
  // printing = the feed timer died while the loop lives; lines stopping =
  // the loop froze; wdt=1 feed=never = the watchdog was armed but its
  // timer never registered (the LSTimer pool has shown "No free timers").
  static unsigned long lastHeartbeatMs = 0;
  // 4.5.12: a BLE boot whose init FAILED is degraded — the heartbeat now
  // carries the verdict (ble=/st=) for the whole session, so a connected
  // app sees the failure state repeatedly instead of a silent unpairable
  // device. A successful BLE boot (needsInitialization false) is healthy.
  const bool bleInitFailed = (g_bleInitPending && g_bleInitDone && needsInitialization);
  const bool degradedNow = g_safeModeEnabled || !g_displayConnected || !g_joystickSensorConnected
                         || !g_mouthpiecePressureSensorConnected || !g_ambientPressureSensorConnected
                         || bleInitFailed;
  // RELEASED BEHAVIOR (4.5.7 review): the bench's 2026-10-23 "witness
  // window" (every boot printing at 250 ms/1 s cadence for the first 90 s)
  // shipped in the V4.5.6 tag even though its own comment called it "a
  // diagnostic patch, not the release behavior" and CHANGES.txt claimed
  // "healthy boots still print nothing" — ~105 unsolicited HB lines
  // interleaved into every app connect + settings load, the exact
  // wire-noise class 4.5.2/4.5.5 eliminated. The released contract stands
  // again: degraded/safe boots print one line every 5 s (the freeze-hunt
  // forensics endpoint — rst/pt/pm/trail/bus/recov/sns all ride the line),
  // healthy boots print nothing. Bench instrumentation belongs in bench
  // builds, not the tag.
  const unsigned long heartbeatIntervalMs = 5000;
  if (degradedNow && (millis() - lastHeartbeatMs >= heartbeatIntervalMs)) {
    lastHeartbeatMs = millis();
    static char diagnosticLine[512];  // Static: do not consume the loop task's 4 KB stack
    char feedText[24];
    if (g_watchdogLastFeedMs == 0) snprintf(feedText, sizeof(feedText), "never");
    else snprintf(feedText, sizeof(feedText), "%lums", (unsigned long)(millis() - g_watchdogLastFeedMs));
    char faultText[16];
    if (g_faultPrevPage == 0xFF) snprintf(faultText, sizeof(faultText), "none");
    else snprintf(faultText, sizeof(faultText), "%lX", (unsigned long)(((uint32_t)g_faultPrevPage) << 13));
    int diagnosticLen;
    if (bleInitFailed) {
      diagnosticLen = snprintf(diagnosticLine, sizeof(diagnosticLine),
        "HB: ms=%lu mode=%d safe=%d wdt=%d feed=%s rst=0x%lX pt=%u pm=%u trail=%u bus=%d recov=%lu sns=%d%d%d%d ble=3 st=%d sd=%d pstep=%u pcode=0x%lX need=0x%lX bad1=0x%lX bad2=0x%lX dem=%u rc=0x%lX pst=%d prc=0x%X fp=0x%s sw=%lu",
        (unsigned long)millis(), g_operatingMode, g_safeModeEnabled ? 1 : 0,
        g_watchdogArmed ? 1 : 0, feedText, (unsigned long)g_lastRebootReason,
        g_bootTrailPrev, g_hangMarkerPrev, readTrailByte(), Wire.busHealthy() ? 1 : 0,
        (unsigned long)Wire.recoveryCount(), g_joystickSensorConnected ? 1 : 0,
        g_mouthpiecePressureSensorConnected ? 1 : 0, g_ambientPressureSensorConnected ? 1 : 0,
        g_displayConnected ? 1 : 0, g_bleInitStage, (int)g_bleSdWasEnabled,
        g_bleProbeStep, (unsigned long)g_bleProbeCode, (unsigned long)g_bleProbeNeed,
        (unsigned long)g_bleIrqBad1, (unsigned long)g_bleIrqBad2, g_bleProbeDemoted,
        (unsigned long)g_bleInitRc, (int)g_blePrevSt, (unsigned int)g_blePrevRc,
        faultText, (unsigned long)(g_loopTaskHandle ? uxTaskGetStackHighWaterMark(g_loopTaskHandle) : 0));
    } else {
      diagnosticLen = snprintf(diagnosticLine, sizeof(diagnosticLine),
        "HB: ms=%lu mode=%d safe=%d wdt=%d feed=%s rst=0x%lX pt=%u pm=%u trail=%u bus=%d recov=%lu sns=%d%d%d%d",
        (unsigned long)millis(), g_operatingMode, g_safeModeEnabled ? 1 : 0,
        g_watchdogArmed ? 1 : 0, feedText, (unsigned long)g_lastRebootReason,
        g_bootTrailPrev, g_hangMarkerPrev, readTrailByte(), Wire.busHealthy() ? 1 : 0,
        (unsigned long)Wire.recoveryCount(), g_joystickSensorConnected ? 1 : 0,
        g_mouthpiecePressureSensorConnected ? 1 : 0, g_ambientPressureSensorConnected ? 1 : 0,
        g_displayConnected ? 1 : 0);
    }
    if (diagnosticLen > 0 && diagnosticLen < (int)sizeof(diagnosticLine)) {
      serialTxEnqueueLine(diagnosticLine, (size_t)diagnosticLen);
    }
  }

  // 4.5.21: the verdict-persist service point — the BLE init task raises the
  // flag, the loop (sole owner of all filesystem access) performs the write.
  // Runs within milliseconds of the flag, well before begin() completes.
  if (g_bleVerdictDirty) {
    // Atomic take-and-clear across the higher-priority BLE init task. Without
    // the critical section, that task could set dirty between this loop's
    // test and clear, and the clear would erase the final stage-5 verdict.
    bool persistVerdict = false;
    taskENTER_CRITICAL();
    persistVerdict = g_bleVerdictDirty;
    g_bleVerdictDirty = false;
    taskEXIT_CRITICAL();
    if (persistVerdict) bleVerdictPersist();
  }

  ledStateTimer.run();  // Timer for lights
  
  usbConnectTimer.run();
  

  if (g_joystickSensorConnected) {
    calibrationTimer.run();  // Timer for calibration measurements
  }
  

  if (g_operatingMode == CONF_OPERATING_MODE_GAMEPAD) {
    actionTimer.run();  
  }

  pollTimer.run();  // Timer for normal joystick functions

  buzzer.update();  // Fire queued buzzer notes (non-blocking sound sequencing)

  settingsEnabled = serialSettings(settingsEnabled);  // Process Serial API commands
  if (bootReportPendingThisPass) {
    static char bootLine[384];  // Static: keep the diagnostic off the loop task stack
    char faultText[16];
    if (g_faultPrevPage == 0xFF) snprintf(faultText, sizeof(faultText), "none");
    else snprintf(faultText, sizeof(faultText), "%lX", (unsigned long)(((uint32_t)g_faultPrevPage) << 13));
    int bleStateFinal = 0;
    if (g_bleInitPending) bleStateFinal = g_bleInitDone ? (needsInitialization ? 3 : 2) : 1;
    int bootLen = snprintf(bootLine, sizeof(bootLine),
      "BOOT: %s rst=0x%lX pt=%u pm=%u ble=%d st=%d sd=%d pstep=%u pcode=0x%lX need=0x%lX bad1=0x%lX bad2=0x%lX dem=%u rc=0x%lX pst=%d prc=0x%X fp=0x%s sw=%lu",
      CONF_LIPSYNC_VERSION_STRING.c_str(), (unsigned long)g_lastRebootReason,
      g_bootTrailPrev, g_hangMarkerPrev, bleStateFinal, g_bleInitStage,
      (int)g_bleSdWasEnabled, g_bleProbeStep, (unsigned long)g_bleProbeCode,
      (unsigned long)g_bleProbeNeed, (unsigned long)g_bleIrqBad1,
      (unsigned long)g_bleIrqBad2, g_bleProbeDemoted, (unsigned long)g_bleInitRc,
      (int)g_blePrevSt, (unsigned int)g_blePrevRc, faultText,
      (unsigned long)(g_loopTaskHandle ? uxTaskGetStackHighWaterMark(g_loopTaskHandle) : 0));
    if (bootLen > 0 && bootLen < (int)sizeof(bootLine)) {
      serialTxEnqueueLine(bootLine, (size_t)bootLen);
    }
    // 4.8.7 review: setup's gamepad+Bluetooth heal fired — name the
    // correction here, post-attach, where a host can actually read it (the
    // heal's own println ran in the pre-attach discard window).
    if (g_comModeHealedThisBoot) {
      serialTxEnqueueLine("ERROR: stored gamepad+Bluetooth is not a supported combination -- communication mode reset to USB");
    }
  }
  serialTxService();

  // Multi-host switch window (upstream #16, 4.8.8): the directed advertise
  // self-terminates about every second (high-duty directed spec limit), so
  // the window needs millisecond-granularity re-arms — the 1 s btFeedbackLoop
  // tick alone left the target's background scan too sparse a duty cycle.
  // This service is a no-op unless a window is open; single-threaded with
  // every other window path (all on the loop task).
  lsHostServiceSwitchWindow();

  //yield();
}


//***INITIALIZE GLOBALS FUNCTION***//
// Function   : initGlobals
//
// Description: This function initializes global variables to default values
//
// Parameters : void
//
// Return     : void
//****************************************//
void initGlobals() {
  if (USB_DEBUG) { Serial.println("USBDEBUG: initGlobals()"); } //  Won't display as function called before serial established

  g_lastRebootReason = 0;
  g_ambientPressureSensorConnected = false;
  g_mouthpiecePressureSensorConnected = false;
  g_joystickSensorConnected = false;
  g_displayConnected = false;
  g_btIsConnected = false;
  g_errorCode = 0;
  g_debugMode = 0;
  g_usbNotReadySinceMs = 0;
  g_usbReenumCount = 0;
  //g_lightMode = 1;  //  Currently unused
  //g_soundMode = 1; //  Currently unused
  g_operatingMode = 1;
  g_comMode = 1;
  //g_firstLoop = true;

  g_watchdogReset = false;
  g_watchdogBootCount = 0;
  g_safeModeEnabled = false;
  g_safeModeReason = 0;

  g_sapDisabled = false;
  g_menuButtonsOnly = false;
  g_modeLocked = false;
  g_freezeCursorDuringSap = false;

  g_inputWindowShortMs = 0;
  g_inputWindowLongMs = 0;
  g_inputWindowMaxMs = 0;

  g_centerRunning = false;
  g_calibrationRunning = false;
  g_calibrationCenterStep = false;

}


//***HARDWARE ERROR CHECK FUNCTION***//
// Function   : hardwareErrorCheck
//
// Description: This function checks for errors with the LipSync hardware
//
// Parameters : void
//
// Return     : void
//****************************************//
void hardwareErrorCheck(void) {
  if (USB_DEBUG) { Serial.println("USBDEBUG: hardwareErrorCheck()"); }

  // I2C Connection Errors (Display, Joystick, Mouthpiece Pressure, Ambient Pressure)
  if (!g_displayConnected) {
    // Display not connected / detected
    buzzer.playErrorSound();
    static const char displayError[] = "ERROR: Display not detected";
    serialTxEnqueueLine(displayError, sizeof(displayError) - 1);
    ledError(3);
    g_safeModeEnabled = true;
    g_safeModeReason = CONF_SAFE_MODE_REASON_HARDWARE;
  }

  if (!g_joystickSensorConnected && !g_mouthpiecePressureSensorConnected && !g_ambientPressureSensorConnected) {
    // All joystick sensors not detected
    buzzer.playErrorSound();
    static const char cableError[] = "ERROR: No sensors detected in joystick. Check interface cable.";
    serialTxEnqueueLine(cableError, sizeof(cableError) - 1);
    g_safeModeEnabled = true;
    g_safeModeReason = CONF_SAFE_MODE_REASON_HARDWARE;
    
  } else if (!g_joystickSensorConnected || !g_mouthpiecePressureSensorConnected || !g_ambientPressureSensorConnected) {
    // One or more sensors but not all
    
    g_safeModeEnabled = true;
    g_safeModeReason = CONF_SAFE_MODE_REASON_HARDWARE;
    
    buzzer.playErrorSound();
    if (!g_joystickSensorConnected) {
      static const char joystickError[] = "ERROR: Joystick sensor not detected.";
      serialTxEnqueueLine(joystickError, sizeof(joystickError) - 1);
    }
    if (!g_mouthpiecePressureSensorConnected) {
      static const char mouthpieceError[] = "ERROR: Mouthpiece Pressure Sensor not detected.";
      serialTxEnqueueLine(mouthpieceError, sizeof(mouthpieceError) - 1);
    }
    if (!g_ambientPressureSensorConnected) {
      static const char ambientError[] = "ERROR: Ambient Pressure Sensor not detected.";
      serialTxEnqueueLine(ambientError, sizeof(ambientError) - 1);
    }
    
  }


}


// (handleHardwareErrors REMOVED — 4.8.1 review: an empty body whose only
// call was commented out ("Currently not implemented"). The real hardware
// error handling is checkI2C + checkSafeMode + the BH health fields.)


//***ERROR CHECK FUNCTION***//
// Function   : errorCheck
//
// Description: This function checks for errors with the LipSync device
//
// Parameters : void
//
// Return     : void
//****************************************//
void errorCheck(void) {
  if (USB_DEBUG) { Serial.println("USBDEBUG: errorCheck()"); }

  if ((g_operatingMode == CONF_OPERATING_MODE_MOUSE) && (g_comMode == CONF_COM_MODE_USB)
      && (!usbmouse.isReady() || usbmouse.usbRetrying || usbmouse.timedOut)) {
    g_errorCode = CONF_ERROR_USB;
  } else if ((g_operatingMode == CONF_OPERATING_MODE_GAMEPAD) && !gamepad.isReady()) {
    g_errorCode = CONF_ERROR_USB;
  } else {
    g_errorCode = CONF_ERROR_NONE;  // 0
  }

  if (USB_DEBUG) { Serial.print("USBDEBUG: errorCode: "); Serial.println(g_errorCode); }
  // Add if cases for other errors
}


//***ERROR SCREEN FUNCTION***//
// Function   : errorScreen
//
// Description: This function calls the corresponding error screen function
//
// Parameters : void
//
// Return     : void
//****************************************//
void errorScreen(void) {
  if (USB_DEBUG) { Serial.println("USBDEBUG: errorScreen()"); }
  errorCheck();

  if (!screen.isMenuActive()) {
    if (g_errorCode == CONF_ERROR_USB) {
      // Only draw when there is a display on an answerable bus — a draw against
      // held I2C hardware costs seconds of bounded timeouts (see usbCheckConnection)
      if (g_displayConnected && Wire.busHealthy()) {
        screen.noUsbPage();
      }
    }
  }
}


//***CHECK SAFE MODE FUNCTION***//
// Function   : checkSafeMode
//
// Description: Checks if both hub buttons are pressed on startup in order to enter safe boot mode.
//
// Parameters : void
//
// Return     : void
//****************************************//
void checkSafeMode(void) {

  if (USB_DEBUG) { Serial.println("USBDEBUG: checkSafeMode()"); }

  // Read Hub button values
  int buttonSelectState1 = !digitalRead(CONF_BUTTON1_PIN);
  int buttonNextState1 =   !digitalRead(CONF_BUTTON2_PIN);

  delay(50);

  // Read Hub button values again
  int buttonSelectState2 = !digitalRead(CONF_BUTTON1_PIN);
  int buttonNextState2 =   !digitalRead(CONF_BUTTON2_PIN);

  if (buttonSelectState1 == HIGH && buttonSelectState2 == HIGH && buttonNextState1 == HIGH && buttonNextState2 == HIGH) {
    g_safeModeEnabled = true;
    g_safeModeReason = CONF_SAFE_MODE_REASON_INPUT;  //  Both hub buttons pushed on startup

  } else if (g_watchdogReset && CONF_ENABLE_WATCHDOG) {
    g_safeModeEnabled = true;
    g_safeModeReason = CONF_SAFE_MODE_REASON_WATCHDOG;

  } else if (g_hangBootStreak >= CONF_WATCHDOG_BOOT_RETRY_LIMIT) {
    // Hang-witness settling (4.5.7 review): the previous three-or-more
    // consecutive boots each died in a TIMER3-witnessed loop hang (an
    // interrupts-alive stall — the SREQ resets PRESERVE the retention
    // register, so unlike the watchdog-reset budget this streak actually
    // accumulates). Rest this boot in safe mode: the safe-mode loop is the
    // minimal machinery, and TIMER3 is not re-armed (an inherited hardware
    // WDT remains fed; the streak feeds g_watchdogBootCount in setup()) — the
    // documented "after N straight crash boots, the device settles in
    // safe mode instead of resetting forever" contract, finally
    // functional on the path that can actually count.
    g_safeModeEnabled = true;
    g_safeModeReason = CONF_SAFE_MODE_REASON_HANG;
    static const char hangWarning[] = "WARNING: SAFE MODE ENABLED - Repeated witnessed loop hangs";
    serialTxEnqueueLine(hangWarning, sizeof(hangWarning) - 1);

  } else {
    g_safeModeEnabled = false;
  }

  if (g_safeModeEnabled) {
    g_operatingMode = CONF_OPERATING_MODE_SAFE; // Change operating mode to safe mode
  }


}

//***TOGGLE SAFE MODE FUNCTION***//
// Function   : toggleSafeMode
//
// Description: Checks if both hub buttons are pressed on startup in order to enter safe boot mode.
//
// Parameters : bool : safeModeEnabled : Whether safe mode is enabled or disabled
//
// Return     : void
//****************************************//
void toggleSafeMode(bool safeModeEnabled) {
  
  if (safeModeEnabled) {
    // Prevent mouse and gamepad outputs from being sent
    
    // Provide feedback based on reason for activating safe mode
    switch(g_safeModeReason) {
      case CONF_SAFE_MODE_REASON_INPUT:
      {
        static const char inputWarning[] = "WARNING: SAFE MODE ENABLED - Hub Buttons";
        serialTxEnqueueLine(inputWarning, sizeof(inputWarning) - 1);
        break;
      }
      case CONF_SAFE_MODE_REASON_WATCHDOG:
      {
        static const char watchdogWarning[] = "WARNING: SAFE MODE ENABLED - Watchdog";
        serialTxEnqueueLine(watchdogWarning, sizeof(watchdogWarning) - 1);
        break;
      }
      case CONF_SAFE_MODE_REASON_HARDWARE:
      {
        static const char hardwareWarning[] = "WARNING: SAFE MODE ENABLED - Hardware";
        serialTxEnqueueLine(hardwareWarning, sizeof(hardwareWarning) - 1);
        break;
      }
      default:
      {
        static const char safeWarning[] = "WARNING: SAFE MODE ENABLED";
        serialTxEnqueueLine(safeWarning, sizeof(safeWarning) - 1);
        break;
      }
         
    }

    g_operatingMode = CONF_OPERATING_MODE_SAFE; // Set working operating mode to safe mode to prevent unwanted input in case of hardware error

    // activate safe boot mode screen on display
    screen.safeModePage(g_safeModeReason);
    screen.disableTimeout();
    screen.update();

      
    // Disable poll timers
    //pollTimer.disable(pollTimerId[CONF_TIMER_SCREEN]);
    pollTimer.disable(pollTimerId[CONF_TIMER_PRESSURE]);
    pollTimer.disable(pollTimerId[CONF_TIMER_JOYSTICK]);
    pollTimer.disable(pollTimerId[CONF_TIMER_SCROLL]);
    pollTimer.disable(pollTimerId[CONF_TIMER_DEBUG]);
    pollTimer.disable(pollTimerId[CONF_TIMER_BLUETOOTH]);

    } else {
    

  }


}



//***READY TO USE FUNCTION***//
// Function   : readyToUse
//
// Description: This function checks for errors and startup conditions, and then displays the Ready To Use screen.
//              If errors are present, the error screen function is called.
//
// Parameters : void
//
// Return     : void
//****************************************//
void readyToUse(void) {
  if (USB_DEBUG) { Serial.println("USBDEBUG: readyToUse()"); }

  errorCheck();  // Check for errors

  if (readyToUseFirstTime && g_resetCenterComplete && !g_safeModeEnabled) {

    if (g_errorCode == CONF_ERROR_NONE) {
      buzzer.playReadySound();
      screen.splashScreen2();
      readyToUseFirstTime = false;
    } else {
      buzzer.playErrorSound();
      errorScreen();
    }

    if (SHOW_CONNECTION_TIME) {
      screen.connectionTimingPage(beforeComOpMillis, afterComOpMillis);
      Serial.print("Time until before com op mode: ");
      Serial.println(beforeComOpMillis);
      Serial.print("Time until after com op mode: ");
      Serial.println(afterComOpMillis);
    }
  }
}

// (enablePoll REMOVED — 4.8.1 review: its only call site was the removed
// dead ledIBMEffect (plus a commented-out one). It force-enabled
// PRESSURE/INPUT/BLUETOOTH polls with no safe-mode or debug-mode gate — the
// exact wrong-re-enable class the poll restore paths now gate individually.
// Safe mode and setDebugState own the poll enables.)

//*********************************//
// Memory Functions
//*********************************//

//***INITIALIZE MEMORY FUNCTION***//
// Function   : initMemory
//
// Description: This function initializes flash memory to store settings
//
// Parameters : void
//
// Return     : void
//****************************************//
void initMemory() {
  if (USB_DEBUG) { Serial.println("USBDEBUG: initMemory()"); }
#if CONF_FS_FORMAT_ON_BOOT
  // 4.5.22 RESCUE PATH (see LSConfig.h): a fresh format before the mount
  // heals a filesystem torn by the 4.5.20 race + mid-write witness kills —
  // the class of corruption that hangs/crash-loops the boot at the FIRST FS
  // operation, before any tone, screen, or serial protocol. Runs on the
  // RECOVER build only; mem.begin() below mounts the fresh filesystem.
  InternalFS.format();
  delay(2);
#endif
  mem.begin();  // Begin memory
  // (4.9.0 review) orphaned temp files: every writer pre-removes its temp
  // before writing, so a power cut between that remove and the rename leaves
  // /settings.tmp (and /bleverdict.tmp) on flash until that module's next
  // successful write. Nothing reads a stale temp as settings (the writers
  // own the tmp name), but a unit that crashes mid-write and never writes
  // again carried the orphaned block indefinitely — sweep both at boot.
  InternalFS.remove(CONF_SETTINGS_TMP_FILE);
  InternalFS.remove(BLE_VERDICT_TMP_FILE);
  bleVerdictConsume();  // 4.5.20: consume the previous BLE boot's flash-persisted verdict (pst=/prc= on the wire) — after the FS is up, before any header prints it
  
  // Open settings file (CONF_SETTINGS_FILE) from flash memory.
  // If not present, create file based on defaults in CONF_SETTINGS_JSON
  mem.initialize(CONF_SETTINGS_FILE, CONF_SETTINGS_JSON);
  // Upstream #58: the second settings file (hard sip/puff keys HS/HP/HA/HB).
  // Same seed-on-missing contract as the main file, its own budget (see
  // LSMemory::budgetFor) — a file 4.1.0 never touches, so the main file's
  // downgrade cliff is unaffected.
  mem.initialize(CONF_SETTINGS2_FILE, CONF_SETTINGS2_JSON);
}

//***RESET MEMORY FUNCTION***//
// Function   : resetMemory
//
// Description: This function formats and removes existing text files in flash memory.
//              It initializes flash memory to store settings after formatting.
//
// Parameters : void
//
// Return     : void
//****************************************//
bool resetMemory() {
  if (USB_DEBUG) { Serial.println("USBDEBUG: resetMemory()"); }
  mem.format();  // Format and remove existing text files in flash memory
  // Write the complete default document once. The old factory-reset path
  // followed initialization with ~22 read/modify/write cycles, multiplying
  // flash wear and exposing many intermediate states for no benefit—the next
  // boot reloads this document anyway.
  bool mainOk = mem.writeAll(CONF_SETTINGS_FILE, CONF_SETTINGS_JSON);
  // Upstream #58: the hard-band file gets the same treatment. Both files are
  // re-seeded from compiled defaults, so FR also restores the hard sip/puff
  // thresholds and actions (this is also what makes a downgrade-then-4.1.0-FR
  // orphan harmless: the orphaned /settings2.dat would be re-adopted by the
  // re-upgrade — but after an FR on our firmware the values are factory).
  bool hardOk = mem.writeAll(CONF_SETTINGS2_FILE, CONF_SETTINGS2_JSON);
  return mainOk && hardOk;
}

//***Read UID FUNCTION***//
// Function   : readUID
//
// Description: This function reads the device's unique ID from the microcontroller
//
// Parameters : void
//
// Return     : const char* : deviceIDString : 8 hexadecimal string UID from board
//****************************************//
const char* readUID() {
  if (USB_DEBUG) { Serial.println("USBDEBUG: readUID()"); }

  static char deviceIDString[9];
  uint32_t deviceID = 0;

  //#ifdef NRF52480_XXAA
  deviceID = NRF_FICR->DEVICEID[0];  // First part of Device ID for NRF52840 boards
  //#endif

  // The wire and BLE-name contract is exactly eight hexadecimal characters.
  // itoa() dropped leading zeroes, producing variable-length identifiers.
  snprintf(deviceIDString, sizeof(deviceIDString), "%08lx", (unsigned long)deviceID);

  return deviceIDString;
}


//*********************************//
// Screen Functions
//*********************************//

//***INITIALIZE SCREEN FUNCTION***//
// Function   : initScreen
//
// Description: This function initializes the screen
//
// Parameters : void
//
// Return     : void
//****************************************//
void initScreen() {
  if (USB_DEBUG) { Serial.println("USBDEBUG: initScreen()"); }
  screen.begin();         // Begin screen module
  //screen.splashScreen();  // Show splash screen
}

// (4.5.5 audit follow-up) The free closeMenu()/clearSplashScreen() wrappers
// that used to live here are gone: closeMenu had no callers (the serial
// CH,1:4 close and the STOP_MENU input action now call the freeze-aware
// LSScreen::closeMenu), and clearSplashScreen's body moved into
// LSScreen::finishSplashClear — a member so the continuation can reset
// _screenStateTimerId when it fires (the free function could not, which
// left the id naming a freed pool slot).

//***SCREEN TRANSITION CONTINUATION FUNCTIONS***//
// Free-function continuations for LSScreen::scheduleTransition() — the
// non-blocking replacements for the delay() calls that used to freeze the
// main loop while informational pages were shown. The screen timer calls
// these when a page's dwell time ends.
//
// Function   : screen transition continuations
//
// Description: Each hands the follow-up action to the matching LSScreen
//              method, which also clears the pending-transition state.
//
// Parameters : void
//
// Return     : void
//****************************************//
void screenExitTransitionDone() {
  screen.finishExitMenu();
}

void screenScrollTransitionDone() {
  screen.beginLongTextScroll();
}

void screenChangeModeTransitionDone() {
  screen.finishChangeMode();
}

void screenReturnToMenuTransitionDone() {
  screen.returnToMenu();
}

void screenFullCalibConfirmTransitionDone() {
  screen.fullCalibrationConfirmMenu();
}

void screenFactoryResetConfirm2TransitionDone() {
  screen.factoryResetConfirm2Menu();
}

void screenModeLockedTransitionDone() {
  screen.finishModeLocked();
}

// Destructive hold-gate note continuation (bench 2026-11-06): redraw the page
// the too-short hold came from (see finishHoldConfirmNote's dispatch).
void screenHoldConfirmNoteTransitionDone() {
  screen.finishHoldConfirmNote();
}

// Upstream #16: the Bluetooth host pages' dwell continuations (the switch
// EXECUTES at the end of its dwell — the CHANGING_MODE_PAGE pattern).
void screenBtSwitchTransitionDone() {
  screen.finishBtSwitch();
}

void screenBtNoteTransitionDone() {
  screen.finishBtNote();
}

//***SHOW CENTER RESET COMPLETE PAGE SCREEN FUNCTION***//
// Function   : showCenterResetComplete
//
// Description: This function shows the center reset complete page
//
// Parameters : void
//
// Return     : void
//****************************************//
void showCenterResetComplete() {
  // Show center reset complete page once center reset is done
  screen.centerResetCompletePage();
}

//***SCREEN LOOP FUNCTION***//
// Function   : screenLoop
//
// Description: This function handles updates to the screen.
//
// Parameters : void
//
// Return     : void
//****************************************//
void screenLoop() {
  //if (USB_DEBUG) { Serial.println("USBDEBUG: screenLoop"); }

  screen.update();  // Update the menu and screen

  //if (USB_DEBUG) { Serial.println("USBDEBUG: end of screenLoop"); }
}

//*********************************//
// Buzzer Functions
//*********************************//

//***INITIALIZE BUZZER FUNCTION***//
// Function   : initBuzzer
//
// Description: This function initializes the Buzzer as feedback method.
//
// Parameters : void
//
// Return     : void
//****************************************//
void initBuzzer() {
  if (USB_DEBUG) { Serial.println("USBDEBUG: Initializing Buzzer"); }

  buzzer.begin();             // Initialize buzzer for sound feedback
  buzzer.playStartupSound();  // Play a sound to indicate power-up
}

//***BUZZER ERROR CUE FUNCTION***//
// Function : buzzerErrorCue
//
// Description: One short, non-blocking error tone for refused interactions
//              (e.g. selecting a mode while the mode lock is on, roadmap
//              item 11) — "that input is locked", not "the device is
//              broken". Forwards to LSBuzzer::playErrorCue (4.5.7 review:
//              this used to call the ~1 s blocking playErrorSound, freezing
//              the whole loop on every refused press).
//
// Parameters : void
//
// Return : void
//****************************************//
void buzzerErrorCue() {
  buzzer.playErrorCue();
}


//*********************************//
// Acceleration Functions
//*********************************//

//***INITIALIZE ACCELERATION FUNCTION***//
// Function   : initAcceleration
//
// Description: This function loads the stored cursor acceleration level into
//              the live global the joystick output path reads (roadmap item
//              9 — the level is a stored setting since v4.0; the output
//              curve now actually applies it).
//
// Parameters : void
//
// Return     : void
//****************************************//
void initAcceleration() {
  if (USB_DEBUG) { Serial.println("USBDEBUG: initAcceleration()"); }
  acceleration = getJoystickAcceleration(false, false);
}

//*********************************//
// Communication Mode Functions
//*********************************//

//***INITIALIZE COMMUNICATION FUNCTION***//
// Function   : initCommunicationMode
//
// Description: This function initializes communication mode or configures communication mode
//              based on stored settings in the flash memory (0 = None , 1 = USB , 2 = Wireless)
//
// Parameters : void
//
// Return     : void
//****************************************//
void initCommunicationMode() {
  if (USB_DEBUG) { Serial.println("USBDEBUG: initCommunicationMode()"); }

  g_comMode = getCommunicationMode(false, false);

  if (USB_DEBUG) {
    Serial.print("USBDEBUG: g_comMode: ");
    Serial.println(g_comMode);
  }
}


//***USB CONNECTION LOOP FUNCTION***//
// Function   : usbConnectionLoop
//
// Description: This function checks status of USB connection
//
// Parameters : void
//
// Return     : void
//****************************************//
void usbConnectionLoop() {
  // Parked since 2025-Feb-21 (upstream TODO: "Disable usbConnectionLoop
  // until implemented"): the USB connection state it computed had no
  // consumer — errorCheck/usbCheckConnection read usbmouse.isReady()
  // directly — and the write-only global it fed is gone. The registration
  // below stays: the boot pool's nine registrations (including this one)
  // are what the app-repo lstimer-test harness models, and the slot stays
  // reserved for the feature. Disabled at boot; never runs.
}


//***USB CHECK CONNECTION FUNCTION***//
// Function   : usbConnectRearm
//
// Description: 4.6.6: the one-shot re-arm with delete-before-arm. Overwriting
//              usbConnectTimerId[0] while a predecessor one-shot is still
//              pending ORPHANED it — a direct call into usbCheckConnection
//              (the mouse busy-latch path can invoke it while a timer-fired
//              check is mid-episode) then left two pending one-shots that
//              each re-arm on fire, so the population stabilizes at 2: the
//              effective retry cadence doubles and g_usbConnectDelay grows
//              twice per period, defeating the documented 10 s backoff cap.
//              The id holder starts at -1 and deleteTimer(-1) is a no-op, so
//              delete-first is safe on every path including the first arm.
//
// Parameters : delayMs : unsigned long : delay before the next check
//
// Return     : void
//****************************************//
static void usbConnectRearm(unsigned long delayMs) {
  if (usbConnectTimerId[0] >= 0) usbConnectTimer.deleteTimer(usbConnectTimerId[0]);
  usbConnectTimerId[0] = usbConnectTimer.setTimeout(delayMs, usbCheckConnection);
}

// Function   : usbCheckConnection
//
// Description: This function checks if the USB connection is attempting to retry mounting, not ready, or timed out
//              In this case an error screen is shown, and the function is called again after a set time.
//              If the USB connection has not been made, it calls another instance of usb.begin.
//
// Parameters : void
//
// Return     : void
//****************************************//
void usbCheckConnection(void) {
  if (USB_DEBUG) { Serial.println("USBDEBUG: usbCheckConnection()"); }
  bootTrailStamp(6);  // witness v7: the USB connection check is running

  // Self-healing re-enumeration (bench 2026-10-16, second stuck-boot capture):
  // twice now a post-flash 4.5.0 boot came up CONFIGURED but permanently
  // HID-less — serial alive (the host completed SET_CONFIGURATION; TinyUSB's
  // tud_mounted() is cfg_num != 0 in this stack), every mouse report refused
  // (attempts climbing, successes 0) until a manual restart, and the
  // detach-until-descriptor-complete boot order did not prevent it. Whatever
  // the host's exact misstep (locking in a HID-less configuration, or wedging
  // the interrupt endpoint), it does not recover on its own, so the device
  // must force the issue: after CONF_USB_REENUM_AFTER_MS of continuous
  // not-ready, drop and re-raise the bus once — a fresh enumeration rebuilds
  // both the host's configuration and TinyUSB's endpoint state. Bounded at
  // CONF_USB_REENUM_MAX per episode, tracked only in the modes where a USB
  // HID interface is expected (BLE mouse and safe mode legitimately have
  // none). The detach drops the CDC session with it — but a device in this
  // state is already unusable, and on the post-flash boots where it strikes
  // the cycle lands within seconds of boot, before the app reconnects.
  bool usbHidExpected = ((g_operatingMode == CONF_OPERATING_MODE_MOUSE) && (g_comMode == CONF_COM_MODE_USB))
                      || (g_operatingMode == CONF_OPERATING_MODE_GAMEPAD);
  bool usbEpisodeJustStarted = false;
  if (usbHidExpected) {
    bool hidReadyNow = ((g_operatingMode == CONF_OPERATING_MODE_MOUSE) && usbmouse.isReady())
                    || ((g_operatingMode == CONF_OPERATING_MODE_GAMEPAD) && gamepad.isReady());
    if (hidReadyNow) {
      if (g_usbReenumCount > 0) {
        if (USB_DEBUG) {
          Serial.print("USB recovered after forced re-enumeration #");
          Serial.println(g_usbReenumCount);
        }
      }
      g_usbNotReadySinceMs = 0;  // Episode over
      g_usbReenumCount = 0;
      g_usbConnectDelay = CONF_USB_HID_INIT_DELAY;  // A later outage starts with the fast recovery cadence
      // The once-guard now lives in the reset reason itself: this healthy
      // boot will end in whatever reset ends it, and the auto-restart only
      // ever fires on boots that did NOT begin with a software reset.
    } else {
      if (outputAction == CONF_ACTION_DRAG || outputAction == CONF_ACTION_SCROLL) {
        releaseOutputAction();  // A disconnected host must not inherit a held mode on reconnect
      }
      if (g_usbNotReadySinceMs == 0) {
        g_usbNotReadySinceMs = millis();  // Episode begins
        usbEpisodeJustStarted = true;
      } else if ((millis() - g_usbNotReadySinceMs >= CONF_USB_REENUM_AFTER_MS) && (g_usbReenumCount < CONF_USB_REENUM_MAX)) {
        g_usbReenumCount++;
        if (USB_DEBUG) {
          Serial.print("USB forced re-enumeration #");
          Serial.print(g_usbReenumCount);
          Serial.print(" at ");
          Serial.println(millis());
        }
        USBDevice.detach();
        delay(CONF_USB_REENUM_DWELL_MS);  // Dark long enough for the host to tear the old configuration down
        USBDevice.attach();
        g_usbConnectDelay = CONF_USB_HID_INIT_DELAY;  // Resume fast checks while the fresh enumeration settles
        g_usbNotReadySinceMs = millis();              // Fresh budget for the fresh enumeration
      } else if ((millis() - g_usbNotReadySinceMs >= CONF_USB_REENUM_AFTER_MS) && (g_usbReenumCount >= CONF_USB_REENUM_MAX)
                 && !g_usbRecoveryRestartedPrev) {
        // The re-enumeration budget is spent and the HID interface is still
        // dead while serial lives — the host is not recovering this
        // composite, and no bus-level cycle left will change that (bench
        // 2026-10-17: a wedge survived three forced cycles). A full device
        // restart has cleared every such boot on the bench — fresh USB
        // peripheral, fresh address, seconds of bus darkness — so spend the
        // one auto-restart this recovery chain allows. The next boot wins the
        // enumeration the way every restart boot has; if it somehow wedges
        // again, the dedicated retained marker keeps this branch from firing and the
        // page + retry ticks carry on for the app/user to see honestly.
        // (4.5.7 review: the bootTrailStamp(5) that used to live here is
        // GONE — pt=5 is softwareReset's code, and double-booking it made
        // a post-mortem unable to tell a deliberate user/menu reset from
        // this USB-recovery restart. The stamp(6) at this function's entry
        // already names the true death context.)
        if (USB_DEBUG) {
          Serial.print("USB restarting device to recover the HID interface at ");
          Serial.println(millis());
        }
        screen.restartPage();
        delay(500);  // Bounded: drain the serial line and let the framebuffer push complete (bounded by Wire)
        // 4.6.6: skip the marker inside the Bluefruit.begin() window (neither
        // retention path is safe there — see lipsyncRetentionUnsafe). The
        // restart itself still fires; the only cost is the next boot treating
        // the reset as unattributed instead of USB-recovery, and a USB
        // recovery episode cannot even run on a BLE boot before its deferred
        // USB attach — this gate is symmetry with the other diagnostic writes.
        if (!lipsyncRetentionUnsafe()) {
          lipsyncRetentionUpdate(1, 0x1C, (uint8_t)(CONF_RETENTION_MARKER_USB_RECOVERY << 2));
        }
        NVIC_SystemReset();
      }
    }
  } else {
    g_usbNotReadySinceMs = 0;
    g_usbReenumCount = 0;
  }

  // Normal host enumeration is asynchronous and commonly outlives the first
  // few 20 ms report ticks. On the first observation, arm a quiet check and
  // return—do not draw an error page or call begin() again while the host is
  // still completing a healthy enumeration. Persistent outages re-enter the
  // normal ladder on that timeout.
  if (usbEpisodeJustStarted) {
    usbConnectRearm(CONF_USB_HID_INIT_DELAY);  // 4.6.6: delete-before-arm (was the one site that already deleted first)
    return;
  }


  if (usbmouse.usbRetrying || gamepad.usbRetrying) {

    if (usbmouse.usbRetrying) {
      if (USB_DEBUG) {
        Serial.print("Reattempting USB Mouse ");
        Serial.println(millis());
      }

      usbmouse.begin();
    } else if (gamepad.usbRetrying) {
      if (USB_DEBUG) {
        Serial.print("Reattempting USB Gamepad ");
        Serial.println(millis());
      }

      gamepad.begin();
    }

    screen.drawUsbErrorPageOnce();  // Draw at most once per episode (LSScreen gates display/bus health)

    // increase variable g_usbConnectDelay. Capped at 10 s (bench-observed
    // 2026-10-15): the ×1.2 growth used to run to 120 s to space an EXPENSIVE
    // tick — the old retry branch re-ran begin() and redrew the full
    // framebuffer every time (the 4.2.0 amplifier). Today's tick is cheap
    // (isReady reads, at most one draw), so a long backoff only delays the
    // ready screen behind actual host recovery: after a post-flash boot the
    // first ticks land before the host finishes configuring the composite
    // device, and by the time it is ready the next tick can be ~40 s out —
    // the No-USB page lingers on a device that is already working.
  if (g_usbConnectDelay < 10000) {
      unsigned int nextDelay = (unsigned int)(g_usbConnectDelay * 1.2f);
      g_usbConnectDelay = (nextDelay > 10000U) ? 10000U : nextDelay;
    }

    usbConnectRearm(g_usbConnectDelay);  // 4.6.6: delete-before-arm — keep retrying connection until USB connection is made

  } else if (((g_operatingMode == CONF_OPERATING_MODE_MOUSE) && (g_comMode == CONF_COM_MODE_USB) && (!usbmouse.isReady()))  // in usb mouse mode and usb mouse is not ready
      || ((g_operatingMode == CONF_OPERATING_MODE_GAMEPAD) && !gamepad.isReady())){                                         // in usb gamepad mode and usb gamepad is not ready

    screen.drawUsbErrorPageOnce();

    usbConnectRearm(g_usbConnectDelay);  // 4.6.6: delete-before-arm — keep retrying connection until USB connection is made


  } else if (usbmouse.timedOut && !usbmouse.isReady()) {
    // A report was attempted and the interface is genuinely still down —
    // keep the page and keep checking. A latched timedOut with a READY
    // interface (mouse reports suspended in gamepad/debug mode never clear
    // the latch themselves) falls through to the healthy branch instead of
    // parking here forever.
    screen.drawUsbErrorPageOnce();
    usbConnectRearm(g_usbConnectDelay);  // 4.6.6: delete-before-arm — keep retrying connection until USB connection is made
  } else {
    usbmouse.timedOut = false;  // Stale latch: the interface is ready, the episode is over
    usbmouse.consecutiveSkips = 0;  // 4.5.7 review: the skip counter must reset with the latch, or the first transient not-ready tick after recovery re-latches after ONE skip instead of three
    gamepad.timedOut = false;
    g_usbConnectDelay = CONF_USB_HID_INIT_DELAY;

    // Connection healthy. The page clear used to be one-shot — this branch
    // never re-armed — and resetUsbErrorPage cleared the episode latch even
    // when its draw was gated off, so a single tick landing while the bus
    // sat in its post-recovery window stranded the No-USB page on the OLED
    // for the rest of the boot (bench 2026-10-16, twice: stuck until a
    // manual restart on a device whose serial session worked the whole
    // time). The clear now reports success only when the ready page actually
    // landed; while it has not, re-arm and try again. The retry is cheap
    // (a gate check, at most one draw) and ends for good once the page
    // clears or there was never anything painted.
    if (screen.resetUsbErrorPage()) {
      readyToUse();
    } else {
      usbConnectRearm(1000);  // 4.6.6: delete-before-arm
    }
  }
}

//***TINYUSB MOUNT/UNMOUNT WITNESS CALLBACKS***//
// Function   : tud_mount_cb / tud_umount_cb
//
// Description: TinyUSB calls tud_mount_cb once the host has completed
//              SET_CONFIGURATION (in this stack tud_mounted() is cfg_num != 0)
//              and tud_umount_cb when the bus resets away from that state.
//              These hooks print one line per event so an exported session log
//              carries the host's configure/unconfigure timeline — the missing
//              witness in the post-flash stuck-boot forensics (bench
//              2026-10-16: BH showed "configured but HID never ready" with no
//              way to see WHEN the host configured or whether it ever tried
//              twice). extern "C" is required: TinyUSB looks for these as C
//              symbols and the sketch compiles as C++.
//
// Parameters : void
//
// Return     : void
//****************************************//
extern "C" void tud_mount_cb(void) {
  if (!USB_DEBUG) return;
  Serial.print("USB-EVT: configured at ");
  Serial.println(millis());
}

extern "C" void tud_umount_cb(void) {
  if (!USB_DEBUG) return;
  Serial.print("USB-EVT: unconfigured at ");
  Serial.println(millis());
}



//*********************************//
// Operating Mode Functions
//*********************************//



//***INITIALIZE OPERATING MODE FUNCTION***//
// Function   : initOperatingMode
//
// Description: This function initializes the operating mode from the stored
//              settings in flash memory (1 = Mouse, 2 = Gamepad; SAFE (3) is
//              a runtime-only state and never a valid stored value — see the
//              clamp below)
//
// Parameters : void
//
// Return     : void
//****************************************//
void initOperatingMode() {

  //g_operatingMode = getOperatingMode(false,false);
  g_operatingMode = mem.readInt(CONF_SETTINGS_FILE, "OM"); // retrieve operating mode from memory
  // Boot-load clamp (4.5.7 review): mode 0 has no beginComOpMode case and no
  // sender (the API now rejects it, CONF_OPERATING_MODE_MIN is 1) — but a
  // stored 0 from an old/hand-edited file booted a device whose BLE-poll
  // switch then hammered an uninitialized SoftDevice with a 1 s stall per
  // tick. Out of range falls back to the default mouse mode.
  if ((g_operatingMode < CONF_OPERATING_MODE_MIN) || (g_operatingMode > CONF_OPERATING_MODE_SETTABLE_MAX)) {
    g_operatingMode = CONF_OPERATING_MODE_DEFAULT;  // also catches a stored SAFE(3) — not a valid boot mode (4.5.7 review)
    if (mem.isLastReadOk()) {  // boot-path heal: a transient failed read is 0 too — never rewrite the stored mode from it (the getModelNumber pattern; the getOperatingMode fix's boot-side twin)
      mem.writeInt(CONF_SETTINGS_FILE, "OM", g_operatingMode);
    }
  }

}

//***CHANGE OPERATING MODE FUNCTION***//
// Function   : changeOperatingMode
//
// Description: Applies an operating-mode change by restarting the device —
//              the interfaces are re-begun for the stored mode on the next
//              boot. 4.9.1 (dead-store removal): persistence happens in the
//              CALLERS before this call (OM/CM store the pair, the menu's
//              finishChangeMode runs storeModePair), and softwareReset()
//              never returns — the trailing g_operatingMode assignment this
//              function used to carry was unreachable, and its "this is
//              where the mode is set" shape was a trap for exactly the
//              future editor who adds a bail-out return to softwareReset()
//              (the assignment would then flip the global AFTER
//              usbmouse.end()/btmouse.end() ran — the 4.5.7 "live mode
//              claims a mode the interfaces never entered" bug, recreated).
//
// Parameters : inputOperatingMode : int : The operating mode to change to
//
// Return     : void
//****************************************//
void changeOperatingMode(int inputOperatingState) {
  if (inputOperatingState != g_operatingMode) {
    softwareReset();  // never returns
  }
}


//***INITIALIZE OPERATING MODE FUNCTION***//
// Function   : beginComOpMode                  // TODO: rename this?
//
// Description: This function calls functions to initialize communication mode and operating mode
//              and begins instance of either USB mouse, Bluetooth mouse, or USB Gamepad
//
// Parameters : void
//
// Return     : void
//****************************************//
void beginComOpMode() {

  // Safe mode comes up CDC-only (4.5.7 review): checkSafeMode() runs BEFORE
  // this function now, so the decision is already made. Attach the bus for
  // serial recovery, but read NEITHER the stored operating mode (which would
  // overwrite the SAFE that checkSafeMode set) NOR the stored communication
  // mode (a stored BLE mode must not initialize the SoftDevice on a safe
  // boot), and begin NO mode interface. usbCheckConnection's episode
  // machinery already excludes safe mode from its HID-expected modes.
  if (g_safeModeEnabled) {
    if (USB_DEBUG) { Serial.println("USBDEBUG: beginComOpMode: Safe Mode (CDC-only)"); }
    USBDevice.attach();
    return;
  }

  initCommunicationMode();  // Retrieve communication mode from memory (None, USB, Bluetooth)
  initOperatingMode();      // Retrieve operating mode from memory (USB Mouse, Bluetooth Mouse, Gamepad)

  if (USB_DEBUG) {
    Serial.print(F("BOOT: com-op om="));
    Serial.print(g_operatingMode);
    Serial.print(F(" cm="));
    Serial.println(g_comMode);
  }

  // Cross-validate the loaded pair (4.5.7 review): the setters reject
  // gamepad+BLE, but the boot loaders clamp each value to its own range
  // only — a hand-edited/old settings file with OM=2+CM=2 booted a device
  // whose btFeedbackLoop then hammered the UNINITIALIZED SoftDevice for a
  // full second per poll (the bench-documented 1 s stall), and whose USB
  // recovery ladder never armed (it keys on the com mode, and the gamepad
  // paths never call usbCheckConnection themselves). Force the com mode to
  // USB, mirroring the setter contract, and persist the correction so the
  // file heals.
  if ((g_operatingMode == CONF_OPERATING_MODE_GAMEPAD) && (g_comMode == CONF_COM_MODE_BLE)) {
    g_comMode = CONF_COM_MODE_USB;
    mem.writeInt(CONF_SETTINGS_FILE, "CM", CONF_COM_MODE_USB);
    // 4.8.7 review: this in-place Serial.println ran BEFORE the USB attach —
    // inside TinyUSB's pre-open-port discard window — so the correction was
    // invisible to every host. The first-host-byte report block (which the
    // flag below arms) now carries the named line instead.
    g_comModeHealedThisBoot = true;
    g_bootReportWorthy = true;
  }

  // Bus up only after the selected interface is registered: setup() detached
  // at the top, CDC registered at Serial.begin(), and USB mouse/gamepad add
  // HID while still detached. This structurally closes the old CDC-only
  // descriptor race instead of relying on a host taking longer than the
  // attach->begin call gap to fetch descriptors. BLE/safe boots intentionally
  // attach CDC-only.
  switch (g_operatingMode) {
    case CONF_OPERATING_MODE_MOUSE:
      switch (g_comMode) {
        case CONF_COM_MODE_USB:  // USB Mouse
          usbmouse.begin();
          USBDevice.attach();
          break;
        case CONF_COM_MODE_BLE:  // Bluetooth Mouse
          {
            // 4.5.10: the name is copied to a STATIC buffer and the init is
            // DEFERRED to the 16 KB task (started at the end of setup) —
            // the loop task's 4 KB stack must not carry Bluefruit.begin.
            // 4.5.18: the USB attach is RESTORED TO THE STOCK ORDER —
            // enumerated BEFORE the SoftDevice comes up, exactly like the
            // stock blehid_mouse example and 4.1.0. The 4.5.11 deferral
            // was built on a since-RETRACTED claim (the core's USB/SD
            // coexistence hooks DO exist and begin() runs them itself),
            // and it left our boot attaching into a live SoftDevice — a
            // deviation no working recipe performs.
            USBDevice.attach();
            snprintf(g_bleDeviceName, sizeof(g_bleDeviceName), "LS_%s", g_deviceUID.c_str());
            g_bleInitPending = true;
            if (USB_DEBUG) { Serial.println(F("BOOT: BLE deferred to 16KB task")); }
          }
          break;
      }
      break;
    case CONF_OPERATING_MODE_GAMEPAD:  // USB Gamepad
      gamepad.begin();
      USBDevice.attach();
      break;
      // default: (SAFE is handled by the early return above)
  }
  if (USB_DEBUG) { Serial.println(F("BOOT: interfaces up")); }


  if (USB_DEBUG) {
    Serial.print("USBDEBUG: g_operatingMode: ");
    Serial.println(g_operatingMode);
  }

}  // end beginComOpMode

//*********************************//
// Input Functions
//*********************************//


//***INITIALIZE INPUTS FUNCTION***//
// Function   : initInput
//
// Description: This function initializes inputs including input buttons and input switches.
//
// Parameters : void
//
// Return     : void
//****************************************//
void initInput() {
  if (USB_DEBUG) { Serial.println("USBDEBUG: Initializing Input"); }
  
  // Hub Input Buttons
  ib.begin();                                                                      // Begin input buttons
  buttonActionSize = sizeof(buttonActionProperty) / sizeof(inputActionStruct);     // Size of total available input button actions
  buttonActionMaxTime = getActionMaxTime(buttonActionSize, buttonActionProperty);  // Maximum button action end time

  // Hub External Switch Inputs
  is.begin();                                                                      // Begin input switches
  switchActionSize = sizeof(switchActionProperty) / sizeof(inputActionStruct);     // Size of total available switch input actions
  switchActionMaxTime = getActionMaxTime(switchActionSize, switchActionProperty);  // Maximum switch action end time
  // Seed the live switch action table from the compiled one — remappable
  // cells (roadmap item 11's #20 follow-up) are overlaid by initSwitchActions()
  memcpy(g_switchActionTable, switchActionProperty, sizeof(switchActionProperty));
}

//***INITIALIZE RESTRICTIONS FUNCTION***//
// Function   : initRestrictions
//
// Description: Loads the input restriction settings (roadmap item 11) from
//              flash memory into the live gates. Runs before any input can
//              fire, so a locked-down configuration is in force from the
//              first tick of the input timers.
//
// Parameters : void
//
// Return     : void
//****************************************//
void initRestrictions() {
  if (USB_DEBUG) { Serial.println("USBDEBUG: initRestrictions()"); }
  getSapDisabled(false, false);
  getMenuButtonsOnly(false, false);
  getModeLocked(false, false);
  getCursorHoldDuringSap(false, false);
  // Input timing windows (roadmap item 15) load with the same stroke so the
  // first tick of the input timers already sees the user's windows.
  getInputWindowShort(false, false);
  getInputWindowLong(false, false);
  getInputWindowMax(false, false);
  sanitizeInputWindows();
  // External switch action remaps (#20) join the same stroke — the getters
  // apply any stored mapping onto the live table before the first tick.
  initSwitchActions();
  // Upstream #58: the hard-band action overrides (HA/HB) are applied onto the
  // live SAP table before the first input tick. A device without stored
  // HA/HB (any settings file written by older firmware) keeps the compiled
  // table byte-for-byte.
  initSapActions();
}

//***SANITIZE INPUT WINDOWS FUNCTION***//
// Function   : sanitizeInputWindows
//
// Description: Boot-load validation for the input timing windows (4.5.7
//              review): the getters apply whatever the settings file holds
//              with no range or ordering checks — asymmetric with the
//              switch-remap load path, which validates against its
//              allowlist. A hand-edited, corrupted, or foreign file could
//              load inverted windows (a quick puff firing the MAX row) or
//              out-of-range values. An offending stored value falls back to
//              the compiled default (0) IN MEMORY ONLY — the stored value
//              is healed to 0 (the compiled default) so a later API getter
//              cannot reload the bad value and undo the boot sanitizer.
//
// Parameters : void
//
// Return     : void
//****************************************//
void sanitizeInputWindows() {
  unsigned long shortEff = (g_inputWindowShortMs > 0) ? g_inputWindowShortMs : CONF_INPUT_WINDOW_SHORT_DEFAULT_MS;
  if (g_inputWindowShortMs > 0
      && (g_inputWindowShortMs < CONF_INPUT_WINDOW_SHORT_MIN_MS || g_inputWindowShortMs > CONF_INPUT_WINDOW_SHORT_MAX_MS
          || shortEff >= ((g_inputWindowLongMs > 0) ? g_inputWindowLongMs : CONF_INPUT_WINDOW_LONG_DEFAULT_MS))) {
    g_inputWindowShortMs = 0;
    mem.writeInt(CONF_SETTINGS_FILE, "WS", 0);
  }
  unsigned long longEff = (g_inputWindowLongMs > 0) ? g_inputWindowLongMs : CONF_INPUT_WINDOW_LONG_DEFAULT_MS;
  shortEff = (g_inputWindowShortMs > 0) ? g_inputWindowShortMs : CONF_INPUT_WINDOW_SHORT_DEFAULT_MS;
  if (g_inputWindowLongMs > 0
      && (g_inputWindowLongMs < CONF_INPUT_WINDOW_LONG_MIN_MS || g_inputWindowLongMs > CONF_INPUT_WINDOW_LONG_MAX_MS
          || longEff <= shortEff || longEff >= ((g_inputWindowMaxMs > 0) ? g_inputWindowMaxMs : CONF_INPUT_WINDOW_MAX_DEFAULT_MS))) {
    g_inputWindowLongMs = 0;
    mem.writeInt(CONF_SETTINGS_FILE, "WL", 0);
  }
  unsigned long maxEff = (g_inputWindowMaxMs > 0) ? g_inputWindowMaxMs : CONF_INPUT_WINDOW_MAX_DEFAULT_MS;
  longEff = (g_inputWindowLongMs > 0) ? g_inputWindowLongMs : CONF_INPUT_WINDOW_LONG_DEFAULT_MS;
  if (g_inputWindowMaxMs > 0
      && (g_inputWindowMaxMs < CONF_INPUT_WINDOW_MAX_MIN_MS || g_inputWindowMaxMs > CONF_INPUT_WINDOW_MAX_MAX_MS
          || maxEff <= longEff)) {
    g_inputWindowMaxMs = 0;
    mem.writeInt(CONF_SETTINGS_FILE, "WM", 0);
  }
}
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
