goforwest/LipSync/Build_Files/Firmware_Files/LipSync_Firmware/LSAPI.ino

/* 
* File: LSAPI.h
* Firmware: LipSync
* Developed by: MakersMakingChange
* Version: v4.1 (28 March 2025)
  License: GPL v3.0 or later

  Copyright (C) 2024 - 2025 Neil Squire Society
  This program is free software: you can redistribute it and/or modify it under the terms of
  the GNU General Public License as published by the Free Software Foundation,
  either version 3 of the License, or (at your option) any later version.
  This program is distributed in the hope that it will be useful, but WITHOUT ANY WARRANTY;
  without even the implied warranty of MERCHANTABILITY or FITNESS FOR A PARTICULAR PURPOSE.
  See the GNU General Public License for more details.
  You should have received a copy of the GNU General Public License along with this program.
  If not, see <http://www.gnu.org/licenses/>.
*/


//***API FUNCTIONS***// - DO NOT CHANGE
#include "LSApiDeclarations.h"  // Explicit declarations for the API surface (roadmap item 5) — the function table below references functions defined further down the merged tabs
#include "LSSerialTxQueue.h"
typedef void (*FunctionPointer)(bool, bool, String);      // Type definition for API function pointer

typedef struct {                                  // Type definition for API function list
  String endpoint;                                // Unique two character end point
  String code;                                    // Unique one character command code
  String parameter;                               // Parameter that is passed to function
  FunctionPointer function;                       // API function pointer
} _functionList;

// Declare individual API functions with command, parameter, and corresponding function
_functionList getModelNumberFunction =            {"MN", "0", "0", &getModelNumber};
_functionList getVersionNumberFunction =          {"VN", "0", "0", &getVersionNumber};
_functionList getDeviceIDFunction =               {"ID", "0", "0", &getDeviceID};
_functionList getOperatingModeFunction =          {"OM", "0", "0", &getOperatingMode};
_functionList setOperatingModeFunction =          {"OM", "1", "",  &setOperatingMode};
_functionList getCommunicationModeFunction =      {"CM", "0", "0", &getCommunicationMode};
_functionList setCommunicationModeFunction =      {"CM", "1", "",  &setCommunicationMode};
_functionList setModePresetFunction =             {"MP", "1", "",  &setModePreset};

_functionList getJoystickInitializationFunction = {"IN", "0", "0", &getJoystickInitialization};
_functionList setJoystickInitializationFunction = {"IN", "1", "1", &setJoystickInitialization};
_functionList getJoystickCalibrationFunction =    {"CA", "0", "0", &getJoystickCalibration};
_functionList setJoystickCalibrationFunction =    {"CA", "1", "1", &setJoystickCalibration};

_functionList getJoystickInnerDeadzoneFunction =  {"IZ", "0", "0", &getJoystickInnerDeadzone};
_functionList setJoystickInnerDeadzoneFunction =  {"IZ", "1", "",  &setJoystickInnerDeadzone};
_functionList getJoystickOuterDeadzoneFunction =  {"OZ", "0", "0", &getJoystickOuterDeadzone};
_functionList setJoystickUpperDeadzoneFunction =  {"OZ", "1", "",  &setJoystickOuterDeadzone};
_functionList getJoystickAccelerationFunction =   {"AV", "0", "0", &getJoystickAcceleration};
_functionList setJoystickAccelerationFunction =   {"AV", "1", "",  &setJoystickAcceleration};

_functionList getCursorSpeedFunction =            {"SS", "0", "0", &getCursorSpeed};
_functionList setCursorSpeedFunction =            {"SS", "1", "",  &setCursorSpeed};
_functionList getScrollLevelFunction =            {"SL", "0", "0", &getScrollLevel};
_functionList setScrollLevelFunction =            {"SL", "1", "",  &setScrollLevel};

_functionList getPressureValueFunction =          {"PV", "0", "0", &getPressureValue};
_functionList getBusHealthFunction =              {"BH", "0", "0", &getBusHealth};
_functionList getSipPressureThresholdFunction =   {"ST", "0", "0", &getSipPressureThreshold};
_functionList setSipPressureThresholdFunction =   {"ST", "1", "",  &setSipPressureThreshold};
_functionList getPuffPressureThresholdFunction =  {"PT", "0", "0", &getPuffPressureThreshold};
_functionList setPuffPressureThresholdFunction =  {"PT", "1", "",  &setPuffPressureThreshold};
// Upstream #58: hard sip/puff band (four keys living in /settings2.dat).
_functionList getHardSipPressureThresholdFunction =   {"HS", "0", "0", &getHardSipPressureThreshold};
_functionList setHardSipPressureThresholdFunction =   {"HS", "1", "",  &setHardSipPressureThreshold};
_functionList getHardPuffPressureThresholdFunction =  {"HP", "0", "0", &getHardPuffPressureThreshold};
_functionList setHardPuffPressureThresholdFunction =  {"HP", "1", "",  &setHardPuffPressureThreshold};
_functionList getHardSipActionFunction =              {"HA", "0", "0", &getHardSipAction};
_functionList setHardSipActionFunction =              {"HA", "1", "",  &setHardSipAction};
_functionList getHardPuffActionFunction =             {"HB", "0", "0", &getHardPuffAction};
_functionList setHardPuffActionFunction =             {"HB", "1", "",  &setHardPuffAction};

_functionList getSoundModeFunction =              {"SM", "0", "0", &getSoundMode};
_functionList setSoundModeFunction =              {"SM", "1", "",  &setSoundMode};
_functionList getLightModeFunction =              {"LM", "0", "0", &getLightMode};
_functionList setLightModeFunction =              {"LM", "1", "",  &setLightMode};
_functionList getLightBrightnessLevelFunction =   {"LL", "0", "0", &getLightBrightnessLevel};
_functionList setLightBrightnessLevelFunction =   {"LL", "1", "",  &setLightBrightnessLevel};

_functionList getSapDisabledFunction =             {"SD", "0", "0", &getSapDisabled};
_functionList setSapDisabledFunction =             {"SD", "1", "",  &setSapDisabled};
_functionList getMenuButtonsOnlyFunction =         {"MA", "0", "0", &getMenuButtonsOnly};
_functionList setMenuButtonsOnlyFunction =         {"MA", "1", "",  &setMenuButtonsOnly};
_functionList getModeLockedFunction =              {"LK", "0", "0", &getModeLocked};
_functionList setModeLockedFunction =              {"LK", "1", "",  &setModeLocked};
_functionList getCursorHoldFunction =              {"CF", "0", "0", &getCursorHoldDuringSap};
_functionList setCursorHoldFunction =              {"CF", "1", "",  &setCursorHoldDuringSap};

_functionList getInputWindowShortFunction =        {"WS", "0", "0", &getInputWindowShort};
_functionList setInputWindowShortFunction =        {"WS", "1", "",  &setInputWindowShort};
_functionList getInputWindowLongFunction =         {"WL", "0", "0", &getInputWindowLong};
_functionList setInputWindowLongFunction =         {"WL", "1", "",  &setInputWindowLong};
_functionList getInputWindowMaxFunction =          {"WM", "0", "0", &getInputWindowMax};
_functionList setInputWindowMaxFunction =          {"WM", "1", "",  &setInputWindowMax};

_functionList getSwitchActionSAFunction =          {"SA", "0", "0", &getSwitchActionSA};
_functionList setSwitchActionSAFunction =          {"SA", "1", "",  &setSwitchActionSA};
_functionList getSwitchActionSBFunction =          {"SB", "0", "0", &getSwitchActionSB};
_functionList setSwitchActionSBFunction =          {"SB", "1", "",  &setSwitchActionSB};
_functionList getSwitchActionSCFunction =          {"SC", "0", "0", &getSwitchActionSC};
_functionList setSwitchActionSCFunction =          {"SC", "1", "",  &setSwitchActionSC};
_functionList getSwitchActionGAFunction =          {"GA", "0", "0", &getSwitchActionGA};
_functionList setSwitchActionGAFunction =          {"GA", "1", "",  &setSwitchActionGA};
_functionList getSwitchActionGBFunction =          {"GB", "0", "0", &getSwitchActionGB};
_functionList setSwitchActionGBFunction =          {"GB", "1", "",  &setSwitchActionGB};
_functionList getSwitchActionGCFunction =          {"GC", "0", "0", &getSwitchActionGC};
_functionList setSwitchActionGCFunction =          {"GC", "1", "",  &setSwitchActionGC};

_functionList controlHubMenuFunction =            {"CH", "1", "",  &controlHubMenu};
_functionList getHubMenuStateFunction =           {"CH", "0", "0", &getHubMenuState};

// Upstream #16: multi-host Bluetooth switching (firmware 4.8.0+). BT,0 reads
// the host table (0 = count, 1..n = row), BT,1 switches, BT,2 forgets one
// bond, BT,3:1 ensures advertising for pair-new. The bond store is the
// vendored lib's /adafruit/bond_prph files — no settings keys involved.
_functionList getBluetoothHostFunction =          {"BT", "0", "",  &getBluetoothHost};
_functionList switchBluetoothHostFunction =       {"BT", "1", "",  &switchBluetoothHost};
_functionList forgetBluetoothHostFunction =       {"BT", "2", "",  &forgetBluetoothHost};
_functionList pairNewBluetoothHostFunction =      {"BT", "3", "1", &pairNewBluetoothHost};

_functionList getDebugModeFunction =              {"DM", "0", "0", &getDebugMode};
_functionList setDebugModeFunction =              {"DM", "1", "",  &setDebugMode};
_functionList getJoystickValueFunction =          {"JV", "0", "0", &getJoystickValue};

_functionList exportSettingsFunction =             {"EX", "0", "0", &exportSettings};

_functionList runTestFunction =                   {"RT", "1", "",  &runTest};
_functionList softResetFunction =                 {"SR", "1", "1", &softReset};
_functionList resetSettingsFunction =               {"RS", "1", "1", &resetSettings};
_functionList factoryResetFunction =               {"FR", "1", "1", &doFactoryReset};
_functionList enterUpdateModeFunction =            {"UM", "1", "1", &enterUpdateMode};

// Declare array of API functions
_functionList apiFunction[] = { //Let compiler determine number of functions
  getModelNumberFunction,
  getVersionNumberFunction,
  getDeviceIDFunction,
  getOperatingModeFunction,
  setOperatingModeFunction,
  getCommunicationModeFunction,
  setCommunicationModeFunction,
  setModePresetFunction,
  getJoystickInitializationFunction,
  setJoystickInitializationFunction,
  getJoystickCalibrationFunction,
  setJoystickCalibrationFunction,
  getJoystickInnerDeadzoneFunction,
  setJoystickInnerDeadzoneFunction,
  getJoystickOuterDeadzoneFunction,
  setJoystickUpperDeadzoneFunction,
  getCursorSpeedFunction,
  setCursorSpeedFunction,
  getScrollLevelFunction,
  setScrollLevelFunction,
  getJoystickValueFunction,
  getPressureValueFunction,
  getBusHealthFunction,
  getSipPressureThresholdFunction,
  setSipPressureThresholdFunction,
  getPuffPressureThresholdFunction,
  setPuffPressureThresholdFunction,
  getHardSipPressureThresholdFunction,
  setHardSipPressureThresholdFunction,
  getHardPuffPressureThresholdFunction,
  setHardPuffPressureThresholdFunction,
  getHardSipActionFunction,
  setHardSipActionFunction,
  getHardPuffActionFunction,
  setHardPuffActionFunction,
  getJoystickAccelerationFunction,
  setJoystickAccelerationFunction,
  getSoundModeFunction,
  setSoundModeFunction,
  getLightModeFunction,
  setLightModeFunction,
  getLightBrightnessLevelFunction,
  setLightBrightnessLevelFunction,
  getSapDisabledFunction,
  setSapDisabledFunction,
  getMenuButtonsOnlyFunction,
  setMenuButtonsOnlyFunction,
  getModeLockedFunction,
  setModeLockedFunction,
  getCursorHoldFunction,
  setCursorHoldFunction,
  getInputWindowShortFunction,
  setInputWindowShortFunction,
  getInputWindowLongFunction,
  setInputWindowLongFunction,
  getInputWindowMaxFunction,
  setInputWindowMaxFunction,
  getSwitchActionSAFunction,
  setSwitchActionSAFunction,
  getSwitchActionSBFunction,
  setSwitchActionSBFunction,
  getSwitchActionSCFunction,
  setSwitchActionSCFunction,
  getSwitchActionGAFunction,
  setSwitchActionGAFunction,
  getSwitchActionGBFunction,
  setSwitchActionGBFunction,
  getSwitchActionGCFunction,
  setSwitchActionGCFunction,
  controlHubMenuFunction,
  getHubMenuStateFunction,
  getBluetoothHostFunction,
  switchBluetoothHostFunction,
  forgetBluetoothHostFunction,
  pairNewBluetoothHostFunction,
  getDebugModeFunction,
  setDebugModeFunction,
  exportSettingsFunction,
  runTestFunction,
  softResetFunction,
  resetSettingsFunction,
  factoryResetFunction,
  enterUpdateModeFunction
};

//***SERIAL SETTINGS FUNCTION TO CHANGE SPEED AND COMMUNICATION MODE USING SOFTWARE***//

// Non-blocking input framing for the settings API. A host may terminate a
// message with a newline — it is framed and processed the instant it
// arrives, with no added latency — or, like the current LipSync Connect,
// send it bare and rely on an idle gap to delimit messages
// (SERIAL_FRAMING_GAP_MS, kept for wire compatibility with the tuned v4.x
// host). serialSettings() never blocks: it drains whatever bytes have
// arrived and returns, so the 20 ms joystick / 50 ms pressure ticks stay
// alive even mid-message. readString()'s timed busy-wait — whose timeout was
// the message delimiter, padding every exchange with a fixed delay (1 s per
// message at the Stream default) and freezing the loop while it spun — is
// gone entirely.
const unsigned long SERIAL_FRAMING_GAP_MS = 50;   // Idle that ends a legacy (bare) message
const size_t SERIAL_RX_MAX_LEN = 32;              // Longest legal command is 11 bytes; past this it is a flood
String serialRxBuf = "";
unsigned long serialRxBufLastByteMs = 0;

// Non-blocking response queue. Adafruit_USBD_CDC::write() spins/yields while
// DTR is asserted and its TX FIFO is full; a host that opens the port but
// stops reading could therefore freeze the assistive-device loop indefinitely.
// Canonical API/MANUAL/DEBUG lines enqueue here and loop() drains at most the
// FIFO space currently available. On overflow, stale whole lines are
// discarded so the newest response wins; a line whose prefix already reached
// USB is protected through its newline (LSSerialTxQueue).
const size_t SERIAL_TX_BUFFER_SIZE = 4096;
LSSerialTxQueue<SERIAL_TX_BUFFER_SIZE> serialTxQueue;

void serialTxService() {
  if (serialTxQueue.size() == 0 || !Serial) return;
  int available = Serial.availableForWrite();
  if (available <= 0) return;
  size_t toWrite = serialTxQueue.nextChunkSize((size_t)available);
  size_t written = Serial.write((const uint8_t*)serialTxQueue.readPointer(), toWrite);
  serialTxQueue.consume(written);
}

bool serialTxEnqueueLine(const char* line, size_t length) {
  // Preserve the stock CDC behavior: output generated before DTR opens is
  // discarded, not replayed as stale unsolicited traffic on the next session.
  if (!Serial) return false;
  if (!serialTxQueue.enqueueLine(line, length)) return false;
  serialTxService();
  return true;
}

bool serialTxEnqueueLine(const String &line) {
  return serialTxEnqueueLine(line.c_str(), line.length());
}

// Process one delimited message. Returns the settings-mode flag for the
// caller to carry across loop iterations.
bool processSerialMessage(String commandString, bool settingsFlag) {
  commandString.trim();  // Tolerate CR/LF line endings and stray whitespace
  // A newly received request takes priority over stale queued DEBUG/MANUAL
  // output. The host protocol is request/response sequential, so no valid
  // command response is pending when the next request arrives.
  serialTxQueue.prioritizeRequest();

  if (settingsFlag == false && commandString == "SETTINGS") {
    // SETTINGS received
    bootTrailStamp(7);  // witness v7: an actual serial message is being dispatched (stamped HERE, not on every idle loop pass, so pt=7 names a real dispatch site — 4.5.7 review)
    printResponseInt(true, true, true, 0, commandString, false, 0);
    return true;  // Enter settings mode
  } else if (settingsFlag == true && commandString == "EXIT") {
    bootTrailStamp(7);  // witness v7: an actual serial message is being dispatched
    // EXIT received
    printResponseInt(true, true, true, 0, commandString, false, 0);
    return false;  // Leave settings mode
  } else if (settingsFlag == true && isValidCommandFormat(commandString)) {
    bootTrailStamp(7);  // witness v7: an actual serial message is being dispatched
    performCommand(commandString);  // Valid command — run it and leave settings mode
    return false;
  }

  // Unrecognized input in either mode
  bootTrailStamp(7);  // witness v7: an actual serial message is being dispatched (unrecognized shape, but a dispatch)
  if (settingsFlag == true) {
    // 4.8.7 review: in-settings-mode garbage used to answer the SUCCESS
    // errno (FAIL,0) — the same numeral the not-in-settings-mode signal uses
    // — so the refusal class depended on message length (an 11-char bad
    // value got FAIL,3 from the setter's range check; a 12-char one got
    // FAIL,0 here). Answer the unknown-command errno instead. The mode still
    // exits (the deliberate recovery — a garbage flood ends the mode, and
    // the app's per-command SETTINGS handshake re-enters cleanly).
    printResponseInt(true, true, false, 1, commandString, false, 0);
  } else {
    printResponseInt(true, true, false, 0, commandString, false, 0);
  }
  return false;
}

// Function   : serialSettings
//
// Description: Drains pending serial bytes, framing messages on newline or
//              idle gap, and processes each through processSerialMessage().
//              Called every loop() pass; must never block.
//
// Parameters :  enabled : bool : The current settings-mode flag
//
// Return     : bool : The settings-mode flag to carry to the next pass
//*********************************************************************//
bool serialSettings(bool enabled) {
  bool settingsFlag = enabled;

  while (Serial.available() > 0) {
    char c = (char)Serial.read();
    serialRxBufLastByteMs = millis();

    if (c == '\n' || c == '\r') {
      if (serialRxBuf.length() == 0) continue;  // Blank line (e.g. the \n of a \r\n pair)
      String message = serialRxBuf;
      serialRxBuf = "";
      settingsFlag = processSerialMessage(message, settingsFlag);
      Serial.flush();
    } else {
      serialRxBuf += c;
      if (serialRxBuf.length() > SERIAL_RX_MAX_LEN) {
        // A flood with no terminator: discard and answer once (echo truncated).
        // 4.8.7 review: the unknown-command errno, not the SUCCESS errno —
        // an over-length line is a malformed command, not the "settings mode
        // not enabled" signal.
        String overflow = serialRxBuf.substring(0, SERIAL_RX_MAX_LEN);
        serialRxBuf = "";
        printResponseInt(true, true, false, 1, overflow, false, 0);
        settingsFlag = false;
      }
    }
  }

  // Legacy framing: a bare message ends when the line falls idle
  if (serialRxBuf.length() > 0 && millis() - serialRxBufLastByteMs >= SERIAL_FRAMING_GAP_MS) {
    String message = serialRxBuf;
    serialRxBuf = "";
    settingsFlag = processSerialMessage(message, settingsFlag);
    Serial.flush();
  }

  return settingsFlag;
}

//***PERFORM COMMAND FUNCTION TO CHANGE SETTINGS USING SOFTWARE***//
// Function   : performCommand
//
// Description: This function takes processes an input string from the serial and calls the
//              corresponding API function, or outputs an error.
//
// Parameters :  inputString : String : The input command as a string.
//
// Return     : void
//*********************************//
void performCommand(String inputString) {
  int inputIndex = inputString.indexOf(':');
  if (inputIndex < 0) {
    printResponseInt(true, true, false, 1, inputString, false, 0);
    return;
  }

  // Extract command string from input string
  String inputCommandString = inputString.substring(0, inputIndex);

  int inputCommandIndex = inputCommandString.indexOf(',');
  if (inputCommandIndex < 0) {
    printResponseInt(true, true, false, 1, inputString, false, 0);
    return;
  }

  String inputEndpointString = inputCommandString.substring(0, inputCommandIndex);

  String inputCodeString = inputCommandString.substring(inputCommandIndex + 1);

  // Extract parameter string from input string
  String inputParameterString = inputString.substring(inputIndex + 1);

  // Determine total number of API commands
  int apiTotalNumber = sizeof(apiFunction) / sizeof(apiFunction[0]);

  // Iterate through each API command
  for (int apiIndex = 0; apiIndex < apiTotalNumber; apiIndex++) {

    // Test if input command string matches API command and input parameter string matches API parameter string
    if (inputEndpointString == apiFunction[apiIndex].endpoint &&
        inputCodeString == apiFunction[apiIndex].code) {

      // Matching Command String found
      // Only the six analog settings accept a decimal point. Every other
      // endpoint is integer-valued; accepting "1.9" and then calling toInt()
      // silently executed it as 1 instead of rejecting malformed input.
      bool floatParameter = (inputCodeString == "1") &&
                            (inputEndpointString == "IZ" || inputEndpointString == "OZ" ||
                             inputEndpointString == "ST" || inputEndpointString == "PT" ||
                             inputEndpointString == "HS" || inputEndpointString == "HP");
      if (!isValidCommandParameter(inputParameterString) ||
          (!floatParameter && inputParameterString.indexOf('.') >= 0)) {
        printResponseInt(true, true, false, 2, inputString, false, 0);
      }
      else if (inputParameterString == apiFunction[apiIndex].parameter || apiFunction[apiIndex].parameter == "") {
        apiFunction[apiIndex].function(true, true, inputParameterString);
      }
      else { // Invalid input parameter

        // Outut error message
        printResponseInt(true, true, false, 3, inputString, false, 0);
      }
      break;
    } else if (apiIndex == (apiTotalNumber - 1)) { // api doesn’t exist

      // Output error message
      printResponseInt(true, true, false, 1, inputString, false, 0);

      //delay(5);
      break;
    }
  } // end iterate through API functions

}

//***VALIDATE INPUT COMMAND FORMAT FUNCTION***//
// Function   : isValidCommandFormat
//
// Description: This function confirms command string has correct format.
//              It returns true if the string has a correct format.
//              It returns false if the string doesn't have a correct format.
//
// Parameters :  inputCommandString : String : The input string
//
// Return     : boolean
//***********************************************//
bool isValidCommandFormat(String inputCommandString) {
  bool isValidFormat = false;
  if ((inputCommandString.length() == (6) || // XX,d:d
       inputCommandString.length() == (7) || // XX,d:dd
       inputCommandString.length() == (8) || // XX,d:ddd
       inputCommandString.length() == (9) || // XX,d:dddd
       inputCommandString.length() == (10) || // XX,d:ddddd
       inputCommandString.length() == (11)) && inputCommandString.charAt(2) == ',' && inputCommandString.charAt(4) == ':') { // XX,d:dddddd
    isValidFormat = true;
  }
  return isValidFormat;
}

//***VALIDATE INPUT COMMAND PARAMETER FUNCTION***//
// Function   : isValidCommandParameter
//
// Description: This function checks if the input string is a valid command parameters.
//              It returns true if the string includes valid parameters.
//              It returns false if the string includes invalid parameters.
//
// Parameters :  inputParamterString : String : The input string
//
// Return     : boolean
//*************************************************//
bool isValidCommandParameter(String inputParameterString) {
  if (isStrNumber(inputParameterString)) {
    return true;
  }
  return false;
}

//***CHECK IF STRING IS A NUMBER FUNCTION***//
// Function   : isStrNumber
//
// Description: This function checks if the input string is a number.
//              It returns true if the string includes all numeric characters.
//              It returns false if the string includes a non numeric character.
//
//              (4.5.7 review) A real numeric grammar, not a per-character
//              test: the old form accepted '+'/'-'/'.' ANYWHERE, so
//              "1-2-3" and "1.2.3" passed and relied on downstream range
//              checks to catch the toInt() truncations. Optional single
//              leading sign, digits, at most one decimal point.
//
// Parameters :  str : String : The input string
//
// Return     : boolean
//******************************************//
boolean isStrNumber(String str) {
  if (str.length() == 0) return false;
  unsigned int startIndex = 0;
  boolean hasDecimal = false;
  boolean hasDigit = false;
  if (str.charAt(0) == '-' || str.charAt(0) == '+') {
    startIndex = 1;
    if (str.length() == 1) return false;  // A bare sign is not a number
  }
  for (unsigned int i = startIndex; i < str.length(); i++) {
    char c = str.charAt(i);
    if (isDigit(c)) {
      hasDigit = true;
      continue;
    }
    if (c == '.' && !hasDecimal) {
      hasDecimal = true;
      continue;
    }
    return false;  // Non numeric character detected
  }
  return hasDigit;  // A decimal point (with or without a sign) is not a number
}

//***CHECK IF CHAR IS A VALID DELIMITER FUNCTION***//
// Function   : isValidDelimiter
//
// Description: This function checks if the input char is a valid delimiter.
//              It returns true if the character is a valid delimiter.
//              It returns false if the character is not a valid delimiter.
//
// Parameters :  inputDelimiter : char : The input char delimiter
//
// Return     : boolean
//******************************************//
bool isValidDelimiter(char inputDelimiter) {
  bool validOutput;

  (inputDelimiter == ',' || inputDelimiter == ':' || inputDelimiter == '-') ? validOutput = true : validOutput = false;

  return validOutput;
}


//***GET MODEL NUMBER FUNCTION***//
// Function   : getModelNumber
//
// Description: This function retrieves the current LipSync firmware model number.
//
// Parameters :  responseEnabled : bool : The response for serial printing is enabled if it's set to true.
//                                        The serial printing is ignored if it's set to false.
//               apiEnabled : bool : The api response is sent if it's set to true.
//                                   Manual response is sent if it's set to false.
//
// Return     : void
//*********************************//
void getModelNumber(bool responseEnabled, bool apiEnabled) {
  String commandKey = "MN";
  int tempModelNumber = mem.readInt(CONF_SETTINGS_FILE, commandKey);
  if (tempModelNumber != CONF_LIPSYNC_MODEL) {                          // If the previous firmware was different model then reset the settings
    // MN=0 is the compiled fresh-file placeholder, not another model. Only
    // reset a successfully read, genuinely different model; a transient
    // failed read also converts to 0 and must never erase valid settings.
    if (mem.isLastReadOk() && tempModelNumber != 0) {
      resetSettings(false, false);
    }

    tempModelNumber = CONF_LIPSYNC_MODEL;                               // And store the model number
    if (mem.isLastReadOk()) {
      mem.writeInt(CONF_SETTINGS_FILE, commandKey, tempModelNumber);
    }
  }
  printResponseInt(responseEnabled, apiEnabled, true, 0, "MN,0", true, tempModelNumber);

}
//***GET MODEL NUMBER API FUNCTION***//
// Function   : getModelNumber
//
// Description: This function is redefinition of main getModelNumber function to match the types of API function arguments.
//
// Parameters :  responseEnabled : bool : The response for serial printing is enabled if it's set to true.
//                                        The serial printing is ignored if it's set to false.
//               apiEnabled : bool : The api response is sent if it's set to true.
//                                   Manual response is sent if it's set to false.
//               optionalParameter : String : The input parameter string should contain one element with value of zero.
//
// Return     : void
void getModelNumber(bool responseEnabled, bool apiEnabled, String optionalParameter) {
  if (optionalParameter.length() == 1 && optionalParameter.toInt() == 0) {
    getModelNumber(responseEnabled, apiEnabled);
  }
}

//***GET VERSION FUNCTION***//
// Function   : getVersionNumber
//
// Description: This function retrieves the current LipSync firmware version number.
//
// Parameters :  responseEnabled : bool : The response for serial printing is enabled if it's set to true.
//                                        The serial printing is ignored if it's set to false.
//               apiEnabled : bool : The api response is sent if it's set to true.
//                                   Manual response is sent if it's set to false.
//
// Return     : void
//*********************************//
void getVersionNumber(bool responseEnabled, bool apiEnabled) {
  String commandKey = "VN";
  
  int tempMajorVersionNumber = mem.readInt(CONF_SETTINGS_FILE, "VN1");
  int tempMinorVersionNumber = mem.readInt(CONF_SETTINGS_FILE, "VN2");
  int tempRevVersionNumber   = mem.readInt(CONF_SETTINGS_FILE, "VN3");

  // (4.9.0 review) These heal-writes are deliberately NOT wrapped in an
  // extra isLastReadOk gate of their own — the one exemption to pin, with
  // its argument: the only legal stored values for VN1/2/3 ARE the compiled
  // constants, so even on a transient failed read (which yields 0) the
  // local assignments above restore the true constants and VN,0 answers
  // correctly; the writer family's own read-truth refusal skips the file
  // write on the failed read (harmless — the next good read heals it), and
  // a truly corrupt file is initialize()'s re-seed at the next boot.
  // Gating the LOCAL assignments instead would answer VN,0:0 on a transient
  // read failure and desync the app's version detection for nothing. Any
  // future key added to this path must re-derive this argument.
  
  if (tempMajorVersionNumber != CONF_LIPSYNC_VERSION_MAJOR) {                          // If the previous firmware was different version then reset the settings
    // could add factory reset here if version number saved in memory is different
    tempMajorVersionNumber = CONF_LIPSYNC_VERSION_MAJOR;                               // And store the version number
    mem.writeInt(CONF_SETTINGS_FILE, "VN1", tempMajorVersionNumber);
    
    tempMinorVersionNumber = CONF_LIPSYNC_VERSION_MINOR;                               // And store the version number
    mem.writeInt(CONF_SETTINGS_FILE, "VN2", tempMinorVersionNumber);

    tempRevVersionNumber = CONF_LIPSYNC_VERSION_REV;                               // And store the version number
    mem.writeInt(CONF_SETTINGS_FILE, "VN3", tempRevVersionNumber);
  }

  else if (tempMinorVersionNumber != CONF_LIPSYNC_VERSION_MINOR) {                     // If the previous firmware was different version then reset the settings
    // could reset some settings here if version number saved in memory is different
    tempMinorVersionNumber = CONF_LIPSYNC_VERSION_MINOR;                               // And store the version number
    mem.writeInt(CONF_SETTINGS_FILE, "VN2", tempMinorVersionNumber);

    tempRevVersionNumber = CONF_LIPSYNC_VERSION_REV;                                    // And store the version number
    mem.writeInt(CONF_SETTINGS_FILE, "VN3", tempRevVersionNumber);
  }

  else if (tempRevVersionNumber != CONF_LIPSYNC_VERSION_REV) {                          // If the previous firmware was different version then reset the settings
    tempRevVersionNumber = CONF_LIPSYNC_VERSION_REV;                                    // And store the version number
    mem.writeInt(CONF_SETTINGS_FILE, "VN3", tempRevVersionNumber);
  }
  

  String tempLipsyncVersionStr = String(tempMajorVersionNumber) + "." + String(tempMinorVersionNumber) + "." + String(tempRevVersionNumber);
  
  printResponseString(responseEnabled, apiEnabled, true, 0, "VN,0", true, tempLipsyncVersionStr);
}
//***GET VERSION API FUNCTION***//
// Function   : getVersionNumber
//
// Description: This function is redefinition of main getVersionNumber function to match the types of API function arguments.
//
// Parameters :  responseEnabled : bool : The response for serial printing is enabled if it's set to true.
//                                        The serial printing is ignored if it's set to false.
//               apiEnabled : bool : The api response is sent if it's set to true.
//                                   Manual response is sent if it's set to false.
//               optionalParameter : String : The input parameter string should contain one element with value of zero.
//
// Return     : void
void getVersionNumber(bool responseEnabled, bool apiEnabled, String optionalParameter) {
  if (optionalParameter.length() == 1 && optionalParameter.toInt() == 0) {
    getVersionNumber(responseEnabled, apiEnabled);
  }
}

//***GET DEVICE ID FUNCTION***//
// Function   : getDeviceID
//
// Description: This function retrieves the UID from the device
//
// Parameters :  responseEnabled : bool : The response for serial printing is enabled if it's set to true.
//                                        The serial printing is ignored if it's set to false.
//               apiEnabled : bool : The api response is sent if it's set to true.
//                                   Manual response is sent if it's set to false.
//
// Return     : void
//*********************************//
void getDeviceID(bool responseEnabled, bool apiEnabled) {
  String commandKey = "ID";
  String tempDeviceID = mem.readString(CONF_SETTINGS_FILE, commandKey);
  String deviceID = readUID();
 
  if (tempDeviceID != deviceID) {  // If string doesn't match, store to memory
    mem.writeString(CONF_SETTINGS_FILE, commandKey, deviceID);
  }
  // (4.9.0 review) Deliberately NOT wrapped in its own isLastReadOk gate —
  // the same pinned exemption as getVersionNumber: the answer is the chip's
  // live UID (always the truth), and the write family's read-truth refusal
  // skips the file write on a failed read (harmless — the next good read
  // heals the file).
  if (deviceID.length() > 0) {
    g_deviceUID = deviceID; // Update global variable
  }
  
  // Answer the ID now in force (the chip's real UID): on a fresh settings
  // file the stored value is the compiled placeholder, and answering it made
  // the FIRST read after a factory reset (or any board swap) report a value
  // the device had already replaced in memory — the truth only arrived on
  // the second read.
  if (deviceID.length() == 0) {
    deviceID = tempDeviceID;
  }
  printResponseString(responseEnabled, apiEnabled, true, 0, "ID,0", true, deviceID);

}
//***GET DEVICE ID API FUNCTION***//
// Function   : getDeviceID
//
// Description: This function is redefinition of main getDeviceID function to match the types of API function arguments.
//
// Parameters :  responseEnabled : bool : The response for serial printing is enabled if it's set to true.
//                                        The serial printing is ignored if it's set to false.
//               apiEnabled : bool : The api response is sent if it's set to true.
//                                   Manual response is sent if it's set to false.
//               optionalParameter : String : The input parameter string should contain one element with value of zero.
//
// Return     : void
void getDeviceID(bool responseEnabled, bool apiEnabled, String optionalParameter) {
  if (optionalParameter.length() == 1 && optionalParameter.toInt() == 0) {
    getDeviceID(responseEnabled, apiEnabled);
  }
}

//***GET OPERATING MODE STATE FUNCTION***//
// Function   : getOperatingMode
//
// Description: This function retrieves the state of operating mode.
//
// Parameters :  responseEnabled : bool : The response for serial printing is enabled if it's set to true.
//                                        The serial printing is ignored if it's set to false.
//               apiEnabled : bool : The api response is sent if it's set to true.
//                                   Manual response is sent if it's set to false.
//
// Return     : operatingState : intol : The current state of operating mode.
//*********************************//
int getOperatingMode(bool responseEnabled, bool apiEnabled) {
  String commandKey = "OM";
  int tempOperatingMode;
  tempOperatingMode = mem.readInt(CONF_SETTINGS_FILE, commandKey);

  if ((tempOperatingMode < CONF_OPERATING_MODE_MIN) || (tempOperatingMode > CONF_OPERATING_MODE_SETTABLE_MAX)) {  // SAFE is not a stored value (4.5.7 review)
    tempOperatingMode = CONF_OPERATING_MODE_DEFAULT;
    // Heal only a genuinely out-of-range STORED value (the getModelNumber
    // pattern): a transient failed read also converts to 0, and rewriting
    // the key from it would overwrite the user's real mode on the wire AND
    // at the next boot.
    if (mem.isLastReadOk()) {
      mem.writeInt(CONF_SETTINGS_FILE, commandKey, tempOperatingMode);
    }
  }

  printResponseInt(responseEnabled, apiEnabled, true, 0, "OM,0", true, tempOperatingMode);

  return tempOperatingMode;
}
//***GET OPERATING MODE STATE API FUNCTION***//
// Function   : getOperatingMode
//
// Description: This function is redefinition of main getOperatingMode function to match the types of API function arguments.
//
// Parameters :  responseEnabled : bool : The response for serial printing is enabled if it's set to true.
//                                        The serial printing is ignored if it's set to false.
//               apiEnabled : bool : The api response is sent if it's set to true.
//                                   Manual response is sent if it's set to false.
//               optionalParameter : String : The input parameter string should contain one element with value of zero.
//
// Return     : void
void getOperatingMode(bool responseEnabled, bool apiEnabled, String optionalParameter) {
  if (optionalParameter.length() == 1 && optionalParameter.toInt() == 0) {
    getOperatingMode(responseEnabled, apiEnabled);
  }
}

//***SET OPERATING MODE STATE FUNCTION***//
// Function   : setOperatingMode
//
// Description: This function sets the state of operating mode.
//
// Parameters :  responseEnabled : bool : The response for serial printing is enabled if it's set to true.
//                                        The serial printing is ignored if it's set to false.
//               apiEnabled : bool : The api response is sent if it's set to true.
//                                   Manual response is sent if it's set to false.
//               inputOperatingMode : int : The new operating mode state 
//
// Return     : void
//*********************************//
void setOperatingMode(bool responseEnabled, bool apiEnabled, int inputOperatingMode) {
  String commandKey = "OM";

  if ((inputOperatingMode >= CONF_OPERATING_MODE_MIN) && (inputOperatingMode <= CONF_OPERATING_MODE_SETTABLE_MAX)) {  // SETTABLE_MAX excludes SAFE (4.5.7 review)
    if ((g_comMode == CONF_COM_MODE_BLE) && (inputOperatingMode == CONF_OPERATING_MODE_GAMEPAD)){
      printResponseInt(responseEnabled, apiEnabled, false, 3, "OM,1", true, inputOperatingMode);    // Return error if user tries to change to Bluetooth mode while in Gamepad mode
    } else if (mem.writeInt(CONF_SETTINGS_FILE, commandKey, inputOperatingMode)) {
      // The settings-size budget guard can refuse the write (LSMemory) — a
      // refused write must never report SUCCESS or change the live mode, or
      // the app's readout and the device would disagree after a reboot.
      printResponseInt(responseEnabled, apiEnabled, true, 0, "OM,1", true, inputOperatingMode);
      // THE 4.5.7 FIX: g_operatingMode is NOT assigned here anymore.
      // changeOperatingMode() compares its argument against g_operatingMode
      // and resets the device when they differ — assigning the global
      // BEFORE the call (4.1.0 left the call commented out; uncommenting
      // it without reordering) made the comparison always true, so the
      // reset-on-change NEVER fired: a serial OM,1:2 left the gamepad HID
      // interface never-begun while the live mode claimed gamepad — every
      // report went out the mouse interface (the release toolchain's
      // TinyUSB hardwires instance 0), with telemetry counting the
      // misrouted reports as successes. The global now flips only inside
      // changeOperatingMode, exactly as its contract reads; the ack above
      // reaches the host during the reset's deliberate shutdown dwell.
      changeOperatingMode(inputOperatingMode);
    } else {
      printResponseInt(responseEnabled, apiEnabled, false, 3, "OM,1", true, inputOperatingMode);
    }
  }
  else {
    printResponseInt(responseEnabled, apiEnabled, false, 3, "OM,1", true, inputOperatingMode);
  }
}
//***SET OPERATING MODE STATE API FUNCTION***//
// Function   : setOperatingMode
//
// Description: This function is redefinition of main setOperatingMode function to match the types of API function arguments.
//
// Parameters :  responseEnabled : bool : The response for serial printing is enabled if it's set to true.
//                                        The serial printing is ignored if it's set to false.
//               apiEnabled : bool : The api response is sent if it's set to true.
//                                   Manual response is sent if it's set to false.
//               optionalParameter : String : The input parameter string should contain one element with value of zero.
//
// Return     : void
void setOperatingMode(bool responseEnabled, bool apiEnabled, String optionalParameter) {
  setOperatingMode(responseEnabled, apiEnabled, optionalParameter.toInt());
}


//***GET JOYSTICK CURSOR SPEED FUNCTION***//
// Function   : getCursorSpeed
//
// Description: This function retrieves the current joystick speed level.
//
// Parameters :  responseEnabled : bool : The response for serial printing is enabled if it's set to true.
//                                        The serial printing is ignored if it's set to false.
//               apiEnabled : bool : The api response is sent if it's set to true.
//                                   Manual response is sent if it's set to false.
//
// Return     : void
//*********************************//
int getCursorSpeed(bool responseEnabled, bool apiEnabled) {
  String commandKey = "SS";
  // 4.9.1 read-truth doctrine (see getSapDisabled): a failed read must not
  // re-apply the compiled default to the live joystick (the old shape
  // silently rescaled every user's cursor on a transient read failure);
  // the answer is the in-force level instead.
  int tempCursorSpeedLevel;
  if (CONF_API_ENABLED) {
    int stored = mem.readInt(CONF_SETTINGS_FILE, commandKey);
    if (mem.isLastReadOk()) {
      if ((stored < CONF_JOY_CURSOR_SPEED_LEVEL_MIN) || (stored > CONF_JOY_CURSOR_SPEED_LEVEL_MAX)) {
        stored = CONF_JOY_CURSOR_SPEED_LEVEL_DEFAULT;
        mem.writeInt(CONF_SETTINGS_FILE, commandKey, stored);
      }
      js.setOutputRange(stored);
      tempCursorSpeedLevel = stored;
    } else {
      tempCursorSpeedLevel = js.getOutputRange();  // the in-force level, not a readback
    }
  } else {
    tempCursorSpeedLevel = CONF_JOY_CURSOR_SPEED_LEVEL_DEFAULT;
    js.setOutputRange(tempCursorSpeedLevel);
  }
  printResponseInt(responseEnabled, apiEnabled, true, 0, "SS,0", true, tempCursorSpeedLevel);

  return tempCursorSpeedLevel;
}
//***GET JOYSTICK SPEED API FUNCTION***//
// Function   : getCursorSpeed
//
// Description: This function is redefinition of main getCursorSpeed function to match the types of API function arguments.
//
// Parameters :  responseEnabled : bool : The response for serial printing is enabled if it's set to true.
//                                        The serial printing is ignored if it's set to false.
//               apiEnabled : bool : The api response is sent if it's set to true.
//                                   Manual response is sent if it's set to false.
//               optionalParameter : String : The input parameter string should contain one element with value of zero.
//
// Return     : void
void getCursorSpeed(bool responseEnabled, bool apiEnabled, String optionalParameter) {
  if (optionalParameter.length() == 1 && optionalParameter.toInt() == 0) {
    getCursorSpeed(responseEnabled, apiEnabled);
  }
}

//***SET JOYSTICK SPEED FUNCTION***//
// Function   : setCursorSpeed
//
// Description: This function sets the current joystick speed level.
//
// Parameters :  responseEnabled : bool : The response for serial printing is enabled if it's set to true.
//                                        The serial printing is ignored if it's set to false.
//               apiEnabled : bool : The api response is sent if it's set to true.
//                                   Manual response is sent if it's set to false.
//               inputSpeedLevel : bool : The new joystick speed level.
//
// Return     : void
//*********************************//
void setCursorSpeed(bool responseEnabled, bool apiEnabled, int inputSpeedLevel) {
  String commandKey = "SS";
  bool isValidSpeed = true;
  int tempCursorSpeedLevel = inputSpeedLevel;
  
  if ((tempCursorSpeedLevel >= CONF_JOY_CURSOR_SPEED_LEVEL_MIN) && (tempCursorSpeedLevel <= CONF_JOY_CURSOR_SPEED_LEVEL_MAX)) { // Check if inputSpeedCounter is valid
    // Valid inputSpeedLevel — the settings-size budget guard can still refuse
    // the store (LSMemory), which must read as a failed write, not a silent
    // success the next boot forgets.
    isValidSpeed = mem.writeInt(CONF_SETTINGS_FILE, commandKey, tempCursorSpeedLevel);
    if (!isValidSpeed) {
      // 4.6.6: fall back to the IN-FORCE level (the joystick's own live
      // value), not a file readback. readInt yields 0 for an unreadable file
      // (open/parse failure mid-session), which used to silently degrade the
      // live cursor to the slowest setting for the rest of the boot while
      // the endpoint answered FAIL,3 — breaking the setter's own "a refused
      // store leaves the live value untouched" contract. With a healthy
      // file the readback and the live value agree (every load/GET applies
      // the stored level onto js), so the live value is at least as correct.
      tempCursorSpeedLevel = js.getOutputRange();
    }
    if (!CONF_API_ENABLED && isValidSpeed) {
      tempCursorSpeedLevel = CONF_JOY_CURSOR_SPEED_LEVEL_DEFAULT;
    }
    performLedAction(ledCurrentState);
  }
  else {
    // Invalid inputSpeedLevel — answer the in-force value, not a readback
    // that degenerates to 0 on an unreadable file (4.6.6, as above).
    tempCursorSpeedLevel = js.getOutputRange();
    performLedAction(ledCurrentState);
    isValidSpeed = false;
  }

  js.setOutputRange(tempCursorSpeedLevel);

  int responseCode = 0;
  (isValidSpeed) ? responseCode = 0 : responseCode = 3;
  printResponseInt(responseEnabled, apiEnabled, isValidSpeed, responseCode, "SS,1", true, tempCursorSpeedLevel);
}
//***SET JOYSTICK SPEED API FUNCTION***//
// Function   : setCursorSpeed
//
// Description: This function is redefinition of main setCursorSpeed function to match the types of API function arguments.
//
// Parameters :  responseEnabled : bool : The response for serial printing is enabled if it's set to true.
//                                        The serial printing is ignored if it's set to false.
//               apiEnabled : bool : The api response is sent if it's set to true.
//                                   Manual response is sent if it's set to false.
//               optionalParameter : String : The input parameter string should contain one element with value of zero.
//
// Return     : void
void setCursorSpeed(bool responseEnabled, bool apiEnabled, String optionalParameter) {
  setCursorSpeed(responseEnabled, apiEnabled, optionalParameter.toInt());
}


//***GET SCROLL LEVEL FUNCTION***//
// Function   : getScrollLevel
//
// Description: This function retrieves the current scroll level.
//
// Parameters :  responseEnabled : bool : The response for serial printing is enabled if it's set to true.
//                                        The serial printing is ignored if it's set to false.
//               apiEnabled : bool : The api response is sent if it's set to true.
//                                   Manual response is sent if it's set to false.
//
// Return     : void
//*********************************//
int getScrollLevel(bool responseEnabled, bool apiEnabled) {
  String commandKey = "SL";
  int tempScrollLevel = CONF_SCROLL_LEVEL_DEFAULT;
  if (CONF_API_ENABLED) {
    tempScrollLevel = mem.readInt(CONF_SETTINGS_FILE, commandKey);
    if ((tempScrollLevel < CONF_SCROLL_LEVEL_MIN) || (tempScrollLevel > CONF_SCROLL_LEVEL_MAX)) {
      tempScrollLevel = CONF_SCROLL_LEVEL_DEFAULT;
      if (mem.isLastReadOk()) {  // heal a stored value only — never rewrite from a failed read (getModelNumber pattern)
        mem.writeInt(CONF_SETTINGS_FILE, commandKey, tempScrollLevel);
      }
    }
    
  }
  //js.setOutputRange(tempScrollLevel);
  printResponseInt(responseEnabled, apiEnabled, true, 0, "SL,0", true, tempScrollLevel);

  return tempScrollLevel;
}
//***GET JOYSTICK LEVEL FUNCTION***//
// Function   : getScrollLevel
//
// Description: This function is redefinition of main getScrollLevel function to match the types of API function arguments.
//
// Parameters :  responseEnabled : bool : The response for serial printing is enabled if it's set to true.
//                                        The serial printing is ignored if it's set to false.
//               apiEnabled : bool : The api response is sent if it's set to true.
//                                   Manual response is sent if it's set to false.
//               optionalParameter : String : The input parameter string should contain one element with value of zero.
//
// Return     : void
void getScrollLevel(bool responseEnabled, bool apiEnabled, String optionalParameter) {
  if (optionalParameter.length() == 1 && optionalParameter.toInt() == 0) {
    getScrollLevel(responseEnabled, apiEnabled);
  }
}

//***SET SCROLL LEVEL FUNCTION***//
// Function   : setScrollLevel
//
// Description: This function sets the current scroll level.
//
// Parameters :  responseEnabled : bool : The response for serial printing is enabled if it's set to true.
//                                        The serial printing is ignored if it's set to false.
//               apiEnabled : bool : The api response is sent if it's set to true.
//                                   Manual response is sent if it's set to false.
//               inputScrollLevel : bool : The new scroll speed level.
//
// Return     : void
//*********************************//
void setScrollLevel(bool responseEnabled, bool apiEnabled, int inputScrollLevel) {
  String commandKey = "SL";
  bool isValidLevel = true;
  int tempScrollLevel = inputScrollLevel;
  
  if ((tempScrollLevel >= CONF_SCROLL_LEVEL_MIN) && (tempScrollLevel <= CONF_SCROLL_LEVEL_MAX)) { // Check if inputLevelCounter is valid
    // Valid inputScrollLevel — a refused store (settings budget, LSMemory)
    // must read as a failed write, not a silent success.
    isValidLevel = mem.writeInt(CONF_SETTINGS_FILE, commandKey, tempScrollLevel);
    if (!isValidLevel) {
      // 4.6.6: fall back to the in-force level (g_scrollLevel), not a file
      // readback that degenerates to 0 on an unreadable file — a refused
      // store must leave the live scroll level untouched (the readback used
      // to collapse the live scroll speed to the minimum for the boot).
      tempScrollLevel = g_scrollLevel;
    }
    if (!CONF_API_ENABLED && isValidLevel) {
      tempScrollLevel = CONF_SCROLL_LEVEL_DEFAULT;
    }
    performLedAction(ledCurrentState);
    g_scrollLevel = tempScrollLevel;
  }
  else {
    // Invalid inputScrollLevel — answer the in-force value (4.6.6, as SS).
    tempScrollLevel = g_scrollLevel;
    performLedAction(ledCurrentState);
    isValidLevel = false;
  }

  //js.setOutputRange(tempScrollLevel);
  int responseCode = 0;
  (isValidLevel) ? responseCode = 0 : responseCode = 3;
  printResponseInt(responseEnabled, apiEnabled, isValidLevel, responseCode, "SL,1", true, tempScrollLevel);
}
//***SET SCROLL LEVEL API FUNCTION***//
// Function   : setScrollLevel
//
// Description: This function is redefinition of main setScrollLevel function to match the types of API function arguments.
//
// Parameters :  responseEnabled : bool : The response for serial printing is enabled if it's set to true.
//                                        The serial printing is ignored if it's set to false.
//               apiEnabled : bool : The api response is sent if it's set to true.
//                                   Manual response is sent if it's set to false.
//               optionalParameter : String : The input parameter string should contain one element with value of zero.
//
// Return     : void
void setScrollLevel(bool responseEnabled, bool apiEnabled, String optionalParameter) {
  setScrollLevel(responseEnabled, apiEnabled, optionalParameter.toInt());
}


//***INCREASE JOYSTICK CURSOR SPEED LEVEL FUNCTION***//
// Function   : increaseCursorSpeed
//
// Description: This function increases the joystick cursor speed level by one.
//
// Parameters :  responseEnabled : bool : The response for serial printing is enabled if it's set to true.
//                                        The serial printing is ignored if it's set to false.
//               apiEnabled : bool : The api response is sent if it's set to true.
//                                   Manual response is sent if it's set to false.
//
// Return     : void
//*********************************//
void increaseCursorSpeed(bool responseEnabled, bool apiEnabled) {
  int tempCursorSpeedLevel = js.getOutputRange();

  tempCursorSpeedLevel++;
  if(tempCursorSpeedLevel <= CONF_JOY_CURSOR_SPEED_LEVEL_MAX) {  // Check validity of input
    setLedState(LED_ACTION_BLINK, 
    CONF_JOY_SPEED_INC_LED_COLOR, 
    CONF_JOY_SPEED_INC_LED_NUMBER, 
    CONF_JOY_SPEED_CHANGE_LED_BLINK, 
    CONF_JOY_SPEED_CHANGE_LED_DELAY, 
    led.getLedBrightness());   // Blink once
  } 
  else{
    setLedState(LED_ACTION_BLINK, 
    CONF_JOY_SPEED_LIMIT_LED_COLOR, 
    CONF_JOY_SPEED_INC_LED_NUMBER, 
    CONF_JOY_SPEED_LIMIT_LED_BLINK, 
    CONF_JOY_SPEED_LIMIT_LED_DELAY, 
    led.getLedBrightness());   // Blink 3 times
  }

  setCursorSpeed(responseEnabled, apiEnabled, tempCursorSpeedLevel);
}

//***DECREASE JOYSTICK CURSOR SPEED LEVEL FUNCTION***//
// Function   : decreaseCursorSpeed
//
// Description: This function decreases the joystick cursor speed level by one.
//
// Parameters :  responseEnabled : bool : The response for serial printing is enabled if it's set to true.
//                                        The serial printing is ignored if it's set to false.
//               apiEnabled : bool : The api response is sent if it's set to true.
//                                   Manual response is sent if it's set to false.
//
// Return     : void
//*********************************//
void decreaseCursorSpeed(bool responseEnabled, bool apiEnabled) {
  int tempCursorSpeedLevel = js.getOutputRange();

  tempCursorSpeedLevel--;
  if(tempCursorSpeedLevel >= CONF_JOY_CURSOR_SPEED_LEVEL_MIN) {
    setLedState(LED_ACTION_BLINK, 
    CONF_JOY_SPEED_DEC_LED_COLOR, 
    CONF_JOY_SPEED_DEC_LED_NUMBER, 
    CONF_JOY_SPEED_CHANGE_LED_BLINK, 
    CONF_JOY_SPEED_CHANGE_LED_DELAY, 
    led.getLedBrightness());   // Blink once
  } 
  else{
    setLedState(LED_ACTION_BLINK, 
    CONF_JOY_SPEED_LIMIT_LED_COLOR, 
    CONF_JOY_SPEED_DEC_LED_NUMBER, 
    CONF_JOY_SPEED_LIMIT_LED_BLINK, 
    CONF_JOY_SPEED_LIMIT_LED_DELAY, 
    led.getLedBrightness());   // Blink 3 times
  }
  
    
  setCursorSpeed(responseEnabled, apiEnabled, tempCursorSpeedLevel);
}


//***GET JOYSTICK INITIALIZATION FUNCTION***//
// Function   : getJoystickInitialization
//
// Description: This function retrieves the neutral values from joystick initialization.
//
// Parameters :  responseEnabled : bool : The response for serial printing is enabled if it's set to true.
//                                        The serial printing is ignored if it's set to false.
//               apiEnabled : bool : The api response is sent if it's set to true.
//                                   Manual response is sent if it's set to false.
//
// Return     : void
//*********************************//
void getJoystickInitialization(bool responseEnabled, bool apiEnabled) {
  // 4.9.1: the sensorless gate its sibling CA,0 pins as mandatory — this
  // getter is reachable on safe boots (the API table is not filtered by
  // safe mode and the connect load replays IN,0 inside EX,0), and every js
  // touch below would act on the never-begun object's state (getInputCenter
  // reads it, setMinimumRadius mutates it). Answer the zeroed default
  // center without touching state — the same shape CA,0 answers.
  if (!g_joystickSensorConnected || !js.isBegun()) {
    pointFloatType sensorlessCenter = {0.0f, 0.0f};
    printResponseFloatPoint(responseEnabled, apiEnabled, true, 0, "IN,0", true, sensorlessCenter);
    return;
  }
  pointFloatType tempCenterPoint = js.getInputCenter();
  js.setMinimumRadius();                                                                        // Update the minimum cursor operating radius 
  printResponseFloatPoint(responseEnabled, apiEnabled, true, 0, "IN,0", true, tempCenterPoint);
}
//***GET JOYSTICK INITIALIZATION API FUNCTION***//
// Function   : getJoystickInitialization
//
// Description: This function is redefinition of main getJoystickInitialization function to match the types of API function arguments.
//
// Parameters :  responseEnabled : bool : The response for serial printing is enabled if it's set to true.
//                                        The serial printing is ignored if it's set to false.
//               apiEnabled : bool : The api response is sent if it's set to true.
//                                   Manual response is sent if it's set to false.
//               optionalParameter : String : The input parameter string should contain one element with value of zero.
//
// Return     : void
void getJoystickInitialization(bool responseEnabled, bool apiEnabled, String optionalParameter) {
  if (optionalParameter.length() == 1 && optionalParameter.toInt() == 0) {
    getJoystickInitialization(responseEnabled, apiEnabled);
  }
}

//***SET JOYSTICK INITIALIZATION FUNCTION***//
// Function   : setJoystickInitialization
//
// Description: This function performs joystick Initialization.
//
// Parameters :  responseEnabled : bool : The response for serial printing is enabled if it's set to true.
//                                        The serial printing is ignored if it's set to false.
//               apiEnabled : bool : The api response is sent if it's set to true.
//                                   Manual response is sent if it's set to false.
//
// Return     : void
//*********************************//
void setJoystickInitialization(bool responseEnabled, bool apiEnabled) {
  // 4.5.7 review: refuse up front when the joystick sensor is absent — the
  // chain runs on calibrationTimer, which loop() only pumps when the sensor
  // is connected, so on a sensorless safe boot the registration succeeded,
  // the chain never fired, canOutputAction stayed false forever, and EVERY
  // input (buttons, switches, sip & puff, the safe-mode menu itself) was
  // dead until reboot — silently, with no ack and no FAIL. There is
  // nothing to center without the sensor; answer FAIL,3 so the host's
  // waiter resolves honestly.
  if (!g_joystickSensorConnected) {
    canOutputAction = true;
    printResponseInt(responseEnabled, apiEnabled, false, 3, "IN,1", true, 1);
    return;
  }
  // 4.5.7 review: one timer chain per shared id set — a center started
  // during an in-flight CALIBRATION overwrote the shared
  // calibrationTimerId[1] reading-timer variable, so the corner's
  // final-run check (which keys the flash persistence AND the CA,n ack
  // line) read the center's 5-run timer, never matched the calibration's
  // 10th run, and that corner silently never persisted while step 6 still
  // reported "calibrated". Refuse honestly; the calibration's own internal
  // step-5 center bypasses via g_calibrationCenterStep. Center flows are now
  // serialized too because they share the sample buffer and timer-id slots.
  if (g_centerRunning || (g_calibrationRunning && !g_calibrationCenterStep)) {
    printResponseInt(responseEnabled, apiEnabled, false, 3, "IN,1", true, 1);
    return;
  }
  // 4.9.4 (round 4): the same window gate CA,1 carries — a center flow
  // freezes the cursor and disables the joystick poll, and the switch
  // window's tick is serviced from the main loop, so the two would run
  // concurrently and the window's close would act on a device whose input
  // pipeline the center flow deliberately owns. Refused with the same named
  // note; the app's waiter surfaces the refusal as a clean error and the
  // retry is manual (re-run the calibration once the window closes — the
  // final-diff-audit corrected this comment's claim of an automatic retry;
  // sendCommand is one-shot).
  //
  // 4.9.4 (round 8, fix-set audit) THE CHAIN'S OWN CALL IS EXEMPT, explicitly:
  // the full calibration's STEP 5 runs its center through THIS function
  // (performJoystickCalibration sets g_calibrationCenterStep around the call
  // precisely to bypass the in-flight gate above). That call is currently
  // unreachable while a window is open — the round-4 CA,1 gate stops a
  // calibration from starting during a window, and the executors'
  // calibrationRunning gate stops a window from opening during one, so the
  // two are mutually exclusive by construction. But this gate sits BELOW the
  // g_calibrationCenterStep bypass check, so if that mutual exclusion is ever
  // relaxed (a future caller, a re-ordered gate), step 5 would be refused
  // mid-run, g_centerRunning would stay false, and the chain would abort with
  // "center step refused" — a calibration that cannot complete, with the
  // cause three gates away. Honor the same exemption here so the chain's
  // internal call is never the one refused.
  if (lsHostSwitchWindowOpen() && !g_calibrationCenterStep) {
    printResponseInt(responseEnabled, apiEnabled, false, 3, "IN,1", true, 1);
    serialTxEnqueueLine("ERROR: IN,1 refused: a Bluetooth switch window owns the radio — retry once it closes");
    return;
  }
  // Record who initiated the center (4.5.2, wire hygiene): the completion's
  // IN,1 line is an ack (SUCCESS) only when the serial API asked for it —
  // a device-initiated center (boot auto-center, Hub-menu Center Reset,
  // the calibration's internal step 5) prints MANUAL instead, so a boot
  // straggler can never falsely resolve a host's pending IN,1:1 waiter.
  // 4.5.4: the initiator rides the flow's own timer payload
  // (CONF_CENTER_INIT_API_FLAG) instead of a shared global, so every accepted
  // flow carries its own initiator structurally.
  int stepPayload = apiEnabled ? CONF_CENTER_INIT_API_FLAG : 0;
  if (outputAction == CONF_ACTION_DRAG || outputAction == CONF_ACTION_SCROLL) {
    releaseOutputAction();
  }
  canOutputAction = false;
  g_resetCenterComplete = false;  // Freeze cursor immediately, including the 1 s start-delay window
  g_centerRunning = true;
  calibrationTimerId[0] = calibrationTimer.setTimeout(CONF_JOY_INIT_START_DELAY, performJoystickCenter, (int *)stepPayload);
  if (calibrationTimerId[0] < 0) {
    // Registration refused (a loud, counted LSTimer failure): the flow never
    // starts — without this guard the completion that would have restored
    // canOutputAction never fires and the cursor output stays dead. Answer
    // FAIL,3 so the host's IN,1 waiter resolves honestly instead of timing
    // out on a center that will never run.
    canOutputAction = true;
    g_centerRunning = false;
    g_resetCenterComplete = true;
    if (screen.showCenterResetComplete) screen.centerResetFailedPage();
    if (g_startupCenterReset) {
      g_startupCenterReset = false;
      readyToUse();
    }
    printResponseInt(responseEnabled, apiEnabled, false, 3, "IN,1", true, 1);
  }
}
//***SET JOYSTICK INITIALIZATION API FUNCTION***//
// Function   : setJoystickInitialization
//
// Description: This function is redefinition of main setJoystickInitialization function to match the types of API function arguments.
//
// Parameters :  responseEnabled : bool : The response for serial printing is enabled if it's set to true.
//                                        The serial printing is ignored if it's set to false.
//               apiEnabled : bool : The api response is sent if it's set to true.
//                                   Manual response is sent if it's set to false.
//               optionalParameter : String : The input parameter string should contain one element with value of zero.
//
// Return     : void
void setJoystickInitialization(bool responseEnabled, bool apiEnabled, String optionalParameter) {
  if (optionalParameter.length() == 1 && optionalParameter.toInt() == 1) {
    setJoystickInitialization(responseEnabled, apiEnabled);
  }
}

//*** GET JOYSTICK CALIBRATION FUNCTION***//
// Function   : getJoystickCalibration
//
// Description: This function retrieves calibration values from joystick Calibration.
//
// Parameters :  responseEnabled : bool : The response for serial printing is enabled if it's set to true.
//                                        The serial printing is ignored if it's set to false.
//               apiEnabled : bool : The api response is sent if it's set to true.
//                                   Manual response is sent if it's set to false.
//
// Return     : void
//*********************************//
// 4.6.6: corner plausibility gate for reads (mirror of the full-calibration
// convention, CONF_JOY_CALIB_CORNER_MIN = 3: a corner coordinate below 3 mT
// is degenerate). The capture-time convention requires BOTH axes at or
// beyond the min (a corner with one axis below is replaced by the ±13
// default at capture, LipSync_Firmware.ino) — this gate now requires BOTH
// too: the one-axis-or shape accepted corners capture itself would have
// rejected, so a stored {20, 1.5} read back as "usable" while the same
// reading at capture time could never have persisted. {0,0} (what a failed
// read used to yield implicitly) and any NaN/garbage fail this gate and the
// caller keeps the live stored corner instead.
static bool isPlausibleStoredCorner(pointFloatType p) {
  if (!isfinite(p.x) || !isfinite(p.y)) return false;
  return (fabsf(p.x) >= CONF_JOY_CALIB_CORNER_MIN) && (fabsf(p.y) >= CONF_JOY_CALIB_CORNER_MIN);
}

void getJoystickCalibration(bool responseEnabled, bool apiEnabled) {
  String commandKey;
  pointFloatType calibrationPointArray[5];
  // 4.6.6: sensorless gate. This getter is reachable on safe boots (the API
  // table is not filtered by safe mode and the app's connect load sends
  // CA,0) — every js mutation below, and getInputCenter itself, would touch
  // the never-begun object's state. Answer stored/default values only.
  const bool sensorless = !g_joystickSensorConnected || !js.isBegun();
  calibrationPointArray[0] = sensorless ? pointFloatType{0.0f, 0.0f} : js.getInputCenter();
  // 4.5.7 review: while a full calibration is IN FLIGHT, this read must not
  // touch the live corner slots — getInputMax is a max-accumulator against
  // the stored slot, so a CA,0/EX read landing inside a corner's 2 s
  // measurement window replaced the accumulating slot with the OLD stored
  // corner, and the polluted corner was then persisted at window end (the
  // user told "calibrated" while the corner silently kept its
  // pre-calibration value). The read still answers the STORED values.
  bool calibrationInFlight = g_calibrationRunning;
  // 4.6.6: a failed/implausible stored-corner read must never flow into
  // setInputMax — readPoint now reports validity, and a slot that fails the
  // gate falls back to the LIVE stored corner (no I/O) with the flag
  // clearing the radius/reprocess pass: a settings read failure used to
  // silently reset every corner to {0,0} live, including inside
  // abortJoystickCalibration's reload-to-persisted path.
  bool storedCornersUsable = true;
  for (int i = 1; i < 5; i++)
  {
    commandKey = "CA" + String(i);
    pointFloatType storedCorner = {0.0f, 0.0f};
    if (mem.readPoint(CONF_SETTINGS_FILE, commandKey, storedCorner) && isPlausibleStoredCorner(storedCorner)) {
      calibrationPointArray[i] = storedCorner;
    } else {
      calibrationPointArray[i] = js.getStoredInputMax(i);
      storedCornersUsable = false;
    }
    if (!calibrationInFlight && !sensorless) {
      js.setInputMax(i, calibrationPointArray[i]);
    }
  }
  if (!calibrationInFlight && !sensorless && storedCornersUsable) {
    js.setMinimumRadius();  // Update the minimum cursor operating radius
    js.reprocessLastReading();  // A stationary stick must reflect reloaded corners immediately
  }
  printResponseFloatPointArray(responseEnabled, apiEnabled, storedCornersUsable, storedCornersUsable ? 0 : 3, "CA,0", true, "", 5, ',', calibrationPointArray);

}
//***GET JOYSTICK CALIBRATION API FUNCTION***//
// Function   : getJoystickCalibration
//
// Description: This function is redefinition of main getJoystickCalibration function to match the types of API function arguments.
//
// Parameters :  responseEnabled : bool : The response for serial printing is enabled if it's set to true.
//                                        The serial printing is ignored if it's set to false.
//               apiEnabled : bool : The api response is sent if it's set to true.
//                                   Manual response is sent if it's set to false.
//               optionalParameter : String : The input parameter string should contain one element with value of zero.
//
// Return     : void
void getJoystickCalibration(bool responseEnabled, bool apiEnabled, String optionalParameter) {
  if (optionalParameter.length() == 1 && optionalParameter.toInt() == 0) {
    getJoystickCalibration(responseEnabled, apiEnabled);
  }
}

//*** SET JOYSTICK CALIBRATION FUNCTION***//
// Function   : setJoystickCalibration
//
// Description: This function starts the joystick Calibration.
//
// Parameters :  responseEnabled : bool : The response for serial printing is enabled if it's set to true.
//                                        The serial printing is ignored if it's set to false.
//               apiEnabled : bool : The api response is sent if it's set to true.
//                                   Manual response is sent if it's set to false.
//
// Return     : void
//*********************************//
void setJoystickCalibration(bool responseEnabled, bool apiEnabled) {
  // 4.5.7 review: same run-gate refusal as setJoystickInitialization — the
  // chain never fires on a sensorless boot (calibrationTimer is only pumped
  // when the joystick sensor is connected), and this function must bail
  // BEFORE js.clear() wipes the stored/live calibration and
  // calibrationEndsByClosingMenu arms the menu close for a flow that will
  // never run.
  if (!g_joystickSensorConnected) {
    canOutputAction = true;
    screen.calibrationEndsByClosingMenu(false);
    printResponseInt(responseEnabled, apiEnabled, false, 3, "CA,1", true, 1);
    return;
  }
  // 4.5.7 review: one calibration at a time — a second CA,1:1 while a run
  // is in flight (a host timeout-retry lands ~4 s in; the first corner line
  // arrives ~4.4 s in) used to js.clear() the accumulating corners
  // mid-run, register a second concurrent chain, interleave two corner
  // sequences on the wire, and let last-writer-wins persistence fight over
  // the shared corner slots. Refuse honestly; the running chain finishes.
  if (g_calibrationRunning || g_centerRunning) {
    printResponseInt(responseEnabled, apiEnabled, false, 3, "CA,1", true, 1);
    return;
  }
  // 4.9.4 (round 4, the symmetric half of the calibration gate): lsHostExecuteSwitch
  // and lsHostExecuteForget both refuse while a calibration/center flow is in
  // flight (calibrationRunning), but the REVERSE was never true — a CA,1:1
  // landing while a switch window is open was accepted. The two then ran
  // CONCURRENTLY: the window tick is serviced from the MAIN LOOP
  // (lsHostServiceSwitchWindow) and from btFeedbackLoop's poll, neither of
  // which calibration disables, while calibration step 0 shuts down the
  // joystick/scroll/input/pressure polls and holds canOutputAction false with
  // the cursor frozen. The window could therefore close mid-calibration —
  // admitting the target, painting LED state and (on the success path)
  // running the close's radio/LED work against a device whose input pipeline
  // is deliberately down, and the user's held corner pose would be sampled by
  // a sensor poll that is supposed to be off. Calibration is also the flow
  // that OWNS the joystick, so racing it against a radio switch has no honest
  // resolution: refuse, exactly as the switch refuses calibration. The
  // app's CA,1 waiter surfaces the refusal as a clean error (the fail-fast
  // abort contract); the retry is manual once the window's bound elapses
  // (60 s worst case) or the target takes the link. The named note mirrors
  // lsHostRefusalLine's calibration wording so both directions read the same
  // on the wire.
  if (lsHostSwitchWindowOpen()) {
    printResponseInt(responseEnabled, apiEnabled, false, 3, "CA,1", true, 1);
    serialTxEnqueueLine("ERROR: CA,1 refused: a Bluetooth switch window owns the radio — retry once it closes");
    return;
  }
  // Set at ACCEPTANCE, not at step 0 (4.5.7 review): the chain starts
  // CONF_JOY_CALIB_START_DELAY (1 s) after this command, and CA,1 has no
  // immediate ack — a host retry inside that window used to pass the
  // step-0-set flag, js.clear() the accumulating state, and double-chain.
  g_calibrationRunning = true;
  // The initiator rides the chain's payload (CONF_CALIB_API_FLAG): the
  // per-corner lines print SUCCESS only for a host-requested calibration
  // (CA,1:1) and MANUAL for a Hub-menu one — the 4.5.2 initiator contract.
  int stepPayload = apiEnabled ? CONF_CALIB_API_FLAG : 0;
  if (outputAction == CONF_ACTION_DRAG || outputAction == CONF_ACTION_SCROLL) {
    releaseOutputAction();
  }
  canOutputAction = false;
  g_resetCenterComplete = false;  // Freeze cursor immediately, before the delayed step-0 callback
  // 4.9.1: arm the entry freeze for the SERIAL path too. The menu path arms
  // it in fullCalibrationPage; the serial path (the app's CA,1:1) left the
  // whole START_DELAY + step-0 window (~1 s) with the current menu live to
  // the input poll — on a safe-mode boot the safe menu (Restart / Factory
  // Reset) sat registered beneath a "calibration is starting" flow, and a
  // held Select could walk its destructive confirm before step 0's poll
  // disable landed. The entry freeze covers the gap; the flow's own chain
  // re-freezes per step.
  screen.freezeMenuInputFor(CONF_JOY_CALIB_ENTRY_FREEZE_MS);
  // #36: apiEnabled is true only on the serial-dispatch path — a calibration
  // the app started must not end by parking the Hub's menu on screen. The
  // menu-driven path (fullCalibrationPage) passes false and keeps the
  // return-to-menu behavior the device user expects.
  screen.calibrationEndsByClosingMenu(apiEnabled);
  calibrationTimerId[0] = calibrationTimer.setTimeout(CONF_JOY_CALIB_START_DELAY, performJoystickCalibration, (int *)stepPayload);  // Start the process
  if (calibrationTimerId[0] < 0) {
    // Registration refused (a loud, counted LSTimer failure): the flow never
    // starts, so restore the state a completed calibration would have —
    // otherwise the output stays dead and the menu-close flag stays armed
    // for an unrelated later transition. Answer FAIL,3 so the host's CA,1
    // waiter resolves honestly instead of timing out on a calibration that
    // will never run.
    canOutputAction = true;
    g_resetCenterComplete = true;
    g_calibrationRunning = false;
    screen.calibrationAbortedPage();
    printResponseInt(responseEnabled, apiEnabled, false, 3, "CA,1", true, 1);
  }
}
//***SET JOYSTICK CALIBRATION API FUNCTION***//
// Function   : setJoystickCalibration
//
// Description: This function is redefinition of main setJoystickCalibration function to match the types of API function arguments.
//
// Parameters :  responseEnabled : bool : The response for serial printing is enabled if it's set to true.
//                                        The serial printing is ignored if it's set to false.
//               apiEnabled : bool : The api response is sent if it's set to true.
//                                   Manual response is sent if it's set to false.
//               optionalParameter : String : The input parameter string should contain one element with value of zero.
//
// Return     : void
void setJoystickCalibration(bool responseEnabled, bool apiEnabled, String optionalParameter) {
  if (optionalParameter.length() == 1 && optionalParameter.toInt() == 1) {
    setJoystickCalibration(responseEnabled, apiEnabled);
  }
}


// Load and sanitize the deadzone pair as one invariant. Both values must be
// finite, strictly inside (0,1), and inner must stay below outer; otherwise
// apply and persist the known-safe pair together. The old independent checks
// accepted inner >= outer, which reaches mapRoundInt with a zero/reversed
// input span, and the setters accepted 1.0 even though the next GET silently
// reset it.
// 4.9.1: returns whether the read that produced the values actually
// happened (read truth) — the getters use it to keep a failed read from
// rewriting the live deadzones (the read-truth doctrine, getSapDisabled);
// the setters ignore it as before.
bool loadJoystickDeadzonePair(float &innerDeadzone, float &outerDeadzone) {
  JsonObject settings = mem.readObject(CONF_SETTINGS_FILE);
  innerDeadzone = settings["IZ"].as<float>();
  outerDeadzone = settings["OZ"].as<float>();

  bool valid = mem.isLastReadOk() &&
               isfinite(innerDeadzone) && isfinite(outerDeadzone) &&
               innerDeadzone > CONF_JOY_DEADZONE_MIN &&
               innerDeadzone < CONF_JOY_DEADZONE_MAX &&
               outerDeadzone > CONF_JOY_DEADZONE_MIN &&
               outerDeadzone < CONF_JOY_DEADZONE_MAX &&
               innerDeadzone < outerDeadzone;
  if (!valid) {
    innerDeadzone = CONF_JOY_DEADZONE_INNER_DEFAULT;
    outerDeadzone = CONF_JOY_DEADZONE_OUTER_DEFAULT;
    // (4.9.0 review) the heal write is isLastReadOk-gated like every writer
    // now is — on a failed read the null-document check alone could pass (a
    // truncated-but-parseable file is non-null) and persist defaults over a
    // file the next boot would have re-seeded wholesale.
    if (!settings.isNull() && mem.isLastReadOk()) {
      settings["IZ"] = innerDeadzone;
      settings["OZ"] = outerDeadzone;
      mem.writeObject(CONF_SETTINGS_FILE, "IZ/OZ", settings);
    }
  }
  return mem.isLastReadOk();
}

//*** GET JOYSTICK DEADZONE FUNCTION***//
// Function   : getJoystickInnerDeadzone
//
// Description: This function retrieves the joystick deadzone.
//
// Parameters :  responseEnabled : bool : The response for serial printing is enabled if it's set to true.
//                                        The serial printing is ignored if it's set to false.
//               apiEnabled : bool : The api response is sent if it's set to true.
//                                   Manual response is sent if it's set to false.
//
// Return     : void
//*********************************//
float getJoystickInnerDeadzone(bool responseEnabled, bool apiEnabled) {
  float tempDeadzone;
  float tempOuterDeadzone;
  const bool dzReadOk = loadJoystickDeadzonePair(tempDeadzone, tempOuterDeadzone);
  (void)tempOuterDeadzone;
  // 4.9.1 read-truth doctrine (see getSapDisabled): a failed read must not
  // rewrite the live deadzone and reprocess the cursor — the answer is the
  // in-force factor instead.
  if (dzReadOk) {
    js.setInnerDeadzone(true, tempDeadzone);
    js.reprocessLastReading();
  } else {
    tempDeadzone = js.getInnerDeadzoneFactor();
  }
  printResponseFloat(responseEnabled, apiEnabled, true, 0, "IZ,0", true, tempDeadzone);
  return tempDeadzone;
}
//***GET JOYSTICK DEADZONE API FUNCTION***//
// Function   : getJoystickInnerDeadzone
//
// Description: This function is redefinition of main getJoystickInnerDeadzone function to match the types of API function arguments.
//
// Parameters :  responseEnabled : bool : The response for serial printing is enabled if it's set to true.
//                                        The serial printing is ignored if it's set to false.
//               apiEnabled : bool : The api response is sent if it's set to true.
//                                   Manual response is sent if it's set to false.
//               optionalParameter : String : The input parameter string should contain one element with value of zero.
//
// Return     : void
void getJoystickInnerDeadzone(bool responseEnabled, bool apiEnabled, String optionalParameter) {
  if (optionalParameter.length() == 1 && optionalParameter.toInt() == 0) {
    getJoystickInnerDeadzone(responseEnabled, apiEnabled);
  }
}

//*** SET JOYSTICK DEADZONE FUNCTION***//
// Function   : setJoystickInnerDeadzone
//
// Description: This function starts the joystick deadzone.
//
// Parameters :  responseEnabled : bool : The response for serial printing is enabled if it's set to true.
//                                        The serial printing is ignored if it's set to false.
//               apiEnabled : bool : The api response is sent if it's set to true.
//                                   Manual response is sent if it's set to false.
//
// Return     : void
//*********************************//
void setJoystickInnerDeadzone(bool responseEnabled, bool apiEnabled, float inputDeadzone) {
  String deadzoneCommand = "IZ";
  float currentInnerDeadzone;
  float currentOuterDeadzone;
  loadJoystickDeadzonePair(currentInnerDeadzone, currentOuterDeadzone);
  (void)currentInnerDeadzone;
  if ((isfinite(inputDeadzone) &&
       (inputDeadzone > CONF_JOY_DEADZONE_MIN) &&
       (inputDeadzone < CONF_JOY_DEADZONE_MAX) &&
       (inputDeadzone < currentOuterDeadzone))
      && mem.writeFloat(CONF_SETTINGS_FILE, deadzoneCommand, inputDeadzone)) {
    // The store and the live value only land together: a refused store
    // (settings budget, LSMemory) falls to the FAIL,3 branch below.
    js.setInnerDeadzone(true, inputDeadzone);
    js.reprocessLastReading();
    printResponseFloat(responseEnabled, apiEnabled, true, 0, "IZ,1", true, inputDeadzone);
  }
  else {
    printResponseFloat(responseEnabled, apiEnabled, false, 3, "IZ,1", true, inputDeadzone);
  }
}
//***SET JOYSTICK DEADZONE API FUNCTION***//
// Function   : setJoystickInnerDeadzone
//
// Description: This function is redefinition of main setJoystickInnerDeadzone function to match the types of API function arguments.
//
// Parameters :  responseEnabled : bool : The response for serial printing is enabled if it's set to true.
//                                        The serial printing is ignored if it's set to false.
//               apiEnabled : bool : The api response is sent if it's set to true.
//                                   Manual response is sent if it's set to false.
//               optionalParameter : String : The input parameter string should contain one element with value of zero.
//
// Return     : void
void setJoystickInnerDeadzone(bool responseEnabled, bool apiEnabled, String optionalParameter) {
  setJoystickInnerDeadzone(responseEnabled, apiEnabled, optionalParameter.toFloat());
}

//*** GET JOYSTICK OUTER DEADZONE FUNCTION***//
// Function   : getJoystickOuterDeadzone
//
// Description: This function retrieves the joystick outer deadzone for max output.
//
// Parameters :  responseEnabled : bool : The response for serial printing is enabled if it's set to true.
//                                        The serial printing is ignored if it's set to false.
//               apiEnabled : bool : The api response is sent if it's set to true.
//                                   Manual response is sent if it's set to false.
//
// Return     : void
//*********************************//
float getJoystickOuterDeadzone(bool responseEnabled, bool apiEnabled) {
  float tempInnerDeadzone;
  float tempOuterDeadzone;
  const bool dzReadOk = loadJoystickDeadzonePair(tempInnerDeadzone, tempOuterDeadzone);
  (void)tempInnerDeadzone;
  // 4.9.1 read-truth doctrine (see getSapDisabled).
  if (dzReadOk) {
    js.setOuterDeadzone(true, tempOuterDeadzone);
    js.reprocessLastReading();
  } else {
    tempOuterDeadzone = js.getOuterDeadzoneFactor();
  }
  printResponseFloat(responseEnabled, apiEnabled, true, 0, "OZ,0", true, tempOuterDeadzone);
  return tempOuterDeadzone;
}
//***GET JOYSTICK OUTER DEADZONE API FUNCTION***//
// Function   : getJoystickOuterDeadzone
//
// Description: This function is redefinition of main getJoystickOuterDeadzone function to match the types of API function arguments.
//
// Parameters :  responseEnabled : bool : The response for serial printing is enabled if it's set to true.
//                                        The serial printing is ignored if it's set to false.
//               apiEnabled : bool : The api response is sent if it's set to true.
//                                   Manual response is sent if it's set to false.
//               optionalParameter : String : The input parameter string should contain one element with value of zero.
//
// Return     : void
void getJoystickOuterDeadzone(bool responseEnabled, bool apiEnabled, String optionalParameter) {
  if (optionalParameter.length() == 1 && optionalParameter.toInt() == 0) {
    getJoystickOuterDeadzone(responseEnabled, apiEnabled);
  }
}

//*** SET JOYSTICK OUTER DEADZONE FUNCTION***//
// Function   : setJoystickOuterDeadzone
//
// Description: This function starts the joystick deadzone.
//
// Parameters :  responseEnabled : bool : The response for serial printing is enabled if it's set to true.
//                                        The serial printing is ignored if it's set to false.
//               apiEnabled : bool : The api response is sent if it's set to true.
//                                   Manual response is sent if it's set to false.
//               inputUpperDeadZone : float : The new upper deadzone value.
//
// Return     : void
//*********************************//
void setJoystickOuterDeadzone(bool responseEnabled, bool apiEnabled, float inputUpperDeadZone) {
  String outerDeadzoneCommand = "OZ";
  float currentInnerDeadzone;
  float currentOuterDeadzone;
  loadJoystickDeadzonePair(currentInnerDeadzone, currentOuterDeadzone);
  (void)currentOuterDeadzone;
  if ((isfinite(inputUpperDeadZone) &&
       (inputUpperDeadZone > CONF_JOY_DEADZONE_MIN) &&
       (inputUpperDeadZone < CONF_JOY_DEADZONE_MAX) &&
       (inputUpperDeadZone > currentInnerDeadzone))
      && mem.writeFloat(CONF_SETTINGS_FILE, outerDeadzoneCommand, inputUpperDeadZone)) {
    // See setJoystickInnerDeadzone: a refused store must not report SUCCESS.
    js.setOuterDeadzone(true, inputUpperDeadZone);
    js.reprocessLastReading();
    printResponseFloat(responseEnabled, apiEnabled, true, 0, "OZ,1", true, inputUpperDeadZone);
  }
  else {
    printResponseFloat(responseEnabled, apiEnabled, false, 3, "OZ,1", true, inputUpperDeadZone);
  }
}
//***SET JOYSTICK OUTER DEADZONE API FUNCTION***//
// Function   : setJoystickOuterDeadzone
//
// Description: This function is redefinition of main setJoystickOuterDeadzone function to match the types of API function arguments.
//
// Parameters :  responseEnabled : bool : The response for serial printing is enabled if it's set to true.
//                                        The serial printing is ignored if it's set to false.
//               apiEnabled : bool : The api response is sent if it's set to true.
//                                   Manual response is sent if it's set to false.
//               optionalParameter : String : The input parameter string should contain one element with value of zero.
//
// Return     : void
void setJoystickOuterDeadzone(bool responseEnabled, bool apiEnabled, String optionalParameter) {
  setJoystickOuterDeadzone(responseEnabled, apiEnabled, optionalParameter.toFloat());
}

//***GET JOYSTICK VALUE FUNCTION***//
// Function   : getJoystickValue
//
// Description: This function returns raw joystick value.
//
// Parameters :  responseEnabled : bool : The response for serial printing is enabled if it's set to true.
//                                        The serial printing is ignored if it's set to false.
//               apiEnabled : bool : The api response is sent if it's set to true.
//                                   Manual response is sent if it's set to false.
//
// Return     : void
//*********************************//
void getJoystickValue(bool responseEnabled, bool apiEnabled) {
  // No synchronous sensor read here: the joystick poll tick keeps the buffers
  // fresh, and an on-demand js.update() used to run a full TLV493D I2C
  // transaction sequence inside the serial command path — on a flaky shared
  // bus that could block for seconds and trip the watchdog (observed live:
  // every JV exchange against a crawling bus silenced then reset the device).
  // The buffers return the last good reading, which is exactly what this
  // endpoint should report.
   
  const int outputArraySize = 6; 
  float tempJoystickArray[outputArraySize];
  
  pointFloatType tempJoystickRaw = js.getXYRaw();                                 // Read the raw values
  pointIntType tempJoystickIn = js.getXYIn();                                     // Read the input
  pointIntType tempJoystickProcessed = js.getXYOut();                             // Read the filtered values  
  
  tempJoystickArray[0] = tempJoystickRaw.x;
  tempJoystickArray[1] = tempJoystickRaw.y;
  tempJoystickArray[2] = (float)tempJoystickIn.x;
  tempJoystickArray[3] = (float)tempJoystickIn.y;
  tempJoystickArray[4] = (float)tempJoystickProcessed.x;
  tempJoystickArray[5] = (float)tempJoystickProcessed.y;
  
  printResponseFloatArray(responseEnabled, apiEnabled, true, 0, "JV,0", true, "", outputArraySize, ',', tempJoystickArray);
  
}

//***GET JOYSTICK VALUE API FUNCTION***//
// Function   : getJoystickValue
//
// Description: This function is redefinition of main getJoystickValue function to match the types of API function arguments.
//
// Parameters :  responseEnabled : bool : The response for serial printing is enabled if it's set to true.
//                                        The serial printing is ignored if it's set to false.
//               apiEnabled : bool : The api response is sent if it's set to true.
//                                   Manual response is sent if it's set to false.
//               optionalParameter : String : The input parameter string should contain one element with value of zero.
//
// Return     : void
void getJoystickValue(bool responseEnabled, bool apiEnabled, String optionalParameter) {
  if (optionalParameter.length() == 1 && optionalParameter.toInt() == 0) {
    getJoystickValue(responseEnabled, apiEnabled);
  }
}

//***GET PRESSURE VALUE FUNCTION***//
// Function   : getPressureValue
//
// Description: This function returns pressure difference.
//
// Parameters :  responseEnabled : bool : The response for serial printing is enabled if it's set to true.
//                                        The serial printing is ignored if it's set to false.
//               apiEnabled : bool : The api response is sent if it's set to true.
//                                   Manual response is sent if it's set to false.
//
// Return     : void
//*********************************//
void getPressureValue(bool responseEnabled, bool apiEnabled) {
  // Read the 50 ms pressure poll's last complete sample instead of taking an
  // extra synchronous sample in the serial-dispatch path. Besides making a
  // flaky I2C device able to stall command handling, the extra update could
  // run immediately beside the scheduled poll and read the same 25 Hz sensor
  // conversion twice. That defeated the 4.6.5 consecutive-sample engagement
  // qualifier while Connect was watching PV: one transient conversion could
  // be counted twice and become a click. The scheduled pressureLoop is the
  // sole owner of sensor sampling and sip/puff state advancement.
  
  const int outputArraySize = 3;   
  float tempSapPressure[outputArraySize];
  tempSapPressure[0] = ps.getSapPressureAbs();    // Read the mouthpiece pressure 
  tempSapPressure[1] = ps.getAmbientPressure();   // Read the ambient pressure
  tempSapPressure[2] = ps.getSapPressure();       // Read the diff pressure

  
  printResponseFloatArray(responseEnabled, apiEnabled, true, 0, "PV,0", true, "", outputArraySize, ',', tempSapPressure);
}

//***GET PRESSURE VALUE API FUNCTION***//
// Function   : getPressureValue
//
// Description: This function is redefinition of main getPressureValue function to match the types of API function arguments.
//
// Parameters :  responseEnabled : bool : The response for serial printing is enabled if it's set to true.
//                                        The serial printing is ignored if it's set to false.
//               apiEnabled : bool : The api response is sent if it's set to true.
//                                   Manual response is sent if it's set to false.
//               optionalParameter : String : The input parameter string should contain one element with value of zero.
//
// Return     : void
void getPressureValue(bool responseEnabled, bool apiEnabled, String optionalParameter) {
  if (optionalParameter.length() == 1 && optionalParameter.toInt() == 0) {
    getPressureValue(responseEnabled, apiEnabled);
  }
}

//***GET BUS HEALTH FUNCTION***//
// Function   : getBusHealth
//
// Description: Read-only I2C bus diagnostic (roadmap item 3): everything
//              the 4.2.0 flaky-bus hunt measured with custom timing probes,
//              in one endpoint. Turns "the screen is black, is it the USB?"
//              into a one-line answer for LipSync Connect's health check and
//              for any maker with a serial monitor.
//
//              Response value (comma-separated):
//                recoveries  : total bounded-timeout bus recoveries this boot
//                              (Wire.recoveryCount(); every one is a bus that
//                              wedged hard enough to need the NXP bus-clear)
//                busHealthy  : 1 = no recent recovery, 0 = a recovery happened
//                              within the hold-debounce window (bus is being
//                              held right now)
//                display     : 0 = not detected, 1 = answering,
//                              2 = demoted (probing on exponential backoff)
//                pressure    : 0 = not detected, 1 = healthy,
//                              2 = unhealthy (gated: sip/puff cannot fire)
//                joystick    : 0 = not detected, 1 = healthy,
//                              2 = poll backed off (bus crawls)
//                ageSec      : seconds since the last recovery, -1 when none
//                              happened this boot
//
// Parameters :  responseEnabled : bool : The response for serial printing is enabled if it's set to true.
//                                        The serial printing is ignored if it's set to false.
//               apiEnabled : bool : The api response is sent if it's set to true.
//                                   Manual response is sent if it's set to false.
//
// Return     : void
//*********************************//
void getBusHealth(bool responseEnabled, bool apiEnabled) {
  uint32_t recoveries = Wire.recoveryCount();
  int ageSec = -1;
  if (recoveries > 0) {
    ageSec = (int)((millis() - Wire.lastRecoveryMs()) / 1000UL);
  }

  int displayHealth = 0;
  if (g_displayConnected) displayHealth = screen.isDisplayHealthy() ? 1 : 2;

  int pressureHealth = 0;
  if (g_mouthpiecePressureSensorConnected && g_ambientPressureSensorConnected)
    pressureHealth = ps.isSensorsHealthy() ? 1 : 2;

  int joystickHealth = 0;
  if (g_joystickSensorConnected) joystickHealth = (!js.isBegun() || js.isPollBackedOff()) ? 2 : 1;

  // HID-layer + joystick-pipeline telemetry (bench 2026-10-16 hunt):
  // [6..14] = usbMounted, hidReady, hidRetrying, hidTimedOut,
  // centerComplete, reportAttempts, reportSuccesses, nonzeroReports,
  // maxAbsReport — read from the ACTIVE mode's HID interface (mouse mode:
  // usbmouse; gamepad mode: the gamepad's own counters, bench 2026-10-18 —
  // the old unconditional mouse read made gamepad-mode BH report hidReady=0
  // and attempts=0 forever on a healthy boot). [15..28] = the pipeline
  // internals (see fillJoystickPipelineDiagnostics). The app's health check
  // reads the first six values and ignores the rest; a serial monitor sees
  // everything.
  int hidDiagnostics[9];
  fillUsbHidDiagnostics(hidDiagnostics);

  // Round 3 (bench 2026-10-16): the input→output pipeline's live internals —
  // the corner-hold JV read raw≈-17,-23 with in/out at exact 0.00, and every
  // stage traces healthy in source, so the running values must speak.
  int pipelineDiagnostics[14];
  fillJoystickPipelineDiagnostics(pipelineDiagnostics);

  const int outputArraySize = 29;
  int tempBusHealth[outputArraySize];
  tempBusHealth[0] = (int)recoveries;
  tempBusHealth[1] = Wire.busHealthy() ? 1 : 0;
  tempBusHealth[2] = displayHealth;
  tempBusHealth[3] = pressureHealth;
  tempBusHealth[4] = joystickHealth;
  tempBusHealth[5] = ageSec;
  for (int diagIndex = 0; diagIndex < 9; diagIndex++) {
    tempBusHealth[6 + diagIndex] = hidDiagnostics[diagIndex];
  }
  for (int diagIndex = 0; diagIndex < 14; diagIndex++) {
    tempBusHealth[15 + diagIndex] = pipelineDiagnostics[diagIndex];
  }

  printResponseIntArray(responseEnabled, apiEnabled, true, 0, "BH,0", true, "", outputArraySize, ',', tempBusHealth);
}

//***GET BUS HEALTH API FUNCTION***//
// Function   : getBusHealth
//
// Description: This function is redefinition of main getBusHealth function to match the types of API function arguments.
//
// Parameters :  responseEnabled : bool : The response for serial printing is enabled if it's set to true.
//                                        The serial printing is ignored if it's set to false.
//               apiEnabled : bool : The api response is sent if it's set to true.
//                                   Manual response is sent if it's set to false.
//               optionalParameter : String : The input parameter string should contain one element with value of zero.
//
// Return     : void
void getBusHealth(bool responseEnabled, bool apiEnabled, String optionalParameter) {
  if (optionalParameter.length() == 1 && optionalParameter.toInt() == 0) {
    getBusHealth(responseEnabled, apiEnabled);
  }
}

//***GET SIP PRESSURE THRESHOLD FUNCTION***//
// Function   : getSipPressureThreshold
//
// Description: This function returns the current sip pressure threshold.
//
// Parameters :  responseEnabled : bool : The response for serial printing is enabled if it's set to true.
//                                        The serial printing is ignored if it's set to false.
//               apiEnabled : bool : The api response is sent if it's set to true.
//                                   Manual response is sent if it's set to false.
//
// Return     : void
//*********************************//
float getSipPressureThreshold(bool responseEnabled, bool apiEnabled) {
  String commandKey = "ST";
  // 4.9.1 read-truth doctrine (see getSapDisabled): a failed read answers
  // the in-force threshold and leaves the live sensor untouched — the old
  // shape re-applied the compiled default to ps on every transient read
  // failure.
  float tempSipThreshold;
  if (CONF_API_ENABLED) {
    tempSipThreshold = mem.readFloat(CONF_SETTINGS_FILE, commandKey);
    if (mem.isLastReadOk()) {
      if (!isfinite(tempSipThreshold) ||
          (tempSipThreshold < CONF_PRESS_MIN_THRESHOLD) ||
          (tempSipThreshold >= CONF_PRESS_MAX_THRESHOLD)) {
        tempSipThreshold = CONF_SIP_THRESHOLD;
        // 4.9.1: heal the pair only after the heal write actually landed —
        // healHardThresholds re-enters this getter for its floor, and a
        // persistently failing write would otherwise recurse
        // heal->getter->heal forever. (healHardThresholds also carries a
        // re-entrancy guard; this gate keeps the depth at one level.)
        if (mem.writeFloat(CONF_SETTINGS_FILE, commandKey, tempSipThreshold)) {
          screen.healHardThresholds();  // the heal can strand the hard band — same rule as the setter
        }
      }
      ps.setSipThreshold(tempSipThreshold);
    } else {
      tempSipThreshold = ps.getSipPressureThreshold();  // in force, not a readback
    }
  } else {
    tempSipThreshold = CONF_SIP_THRESHOLD;
    ps.setSipThreshold(tempSipThreshold);
  }
  printResponseFloat(responseEnabled, apiEnabled, true, 0, "ST,0", true, tempSipThreshold);
  return tempSipThreshold;
}

//***GET PRESSURE THRESHOLD API FUNCTION***//
// Function   : getSipPressureThreshold
//
// Description: This function is redefinition of main getSipPressureThreshold function to match the types of API function arguments.
//
// Parameters :  responseEnabled : bool : The response for serial printing is enabled if it's set to true.
//                                        The serial printing is ignored if it's set to false.
//               apiEnabled : bool : The api response is sent if it's set to true.
//                                   Manual response is sent if it's set to false.
//               optionalParameter : String : The input parameter string should contain one element with value of zero.
//
// Return     : void
void getSipPressureThreshold(bool responseEnabled, bool apiEnabled, String optionalParameter) {
  if (optionalParameter.length() == 1 && optionalParameter.toInt() == 0) {
    getSipPressureThreshold(responseEnabled, apiEnabled);
  }
}

//***SET SIP PRESSURE THRESHOLD FUNCTION***//
// Function   : setSipPressureThreshold
//
// Description: This function sets the current Sip pressure threshold.
//
// Parameters :  responseEnabled : bool : The response for serial printing is enabled if it's set to true.
//                                        The serial printing is ignored if it's set to false.
//               apiEnabled : bool : The api response is sent if it's set to true.
//                                   Manual response is sent if it's set to false.
//               inputSipThreshold : float : The new sip pressure threshold.
//
// Return     : void
//*********************************//
void setSipPressureThreshold(bool responseEnabled, bool apiEnabled, float inputSipThreshold) {
  String commandKey = "ST";

  if ((isfinite(inputSipThreshold) && inputSipThreshold >= CONF_PRESS_MIN_THRESHOLD && inputSipThreshold < CONF_PRESS_MAX_THRESHOLD)
      && mem.writeFloat(CONF_SETTINGS_FILE, commandKey, inputSipThreshold)) {
    // A refused store (settings budget, LSMemory) reports FAIL,3 — a
    // SUCCESS here would tell the app a threshold the device did not keep.
    ps.setSipThreshold(inputSipThreshold);
    printResponseFloat(responseEnabled, apiEnabled, true, 0, "ST,1", true, inputSipThreshold);
    // A raised regular floor can strand the hard band (hard < regular +
    // margin classifies as an empty hard pair — the feature silently goes
    // inert). The menu path heals after every step; the serial path — which
    // the app uses on every connect — heals here with the same rule
    // (screen.healHardThresholds emits the usual MANUAL lines so Connect
    // re-syncs the healed values).
    screen.healHardThresholds();
  }
  else {
    printResponseFloat(responseEnabled, apiEnabled, false, 3, "ST,1", true, inputSipThreshold);

  }
}

//***SET SIP PRESSURE THRESHOLD API FUNCTION***//
// Function   : setSipPressureThreshold
//
// Description: This function is redefinition of main setSipPressureThreshold function to match the types of API function arguments.
//
// Parameters :  responseEnabled : bool : The response for serial printing is enabled if it's set to true.
//                                        The serial printing is ignored if it's set to false.
//               apiEnabled : bool : The api response is sent if it's set to true.
//                                   Manual response is sent if it's set to false.
//               optionalParameter : String : The input parameter string should contain one element with value of zero.
//
// Return     : void
void setSipPressureThreshold(bool responseEnabled, bool apiEnabled, String optionalParameter) {
  setSipPressureThreshold(responseEnabled, apiEnabled, optionalParameter.toFloat());
}

//***GET PUFF THRESHOLD FUNCTION***//
// Function   : getPuffPressureThreshold
//
// Description: This function returns the puff pressure threshold.
//
// Parameters :  responseEnabled : bool : The response for serial printing is enabled if it's set to true.
//                                        The serial printing is ignored if it's set to false.
//               apiEnabled : bool : The api response is sent if it's set to true.
//                                   Manual response is sent if it's set to false.
//
// Return     : void
//*********************************//
float getPuffPressureThreshold(bool responseEnabled, bool apiEnabled) {
  String commandKey = "PT";
  // 4.9.1 read-truth doctrine (see getSipPressureThreshold).
  float tempPuffThreshold;
  if (CONF_API_ENABLED) {
    tempPuffThreshold = mem.readFloat(CONF_SETTINGS_FILE, commandKey);
    if (mem.isLastReadOk()) {
      if (!isfinite(tempPuffThreshold) ||
          (tempPuffThreshold < CONF_PRESS_MIN_THRESHOLD) ||
          (tempPuffThreshold >= CONF_PRESS_MAX_THRESHOLD)) {
        tempPuffThreshold = CONF_PUFF_THRESHOLD;
        // 4.9.1: heal only after the write lands (see getSipPressureThreshold).
        if (mem.writeFloat(CONF_SETTINGS_FILE, commandKey, tempPuffThreshold)) {
          screen.healHardThresholds();  // the heal can strand the hard band — same rule as the setter
        }
      }
      ps.setPuffThreshold(tempPuffThreshold);
    } else {
      tempPuffThreshold = ps.getPuffPressureThreshold();  // in force, not a readback
    }
  } else {
    tempPuffThreshold = CONF_PUFF_THRESHOLD;
    ps.setPuffThreshold(tempPuffThreshold);
  }
  printResponseFloat(responseEnabled, apiEnabled, true, 0, "PT,0", true, tempPuffThreshold);

  return tempPuffThreshold;
}

//***GET PUFF THRESHOLD API FUNCTION***//
// Function   : getPuffPressureThreshold
//
// Description: This function is redefinition of main getPuffPressureThreshold function to match the types of API function arguments.
//
// Parameters :  responseEnabled : bool : The response for serial printing is enabled if it's set to true.
//                                        The serial printing is ignored if it's set to false.
//               apiEnabled : bool : The api response is sent if it's set to true.
//                                   Manual response is sent if it's set to false.
//               optionalParameter : String : The input parameter string should contain one element with value of zero.
//
// Return     : void
void getPuffPressureThreshold(bool responseEnabled, bool apiEnabled, String optionalParameter) {
  if (optionalParameter.length() == 1 && optionalParameter.toInt() == 0) {
    getPuffPressureThreshold(responseEnabled, apiEnabled);
  }
}


//***SET PUFF PRESSURE THRESHOLD FUNCTION***//
// Function   : setPuffPressureThreshold
//
// Description: This function sets the current Puff pressure threshold in percentage.
//
// Parameters :  responseEnabled : bool : The response for serial printing is enabled if it's set to true.
//                                        The serial printing is ignored if it's set to false.
//               apiEnabled : bool : The api response is sent if it's set to true.
//                                   Manual response is sent if it's set to false.
//               inputPuffThreshold : float : The new sip pressure threshold in percentage.
//
// Return     : void
//*********************************//
void setPuffPressureThreshold(bool responseEnabled, bool apiEnabled, float inputPuffThreshold) {
  String commandKey = "PT";

  if ((isfinite(inputPuffThreshold) && inputPuffThreshold >= CONF_PRESS_MIN_THRESHOLD && inputPuffThreshold < CONF_PRESS_MAX_THRESHOLD)
      && mem.writeFloat(CONF_SETTINGS_FILE, commandKey, inputPuffThreshold)) {
    // See setSipPressureThreshold: a refused store reports FAIL,3.
    ps.setPuffThreshold(inputPuffThreshold);
    printResponseFloat(responseEnabled, apiEnabled, true, 0, "PT,1", true, inputPuffThreshold);
    // See setSipPressureThreshold: a raised regular floor heals the hard pair here too.
    screen.healHardThresholds();
  }
  else {
    printResponseFloat(responseEnabled, apiEnabled, false, 3, "PT,1", true, inputPuffThreshold);

  }
}
//***SET PUFF PRESSURE THRESHOLD API FUNCTION***//
// Function   : setPuffPressureThreshold
//
// Description: This function is redefinition of main setPuffPressureThreshold function to match the types of API function arguments.
//
// Parameters :  responseEnabled : bool : The response for serial printing is enabled if it's set to true.
//                                        The serial printing is ignored if it's set to false.
//               apiEnabled : bool : The api response is sent if it's set to true.
//                                   Manual response is sent if it's set to false.
//               optionalParameter : String : The input parameter string should contain one element with value of zero.
//
// Return     : void
void setPuffPressureThreshold(bool responseEnabled, bool apiEnabled, String optionalParameter) {
  setPuffPressureThreshold(responseEnabled, apiEnabled, optionalParameter.toFloat());
}

//***GET HARD SIP PRESSURE THRESHOLD FUNCTION***//
// Function   : getHardSipPressureThreshold
//
// Description: Returns the hard sip threshold (upstream #58). The hard band
//              is a second, higher-threshold band: a hold that STARTS beyond
//              it fires its action with no hold-duration requirement. Values
//              live in /settings2.dat. A fresh value is written at first read
//              if missing or invalid. The hard threshold is constrained to
//              be above the regular sip threshold plus CONF_PRESS_HARD_MARGIN_HPA.
//
// Parameters :  responseEnabled : bool : The serial print output is enabled if true.
//               apiEnabled : bool : The API response is sent if true.
//
// Return     : float : the current hard sip threshold [hPa]
//*********************************//
float getHardSipPressureThreshold(bool responseEnabled, bool apiEnabled) {
  String commandKey = "HS";
  // 4.9.1 read-truth doctrine (see getSipPressureThreshold): the heal here
  // raises a hard floor — that CAN strand the band (hard < regular + margin
  // on a regular threshold raised separately), so the getter's heal heals
  // the pair exactly like the setter's.
  float tempHardSipThreshold;
  if (CONF_API_ENABLED) {
    tempHardSipThreshold = mem.readFloat(CONF_SETTINGS2_FILE, commandKey);
    if (mem.isLastReadOk()) {
      if (!isfinite(tempHardSipThreshold) ||
          (tempHardSipThreshold < CONF_PRESS_MIN_THRESHOLD) ||
          (tempHardSipThreshold >= CONF_PRESS_MAX_THRESHOLD)) {
        tempHardSipThreshold = CONF_HARD_SIP_THRESHOLD;
        // 4.9.1: heal only after the write lands (see getSipPressureThreshold).
        if (mem.writeFloat(CONF_SETTINGS2_FILE, commandKey, tempHardSipThreshold)) {
          screen.healHardThresholds();
        }
      }
      ps.setHardSipThreshold(tempHardSipThreshold);
    } else {
      tempHardSipThreshold = ps.getHardSipThreshold();  // in force, not a readback
    }
  } else {
    tempHardSipThreshold = CONF_HARD_SIP_THRESHOLD;
    ps.setHardSipThreshold(tempHardSipThreshold);
  }
  printResponseFloat(responseEnabled, apiEnabled, true, 0, "HS,0", true, tempHardSipThreshold);

  return tempHardSipThreshold;
}

//***GET HARD SIP PRESSURE THRESHOLD API FUNCTION***//
// Function   : getHardSipPressureThreshold (overload)
//
// Description: API entry point for HS,0 — the getter's contract (the heal
//              write of a fresh/invalid stored value included), not a pure read.
//
// Parameters :  responseEnabled, apiEnabled, optionalParameter
//
// Return     : void
//*********************************//
void getHardSipPressureThreshold(bool responseEnabled, bool apiEnabled, String optionalParameter) {
  if (optionalParameter.length() == 1 && optionalParameter.toInt() == 0) {
    getHardSipPressureThreshold(responseEnabled, apiEnabled);
  }
}

//***SET HARD SIP PRESSURE THRESHOLD FUNCTION***//
// Function   : setHardSipPressureThreshold
//
// Description: Sets the hard sip threshold (upstream #58). In addition to the
//              regular absolute range, the value must sit at least
//              CONF_PRESS_HARD_MARGIN_HPA above the LIVE regular sip
//              threshold — the hard band must stay a clearly distinct
//              gesture, and the classifier's hard-sticky semantics rely on
//              hard > regular. A value that violates the margin is refused
//              (FAIL,3, nothing written); the boot-time heal for out-of-order
//              STORED values lives in initSipAndPuff, not here — a serial SET
//              must never silently rewrite what the host sent.
//
// Parameters :  responseEnabled : bool
//               apiEnabled : bool
//               inputHardSipThreshold : float : new hard sip threshold [hPa]
//
// Return     : void
//*********************************//
void setHardSipPressureThreshold(bool responseEnabled, bool apiEnabled, float inputHardSipThreshold) {
  String commandKey = "HS";

  float minHard = ps.getSipPressureThreshold() + CONF_PRESS_HARD_MARGIN_HPA;

  if ((isfinite(inputHardSipThreshold) &&
       inputHardSipThreshold >= CONF_PRESS_MIN_THRESHOLD &&
       inputHardSipThreshold < CONF_PRESS_MAX_THRESHOLD &&
       inputHardSipThreshold >= minHard)
      && mem.writeFloat(CONF_SETTINGS2_FILE, commandKey, inputHardSipThreshold)) {
    // A refused store (settings budget, LSMemory) reports FAIL,3 — same
    // contract as the ST/PT setters.
    ps.setHardSipThreshold(inputHardSipThreshold);
    printResponseFloat(responseEnabled, apiEnabled, true, 0, "HS,1", true, inputHardSipThreshold);
  }
  else {
    printResponseFloat(responseEnabled, apiEnabled, false, 3, "HS,1", true, inputHardSipThreshold);
  }
}

//***SET HARD SIP PRESSURE THRESHOLD API FUNCTION***//
// Function   : setHardSipPressureThreshold (overload)
//
// Description: API entry point for HS,1 (float parameter).
//
// Parameters :  responseEnabled, apiEnabled, optionalParameter
//
// Return     : void
//*********************************//
void setHardSipPressureThreshold(bool responseEnabled, bool apiEnabled, String optionalParameter) {
  setHardSipPressureThreshold(responseEnabled, apiEnabled, optionalParameter.toFloat());
}

//***GET HARD PUFF PRESSURE THRESHOLD FUNCTION***//
// Function   : getHardPuffPressureThreshold
//
// Description: Returns the hard puff threshold (upstream #58). The hard band
//              is a second, higher-threshold band: a hold that STARTS beyond
//              it fires its action with no hold-duration requirement. Values
//              live in /settings2.dat. A fresh value is written at first read
//              if missing or invalid. The hard threshold is constrained to
//              be above the regular puff threshold plus
//              CONF_PRESS_HARD_MARGIN_HPA (the setter enforces the margin;
//              this getter enforces the absolute range).
//
// Parameters :  responseEnabled : bool : The serial print output is enabled if true.
//               apiEnabled : bool : The API response is sent if true.
//
// Return     : float : the current hard puff threshold [hPa]
//*********************************//
float getHardPuffPressureThreshold(bool responseEnabled, bool apiEnabled) {
  String commandKey = "HP";
  // 4.9.1 read-truth doctrine (see getSipPressureThreshold). The heal here
  // cannot strand the band from THIS side (a lowered hard floor only
  // widens it), but healHardThresholds is the one code path — keep it
  // symmetric so a future threshold edit cannot silently diverge.
  float tempHardPuffThreshold;
  if (CONF_API_ENABLED) {
    tempHardPuffThreshold = mem.readFloat(CONF_SETTINGS2_FILE, commandKey);
    if (mem.isLastReadOk()) {
      if (!isfinite(tempHardPuffThreshold) ||
          (tempHardPuffThreshold < CONF_PRESS_MIN_THRESHOLD) ||
          (tempHardPuffThreshold >= CONF_PRESS_MAX_THRESHOLD)) {
        tempHardPuffThreshold = CONF_HARD_PUFF_THRESHOLD;
        // 4.9.1: heal only after the write lands (see getSipPressureThreshold).
        if (mem.writeFloat(CONF_SETTINGS2_FILE, commandKey, tempHardPuffThreshold)) {
          screen.healHardThresholds();
        }
      }
      ps.setHardPuffThreshold(tempHardPuffThreshold);
    } else {
      tempHardPuffThreshold = ps.getHardPuffThreshold();  // in force, not a readback
    }
  } else {
    tempHardPuffThreshold = CONF_HARD_PUFF_THRESHOLD;
    ps.setHardPuffThreshold(tempHardPuffThreshold);
  }
  printResponseFloat(responseEnabled, apiEnabled, true, 0, "HP,0", true, tempHardPuffThreshold);

  return tempHardPuffThreshold;
}

//***GET HARD PUFF PRESSURE THRESHOLD API FUNCTION***//
// Function   : getHardPuffPressureThreshold (overload)
//
// Description: API entry point for HP,0 — the getter's contract (the heal
//              write of a fresh/invalid stored value included), not a pure read.
//
// Parameters :  responseEnabled, apiEnabled, optionalParameter
//
// Return     : void
//*********************************//
void getHardPuffPressureThreshold(bool responseEnabled, bool apiEnabled, String optionalParameter) {
  if (optionalParameter.length() == 1 && optionalParameter.toInt() == 0) {
    getHardPuffPressureThreshold(responseEnabled, apiEnabled);
  }
}

//***SET HARD PUFF PRESSURE THRESHOLD FUNCTION***//
// Function   : setHardPuffPressureThreshold
//
// Description: Sets the hard puff threshold (upstream #58). Mirror of the HS
//              setter — see its comment for the margin rationale.
//
// Parameters :  responseEnabled : bool
//               apiEnabled : bool
//               inputHardPuffThreshold : float : new hard puff threshold [hPa]
//
// Return     : void
//*********************************//
void setHardPuffPressureThreshold(bool responseEnabled, bool apiEnabled, float inputHardPuffThreshold) {
  String commandKey = "HP";

  float minHard = ps.getPuffPressureThreshold() + CONF_PRESS_HARD_MARGIN_HPA;

  if ((isfinite(inputHardPuffThreshold) &&
       inputHardPuffThreshold >= CONF_PRESS_MIN_THRESHOLD &&
       inputHardPuffThreshold < CONF_PRESS_MAX_THRESHOLD &&
       inputHardPuffThreshold >= minHard)
      && mem.writeFloat(CONF_SETTINGS2_FILE, commandKey, inputHardPuffThreshold)) {
    ps.setHardPuffThreshold(inputHardPuffThreshold);
    printResponseFloat(responseEnabled, apiEnabled, true, 0, "HP,1", true, inputHardPuffThreshold);
  }
  else {
    printResponseFloat(responseEnabled, apiEnabled, false, 3, "HP,1", true, inputHardPuffThreshold);
  }
}
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
