goforwest/LipSync/Build_Files/Firmware_Files/LipSync_Firmware/LSScreen.h

/* 
* File: LSScreen.h
* Firmware: LipSync
* Developed by: MakersMakingChange
* Version: v4.1 (28 March 2025)
  License: GPL v3.0 or later

  Copyright (C) 2024 - 2025 Neil Squire Society
  This program is free software: you can redistribute it and/or modify it under the terms of
  the GNU General Public License as published by the Free Software Foundation,
  either version 3 of the License, or (at your option) any later version.
  This program is distributed in the hope that it will be useful, but WITHOUT ANY WARRANTY;
  without even the implied warranty of MERCHANTABILITY or FITNESS FOR A PARTICULAR PURPOSE.
  See the GNU General Public License for more details.
  You should have received a copy of the GNU General Public License along with this program.
  If not, see <http://www.gnu.org/licenses/>
*/

// Header definition
#ifndef _LSSCREEN_H
#define _LSSCREEN_H

#include <SPI.h>
#include <Wire.h>
#include <Adafruit_GFX.h>
#include <Adafruit_SSD1306.h>
#include "LSApiDeclarations.h"

#define CONF_SCREEN_WIDTH 128  // OLED display width, in pixels
#define CONF_SCREEN_HEIGHT 64  // OLED display height, in pixels

#define OLED_RESET -1        // Reset pin # (or -1 if sharing Arduino reset pin)
#define SCREEN_ADDRESS 0x3D  // See datasheet for Address; 0x3D for 128x64, 0x3C for 128x32

#define MAIN_MENU 0
#define EXIT_MENU 1
#define CALIB_MENU 2
#define MODE_MENU 3
#define CURSOR_SP_MENU 4
#define MORE_MENU 5
#define SAFEMODE_MENU 6

// Calibration pages
#define CENTER_RESET_PAGE 21

// Informational dwell pages (4.5.7 review — the CH,0:0 honesty fix): these
// draw-only pages previously left _currentMenu at the page they
// interrupted, so a remote polling after its press saw the OLD page for
// the whole dwell (the exact drift class the endpoint exists to prevent).
// Each names itself for its window, exactly as MODE_LOCKED_PAGE does; the
// continuation restores the real page id.
#define EXITING_PAGE 11          // "Exiting" (0.5 s) -> finishExitMenu
#define CHANGING_MODE_PAGE 33    // "Changing mode." (2 s) -> finishChangeMode (softwareReset)
#define FULL_CALIB_WARN_PAGE 552   // "Incorrect full calib. may cause drift." (3 s) -> fullCalibrationConfirmMenu
#define FACTORY_RESET_WARN_PAGE 572 // "This will erase all custom settings" (2 s) -> factoryResetConfirm2Menu

// Mode pages
#define CONFIRM_MODE_CHANGE 31
// The LK refusal interstitial (bench follow-up 2026-10-18, CH,0:0): the
// locked page previously left _currentMenu at MODE_MENU, so a remote could
// not tell "refused, showing why" from "still on the Mode page" — exactly
// the state the menu-sync endpoint exists to disambiguate. Input stays
// frozen for the page's dwell; finishModeLocked's modeMenu() restores
// MODE_MENU.
#define MODE_LOCKED_PAGE 32
// The destructive hold-gate note (bench 2026-11-06, B5): a too-short hold on
// a destructive row (forget/factory-reset/restart) answered with a bare error
// beep and NO screen change — the user read it as a dead button and kept
// pressing until the forget eventually fired. Same lesson as MODE_LOCKED_PAGE:
// name the refusal. The page remembers the menu it came from; its continuation
// redraws that page (the hold gate spans five source pages, unlike the Mode
// page's single fixed return).
#define HOLD_CONFIRM_NOTE_PAGE 34

// More Menus
#define SOUND_MENU 51
#define LIGHT_BRIGHT_MENU 52
#define SCROLL_SP_MENU 53
#define SIP_PUFF_MENU 54
#define SIP_THRESH_MENU 541
#define PUFF_THRESH_MENU 542
// Upstream #58 (4.7.0): the hard sip/puff band's threshold pages, reachable
// from the Sip & Puff submenu. The hard threshold must stay above the regular
// one plus CONF_PRESS_HARD_MARGIN_HPA — the setter enforces it, the pages
// clamp their steps to the floor, and healHardThresholds() keeps the pair in
// order whenever a regular threshold moves.
#define HARD_SIP_THRESH_MENU 543
#define HARD_PUFF_THRESH_MENU 544
#define FULL_CALIB_PAGE 55
#define FULL_CALIB_CONFIRM_PAGE 551
#define RESTART_PAGE 56
#define FACTORY_RESET_PAGE 57
#define FACTORY_RESET_CONFIRM2_PAGE 571
#define INFO_MENU 58
#define ACCEL_MENU 59
#define RESTRICTIONS_MENU 60
#define TIMING_MENU 61
#define TIMING_ADJUST_MENU 611
// Upstream #16 (4.8.0): the Bluetooth host pages, reachable from the More
// menu. 62 = the host list (rows rebuilt from the bond directory on every
// entry — the bond store IS the host table); 621 = switch confirm; 622 = the
// forget list (up to 8 rows, the on-device valve for the 4-row page cap);
// 623/624 are dwell pages that NAME THEMSELVES for CH,0:0/CH,5 (the 4.5.7
// honesty rule, like CHANGING_MODE_PAGE 33).
#define BT_HOSTS_MENU 62
#define BT_SWITCH_CONFIRM_PAGE 621
#define BT_FORGET_LIST_PAGE 622
#define BT_SWITCHING_PAGE 623
#define BT_NOTE_PAGE 624

#define SCROLL_DELAY_MILLIS 100 // [ms] This controls the scroll speed of long menu items //TODO 2025-Feb-28 Make this user adjustable

#define _MODE_MOUSE_USB 1
#define _MODE_MOUSE_BT 2
#define _MODE_GAMEPAD_USB 3

const int CHAR_PIXEL_HEIGHT_S1 = 8;    // The height of a character on the screen, in pixels, for size 1 text
const int CHAR_PIXEL_WIDTH_S1 = 6;     // The width of a character on the screen, in pixels, for size 1 text

const int CHAR_PIXEL_HEIGHT_S2 = CHAR_PIXEL_HEIGHT_S1 * 2;    // The height of a character on the screen, in pixels, for size 2 text
const int CHAR_PIXEL_WIDTH_S2  = CHAR_PIXEL_WIDTH_S1 * 2;     // The width of a character on the screen, in pixels, for size 2 text

const int TEXT_ROWS = CONF_SCREEN_HEIGHT / CHAR_PIXEL_HEIGHT_S2;

int scrollPixelsPerLoop = 4;

// Define globals
extern bool g_displayConnected;                   // Display connection state
extern bool g_joystickSensorConnected;            // Joystick sensor connection state
extern bool g_mouthpiecePressureSensorConnected;  // Mouthpiece pressure sensor connection state
extern bool g_ambientPressureSensorConnected;     // Ambient pressure sensor connection state
extern bool g_safeModeEnabled;                    // 4.9.1: activateMenu refuses in safe mode (the safe menu owns the display)
extern int g_safeModeReason;                      // Reason safe mode is triggered.
extern bool g_modeLocked;                         // Operating-mode lock (roadmap item 11, LK setting)
extern bool g_calibrationRunning;                  // Full calibration accepted and in flight
extern bool g_centerRunning;                       // Center sample/timer flow in flight
extern String g_deviceUID;                        // Unique Device ID

class LSScreen {

public:
  LSScreen();
  void begin();
  void update();
  void clear();

  void setupDisplay();
  void splashScreen();
  void splashScreen2();

  void nextMenuItem();
  void selectMenuItem();
  bool isMenuActive();
  void activateMenu();
  void deactivateMenu();
  // The user-facing menu CLOSE (serial CH,1:4 and the STOP_MENU input
  // action), frozen-window-aware like activateMenu/nextMenuItem/
  // selectMenuItem: a close arriving while a scheduled page transition or a
  // boot dwell page owns the display is dropped — executing it early would
  // flip _isActive off before the pending continuation registers its menu,
  // leaving a menu that is drawn and navigable but reported inactive (and
  // outside the 5-minute timeout). deactivateMenu itself stays unguarded:
  // the screen's own continuations and the timeout must always be able to
  // run their state machine.
  void closeMenu();

  // Live menu-state read for the serial menu-sync endpoint (CH,0:0, bench
  // follow-up 2026-10-18): fills [active, currentPageId, currentSelection].
  // The remote's drift problem was that a refused select (LK locked → the
  // ~2 s locked page) or a press dropped in a scheduled transition's frozen
  // window acked SUCCESS while the real menu went somewhere the client-side
  // model did not predict — device truth is the only cure. Selection is the
  // SELECTABLE-row index (the same index selectMenuItem() switches on); add
  // the page's _cursorStart offset for the text-array row.
  void fillMenuState(int out[3]);

  // (4.5.7 review) wrap/stale-safe menu-input freeze check — public since
  // upstream #16: the serial BT endpoints refuse while a scheduled transition
  // or dwell page owns the menu, exactly like selectMenuItem/nextMenuItem do.
  bool inputIsFrozen();

  // Two-way Hub remote (firmware side of the CH,5 push, LipSync_Connect's
  // protocol proposal now realized): report the live menu state on the wire
  // whenever it changes, so the app's remote mirror follows PHYSICAL
  // navigation too — the one menu fact that never rode the wire unprompted
  // (settings changes already push MANUAL lines; app-driven presses are
  // followed by the app's own CH,0:0 poll). See reportMenuState for the wire
  // contract; the change-detect is the rate limiter.
  void reportMenuState();

  // Non-blocking page transitions (see scheduleTransition): the continuations
  // run on the screen timer when the informational page's dwell time ends,
  // instead of delay() freezing the whole main loop for 0.2-3 s.
  void scheduleTransition(unsigned long delayMs, void (*transitionFn)());
  void freezeMenuInputFor(unsigned long ms);  // 4.9.1: bare-deadline freeze for flows whose continuation lives on another timer pool (the API calibration path's entry gap)
  void finishExitMenu();
  void beginLongTextScroll();
  void returnToMenu();
  // A serial-API-triggered calibration (#36) must not end by parking the Hub
  // on a main menu nothing opened: when set, the calibration end transition
  // (and the center-reset complete page) closes the menu instead of
  // returning to it. Set by setJoystickCalibration on the API path; the
  // menu-driven path clears it.
  void calibrationEndsByClosingMenu(bool enable);
  void finishChangeMode();
  void fullCalibrationConfirmMenu();
  void factoryResetConfirm2Menu();
  void modeLockedPage();
  void finishModeLocked();
  // Destructive hold-gate note (bench 2026-11-06): names "hold the row to
  // confirm" for a too-short hold instead of a bare beep; _holdNoteReturnMenu
  // carries the page to redraw (the gate spans five source pages).
  void holdConfirmNotePage();
  void finishHoldConfirmNote();
  int _holdNoteReturnMenu = 0;

  // Upstream #16: the Bluetooth host pages. Rows are rebuilt from the bond
  // directory on every page entry; every action re-validates through the
  // LSHostSwitch decision layer (refusals = error cue + named note page).
  void btHostsMenu();
  void btSwitchConfirmPage();
  void btForgetListPage();
  void btSwitchingPage();
  void btNotePage(const String &line1, const String &line2, const String &line3 = String());
  void btNoteForReason(int reason);
  void finishBtSwitch();
  void finishBtNote();

  // The USB-retry loop's error page: drawn at most once per error episode, and
  // only when there is a display on an answerable I2C bus. The old code redrew
  // the full framebuffer on every retry tick (~2 s apart) without either check
  // — against held I2C hardware each draw cost seconds of bounded transaction
  // timeouts, so the retry loop alone dragged every serial exchange to ~2 s.
  void drawUsbErrorPageOnce();
  bool resetUsbErrorPage();

  // Display-health gate state for the bus-health diagnostic endpoint (BH):
  // false means the last framebuffer push wedged or crawled and the display
  // is being re-probed on an exponential backoff instead of trusted.
  bool isDisplayHealthy();

  void centerResetPage();
  void centerResetCompletePage();
  void centerResetFailedPage();
  void fullCalibrationPrompt(int stepNum);
  void calibrationAbortedPage();
  void infoMenu();
  // (4.9.0 review) testPage removed: zero callers anywhere in the tree —
  // a v4.0-era leftover, the same dead-code class as ledStartupEffect.
  void noUsbPage();
  void updateModePage();
  void warningUSBDebugOn();
  void connectionTimingPage(unsigned long, unsigned long);
  void restartPage();
  void safeModePage(int);
  void safeModeMenu();
  void print4LineString(String s1, String s2, String s3, String s4);
  void disableTimeout();
  void enableTimeout();

  bool showCenterResetComplete = false;

  // Public (4.8.1): the serial ST/PT setters heal the hard pair with the
  // same rule the menu pages use — one implementation, two call sites.
  void healHardThresholds();

private:
  Adafruit_SSD1306 _display = Adafruit_SSD1306(CONF_SCREEN_WIDTH, CONF_SCREEN_HEIGHT, &Wire, OLED_RESET);

  LSTimer<void> _screenStateTimer;  // Timer with a callback function
  int _screenStateTimerId = -1;     // Timer ID for screen (-1 = none pending; read by the USB-error-page splash-clear cancel)
  unsigned long _inputFrozenUntil = 0;  // While millis() is before this, menu input is frozen (a scheduled page transition owns the menu)
  int _transitionTimerId = -1;           // Pending scheduled page transition (LSTimer id), -1 = none
  bool _usbErrorPageShown = false;       // The no-USB page has been drawn for the current error episode
  bool _usbErrorPagePainted = false;     // The no-USB page actually reached the OLED this episode (the latch
                                         // can be set on a headless unit where nothing was painted)
  bool _calibrationClosesMenu = false;   // The running calibration was started over the serial API — its end pages close the menu (#36)
  bool _displayHealthy = true;               // Display answers on the I2C bus (mirrors the pressure-sensor health gate)
  bool _begun = false;                       // SSD1306 framebuffer allocated; no draw call is legal before this
  unsigned long _lastDisplayProbeMs = 0;     // Last cheap re-probe while the display was marked unhealthy
  unsigned long _displayProbeIntervalMs = 2000;  // Re-probe cadence; doubles after each wedged push (flaky buses
                                                 // ACK a probe during momentary releases, and every re-trusted
                                                 // full push that then wedges costs seconds of bounded timeouts)
  bool flushDisplay();                   // The single choke point for framebuffer pushes to the I2C bus — true when the framebuffer actually reached the bus (4.9.1: callers can tell a skipped push from a landed one)
  void finishSplashClear();              // The splash/ready page's scheduled self-clear (see its definition)

  bool _isActive = false;
  bool _menuTimeoutEnabled = true;
  int _currentMenu = 0;
  int _prevMenu = -1; // keep track of previous menu
  int _currentSelection = 0;
  int _selectedLine;
  int _cursorPos;

  // Two-way Hub remote (CH,5 push): the last [active, page, row] triple
  // reported on the wire, for reportMenuState's change-detect. Boot state
  // {0,0,0} means the closed-menu triple never prints by itself — the first
  // line is the first real menu event.
  int _lastReportedMenuState[3] = {0, 0, 0};

  int _operatingMode;
  int _tempOperatingMode;
  int _communicationMode;
  int _tempCommunicationMode;
  int _cursorSpeedLevel;
  int _scrollSpeedLevel;
  int _accelLevel;
  int _lightBrightLevel;
  int _soundMode;

  bool _scrollOn = false;
  unsigned long _scrollDelayTimer = millis();
  int _scrollPos = 12;
  const unsigned int _maxCharPerLine = 10;

  int _cursorStart = 0;
  int _countMenuScroll = 0;

  // (4.9.0 review) _testScreenAttempt removed with its only reader,
  // testPage (dead code).

  int _currentMenuLength;
  String *_currentMenuText = nullptr;  // null until a menu page registers (the boot dwell pages set _isActive first); read by the input/CH,5 guards
  String _selectedText;

  float _sipPressThresh;
  float _puffPressThresh;
  float _hardSipPressThresh;   // upstream #58 (4.7.0)
  float _hardPuffPressThresh;
  int _timingWindowSel = 0;  // Timing adjust page target: 0 = short (WS), 1 = long (WL), 2 = max (WM)

  unsigned long _lastActivityMillis;

  uint8_t _hardwareErrorCode = 0; 

  // (4.5.7 review) wrap/stale-safe menu-input freeze check
  void displayMenu();
  void displayCursor();
  void scrollLongText();
  void drawCentreString(const String &buf, int y);
  void modeMenuHighlight();

  void mainMenu();
  void exitConfirmMenu();
  void calibMenu();
  void modeMenu();
  void confirmModeChange();
  void changeMode();
  void cursorSpeedMenu();
  void scrollSpeedMenu();
  void moreMenu();
  void fullCalibrationPage();
  void fullCalibrationConfirmPage();
  void soundMenu();
  void lightBrightMenu();
  void sipPuffThreshMenu();
  void adjustSipThreshMenu();
  void adjustPuffThreshMenu();
  void adjustHardSipThreshMenu();   // upstream #58 (4.7.0)
  void adjustHardPuffThreshMenu();
  void accelMenu();
  void restrictionsMenu();
  void timingMenu();
  void adjustTimingMenu();
  void restartConfirmPage();
  void factoryResetConfirm1Page();
  void factoryResetConfirm2Page();
  void factoryResetPage();

  String _safeModeReasonText = "<Reason>";

  String _mainMenuText[5] = { "Exit Menu", "Center Reset", "Mode", "Cursor Speed", "More" };
  String _exitConfirmText[4] = { "Exit", "settings?", "Confirm", "... Back" };
  String _calibMenuText[4] = { "Center Reset", "... Back", " ", " " };
  String _modeMenuText[4] = { "MOUSE USB", "MOUSE BT", "GAMEPAD ", "... Back" };
  String _modeConfirmText[4] = { "Change", "mode?", "Confirm", "... Back" };
  String _cursorSpMenuText[4] = { "Speed: ", "Increase", "Decrease", "... Back" };
  String _moreMenuText[12] = { "Sound",  "Light Brightness", "Scroll Speed",   "Sip & Puff",  "Full Calibration",   "Restart LipSync",  "Factory Reset",  "Info", "Acceleration", "Restrictions", "Bluetooth", "... Back",  };
  // Upstream #16: the Bluetooth host pages' row buffers, rebuilt on every
  // page entry from the bond directory (lsHostEnumerate). The forget list
  // shows up to LSHOST_ENUM_CAP rows; the host page caps at LSHOST_MENU_MAX_ROWS.
  String _btHostsText[LSHOST_ENUM_CAP + 2];
  String _btMenuText[LSHOST_MENU_MAX_ROWS + 3];
  String _btConfirmText[4];   // switch confirm: header, target, Confirm, Back
  int _btHostCount = 0;   // exposed bond count at the last enumeration (capped at LSHOST_ENUM_CAP)
  int _btTargetRow = 0;   // pending switch target (1-based enumeration row)
  String _btSwitchTargetMac = "";  // the target's identity captured at confirm-render — finishBtSwitch verifies the executed row still IS the one the page named (MAC-sorted rows renumber in-range when the bond set changes)
  bool _btSwitchTargetWasActive = false;  // bench 2026-11-09: was the target ALREADY the active host when this confirm page rendered? Distinguishes the blatant "you picked the connected host" (name the refusal) from the benign "the target claimed the link during the dwell" (silent refresh — the outcome the user asked for). The two are identical at execution time; only the render-time capture can tell them apart.
  int _btForgetHostRows = 0;  // selectable host rows the forget list rendered with (the destructive-hold gate reads it)
  String _btForgetRowMacs[LSHOST_ENUM_CAP];  // per-row identity captured at forget-list render (lsHostExecuteForget refuses a renumbered match — the wrong host must never be erased)
  String _soundMenuText[4] = { "Sound:", "<>", "Turn <>", "... Back" };
  String _lightBrightMenuText[4] = { "Lights: ", "Increase", "Decrease", "... Back" };
  String _scrollSpMenuText[4] = { "Speed: ", "Increase", "Decrease", "... Back" };
  String _accelMenuText[4] = { "Accel: ", "Increase", "Decrease", "... Back" };
  // Upstream #58 (4.7.0): the hard band's two rows sit between Timing and
  // Back, so every pre-4.7.0 row keeps its index and the added rows append
  // in front of Back.
  String _sipPuffThreshMenuText[6] = { "Sip Threshold", "Puff Threshold", "Timing", "Hard Sip", "Hard Puff", "... Back" };
  String _adjustSipThreshMenuText[4] = { "Sip: ", "Increase", "Decrease", "... Back" };
  String _adjustPuffThreshMenuText[4] = { "Puff: ", "Increase", "Decrease", "... Back" };
  String _adjustHardSipThreshMenuText[4] = { "Hard Sip: ", "Increase", "Decrease", "... Back" };
  String _adjustHardPuffThreshMenuText[4] = { "Hard Puff: ", "Increase", "Decrease", "... Back" };
  // Input timing (roadmap item 15, upstream #62): the three window
  // boundaries, each adjusted on its own page in 250 ms steps.
  String _timingMenuText[4] = { "Short: ", "Long: ", "Max: ", "... Back" };
  String _timingAdjustMenuText[4] = { "Short: ", "Increase", "Decrease", "... Back" };
  // Input restrictions (roadmap item 11): one line per toggle, state shown
  // inline; selecting a line flips that restriction.
  String _restrictionsMenuText[5] = { "Sip&Puff: On", "Menu: All", "Mode lock: Off", "Cursor hold: Off", "... Back" };
  String _restartConfirmText[4] = { "Restart", "LipSync?", "Confirm", "... Back" };
  String _factoryResetConfirm1Text[4] = { "Reset to", "defaults?", "Confirm", "... Back" };
  String _factoryResetConfirm2Text[4] = { "Are you", "sure?", "Confirm", "... Back" };
  String _fullCalibrationConfirmText[4] = { "Are you", "sure?", "Confirm", "... Back" };
  String _infoMenuText[4] = {"Info", "Version","ID","... Back"};
  String _safeModeMenuText[4] = {"SAFE MODE", "Options:", "Restart", "Factory Reset"};

  // Number of selectable options in each menu
  const int _mainMenuLen = 5;
  const int _exitConfirmLen = 2;
  const int _calibMenuLen = 2;
  const int _modeMenuLen = 4;
  const int _cursorSpMenuLen = 3;
  const int _moreMenuLen = 12;
  const int _soundMenuLen = 2;
  const int _lightBrightMenuLen = 3;
  const int _scrollSpMenuLen = 3;
  const int _accelMenuLen = 3;
  const int _sipPuffThreshMenuLen = 6;
  const int _adjustSipThreshMenuLen = 3;
  const int _adjustPuffThreshMenuLen = 3;
  const int _adjustHardSipThreshMenuLen = 3;
  const int _adjustHardPuffThreshMenuLen = 3;
  const int _restrictionsMenuLen = 5;
  const int _timingMenuLen = 4;
  const int _timingAdjustMenuLen = 3;
  const int _restartConfirmLen = 2;
  const int _factoryResetConfirm1Len = 2;
  const int _factoryResetConfirm2Len = 2;
  const int _fullCalibrationConfirmLen = 2;
  const int _safeModeMenuLen = 2;
  const int _infoMenuLen = 1;
};


//*********************************//
// Function   : LSScreen
//
// Description: Class for display object
//
// Arguments :  void
//
// Return     : void
//*********************************//
LSScreen::LSScreen() {
}

//*********************************//
// Function   : begin
//
// Description: Activates and clears display
//
// Arguments :  void
//
// Return     : void
//*********************************//
void LSScreen::begin() {

  if (_display.begin(SSD1306_SWITCHCAPVCC, SCREEN_ADDRESS)) {  // SSD1306_SWITCHCAPVCC = generate display voltage from 3.3V internally
    _begun = true;
    g_displayConnected = true;
  } else {
    Serial.println(F("ERROR: Display SSD1306 allocation failed"));

    g_displayConnected = false;
    _displayHealthy = false;
    _begun = false;
    return;  // Adafruit_SSD1306 draw calls dereference a null framebuffer after allocation failure
  }

  setupDisplay();  // Clear screen
  _display.setTextWrap(false);
  flushDisplay();

  _operatingMode = getOperatingMode(false, false);  // TODO JDMc 2025-Jan-24 These should be moved to update function so they are updated if changed through serial API
  _communicationMode = getCommunicationMode(false, false);
  _soundMode = getSoundMode(false, false);

  _lastActivityMillis = millis();
}

//*********************************//
// Function   : clear
//
// Description: Clears the display.
//
// Arguments :  void
//
// Return     : void
//*********************************//
void LSScreen::clear() {
  if (!_begun) return;
  //_display.clearDisplay();
  setupDisplay();
}


//*********************************//
// Function   : update
//
// Description: Refreshes the display and scrolls text if necessary
//
// Arguments :  void
//
// Return     : void
//*********************************//
void LSScreen::update() {
  _screenStateTimer.run();

  // Loop for screen functions
  if (_scrollOn) {
    scrollLongText();
  }

  if (((millis() - _lastActivityMillis) > CONF_MENU_TIMEOUT) && _isActive && _menuTimeoutEnabled) {
    deactivateMenu();
  }
}

//*********************************//
// Function   : inputIsFrozen
//
// Description: True while a scheduled page transition or boot dwell owns the
//              menu and input must be dropped. Wrap-safe AND stale-safe
//              (4.5.7 review): a genuine freeze is always a short window in
//              the FUTURE, so the remaining time is a small positive. The
//              bare `(long)(millis() - _inputFrozenUntil) < 0` idiom flipped
//              to "frozen" for the entire millis() window [T+2^31, T+2^32)
//              — ~24.9 days — whenever _inputFrozenUntil was 0 (never set on
//              a normal boot) or left far in the past, silently jamming the
//              Hub menu for a 25-day stretch of a long-uptime device. Bound
//              the honored window to well above the longest real freeze
//              (the ~3 s dwell/transition/center windows) so a stale
//              timestamp can never read as frozen.
//
// Arguments :  void
//
// Return     : bool : true = input frozen
//*********************************//
bool LSScreen::inputIsFrozen() {
  // 4.6.6: a deadline that has passed is CONSUMED on first observation. The
  // old form left _inputFrozenUntil stale forever, and a stale timestamp
  // re-enters the honored band once per millis() wrap (49.7 days): for the
  // 15 s before (deadline mod 2^32), the unsigned subtraction wraps small
  // and positive and the menu silently dropped every input — including
  // acking serial CH presses while honoring nothing. With the consume, a
  // deadline is only ever honored inside its real window: the first poll
  // after expiry (≤ one 20 ms tick) clears it, decades before any wrap
  // could resurrect it, and the factory value 0 is refused outright.
  // (4.9.0 review) a PENDING TRANSITION owns the menu even after its freeze
  // deadline is consumed: the poll slots fire inputLoop before screenLoop,
  // so on the exact pass where the deadline expires, a physical close landed
  // (unfrozen, deadline consumed) BEFORE the same pass's screen slot ran the
  // continuation — which then re-registered its page unconditionally: the
  // drawn-but-dead state closeMenu exists to prevent, with CH,0 honestly
  // answering "closed" while the OLED shows a page. The timer id is the
  // truth about who owns the flow; freeze on it too — probed through
  // isEnabled so a stale id (a continuation that ever forgot its clear-first
  // invariant) can NEVER freeze input forever: a fired RUN_ONCE slot is
  // deleted (callback NULL → isEnabled false), while a genuinely pending
  // transition is enabled until the pass it fires.
  if (_transitionTimerId >= 0 && _screenStateTimer.isEnabled(_transitionTimerId)) return true;
  if (_inputFrozenUntil == 0) return false;
  long remaining = (long)(_inputFrozenUntil - millis());
  if (remaining > 0) {
    return remaining <= (long)CONF_SCREEN_INPUT_FREEZE_MAX_MS;
  }
  _inputFrozenUntil = 0;  // expired — never honored again
  return false;
}

//*********************************//
// Function   : activateMenu
//
// Description: Changes display mode to active and loads main menu
//
// Arguments :  void
//
// Return     : void
//*********************************//
void LSScreen::activateMenu() {
  if (!_begun || !g_displayConnected) return;
  // 4.9.1: safe mode owns the display — the safe menu (Restart / Factory
  // Reset) is the ONLY menu the action tables expose on a settled safe boot
  // (CONF_ACTION_START_MENU is NOTHING in every safe-mode cell), and the
  // physical input path cannot reach this method there. The serial CH,1
  // route could: it registered the FULL main menu over the safe menu,
  // handing a sip/puff user (via the app's own remote) calibration, mode
  // changes and settings writes on a unit that just booted unsafe. The
  // refusal mirrors the action-table doctrine; controlHubMenu answers the
  // named FAIL for it.
  if (g_safeModeEnabled) return;
  if (inputIsFrozen()) return;  // A scheduled page transition owns the menu right now (wrap/stale-safe — see inputIsFrozen)
  if (!Wire.busHealthy()) return;  // Held I2C bus — the menu could not draw anyway; don't feed the timeout tax

  _lastActivityMillis = millis();
  _isActive = true;
  _countMenuScroll = 0;
  _operatingMode = getOperatingMode(false, false);
  _communicationMode = getCommunicationMode(false, false);  // 4.5.7 review: a live CM,1 switch (no reset) left the Mode page highlighting the stale com mode until reboot

  mainMenu();
}

//*********************************//
// Function   : deactivateMenu
//
// Description: Changes display mode to inactive and clears display.
//
// Arguments :  void
//
// Return     : void
//*********************************//
void LSScreen::deactivateMenu() {
  _isActive = false;
  clear();
  flushDisplay();
}

//*********************************//
// Function   : closeMenu
//
// Description: The user-facing menu close (serial CH,1:4, the STOP_MENU
//              input action): drops the close while a scheduled page
//              transition or a boot dwell page owns the display, so a
//              pending continuation can never register its menu onto an
//              _isActive the close already turned off (a menu that draws
//              and navigates but reports inactive, outside the timeout —
//              the same frozen-window contract activateMenu /
//              nextMenuItem / selectMenuItem already enforce).
//
// Arguments :  void
//
// Return     : void
//*********************************//
void LSScreen::closeMenu() {
  if (inputIsFrozen()) return;  // A scheduled page transition / boot dwell page owns the display right now (wrap/stale-safe — see inputIsFrozen)
  deactivateMenu();
}

//*********************************//
// Function   : scheduleTransition
//
// Description: Shows an informational page, then runs `transitionFn` after
//              `delayMs` on the screen timer. Replaces the delay() calls that
//              froze the entire main loop (serial API, joystick, pressure)
//              for the dwell time of each page. Menu input is frozen for the
//              same window so button presses are dropped exactly as they were
//              under the old blocking wait — the rest of the device keeps
//              running. Only one transition may be pending; a new one
//              replaces it (and unfreezes input for its own window).
//
// Arguments :  delayMs : unsigned long : page dwell time in milliseconds
//              transitionFn : void (*)() : free-function continuation (defined
//                            in LipSync_Firmware.ino)
//
// Return     : void
//*********************************//
void LSScreen::scheduleTransition(unsigned long delayMs, void (*transitionFn)()) {
  // ONE slot for every scheduled continuation (delete-before-schedule).
  // 4.8.1 review note: displayCursor's long-text scroll delay shares this
  // slot. That is safe today because every render path into displayCursor
  // is inputIsFrozen-gated (nextMenuItem/selectMenuItem/continuations), so a
  // scroll redraw can never land while a mode-switch/BT dwell is pending.
  // Any FUTURE event-driven render (e.g. a BLE-event-triggered btHostsMenu
  // refresh) must NOT call displayCursor directly while a dwell may be
  // pending — it would delete the pending continuation and strand the flow.
  _inputFrozenUntil = millis() + delayMs;
  if (_transitionTimerId >= 0) {
    _screenStateTimer.deleteTimer(_transitionTimerId);
  }
  _transitionTimerId = _screenStateTimer.setTimeout(delayMs, transitionFn);
  if (_transitionTimerId < 0) {
    _inputFrozenUntil = 0;
    if (transitionFn != nullptr) transitionFn();
  }
}

// 4.9.1: a BARE-deadline freeze for flows whose continuation lives on a
// DIFFERENT timer pool than _screenStateTimer (the API calibration chain's
// entry gap lives on calibrationTimer, invisible to inputIsFrozen's
// transition-timer probe). The 15 s honor cap (see inputIsFrozen) bounds it
// — keep callers under it, like every other bare deadline.
void LSScreen::freezeMenuInputFor(unsigned long ms) {
  _inputFrozenUntil = millis() + ms;
}

// Each continuation first clears the pending-transition id (the timer just
// fired), so a later scheduleTransition cannot delete a recycled timer slot.

void LSScreen::finishExitMenu() {
  _transitionTimerId = -1;
  deactivateMenu();
}

void LSScreen::beginLongTextScroll() {
  _transitionTimerId = -1;
  scrollLongText();
}

void LSScreen::returnToMenu() {
  _transitionTimerId = -1;
  if (_calibrationClosesMenu) {
    // #36: this calibration run was started over the serial API — the menu
    // was not how the flow started, so it must not be how it ends. Close it,
    // then show the ready page: a merely blank screen reads as "dead" and
    // invites a long wake-puff — which is START_MENU (3-8 s) and puts the
    // menu right back (observed on hardware, 2026-10-14). The ready page
    // tells the user the device is finished and usable, then clears itself.
    _calibrationClosesMenu = false;
    _isActive = false;
    clear();
    flushDisplay();
    if (g_displayConnected && Wire.busHealthy()) {
      splashScreen2();
    }
    return;
  }
  if (_isActive) {
    mainMenu();
  } else {
    deactivateMenu();
  }
}

void LSScreen::calibrationEndsByClosingMenu(bool enable) {
  _calibrationClosesMenu = enable;
}

void LSScreen::finishChangeMode() {
  _transitionTimerId = -1;

  // 4.8.1: the 4.6.6 TOCTOU fix re-checks the lock at the CONFIRMING select,
  // but the executor runs at the END of the 2 s "Changing mode." dwell — a
  // caregiver enabling LK over serial DURING the dwell (menu input is
  // frozen, the API is not) still persisted + reset the locked change. The
  // same refusal shape as the confirm gate, re-checked where the action
  // actually happens (the exact pattern finishBtSwitch uses for its own
  // TOCTOU re-validation).
  if (g_modeLocked) {
    buzzerErrorCue();
    modeLockedPage();
    return;
  }

  // Persist both halves before the single reset. Calling the public setters
  // sequentially is not atomic: CM resets immediately on change, so a
  // Bluetooth-mouse -> USB-gamepad menu change rebooted after CM and never
  // stored OM. Direct validated writes make the pair land together from the
  // menu's already constrained choices.
  bool stored = storeModePair(_tempOperatingMode, _tempCommunicationMode);
  if (!stored) {
    buzzerErrorCue();
    modeMenu();
    return;
  }

  _communicationMode = _tempCommunicationMode;
  _operatingMode = _tempOperatingMode;
  softwareReset();
}

void LSScreen::fullCalibrationConfirmMenu() {
  _transitionTimerId = -1;
  _currentMenu = FULL_CALIB_CONFIRM_PAGE;
  _currentMenuLength = _fullCalibrationConfirmLen;
  _currentMenuText = _fullCalibrationConfirmText;
  _cursorStart = 2;
  _currentSelection = 0;
  _countMenuScroll = 0;

  displayMenu();  //  Print items in current menu
}

void LSScreen::factoryResetConfirm2Menu() {
  _transitionTimerId = -1;
  _currentMenu = FACTORY_RESET_CONFIRM2_PAGE;
  _currentMenuLength = _factoryResetConfirm2Len;
  _currentMenuText = _factoryResetConfirm2Text;
  _cursorStart = 2;
  _currentSelection = 0;
  _countMenuScroll = 0;  // 4.5.7 review: stale parent-menu scroll offset indexed past this 4-element array

  displayMenu();  //  Print items in current menu
}

void LSScreen::drawUsbErrorPageOnce() {
  if (_usbErrorPageShown) return;
  if (!g_displayConnected) {  // Nothing to draw on
    _usbErrorPageShown = true;
    return;
  }
  if (!Wire.busHealthy()) return;  // Bus is held — a draw would only feed the timeout tax; retried on the next connection check
  if (!_isActive) {
    // Cancel the ready page's pending 10 s self-clear: it was armed by the
    // splash this episode interrupted, and if it fires while the No-USB page
    // is on the OLED it wipes it — and the once-per-episode latch this
    // function sets would then keep the page from ever redrawing (a blank
    // screen for the rest of the outage, bench-audit finding). The error
    // page owns the display until the episode clears. Safe against
    // recycled slots because every continuation that fires from a
    // _screenStateTimerId registration resets it (see finishSplashClear and
    // the boot-page chain) — the id only ever names a genuinely pending
    // timer, never a fired-and-reused slot.
    if (_screenStateTimerId >= 0) {
      _screenStateTimer.deleteTimer(_screenStateTimerId);
      _screenStateTimerId = -1;
    }
    noUsbPage();
    // 4.9.1: the painted latch follows the PUSH, not the RAM draw. The old
    // shape latched unconditionally although flushDisplay() (void) can
    // silently skip the push while the display is health-demoted — the page
    // existed only in RAM while the once-per-episode gate blocked every
    // retry for the rest of the outage, i.e. the page failed during the
    // exact failure it exists for. A skipped push leaves the episode
    // un-latched so the next connection check redraws it.
    if (flushDisplay()) {
      _usbErrorPagePainted = true;
      _usbErrorPageShown = true;
    }
    return;
  }
  _usbErrorPageShown = true;
}

bool LSScreen::resetUsbErrorPage() {
  // #63 residual, round 2 (bench 2026-10-16, reproduced twice): the clear is
  // ONE-SHOT — usbCheckConnection's healthy branch never re-arms — and it
  // cleared the episode latch unconditionally while gating the actual draw
  // behind bus/display health. One healthy tick landing while the bus was in
  // its 1 s post-recovery window (or the display in a re-probe backoff)
  // consumed the only clear: latch gone, timer dead, and the No-USB page
  // stayed on the OLED for the rest of the boot on a fully working device —
  // the user had to restart by hand. The clear now succeeds only when the
  // ready page can actually land; the caller re-arms while it cannot.
  if (!_usbErrorPageShown) return true;
  if (!_usbErrorPagePainted) {
    // The latch was set but nothing ever reached the OLED (headless unit, or
    // every draw was gated) — nothing on screen needs fixing.
    _usbErrorPageShown = false;
    return true;
  }
  if (_isActive || !g_displayConnected || !Wire.busHealthy() || !_displayHealthy) return false;
  _usbErrorPageShown = false;
  _usbErrorPagePainted = false;
  splashScreen2();
  return true;
}

//*********************************//
// Function   : finishSplashClear
//
// Description: The splash/ready page's scheduled self-clear, as a member so
//              it can keep _screenStateTimerId honest (the 4.5.5 follow-up
//              audit): every continuation that fires from a
//              _screenStateTimerId slot resets the id, exactly the way the
//              scheduleTransition continuations reset _transitionTimerId
//              (see the invariant documented there) — a fired RUN_ONCE
//              timeout frees its slot, and the pool hands that slot to the
//              NEXT registration, so a stale id read later could delete a
//              live, unrelated timer. The only reader is the USB-error
//              page's splash-clear cancel, which must stay able to kill a
//              genuinely pending splash clear without any chance of hitting
//              a recycled slot.
//
// Arguments :  void
//
// Return     : void
//*********************************//
void LSScreen::finishSplashClear() {
  _screenStateTimerId = -1;  // The timer just fired — its slot is free again
  if (!_isActive) {
    // Same body the clearSplashScreen free function had: blank the display
    // once the splash's dwell ends and no menu took it over.
    deactivateMenu();
  }
}

bool LSScreen::isDisplayHealthy() {
  return _begun && _displayHealthy;
}

//*********************************//
// Function   : flushDisplay
//
// Description: The single choke point for pushing the framebuffer to the
//              display. Text and clear calls only touch the RAM buffer;
//              display() is what drives the I2C bus — and against a held
//              bus (a failing display or sensor) each push costs seconds of
//              bounded transaction timeouts. Skipping the push while the
//              bus is wedged keeps boot sequences, the safe-mode menu and
//              every page transition cheap; the page state machines still
//              advance, and the next flush after the bus recovers catches
//              the drawing up. Without this, chained boot-time draws could
//              outrun the 30 s watchdog and reset the device in a loop.
//
// Arguments :  void
//
// Return     : bool : true when the framebuffer actually reached the bus —
//              false on every skip (not begun, display demoted, probe
//              failed, bus held). 4.9.1: the return lets a caller distinguish
//              "drawn to RAM, push skipped" from "pushed" — drawUsbErrorPageOnce
//              uses it to keep its retry alive across a demoted display
//              (a void return made the caller latch the page as painted
//              although it never reached the glass).
//*********************************//
bool LSScreen::flushDisplay() {
  if (!_begun || !g_displayConnected) return false;
  // Display health gate (mirrors the pressure sensors'): a full framebuffer
  // push against a held or absent display costs seconds of bounded
  // transaction timeouts — and a flaky bus ACKs probes during momentary
  // releases, so every re-trusted push can wedge all over again. One wedged
  // push demotes the display; re-probes are a single cheap address ACK on an
  // exponentially backing-off cadence (2 s doubling to 60 s, reset by a clean
  // push). This keeps boot sequences, readyToUse() pages and the safe-mode
  // menu from stalling the main loop — or outrunning the 30 s watchdog at
  // boot — when the display side of the shared I2C bus is dead or flaky.
  if (!_displayHealthy) {
    if (millis() - _lastDisplayProbeMs < _displayProbeIntervalMs) return false;
    _lastDisplayProbeMs = millis();
    Wire.beginTransmission(SCREEN_ADDRESS);
    if (Wire.endTransmission() != 0) return false;  // Still not answering
    _displayHealthy = true;                   // ACKed — the next flush pushes for real
  }

  if (!Wire.busHealthy()) return false;  // Bus held by something else — retry on a later flush

  uint32_t recoveriesBefore = Wire.recoveryCount();
  unsigned long pushStartMs = millis();
  _display.display();
  unsigned long pushMs = millis() - pushStartMs;
  if (Wire.recoveryCount() != recoveriesBefore || pushMs > 100) {
    // This push wedged the bus, or crawled through it: a flaky device can
    // drag every transfer until it completes slowly without ever tripping a
    // timeout — a healthy push takes ~5-10 ms, anything past 100 ms means
    // the shared bus is being dragged. One strike, and back off.
    _displayHealthy = false;
    _displayProbeIntervalMs = _displayProbeIntervalMs * 2;
    if (_displayProbeIntervalMs > 60000) _displayProbeIntervalMs = 60000;
  } else {
    _displayProbeIntervalMs = 2000;  // Clean push — restore the base re-probe cadence
  }

  // Two-way Hub remote (see reportMenuState): every menu redraw ends here,
  // so this single hook turns a menu state change into a wire push — open,
  // navigation, page transitions, the exit/timeout close all flow through
  // it. It runs only when the framebuffer actually reached the bus: while
  // the display is demoted the menu's internal state advances but nothing
  // is shown, and the app's CH,0:0 poll still reads the same truth.
  // (4.9.0 review — the deliberate CH,5 ordering, pinned: reportMenuState
  // runs INSIDE the page render, i.e. inside controlHubMenu's execution, so
  // a CH,5 push lands BEFORE the CH,1 SUCCESS frame of the press that caused
  // it. The BT,1 rule is the opposite (INFO lines strictly after the ack) —
  // the difference is deliberate: a CH,5 push is IDEMPOTENT state telemetry
  // the mirror consumes wherever it lands, while a BT,1 INFO line narrates
  // the command's own outcome and must not precede it. Reordering CH,5 after
  // the ack would require exiting the render path and desyncing the
  // framebuffer-push coupling for no reader benefit.)
  reportMenuState();
  return true;
}

//*********************************//
// Function   : isMenuActive
//
// Description: Returns a boolean representing state of menu
//
// Arguments :  void
//
// Return     : bool : _isActive : true = menu activated
//*********************************//
bool LSScreen::isMenuActive() {

  return _isActive;
}

//*********************************//
// Function   : splashScreen
//
// Description: Displays a screen with the device name and version. To be used when the device starts up.
//
// Arguments :  void
//
// Return     : void
//*********************************//
void LSScreen::splashScreen() {
  if (!_begun) return;
  setupDisplay();

  _display.setTextSize(2);
  drawCentreString("LipSync", 12);

  _display.setTextSize(1);
  drawCentreString(CONF_LIPSYNC_VERSION_STRING, 32);
  drawCentreString("Makers Making Change", 54);

  flushDisplay();
}

//*********************************//
// Function   : splashScreen2
//
// Description: Displays a screen indicating it is ready to use (center reset complete) and indicating the mode.
//
// Arguments :  void
//
// Return     : void
//*********************************//
void LSScreen::splashScreen2() {
  if (!_begun) return;
  setupDisplay();

  _display.setTextSize(2);
  drawCentreString("Ready to", 0);
  drawCentreString("use", 16);
  _display.setTextSize(1);
  drawCentreString("Mode:", 40);
  _display.setTextSize(2);


  _display.setTextSize(2);

  switch (_operatingMode) {
    case CONF_OPERATING_MODE_MOUSE:
      switch (_communicationMode) {
        case CONF_COM_MODE_USB:
          drawCentreString("USB Mouse", 48);
          break;
        case CONF_COM_MODE_BLE:
          drawCentreString("BT Mouse", 48);
          break;
      }
      break;
    case CONF_OPERATING_MODE_GAMEPAD:
      _display.setCursor(1, 48);
      _display.print("USB");
      _display.setTextSize(1);
      _display.print(" ");
      _display.setTextSize(2);
      _display.print("Gamepad");  // text size changed for space so it would all fit on one line
      //_display.print("USB"); _display.setTextSize(1); _display.print(" "); _display.setTextSize(2); _display.print("Gamepad"); // text size changed for space so it would all fit on one line
      //drawCentreString("Gamepad", 48);
      break;
    case CONF_OPERATING_MODE_SAFE:
      // Currently bypassed since safe mode menus are called directly
      break;
    default:
      _display.println("Error");
  }

  flushDisplay();

  if (USB_DEBUG){
    //delay(2000);  //TODO - 2025-FEB-21 Why is this delay here?
    warningUSBDebugOn();
  } else {
    // Delete-before-rearm (4.5.7 review): every writer of _screenStateTimerId
    // first deletes any genuinely pending predecessor — the id only ever
    // names a live timer (the continuations reset it when they fire), so a
    // second arm could never leak an orphaned splash-clear/safe-mode timer
    // whose late firing would blank whatever page owns the display then.
    // The same guard applies at warningUSBDebugOn/restartPage/
    // factoryResetPage/safeModePage.
    if (_screenStateTimerId >= 0) {
      _screenStateTimer.deleteTimer(_screenStateTimerId);
    }
    _screenStateTimerId = _screenStateTimer.setTimeout<LSScreen, &LSScreen::finishSplashClear>(CONF_SPLASH_SCREEN_DURATION, this);
  }

  _lastActivityMillis = millis();
}

//****************************************//
// Functions called from inputs
//****************************************//

//*********************************//
// Function   : nextMenuItem
//
// Description: Cycles to the next item based on current selection and menu.
//
// Arguments :  void
//
// Return     : void
//*********************************//
void LSScreen::nextMenuItem() {
  if (!_begun) return;
  if (inputIsFrozen()) return;  // A scheduled page transition owns the menu right now (wrap/stale-safe — see inputIsFrozen)
  if (!_isActive) return;  // No open menu (4.5.7 review): the serial CH,1 vector used to keep driving the STALE page after a close — deactivateMenu never nulls _currentMenuText, so a NEXT painted a cursor over the ready splash and a SELECT executed the stale page's switch (a stale RESTART_PAGE row reset the device; a stale MORE walk reached the factory reset) while CH,0:0 truthfully answered "no menu". Physical inputs were already gated on isMenuActive(); the serial vector now gets the same gate.
  if (_currentMenuText == nullptr) return;  // No menu page is registered yet (the safe-mode/error boot pages set _isActive before safeModeMenu registers state)

  _lastActivityMillis = millis();

  if (_scrollOn) {
    _display.setCursor(0, _selectedLine * 16);
    _display.print("                                   ");
    _display.setCursor(12, _selectedLine * 16);
    _display.print(_selectedText);
  }

  _currentSelection++;  // Increment current selection by one 
  
  if (_currentSelection >= _currentMenuLength) { // if 
    _currentSelection = 0;
    _countMenuScroll = 0;
    displayMenu();  //  Print items in current menu and display cursor
  } else if (_currentSelection + _cursorStart > TEXT_ROWS - 1) {
    _countMenuScroll++;
    displayMenu();  //  Print items in current menu and display cursor
  } else {
    displayCursor();
  }

}



//*********************************//
// Function   : selectMenuItem
//
// Description: Activates the appropriate action when the current selection is selected.
//
// Arguments :  void
//
// Return     : void
//*********************************//
void LSScreen::selectMenuItem() {
  if (!_begun) return;
  if (inputIsFrozen()) return;  // A scheduled page transition owns the menu right now (wrap/stale-safe — see inputIsFrozen)
  if (!_isActive) return;  // No open menu (4.5.7 review) — see nextMenuItem(): a closed menu's stale page must not execute from the serial CH,1 vector
  if (_currentMenuText == nullptr) return;  // No menu page is registered yet (the safe-mode/error boot pages set _isActive before safeModeMenu registers state)

  _lastActivityMillis = millis();

  // Destructive safe-menu and confirmation selections require a deliberate
  // hold. Short electrical glitches previously walked and confirmed these
  // rows; serial CH presses carry UINT32_MAX and intentionally bypass because
  // the wire has no hold-duration concept. A Bluetooth-host forget (#16)
  // joins them: it erases a stored bond, and the execute step is immediate.
  bool destructiveSelection =
      (_currentMenu == SAFEMODE_MENU && (_currentSelection == 0 || _currentSelection == 1)) ||
      (_currentMenu == RESTART_PAGE && _currentSelection == 0) ||
      (_currentMenu == FACTORY_RESET_PAGE && _currentSelection == 0) ||
      (_currentMenu == FACTORY_RESET_CONFIRM2_PAGE && _currentSelection == 0) ||
      (_currentMenu == BT_FORGET_LIST_PAGE && _currentSelection < _btForgetHostRows);
  unsigned long confirmHoldMs = effectiveWindowMs(CONF_INPUT_WINDOW_SHORT_DEFAULT_MS) / 2;
  if (confirmHoldMs < CONF_MENU_CONFIRM_HOLD_MIN_MS) confirmHoldMs = CONF_MENU_CONFIRM_HOLD_MIN_MS;
  if (destructiveSelection && g_menuInputHoldMs != 0xFFFFFFFFUL && g_menuInputHoldMs < confirmHoldMs) {
    // Bench 2026-11-06 (B5): this path was a bare beep — the user read it as
    // a dead button and kept pressing until the forget eventually fired.
    // Name the refusal (the modeLockedPage lesson): a 2 s "hold to confirm"
    // note, then redraw the page the selection came from.
    buzzerErrorCue();
    holdConfirmNotePage();
    return;
  }

  _countMenuScroll = 0;
  switch (_currentMenu) {
    case MAIN_MENU:
      _prevMenu = MAIN_MENU;
      _currentMenu = _currentSelection + 1;
      switch (_currentMenu) {
        case MAIN_MENU:
          mainMenu();
          break;
        case EXIT_MENU:
          exitConfirmMenu();
          break;
        case CALIB_MENU:
          calibMenu();
          break;
        case MODE_MENU:
          modeMenu();
          break;
        case CURSOR_SP_MENU:
          cursorSpeedMenu();
          break;
        case MORE_MENU:
          moreMenu();
          break;
      }
      break;
    case EXIT_MENU:
      if (_currentSelection == 1) {
        _currentSelection = 0;
        mainMenu();
      } else {
        _currentMenu = EXITING_PAGE;  // Name the dwell (4.5.7 review): a CH,0:0 poll during the 0.5 s window sees the page actually shown, not the confirm page it interrupted
        setupDisplay();
        _display.println("Exiting");
        flushDisplay();
        scheduleTransition(500, screenExitTransitionDone);  // was delay(500) — the menu closes on the next ticks
      }
      break;
    case CALIB_MENU:
      if (_currentSelection == 0) {
        _currentMenu = CENTER_RESET_PAGE;
        centerResetPage();
      } else if (_currentSelection == 1) {
        _currentMenu = MAIN_MENU;
        mainMenu();
      }
      break;
    case MODE_MENU:
      // Operating-mode lock (roadmap item 11, upstream #68): the three mode
      // rows refuse with the short error cue — no confirm page — while the
      // serial API (and so LipSync Connect) can still change the mode
      // deliberately. "... Back" stays live: the first pass gated the whole
      // page and trapped the user inside it (bench 2026-10-16) — a lockout
      // must never strand the person it protects.
      if (_currentSelection < (_modeMenuLen - 1) && g_modeLocked) {
        // Say why, not just beep (bench feedback 2026-10-16): a bare error
        // cue is ambiguous — dead button, generic error, or locked? The
        // locked page names the reason and the unlock path, then returns to
        // the Mode page.
        buzzerErrorCue();
        modeLockedPage();
        break;
      }
      if (_currentSelection < (_modeMenuLen - 1)) {
        // Confirm mode change
        switch (_currentSelection + 1) {
          case _MODE_MOUSE_USB:
            _tempOperatingMode = CONF_OPERATING_MODE_MOUSE;
            _tempCommunicationMode = CONF_COM_MODE_USB;
            break;
          case _MODE_MOUSE_BT:
            _tempOperatingMode = CONF_OPERATING_MODE_MOUSE;
            _tempCommunicationMode = CONF_COM_MODE_BLE;
            break;
          case _MODE_GAMEPAD_USB:
            _tempOperatingMode = CONF_OPERATING_MODE_GAMEPAD;
            _tempCommunicationMode = CONF_COM_MODE_USB;
            break;
        }
        //_tempOperatingMode = _currentSelection;
        if ((_tempOperatingMode != _operatingMode) || (_tempCommunicationMode != _communicationMode)) {
          confirmModeChange();
        }
      } else if (_currentSelection == (_modeMenuLen - 1)) {
        mainMenu();
      }
      break;
    case CONFIRM_MODE_CHANGE:
      // 4.6.6: re-check the mode lock HERE, not only at the Mode-menu row.
      // The gate at the row leaves a TOCTOU hole: a user can be sitting on
      // this confirm page when a caregiver enables LK from the app — the
      // confirming select would then execute the locked mode change (persist
      // + reset), exactly what the lock exists to prevent. Same refusal
      // shape as the Mode-page gate: error cue, named locked page, and the
      // scheduled transition returns to the Mode menu.
      if (g_modeLocked) {
        buzzerErrorCue();
        modeLockedPage();
        break;
      }
      if (_currentSelection == 1) {
        _currentSelection = 0;
        modeMenu();
      } else {
        changeMode();
      }
      break;
    case CURSOR_SP_MENU:
      switch (_currentSelection) {
        case 0:  // Increase
          increaseCursorSpeed(true, false);
          _cursorSpeedLevel = getCursorSpeed(true, false);
          _cursorSpMenuText[0] = "Speed: " + String(_cursorSpeedLevel) + " ";
          _display.setCursor(0, 0);
          _display.print(_cursorSpMenuText[0]);
          flushDisplay();
          break;
        case 1:  // Decrease
          decreaseCursorSpeed(true, false);
          _cursorSpeedLevel = getCursorSpeed(true, false);
          _cursorSpMenuText[0] = "Speed: " + String(_cursorSpeedLevel) + " ";
          _display.setCursor(0, 0);
          _display.print(_cursorSpMenuText[0]);
          flushDisplay();
          break;
        case 2:  // Back
          _currentMenu = MAIN_MENU;
          mainMenu();
          break;
      }
      break;
    case MORE_MENU:
      _prevMenu = MORE_MENU;

      switch(_currentSelection) {
        case 0: // Sound
          soundMenu();
          break;
        case 1:
          lightBrightMenu();
          break;
        case 2:
          scrollSpeedMenu();
          break;
        case 3: // Sip puff
          sipPuffThreshMenu();
          break;
        case 4: // Full Calibration
          fullCalibrationConfirmPage();
          break;
        case 5: // Restart
          restartConfirmPage();
          break;
        case 6: // Factory Reset
          factoryResetConfirm1Page();
          break;
        case 7: // Info
          infoMenu();
          break;
        case 8: // Acceleration (roadmap item 9, upstream #86)
          accelMenu();
          break;
        case 9: // Restrictions (roadmap item 11)
          restrictionsMenu();
          break;
        case 10: // Bluetooth hosts (upstream #16, 4.8.0)
          btHostsMenu();
          break;
        case 11: // Back
          mainMenu();
          break;
      }
      break;

    case BT_HOSTS_MENU: {
      // Upstream #16: hosts (≤4) + "Pair new..." + "Forget host..." + Back —
      // the layout btHostsMenu() rendered. Rows re-validated at EXECUTION time
      // by lsHostExecuteSwitch/Forget (the TOCTOU gate), so a stale index can
      // only ever refuse, never hit the wrong host.
      const int hostRows = (_btHostCount < LSHOST_MENU_MAX_ROWS) ? _btHostCount : LSHOST_MENU_MAX_ROWS;
      const bool hasForget = (_btHostCount > 0);
      if (_currentSelection < hostRows) {
        _btTargetRow = _currentSelection + 1;
        btSwitchConfirmPage();
      } else if (_currentSelection == hostRows) {
        // Pair new: refuse while a host is connected (a new pairing needs
        // advertising), otherwise make sure advertising is running.
        // (4.9.0 review) the serial BT,3 refuses a calibration/center flow
        // ("a pairing completing mid-calibration is exactly the event churn
        // those flows refuse to allow") — the menu branch now carries the
        // same gate. Verified hole: a serial IN,1:1/CA,1:1 landing while the
        // Hub sat here ran lsHostEnsureAdvertising mid-flow, and the note
        // page's 2 s transition repainted the host list OVER the calibration
        // prompt 50 ms after step 1 drew it.
        if (!lsBleStackReady()) {
          buzzerErrorCue();
          btNotePage("Bluetooth", "not active");
        } else if (g_calibrationRunning || g_centerRunning) {
          buzzerErrorCue();
          btNotePage("Busy: calib.", "in progress");
        } else if (lsHostAnyConnected()) {
          buzzerErrorCue();
          btNotePage("Disconnect", "host first");
        } else if (lsHostSwitchWindowOpen()) {
          // (4.9.0 round-2 review) the serial BT,3 refuses an open window —
          // the Hub branch must too: the bouncer would drop every peer this
          // note exists to admit, and lsHostEnsureAdvertising during the
          // window's inter-arm gap could silently replace the directed set
          // (which the tick then skips re-arming because isRunning holds).
          buzzerErrorCue();
          btNotePage("Switching", "wait");
        } else if (!lsHostEnsureAdvertising()) {
          // (4.9.0 review) the honest-ack rule: start() can refuse in the
          // post-disconnect SD-teardown window — never a success-shaped note
          // with nothing on air.
          buzzerErrorCue();
          btNotePage("Radio busy", "try again");
        } else {
          btNotePage("Pairing:", "pair from", "the host");
        }
      } else if (hasForget && _currentSelection == hostRows + 1) {
        btForgetListPage();
      } else if (_currentSelection == (hasForget ? hostRows + 2 : hostRows + 1)) {
        _currentMenu = MORE_MENU;
        moreMenu();
      }
      break;
    }

    case BT_SWITCH_CONFIRM_PAGE:
      if (_currentSelection == 0) {
        // The switch itself runs at the END of the "Switching to..." dwell —
        // the CHANGING_MODE_PAGE pattern (dwell, then the action executes on
        // the screen timer). finishBtSwitch re-validates everything.
        btSwitchingPage();
      } else {
        btHostsMenu();
      }
      break;

    case BT_FORGET_LIST_PAGE:
      if (_currentSelection < _btForgetHostRows) {
        const int decision = lsHostExecuteForget(_currentSelection + 1,
                                                 _btForgetRowMacs[_currentSelection].c_str());
        if (decision == LSHOST_ALLOW) {
          lsHostPushState(true);  // the list changed — the app's mirror follows (BT,4/BT,5); forced — see the BT,2 handler
          btHostsMenu();      // refresh from the shrunken bond directory
        } else if (decision == LSHOST_REFUSE_RANGE) {
          btHostsMenu();      // the list moved under us — redraw it, no error drama
        } else {
          buzzerErrorCue();
          btNoteForReason(decision);
        }
      } else {
        btHostsMenu();
      }
      break;

    case SOUND_MENU:
      switch (_currentSelection) {
        case 0:  // Toggle sound on/off (the All tier remains selectable through Connect)
          _soundMode = getSoundMode(false, false);
          _soundMode = (_soundMode == CONF_SOUND_MODE_OFF) ? CONF_SOUND_MODE_BASIC : CONF_SOUND_MODE_OFF;
          setSoundMode(true, false, _soundMode);
          _soundMode = getSoundMode(false, false);  // Keep the label truthful if persistence refused
          soundMenu();
          break;
        case 1:  // Back
          _currentMenu = MORE_MENU;
          moreMenu();
      }
      break;

    case LIGHT_BRIGHT_MENU:
      switch (_currentSelection) {
        case 0:  // Increase
          _lightBrightLevel = getLightBrightnessLevel(false, false);
          _lightBrightLevel++;
          setLightBrightnessLevel(true, false, _lightBrightLevel);
          _lightBrightLevel = getLightBrightnessLevel(false, false);
          _lightBrightMenuText[0] = "Lights: " + String(_lightBrightLevel) + " ";
          _display.setCursor(0, 0);
          _display.print(_lightBrightMenuText[0]);
          flushDisplay();
          break;
        case 1:  // Decrease
          _lightBrightLevel = getLightBrightnessLevel(false, false);
          _lightBrightLevel--;
          setLightBrightnessLevel(true, false, _lightBrightLevel);
          _lightBrightLevel = getLightBrightnessLevel(false, false);
          _lightBrightMenuText[0] = "Lights: " + String(_lightBrightLevel) + " ";
          _display.setCursor(0, 0);
          _display.print(_lightBrightMenuText[0]);
          flushDisplay();
          break;
        case 2:  // Back
          _currentMenu = MORE_MENU;
          moreMenu();
          break;
      }

      break;

    case SCROLL_SP_MENU:
      switch (_currentSelection) {
        case 0:  // Increase
          _scrollSpeedLevel = getScrollLevel(false, false);
          _scrollSpeedLevel++;
          setScrollLevel(true, false, _scrollSpeedLevel);
          _scrollSpeedLevel = getScrollLevel(false, false);
          _scrollSpMenuText[0] = "Speed: " + String(_scrollSpeedLevel) + " ";
          _display.setCursor(0, 0);
          _display.print(_scrollSpMenuText[0]);
          flushDisplay();
          break;
        case 1:  // Decrease
          _scrollSpeedLevel = getScrollLevel(false, false);
          _scrollSpeedLevel--;
          setScrollLevel(true, false, _scrollSpeedLevel);
          _scrollSpeedLevel = getScrollLevel(false, false);
          _scrollSpMenuText[0] = "Speed: " + String(_scrollSpeedLevel) + " ";
          _display.setCursor(0, 0);
          _display.print(_scrollSpMenuText[0]);
          flushDisplay();
          break;
        case 2:  // Back
          _currentMenu = MORE_MENU;
          moreMenu();
          break;
      }

      break;

    case SIP_PUFF_MENU:
      switch (_currentSelection) {
        case 0:  // Sip
          adjustSipThreshMenu();
          break;
        case 1:  // Puff
          adjustPuffThreshMenu();
          break;
        case 2:  // Timing (roadmap item 15, upstream #62)
          timingMenu();
          break;
        case 3:  // Hard Sip (upstream #58, 4.7.0)
          adjustHardSipThreshMenu();
          break;
        case 4:  // Hard Puff
          adjustHardPuffThreshMenu();
          break;
        case 5:
          _currentMenu = MORE_MENU;
          moreMenu();
          break;
      }
      break;

    case ACCEL_MENU:
      // Cursor acceleration level (roadmap item 9): -10 (slowest/most
      // precise) .. 10 (fastest); 0 is the linear default. The API set
      // clamps out-of-range steps, and the re-read keeps the label truthful.
      switch (_currentSelection) {
        case 0: {  // Increase
          _accelLevel = getJoystickAcceleration(false, false);
          _accelLevel++;
          setJoystickAcceleration(true, false, _accelLevel);
          _accelLevel = getJoystickAcceleration(false, false);
          _accelMenuText[0] = "Accel: " + String(_accelLevel) + " ";
          _display.setCursor(0, 0);
          _display.print(_accelMenuText[0]);
          flushDisplay();
          break;
        }
        case 1: {  // Decrease
          _accelLevel = getJoystickAcceleration(false, false);
          _accelLevel--;
          setJoystickAcceleration(true, false, _accelLevel);
          _accelLevel = getJoystickAcceleration(false, false);
          _accelMenuText[0] = "Accel: " + String(_accelLevel) + " ";
          _display.setCursor(0, 0);
          _display.print(_accelMenuText[0]);
          flushDisplay();
          break;
        }
        case 2:  // Back
          _currentMenu = MORE_MENU;
          moreMenu();
          break;
      }
      break;

    case RESTRICTIONS_MENU:
      // Input restrictions (roadmap item 11): each line toggles one
      // restriction and re-renders its state label. The re-read keeps the
      // label truthful even when the setter clamps or the stored value
      // changed underneath us.
      switch (_currentSelection) {
        case 0: {  // Sip & puff enable
          int sapDisabled = getSapDisabled(false, false);
          setSapDisabled(true, false, sapDisabled == 1 ? 0 : 1);
          restrictionsMenu();
          break;
        }
        case 1: {  // Menu access: all inputs / hub buttons only
          int buttonsOnly = getMenuButtonsOnly(false, false);
          setMenuButtonsOnly(true, false, buttonsOnly == 1 ? 0 : 1);
          restrictionsMenu();
          break;
        }
        case 2: {  // Operating-mode lock
          int modeLocked = getModeLocked(false, false);
          setModeLocked(true, false, modeLocked == 1 ? 0 : 1);
          restrictionsMenu();
          break;
        }
        case 3: {  // Cursor hold during sip & puff
          int cursorHold = getCursorHoldDuringSap(false, false);
          setCursorHoldDuringSap(true, false, cursorHold == 1 ? 0 : 1);
          restrictionsMenu();
          break;
        }
        case 4:  // Back
          _currentMenu = MORE_MENU;
          moreMenu();
          break;
      }
      break;

    case SIP_THRESH_MENU:
      // The Hub menu steps through the coarse 10-level threshold scale
      // (roadmap item 15, upstream #22) instead of ±1 hPa — the fine hPa
      // granularity stays on the serial API and in LipSync Connect.
      switch (_currentSelection) {
        case 0: {  // Increase
          _sipPressThresh = getSipPressureThreshold(false, false);
          setSipPressureThreshold(true, false, pressThresholdLevelUp(_sipPressThresh));
          _sipPressThresh = getSipPressureThreshold(false, false);
          healHardThresholds();  // a raised sip floor may strand the hard pair
          _adjustSipThreshMenuText[0] =
            "Sip: L" + String(pressThresholdLevelFor(_sipPressThresh)) + " " + String(_sipPressThresh) + " ";
          _display.setCursor(0, 0);
          _display.print(_adjustSipThreshMenuText[0]);
          flushDisplay();
          break;
        }
        case 1: {  // Decrease
          _sipPressThresh = getSipPressureThreshold(false, false);
          setSipPressureThreshold(true, false, pressThresholdLevelDown(_sipPressThresh));
          _sipPressThresh = getSipPressureThreshold(false, false);
          healHardThresholds();  // (a fall can only help, but keep one code path)
          _adjustSipThreshMenuText[0] =
            "Sip: L" + String(pressThresholdLevelFor(_sipPressThresh)) + " " + String(_sipPressThresh) + " ";
          _display.setCursor(0, 0);
          _display.print(_adjustSipThreshMenuText[0]);
          flushDisplay();
          break;
        }
        case 2:  // Back
          _currentMenu = SIP_PUFF_MENU;
          sipPuffThreshMenu();
          break;
      }
      break;

    case PUFF_THRESH_MENU:
      // Level scale, same as the sip page (roadmap item 15, upstream #22).
      switch (_currentSelection) {
        case 0: {  // Increase
          _puffPressThresh = getPuffPressureThreshold(false, false);
          setPuffPressureThreshold(true, false, pressThresholdLevelUp(_puffPressThresh));
          _puffPressThresh = getPuffPressureThreshold(false, false);
          healHardThresholds();  // a raised puff floor may strand the hard pair
          _adjustPuffThreshMenuText[0] =
            "Puff: L" + String(pressThresholdLevelFor(_puffPressThresh)) + " " + String(_puffPressThresh) + " ";
          _display.setCursor(0, 0);
          _display.print(_adjustPuffThreshMenuText[0]);
          flushDisplay();
          break;
        }
        case 1: {  // Decrease
          _puffPressThresh = getPuffPressureThreshold(false, false);
          setPuffPressureThreshold(true, false, pressThresholdLevelDown(_puffPressThresh));
          _puffPressThresh = getPuffPressureThreshold(false, false);
          healHardThresholds();  // (a fall can only help, but keep one code path)
          _adjustPuffThreshMenuText[0] =
            "Puff: L" + String(pressThresholdLevelFor(_puffPressThresh)) + " " + String(_puffPressThresh) + " ";
          _display.setCursor(0, 0);
          _display.print(_adjustPuffThreshMenuText[0]);
          flushDisplay();
          break;
        }
        case 2:  // Back
          _currentMenu = SIP_PUFF_MENU;
          sipPuffThreshMenu();
          break;
      }
      break;

    case HARD_SIP_THRESH_MENU:
      // Hard sip threshold (upstream #58, 4.7.0): the same coarse level
      // scale, but a step can never land below regular + margin — the
      // setter would refuse the write, so Decrease clamps to the floor
      // instead of stalling silently and the band always stays reachable.
      switch (_currentSelection) {
        case 0: {  // Increase
          _hardSipPressThresh = getHardSipPressureThreshold(false, false);
          float sipFloorUp = getSipPressureThreshold(false, false) + CONF_PRESS_HARD_MARGIN_HPA;
          float sipNextUp = pressThresholdLevelUp(_hardSipPressThresh);
          if (sipNextUp < sipFloorUp) sipNextUp = sipFloorUp;
          setHardSipPressureThreshold(true, false, sipNextUp);
          _hardSipPressThresh = getHardSipPressureThreshold(false, false);
          _adjustHardSipThreshMenuText[0] =
            "Hard Sip: L" + String(pressThresholdLevelFor(_hardSipPressThresh)) + " " + String(_hardSipPressThresh) + " ";
          _display.setCursor(0, 0);
          _display.print(_adjustHardSipThreshMenuText[0]);
          flushDisplay();
          break;
        }
        case 1: {  // Decrease
          _hardSipPressThresh = getHardSipPressureThreshold(false, false);
          float sipFloorDown = getSipPressureThreshold(false, false) + CONF_PRESS_HARD_MARGIN_HPA;
          float sipNextDown = pressThresholdLevelDown(_hardSipPressThresh);
          if (sipNextDown < sipFloorDown) sipNextDown = sipFloorDown;  // clamp at the margin floor
          setHardSipPressureThreshold(true, false, sipNextDown);
          _hardSipPressThresh = getHardSipPressureThreshold(false, false);
          _adjustHardSipThreshMenuText[0] =
            "Hard Sip: L" + String(pressThresholdLevelFor(_hardSipPressThresh)) + " " + String(_hardSipPressThresh) + " ";
          _display.setCursor(0, 0);
          _display.print(_adjustHardSipThreshMenuText[0]);
          flushDisplay();
          break;
        }
        case 2:  // Back
          _currentMenu = SIP_PUFF_MENU;
          sipPuffThreshMenu();
          break;
      }
      break;

    case HARD_PUFF_THRESH_MENU:
      // Hard puff threshold: mirror of the hard sip page (upstream #58).
      switch (_currentSelection) {
        case 0: {  // Increase
          _hardPuffPressThresh = getHardPuffPressureThreshold(false, false);
          float puffFloorUp = getPuffPressureThreshold(false, false) + CONF_PRESS_HARD_MARGIN_HPA;
          float puffNextUp = pressThresholdLevelUp(_hardPuffPressThresh);
          if (puffNextUp < puffFloorUp) puffNextUp = puffFloorUp;
          setHardPuffPressureThreshold(true, false, puffNextUp);
          _hardPuffPressThresh = getHardPuffPressureThreshold(false, false);
          _adjustHardPuffThreshMenuText[0] =
            "Hard Puff: L" + String(pressThresholdLevelFor(_hardPuffPressThresh)) + " " + String(_hardPuffPressThresh) + " ";
          _display.setCursor(0, 0);
          _display.print(_adjustHardPuffThreshMenuText[0]);
          flushDisplay();
          break;
        }
        case 1: {  // Decrease
          _hardPuffPressThresh = getHardPuffPressureThreshold(false, false);
          float puffFloorDown = getPuffPressureThreshold(false, false) + CONF_PRESS_HARD_MARGIN_HPA;
          float puffNextDown = pressThresholdLevelDown(_hardPuffPressThresh);
          if (puffNextDown < puffFloorDown) puffNextDown = puffFloorDown;  // clamp at the margin floor
          setHardPuffPressureThreshold(true, false, puffNextDown);
          _hardPuffPressThresh = getHardPuffPressureThreshold(false, false);
          _adjustHardPuffThreshMenuText[0] =
            "Hard Puff: L" + String(pressThresholdLevelFor(_hardPuffPressThresh)) + " " + String(_hardPuffPressThresh) + " ";
          _display.setCursor(0, 0);
          _display.print(_adjustHardPuffThreshMenuText[0]);
          flushDisplay();
          break;
        }
        case 2:  // Back
          _currentMenu = SIP_PUFF_MENU;
          sipPuffThreshMenu();
          break;
      }
      break;

    case TIMING_MENU:
      // Input timing windows (roadmap item 15, upstream #62): one page per
      // boundary; selecting a line opens its adjust page.
      switch (_currentSelection) {
        case 0:  // Short window (WS)
        case 1:  // Long window (WL)
        case 2:  // Max window (WM)
          _timingWindowSel = _currentSelection;
          adjustTimingMenu();
          break;
        case 3:  // Back
          _currentMenu = SIP_PUFF_MENU;
          sipPuffThreshMenu();
          break;
      }
      break;

    case TIMING_ADJUST_MENU: {
      // 250 ms steps; the API setter clamps range and keeps short < long <
      // max ordering, and the re-read keeps the label truthful.
      if (_currentSelection == 2) {  // Back
        _currentMenu = TIMING_MENU;
        timingMenu();
        break;
      }
      const int stepMs = 250;
      int currentMs = 0;
      switch (_timingWindowSel) {
        case 0: {
          currentMs = getInputWindowShort(false, false);
          int nextMs = (_currentSelection == 0) ? currentMs + stepMs : currentMs - stepMs;
          setInputWindowShort(true, false, (unsigned long)nextMs);
          currentMs = getInputWindowShort(false, false);
          break;
        }
        case 1: {
          currentMs = getInputWindowLong(false, false);
          int nextMs = (_currentSelection == 0) ? currentMs + stepMs : currentMs - stepMs;
          setInputWindowLong(true, false, (unsigned long)nextMs);
          currentMs = getInputWindowLong(false, false);
          break;
        }
        default: {
          currentMs = getInputWindowMax(false, false);
          int nextMs = (_currentSelection == 0) ? currentMs + stepMs : currentMs - stepMs;
          setInputWindowMax(true, false, (unsigned long)nextMs);
          currentMs = getInputWindowMax(false, false);
          break;
        }
      }
      _timingAdjustMenuText[0] = String(_timingWindowSel == 0 ? "Short: " : _timingWindowSel == 1 ? "Long: " : "Max: ") + String(currentMs) + "ms ";
      _display.setCursor(0, 0);
      _display.print(_timingAdjustMenuText[0]);
      flushDisplay();
      break;
    }

    case FULL_CALIB_CONFIRM_PAGE:
      switch (_currentSelection) {
        case 0:  // Perform full calibration
          _currentMenu = FULL_CALIB_PAGE;
          fullCalibrationPage();
          break;
        case 1:  // Back
          _currentMenu = MORE_MENU;
          moreMenu();
          break;
      }
      break;

    case RESTART_PAGE:
      switch (_currentSelection) {
        case 0:  // Perform restart
          softwareReset(); // Call a software reset
          break;
        case 1:  // Back
          // (4.9.0 review) the SAFEMODE arm is live here (the safe menu's
          // Restart goes through this same confirm page) — only the
          // unreachable else/commented-out remnant was removed. The fallback
          // for any future third _prevMenu is safeModeMenu() (the safe
          // menu's Restart is the only non-MORE-MENU source today); revisit
          // this if a third source ever appears.
          if (_prevMenu == MORE_MENU) {
            moreMenu();
            break;
          }
          safeModeMenu();
          break;
      }
      break;
    case FACTORY_RESET_PAGE:
      switch (_currentSelection) {
        case 0:  // Perform factory reset
          _currentMenu = FACTORY_RESET_CONFIRM2_PAGE;
          factoryResetConfirm2Page();
          break;
        case 1:  // Back
          // (4.9.0 review) the SAFEMODE arm here is unreachable: this page
          // is registered only from MORE_MENU (case 6); safe mode goes
          // straight to FACTORY_RESET_CONFIRM2_PAGE, whose own Back does
          // handle SAFEMODE. Any future third _prevMenu now falls through
          // to moreMenu() instead of silently no-op'ing.
          moreMenu();
          break;
      }
      break;
    case FACTORY_RESET_CONFIRM2_PAGE:
      switch (_currentSelection) {
        case 0:  // Perform factory reset
          factoryResetPage();
          doFactoryReset(false, false);
          break;
        case 1:  // Back
          if(_prevMenu == MORE_MENU) {
            moreMenu();
          }
          else if (_prevMenu == SAFEMODE_MENU ) {
            safeModeMenu();
          } 
          break;
      }
      break;
    case INFO_MENU:
      switch(_currentSelection) {
        case 0: // Back
          _currentMenu = MORE_MENU;
          moreMenu();

          break;
      }
      break;
    case SAFEMODE_MENU:
      _prevMenu = SAFEMODE_MENU;
      switch(_currentSelection) {
        case 0: // Restart
          // Confirm first (bench 2026-10-23): this row reset the device the
          // INSTANT any select landed on it — the safe menu's default row
          // was a hair trigger (a real select press on this row showed as a
          // mystery rst=0x4 "idle" reset with no wire trace, because the
          // reset fires inside the select, before any CH,5 push prints).
          // The normal menu's Restart goes through the confirm page; the
          // safe menu's does too now — same RESTART_PAGE confirm, and its
          // "... Back" row already returns to the safe menu.
          restartConfirmPage();
          break;
        case 1: 
          factoryResetConfirm2Page();
          break;
      }
  } // switch (_currentMenu)
} // selectMenuItem


//****************************************//
// Menu displaying functions
//****************************************//


//*********************************//
// Function   : setupDisplay
//
// Description: Clears the display, sets text size and color
//
// Arguments :  void
//
// Return     : void
//*********************************//
void LSScreen::setupDisplay() {
  if (!_begun) return;
  _display.clearDisplay();
  _scrollOn = false;

  _display.setTextSize(2);                              // 2x scale text
  _display.setTextColor(SSD1306_WHITE, SSD1306_BLACK);  // Draw white text on solid black background

  _display.setCursor(0, 0);
}


//*********************************//
// Function   : displayMenu
//
// Description: Prints each item in current menu
//
// Arguments :  void
//
// Return     : void
//*********************************//
void LSScreen::displayMenu() {
  if (!_begun || _currentMenuText == nullptr) return;
  setupDisplay();

  const int textLength = _cursorStart + _currentMenuLength;
  for (int i = 0; i < TEXT_ROWS; i++) {
    int textIndex = (i >= _cursorStart) ? (i + _countMenuScroll) : i;
    if (textIndex < 0 || textIndex >= textLength) break;
    if (i >= _cursorStart) {
      _display.print(" "), _display.println(_currentMenuText[textIndex]);
    } else {
      _display.println(_currentMenuText[textIndex]);
    }
  }

  if (_currentMenu == MODE_MENU) {
    modeMenuHighlight();
  }

  flushDisplay();

  //_currentSelection = 0;
  displayCursor();
}


//*********************************//
// Function   : displayCursor
//
// Description: Displays the selection cursor next to selected menu item
//
// Arguments :  void
//
// Return     : void
//*********************************//
void LSScreen::displayCursor() {
  if (!_begun) return;

  if (_currentSelection + _cursorStart > TEXT_ROWS - 1) {
    _cursorPos = TEXT_ROWS - 1;
  } else {
    _cursorPos = _currentSelection + _cursorStart;
  }

  _display.setTextSize(2);                              // 2x scale text
  _display.setTextColor(SSD1306_WHITE, SSD1306_BLACK);  // Draw white text on solid black background

  // Show cursor on text line of selection index, erase previous cursor
  //_display.setCursor(0, 16 * _cursorStart);           // Start at the line where the cursor should start 
  _display.setCursor(0, 0);           // Start at position 0,0
  for (int i = 0; i < TEXT_ROWS; i++) {
    if (i == _cursorPos) {
      _display.println(">");
    } else if (i < _cursorStart){
      _display.println("");
    } else {
      _display.println(" ");
    }
  }

  flushDisplay();

  _selectedLine = _cursorStart + _currentSelection;
  if (_currentMenuText == nullptr || _selectedLine < 0 || _selectedLine >= (_cursorStart + _currentMenuLength)) {
    _selectedText = "";
  } else {
    _selectedText = _currentMenuText[_selectedLine];
  }

  if (_selectedText.length() > (_maxCharPerLine - 1)) {
    //Serial.println("Long text");
    _scrollOn = true;
    _scrollPos = 12;
    scheduleTransition(200, screenScrollTransitionDone);  // was delay(200); scrollLongText() — fires once, 200 ms from now
  } else {
    _scrollOn = false;
  }
}


//*********************************//
// Function   : scrollLongText
//
// Description: Format and Display Long Menu Items by scrolling
//
// Arguments :  void
//
// Return     : void
//*********************************//
void LSScreen::scrollLongText() {
  if (!_begun) return;
  int minPos = -CHAR_PIXEL_WIDTH_S2 * _selectedText.length();

  _display.setTextSize(2);                              // 2x scale text
  _display.setTextColor(SSD1306_WHITE, SSD1306_BLACK);  // Draw white text on solid black background
  _display.setTextWrap(false);

  if (millis() - _scrollDelayTimer >= SCROLL_DELAY_MILLIS) {
    _scrollDelayTimer = millis();

    // Clear previous text by writing over it with blank text
    _display.setCursor(0, _cursorPos * CHAR_PIXEL_HEIGHT_S2);
    _display.print("                                   ");

    // Display text in new position to simulate scrolling
    _display.setCursor(_scrollPos, _cursorPos * CHAR_PIXEL_HEIGHT_S2);
    _display.print(_selectedText);

    _display.setCursor(0, _cursorPos * CHAR_PIXEL_HEIGHT_S2);
    _display.print(">");
    flushDisplay();

    _scrollPos = _scrollPos - scrollPixelsPerLoop;
    
    if (_scrollPos < minPos) {
      _scrollPos = _display.width();
    }
  }
}

//*********************************//
// Function   : drawCentreString
//
// Description: Format and Display Main Menu
//
// Arguments :  void
//
// Return     : void
//*********************************//
void LSScreen::drawCentreString(const String &buf, int y) {
  if (!_begun) return;
  int16_t x1, y1;
  uint16_t w, h;
  int x = 64;
  _display.getTextBounds(buf, x, y, &x1, &y1, &w, &h);  // Calculate width of new string
  _display.setCursor(x - w / 2, y);
  _display.print(buf);
}

//********** MENUS **********//

//*********************************//
// Function   : mainMenu
//
// Description: Format and Display Main Menu
//
// Arguments :  void
//
// Return     : void
//*********************************//
void LSScreen::mainMenu(void) {
  _currentMenu = MAIN_MENU;

  //if new menu selection
  //if (_prevMenu != _currentMenu) {
  _currentMenuLength = _mainMenuLen;
  _currentMenuText = _mainMenuText;
  _cursorStart = 0;
  _currentSelection = 0;
  _countMenuScroll = 0;

  displayMenu();  //  Print items in current menu
  //}
}

//*********************************//
// Function   : exitConfirmMenu
//
// Description: Format and Exit Confirm Menu
//
// Arguments :  void
//
// Return     : void
//*********************************//
void LSScreen::exitConfirmMenu() {
  _prevMenu = _currentMenu;
  _currentMenu = EXIT_MENU;
  _currentMenuText = _exitConfirmText;
  _currentMenuLength = 2;
  _cursorStart = 2;
  _currentSelection = 0;
  _countMenuScroll = 0;
  displayMenu();  //  Print items in current menu
}
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
