goforwest/LipSync/(commit log)

2026-10-09 Fix Linux build: include WString.h (String.h only resolves on case-insensitive filesystems)
    [LipSync_Firmware.ino]
2026-10-11 CI: pin uf2 tools to the vendored revision; tag-stamp the manifest; guard the binaries-branch push against out-of-order releases
    - uf2conv.py + uf2families.json fetched from the exact microsoft/uf2
    revision the local twin vendored byte-identical (90e9741) — master is
    a moving target and the local build instructions promise reproducibility.
    - firmware-manifest.json now carries the ref it was built from, so a
    stale firmware-binaries branch is diagnosable from the artifact.
    - The firmware-binaries force-push refuses to clobber a branch holding a
    NEWER firmwareVersion than the build being published — two
    near-simultaneous tags can otherwise finish out of order and silently
    regres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
2026-10-12 CI: fix the race-guard workflow YAML — a multiline python literal ended the run block at column 1
    The hardened guard's shape-checking python was a multiline single-quoted
    string whose continuation lines start at column 1 — that ends the run: |
    block scalar and invalidates the whole workflow file (every run failed in
    0 s on GitHub with 'workflow file issue'; a local stub harness validated
    the bash but never the YAML wrapper). The check is now a single line:
    print the parsed version, exit 1 for a non-empty value that is not a
    plain dotted number; empty still exits 0 so the dedicated empty-version
    branch keeps its own message. YAML parse + all eight stub cases pass.
2026-10-13 Firmware: frame serial settings API messages on a 50 ms idle timeout — readString()'s 1000 ms Stream default padded every host message to a full second (~2 s per command, ~30 s settings load in LipSy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
2026-10-13 Firmware 4.2.0: non-blocking settings framing + always-armed watchdog + sensor-health pressure path — newline-terminated messages frame instantly (bare legacy hosts keep the 50 ms idle gap), the watc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
2026-10-13 Firmware 4.2.0 hardening: bounded I2C + non-blocking pages — vendored Wire library bounds every nRF52 TWIM wait at 50 ms and recovers a wedged bus in place (bounded STOP + NXP 9-clock clear), and the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
2026-10-14 Firmware 4.2.0: flaky-I2C-bus self-defense — a failing device on the shared bus can wedge it (Wire already bounds + recovers) or drag transfers until they crawl with no timeout ever firing, which rea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
2026-10-14 Firmware 4.3.0: cursor acceleration, the BH bus-health endpoint, and the UM update-mode entry — the stored AV level (-10..10, default 0) now bends the deflection-to-speed curve in the mouse output pa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
2026-10-14 Firmware 4.3.0 hardware-session fixes: AV,1 writes were rejected with FAIL,3 before the function ever ran — the API dispatch table's set entry declared parameter "0" (a v4.0-era stub typo; every othe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
2026-10-14 Serial settings dump: EX,0:0 replays every stored setting as its standard endpoint response (roadmap item 13's serial half, upstream #67) — a maker or support tech with a serial monitor sends SETTING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
2026-10-14 Bound the USB-HID report paths — the post-flash 'first writes dropped' root cause (firmware-update item 2): the mouse and gamepad report paths spun while(!isReady()) delay(1) for up to 5 s from the m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
2026-10-14 Firmware 4.4.0: input & mode restrictions — one coherent settings family (roadmap item 11; upstream #21 #44 #68 #77). Four boolean settings, every one defaulting to the unrestricted legacy behavior s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
2026-10-15 Rename the timing-window endpoints W1/W2/W3 → WS/WL/WM before 4.4.0 ships: LipSync Connect's response grammar matches endpoints as 1-4 letters then a comma (SUCCESS,0:WS,0:750), so a digit in the end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
2026-10-15 Input-state LED feedback as an opt-in light-mode tier (roadmap item 16's LED half, upstream #43): LM=3 keys the LEDs to the input's window instead of the pending action — while any input is held the 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
2026-10-15 Vendor the TLV493D library as a bounded fork (roadmap item 1, upstream #37): the joystick's hall-effect sensor library moves from a zip in Libraries/ (unpacked ad hoc into a CI user-library dir, with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
2026-10-15 Trim the vendored TLV493D fork to what the build consumes: src/, the fork README, LICENSE, keywords and library.properties — upstream's demo sketches, Processing visualizers and 3D-printable CAD file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
2026-10-15 User Guide documentation pass (upstream #82 #33 #71 #72 #76 #87): the ERROR-008 through ERROR-014 rows of the error-code table now match what the firmware actually displays — the code is a bitfield (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
2026-10-15 Maker Guide documentation pass (upstream #64 #79 #56 #78 #65): the maker error table's ERROR-008..014 rows carried the same component-bullet shift as the User Guide — both now match the firmware's bi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
2026-10-15 Firmware 4.5.0: external switch action remapping (upstream #20 — roadmap item 11's deliberately separate follow-up). The clinician's ask was remappability itself — switches mapped to functions DIFFER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
2026-10-15 Fix the serial format validator's missing 5-digit parameter shape (found by the fresh-eye round hardening LipSync Connect's cross-repo protocol checker): isValidCommandFormat whitelisted total line l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
2026-10-16 Cap the USB-retry backoff at 10 s (bench-observed 2026-10-15, post-flash): the ×1.2 growth ran to 120 s to space an EXPENSIVE tick — the old retry branch re-ran begin() and redrew the full framebuffe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
2026-10-16 Fix the stranded No-USB page (bench 2026-10-16, reproduced twice): the healthy branch of usbCheckConnection is one-shot — it never re-arms — and resetUsbErrorPage cleared the episode latch unconditio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
2026-10-16 HID diagnostics for the cursor-dead-on-4.5.0 hunt (bench 2026-10-16, critical): the mouse works perfectly on 4.1.0 and does not move on 4.5.0 — same Mac, same cable — so the regression is ours, in th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
2026-10-16 Report-content telemetry for the cursor-dead hunt, round 2: BH,0:0 grows to 15 values with nonzeroReports (reports that actually carried x/y movement) and maxAbsReport (largest |x|/|y| ever sent). Th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
2026-10-16 Pipeline-internals dump for the cursor-dead hunt, round 3 (bench 2026-10-16): the corner-hold JV read settled it that the input/output pipeline is frozen at boot zeros — raw at full corner deflection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
2026-10-16 THE cursor-dead root cause, found and fixed (bench 2026-10-16, three telemetry rounds): the magnet direction latch. The output math is (raw - center) * direction, and the directions are derived as -1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
2026-10-16 Persistence-latch the HID error episode (bench 2026-10-16, follow-up to the cursor fix): the user's confirming session — dirX/dirY at ±1, nonzeroReports and maxAbsReport climbing, JV in/out live, cur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
2026-10-16 The mode lock must never trap the user inside the Mode page (bench 2026-10-16, Part B3): the lock's first pass refused the WHOLE MODE_MENU case — with LK on, a user who opened the Hub's Mode options 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
2026-10-16 The mode lock names its reason instead of just beeping (bench feedback 2026-10-16): a refused mode selection answered with only an error cue, which reads as a dead button or a generic failure — the u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
2026-10-16 Close the boot-time CDC-only enumeration race (bench 2026-10-16, root cause of the post-flash stuck No-USB page): the 4.1.0-to-4.5.0 flash path left the host actively hunting for the port, and the ho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
2026-10-16 Self-healing re-enumeration for the configured-but-HID-dead boot (bench 2026-10-16, second stuck-boot capture): the detach-until-descriptor-complete boot order (184eebc) was flashed and verified by p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
2026-10-18 One automatic USB-recovery restart when the re-enumeration budget is spent (bench 2026-10-17, third stuck-boot capture): the E7 round trip produced a 4.1.0->4.5.0 boot that came up configured-but-HID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
2026-10-18 Degraded-state heartbeat witness for the boot-with-unseated-cable reset loop (bench 2026-10-18, checklist Part F's boot case): booting 4.5.0 with the interface cable unseated reset the device at an e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
2026-10-18 Feed the hardware watchdog from the live loop, not the timer pool (bench 2026-10-18, the unbreakable safe-mode reset cycle, root cause): the heartbeat witness decided it - in a safe-mode boot the HB 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
2026-10-18 Regenerate the four guide PDFs from the final 4.5.0 .docx passes: User Guide, Maker Guide, Quickstart Guide, and Firmware Update Guide exported from Documentation/Working_Documents via LibreOffice (h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
2026-10-18 Gamepad-mode BH telemetry: report the gamepad's HID interface, not the mouse's (bench 2026-10-18, gamepad validation follow-up): fillUsbHidDiagnostics() read usbmouse's counters unconditionally, so i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
2026-10-18 Enforce a settings-file size budget: the 4.1.0 downgrade cliff finally has a guard (bench follow-up 2026-10-18): the serialized settings file sat at ~383 B through 4.4.x, and firmware 4.1.0 — the old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
2026-10-18 LSTimer pool hygiene: five concrete defects fixed, every failure made loud or silent as appropriate, and a host-side harness that finally attempts the safe-mode interval death in isolation (bench 202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
2026-10-18 Hub remote menu-state read (CH,0:0, firmware 4.5.1): the read half of remote Hub-menu control. The app's remote sends relative presses (CH,1:1/2/3/4) and models the Hub's menu position client-side, b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
2026-10-18 XENSIV TLx493D migration, part 1: vendor the successor library and port LSJoystick (upstream #37 — NOT FOR MERGE until the bench protocol passes; see LipSync_Connect docs/xensiv-migration-bench-proto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
2026-10-19 4.5.2: the unsolicited center-reset ack finally tells the truth (bench 2026-10-18 follow-up to the release validation): the joystick center flow always ended by printing a line, but the completion ha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
2026-10-19 4.5.3: the LM=3 input-state window indicator becomes a dual channel (the bench user's design call, 2026-10-19 — born from the first live trial of the tier): the 2026-10-19 bench test caught the 4.4.0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
2026-10-20 4.5.4: the CH,5 menu-state push makes Hub remote control two-way (physical navigation reaches the app; the remote's one remaining one-way gap):
    The remote's drift anatomy, closed at the source. App-driven presses
    already reconcile from device truth — 4.5.1's CH,0:0 poll after every
    press fixed the refused/dropped-press drift (the LK locked page). What
    never rode the wire unprompted was PHYSICAL navigation: a Next/Select
    pressed on the Hub itself, a joystick-driven menu step, or the
    inactivity timeout redraws the OLED with no serial traffic, so a mirror
    left open in LipSync Connect drifts until the next app press or a
    manual Open-resync. Settings changes made on the Hub already push as
    MANU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
2026-10-22 Audit follow-up: one owner for the boot bus, per-flow center-ack initiators, and the dead code gone. The full fresh-eye audit of the 4.2.0-4.5.4 line against main verified every commit's claim at the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
    (1) THE BOOT BUS GETS AN OWNER. checkI2C() ended with Wire.end() — scanner-example residue with no consumer — disabling the TWIM peripheral behind itself, and the firmware only worked afterwards because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
2026-10-22 Firmware 4.5.5: the second fresh-eye audit follow-up — the safe-mode dwell's null menu, per-flow calibration acks, and the serial-API honesty edges
    The full line re-verified against main once more, this time with a host-side regression suite locking the timer pool (Build_Files/Firmware_Files/host_tests, ASan/UBSan, 86 checks — the real LSTimer.h compiled on the host: zero-delay intervals never fire at t=0, startDelay offsets only the first fire, disabled anchors resume without burst-firing, negative ids are harmless counted no-ops, stopwatch slots are never stolen, pending method timers cannot collide). One major finding and eight minor ones, each closed at its root cause:
    - The safe-mo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
2026-10-23 4.5.5 verification follow-up: the audit's own fixes audited against the app's wire contract, three gaps closed at the source. The full 4.5.5 delta was re-verified line-by-line against LipSync_Connect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
2026-10-24 4.5.6: the cold-boot freeze hunt closes its fixable findings — the hair-trigger reset, the dead once-guard, and the error-path PWM sequencing — with the platform's persistence facts finally documente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
2026-10-25 Vendored libraries: Wire bounded-wait semantics fixed + XENSIV wrapper propagates write results
    Wire fork (4.5.7 review): the STOP/SUSPEND waits exited early on
    EVENTS_ERROR, returning before the STOP completed on the wire — the next
    transaction (microseconds later) landed mid-STOP, timed out the full 50 ms,
    and fired a spurious recovery on a perfectly healthy bus, once per poll of a
    merely absent device, while a stale EVENTS_STOPPED permanently disarmed the
    read path's STOP wait and the polluted recov=/bus= telemetry fed the freeze
    hunt noise. Upstream's wait-for-STOPPED semantics restored (data-phase waits
    keep the upstream early exit); every call now shares ONE 50 ms deadline
    across its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
2026-10-25 LSTimer: pool hardening + host suite grown to 149 checks (ASan/UBSan)
    Pool fixes (4.5.7 review): numRuns SATURATES at MAX_INT instead of wrapping
    (a maxNumRuns of 65535 silently became RUN_FOREVER); a 0-interval
    RUN_FOREVER registration is refused at the source (delay 0 is always
    elapsed and previousTime += 0 never advances the anchor — a main-loop
    livelock that still feeds the watchdog); a nested run() on the same pool
    can no longer double-fire a due RUNONLY slot (the toBeCalled mark clears
    before the callback); RUNANDDEL stays INVOKE-then-delete — a reviewed draft
    freed the slot first so a self-rearming callback could survive a FULL pool,
    but review proved deleteTimer's memset zeroed n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
2026-10-25 Input state machines: glitch-latch fix, sip/puff hysteresis + health gating, power-safe buffer storage
    LSInput: the reaction-time filter inverted into a GLITCH LATCH — a press
    visible for less than one reaction window matched no branch of the state
    machine's else, so the STALE state was re-pushed with the timer restarted
    every tick: quick taps silently eaten until a >=2-tick press, the LM=3 LEDs
    showing a held input that wasn't, and a glitch on one jack merging with a
    real press of another into the S13 combo row (a phantom START_MENU on
    release). A sub-reaction press is now discarded as the glitch the machine's
    own definition says it is. Also: integer shift instead of pow(), the clear()
    sh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
2026-10-25 Joystick: hold-last-value failure semantics, allocation-free sensor recovery, wrap-safe backoff
    Failed reads = hold last reading (4.5.7 review): a failed getMagneticField()
    left x/y/z at 0.0 and the discarded bool processed that as a real centered
    reading — a flaky bus stuttered the cursor to false-center with no fault
    signal (the retired TLV493D fork held last-good values). The bool is now
    honored at all four call sites (update, Z-latch sampling, center buffer,
    corner reads).
    Persistent failures (5 consecutive) re-issue the sensor's
    master-controlled-mode configuration via setDefaultConfig() — an earlier
    draft called begin(), which mallocs the register-map and bus objects with
    no free,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
2026-10-25 Firmware 4.5.7: the full-codebase review fixes — boot, flows, persistence, screen, witness, wire state
    RELEASE HYGIENE: the 4.5.6 tag shipped the bench's witness-build heartbeat
    (its own comment said 'not the release behavior'; CHANGES claimed healthy
    boots print nothing — every boot printed ~105 HB lines for 90 s). The
    released contract stands: degraded boots print the 5 s forensics line,
    healthy boots print nothing.
    MODE/COM: the serial OM,1 mode change was DEAD CODE (the global was
    assigned before changeOperatingMode compared it — the reset-on-change never
    fired, so a mouse->gamepad switch left the gamepad HID never-begun while
    reports went out the mouse interface); SAFE (3) is no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
2026-10-25 Bench fixes: CM,1:2 hang + the device factory-resetting itself via phantom menu navigation
    First hardware session on 4.5.7 (log 2026-10-25): CM,1:2 consistently
    dead-hung the device before its ack (30 s watchdog death every attempt),
    and the watchdog-flag safe boots then PHANTOM-NAVIGATED the safe menu into
    Restart/Factory Reset and CONFIRMED — MANUAL CH,5 pushes with the app idle
    showed the device walking itself into a factory reset. The repeating 'tone'
    was the shutdown sound each cycle.
    CM,1:2 hang: setLedDefault() ran before the hand-off's btmouse.begin() and
    called Bluefruit.connected() on a SoftDevice that was never begun — it
    never returned. LSBLEMouse::isConnected() now returns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
2026-10-25 4.5.8: CM,1:n is reset-on-change — the live USB<->BLE hand-off is removed after the bench dead-hung it twice
    Second hardware session (log 2026-10-25 06:40): CM,1:2 hung the device
    again with no ack — the flashed binary was the FIRST 4.5.7 build (both said
    4.5.7 on the wire; the version constant is bumped to 4.5.8 so the fixed
    build is distinguishable). Rather than patch the live hand-off a third
    time, it is REMOVED: a com-mode change now saves, acks, and software-resets
    — the exact flow the bench validated live twice for OM,1:x. No runtime
    SoftDevice enable exists anymore; BLE begins only at boot (before the
    witness arms — the witness picks its priority SD-aware: 0 on USB-only
    boots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
2026-10-25 4.5.9: the BLE boot speaks — boot trace + fail-loud BLE init (the first real CM=2 boot on this line loops; make it name its death site)
    The 4.5.8 reset-on-change flow verified on hardware (CM,1:2 acks and
    resets), but the first real CM=2 BOOT on this firmware line loops fast
    (boot tone -> reboot, never settling, serial unreachable). The cycle's
    shape rules out the watchdog and hang-witness classes (both self-settle
    into safe mode) and points at the FAULT class — the core's HardFault
    handler is an instant reset, so a BLE boot that faults reboots into an
    identical BLE boot forever. Every prior CM=2 boot on this line was a
    safe-mode CDC-only boot that never touched Bluefruit, so the boot-ti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
2026-10-25 4.5.10: the BLE boot fault root-caused and fixed — the init moves to its own 16KB-stack task
    The bench session pinned it: gamepad boots work, CM,1:2 acks and resets
    cleanly, and the BLE boot loops. The trail on every dying cycle reads
    pt=4 (the boot-center LED feedback is the last stamp) — the fault lands
    ~2.6-4 s in, around readyToUse and the first btmouse.move, not inside
    Bluefruit.begin. The mechanism: the core's loop task runs ALL of setup()
    on a HARDCODED 4096-byte stack with no functioning overflow detection, and
    the BLE boot alone adds kilobytes of call depth (SoftDevice enable, GATT
    table, HID service, advertising). Silent stack corruption -> delayed
    HardFault -> the core's insta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
2026-10-25 4.5.11: BLE boot stable but a stage fails — attach USB after the SD enable, and the failing stage now names itself
    The 4.5.10 repeating header finally spoke: 'ble=3' — the 16 KB init
    task held (no fault loop; settings, menu, restarts all work), but a BLE
    init stage failed, so no advertising, nothing to pair. The stage's own
    print was CDC-discarded before the port opened.
    Fix candidate from the core source: Seeed's bluefruit.cpp calls the
    Adafruit USB-coexistence hooks (usb_softdevice_pre/post_enable) around the
    SoftDevice enable, but they are defined nowhere in this core — nothing
    coordinates an attached USB device with the SD enable, and our BLE boot
    was the one boot that attached US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
2026-10-26 4.5.12: bulletproof the BLE verdict capture + fix the advertising payload margin
    Bench round 6: BLE boots are now stable AND connectable (settings, menu,
    live views, restarts all work over USB on a BLE boot), but the mouse
    still does not appear in Bluetooth, and the st= verdict was lost to the
    TinyUSB CDC discard window — writes before the host opens the port are
    dropped, and every repeating tick fell there.
    Capture now bulletproof: the FIRST host byte of any session prints the
    BOOT header one final time (lands in every app log right after connect,
    carrying rst/pt/pm/ble=/st=), and a failed BLE init counts as degraded —
    the 5-second heartbeat carries ble=3 st=<stage> for the whole sessi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
2026-10-26 4.5.13: fix the witness-priority boot hazard on BLE boots + guard the SD-leftover case + a visible BLE status LED
    Bench round 7: 4.5.12's capture worked — every BLE boot reads ble=3 st=1:
    the SoftDevice enable (Bluefruit.begin) is the failing stage. The user's
    LED observation corroborates (the BT LED only lights after a connection;
    with init dead the device is dark).
    Root cause, primary theory: initHangWitness's arm-time shortcut
    ("needsInitialization false <=> stack already begun") was written for
    the pre-4.5.10 world and 4.5.10 silently broke it — the BLE init moved to
    a task that starts at the END of setup, AFTER the witness arms. On every
    BLE boot the witness took priority 0 (init m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
2026-10-26 dist: ship the stock blehid_mouse control build as a DFU zip too (the app's UM update flow — the bench unit's double-reset/drag-drop path is unavailable)
2026-10-26 4.5.15: the 0x1001 decoded — TWIM at SD-reserved priority 3; Wire fixed at source + a pre-enable NVIC sweep
    Bench round 9: the 4.5.14 probe spoke — pstep=1 pcode=0x1001,
    NRF_ERROR_SDM_INCORRECT_INTERRUPT_CONFIGURATION: the SDM refuses the
    enable if any ENABLED interrupt sits at an SD-reserved priority (0-3).
    The offender: the vendored Wire enables TWIM0/TWIM1 at priority 3
    (inherited verbatim from the upstream core — V4.1 used the same 3),
    and our BLE boot reaches the init task only AFTER the screen/sensor
    polling has enabled it.
    One consistent story closes the hunt: the stock example works because
    it never touches Wire; 4.1.0's BLE worked only because its
    Bluefruit.begin() ran BEFORE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
2026-10-26 4.5.16: the probe becomes a complete begin() mirror — the USB/SD coexistence hooks were the missing piece
    Bench round 10: two stories. (1) The device's fail tones + dead mouse is
    the INTERFACE CABLE left unseated by the enclosure surgery — sns=0000,
    bus=1 recov=0, the classic signature; reseat + recalibrate. (2) The BLE
    0x1001 hunt: 4.5.15's sweep demoted USBD (the core runs it at priority 2
    by design) and the probe still failed — the offender is the error's
    other branch, 'having enabled SoftDevice interrupts': the core's
    usb_hardware_init enables the POWER_CLOCK interrupt (the SD's own
    shared line) for VBUS monitoring, and the SDM refuses while it is on.
    Stock's begin() passes because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
2026-10-26 4.5.17: the priority model, corrected by the bench — S140 reserves {0,1,4}, not 0-3
    Bench round 11: the cable reseat worked (sns=0000 -> 1110 -> 1111, mouse
    works again), but the hooks+probe STILL failed 0x1001 with the sweep's
    USBD demotion — while stock passes the same enable with USBD at
    priority 2. Reconciliation: the core's own TinyUSB port comment, taken
    literally — 'Priorities 0, 1, 4 (nRF52) are reserved for SoftDevice'.
    The actual S140 6.1.1 reserved set is {0, 1, 4}, and every failing BLE
    boot in the hunt carried an enabled interrupt at exactly 4: the 4.5.13
    witness (TIMER3@4 blocked sd_softdevice_enable on every BLE boot since
    4.5.10 — the true root cause, older than every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
2026-10-26 4.5.18: retire the probe dance + restore the stock attach order — the maximally stock-shaped BLE boot
    Bench round 12: the central battle is won — pstep=11 pcode=0x0
    need=0x20002D80 bad=0 dem=0: the whole SoftDevice sequence passed, 0x1001
    is dead, the {0,1,4} reserved-set model is confirmed, and begin() succeeded
    for the first time on this line. The failure moved downstream to st=2
    (DIS begin) with an SD fault-reset behind it — the reboot cycle.
    Both remaining deviations from the working recipes are our own: the
    probe's double-enable dance (enable -> BLE up -> disable -> begin()'s
    second enable — a double LFCLK cycle no working recipe performs) and
    4.5.11's deferred USB attach (buil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
2026-10-26 4.5.19: capture the raw DIS/HID begin error codes (the expert consult's decisive gap, closed without lib surgery)
    The expert consult matches the committed 4.5.18: the manual
    disable/re-enable cycle spliced into a running Bluefruit instance is
    unsafe (app-side semaphores/tasks/service registry are not
    reconstructed by a stack restart) — retired; USBD@2 is legal under
    S140 (reserved {0,1,4}) — confirms the 4.5.17 model; 0x1001's two
    documented conditions match the bench; RESETREAS=0x4 is SREQ, the
    software-reset-request bit, whose cause only the pt= trail can name.
    The consult's decisive missing evidence was the raw
    sd_ble_gatts_service_add() value — and BLEDis::begin()/
    BLEHidAdafruit: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
2026-10-27 4.5.20: reset-proof BLE verdict — the dying boot's init state persisted to flash, reported by the survivor
    Bench round 13: USB mode fully healthy, but the CM,1:2 BLE boots now die
    faster than the host can open the port — every captured BOOT line came
    from the post-cycle SAFE boots (ble=0), and the st=/rc= instrumentation
    was being lost with each dying boot. The capture gap moved from the
    serial DTR window to the reset itself.
    The init task now persists its verdict to the settings filesystem at
    entry and at every exit path (/bleverdict.dat, magic-framed 8-byte
    record, one-shot); the next boot consumes it and prints pst=/prc= on
    every BOOT/HB line. pst=0 = died DURING begin; pst=1..4 = fa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
2026-10-27 4.5.21: regression fix — the BLE task never touches the filesystem; the loop owns the verdict persist
    Bench round 14 caught 4.5.20's own regression: after the CM,1:2 cycle
    the survivor read IN=0.00|0.00 CA=0.00|0.00 CM=1 — the settings file was
    re-seeded (calibration wiped, mode reverted to default), where round
    13's 4.5.19 survivors kept live calibration. bleVerdictPersist() ran
    on the BLE init task and opened LSMEMORY.h's ONE GLOBAL shared File
    handle concurrently with the loop's settings writes — two tasks, one
    stateful handle, corrupted filesystem.
    The task now only raises g_bleVerdictDirty (entry + every exit path);
    the loop — already the sole owner of every FS operation — pe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
2026-10-27 4.5.22: the device rescue — a RECOVER build that formats the torn filesystem, plus the regular build for after
    Bench round 15: after the 4.5.21 UF2 flash, the device shows power +
    USB enumeration but pre-tone silence — no boot sounds, no screen, no
    protocol. USB enumerates because the core's TinyUSB init precedes
    setup; the silence means the boot dies at the first settings-filesystem
    operation: the zombie phase's witness-kills-mid-write left LittleFS's
    metadata torn beneath the 4.5.20-corrupted file.
    dist/LipSync_Firmware_4.5.22_RECOVER.uf2 (CONF_FS_FORMAT_ON_BOOT=1,
    version string 4.5.22R): formats InternalFS before the mount — a fresh
    filesystem heals the boot; the settings re-seed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
2026-10-27 4.5.23: the init hunt is over (st=5 pst=5 — advertising runs); the fault discriminator captures what kills the boot after
    Bench round 16: the user's capture reads ble=2 st=5 pstep=12 pst=5 —
    every dying BLE boot's init FULLY SUCCEEDS. The double-enable dance was
    the DIS killer (the expert consult's #1); lifecycle fix confirmed. The
    remaining fault: the boot dies seconds AFTER init — ~0.3s after the
    host speaks (pt=7) or ~10-15s idle (pt=4), rst=0x4 pm=0, in
    loop-context with the SD running.
    The stock HardFault_Handler is a weak spin-loop (overridden — verified
    by nm) and the SD assert path resets itself — the two candidate
    classes are indistinguishable with every prior instrument.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
2026-10-27 4.5.24: the SD's own assert handler is instrumented — the SoftDevice now names the violated invariant
    Bench round 17: pm=0 fp=none on every dying BLE boot (st=5, advertising
    running) — no HardFault, no witness, no softwareReset. By elimination
    the killer is the SoftDevice's own assert path: the stock core
    registers an EMPTY fault handler at CFG_DEBUG=0 and the SD resets the
    chip the moment it returns, discarding the SD's own assert file/line
    with every death since round 12.
    Bluefruit52Lib is vendored (the repo's fork pattern; byte-identical to
    the core's 1.1.13 copy except ONE function, README documents it; the
    vendored copy verifiably wins the link). nrf_error_cb now prints
    'SDFAULT id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
2026-10-27 4.5.25: the SD assert location survived — fp=0xA000 names the SoftDevice's own flash; flush the fault print so the SD's file/line lands on the open port
    Bench round 18: fp=0xA000 on the successor of a dying st=5 BLE boot —
    below 0x26000, INSIDE the SoftDevice's own code region: the SD
    asserted internally and reset. The SDFAULT print (the SD's own assert
    file/line) didn't land — the death happened with the port closed and
    the bytes sat unflushed in the CDC buffer.
    Serial.flush() now runs in both fault handlers — tud_cdc_write_flush
    drives the USBD peripheral directly, so the transfer completes on the
    wire even from the fault context. On the next session's port-open
    deaths (the ~0.3s-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
2026-10-27 4.5.26: the SDFAULT decode names it — APP_MEMACC via the String copy ctor, garbage heap pointer; the 4KB loop stack is the prime suspect and sw= measures it
    Bench round 19: the flush worked and the SD's own fault line landed:
    'SDFAULT id=0x1001 pc=0x5D368 info=0x1'. id=0x1001 =
    NRF_FAULT_ID_APP_MEMACC — a disallowed write into SD-protected
    peripheral space, at pc=0x5D368 = the Arduino String COPY CONSTRUCTOR:
    a String writing through a garbage buffer pointer. Memory corruption
    exploding through a corrupted heap object, in loop context, at the
    serial-dispatch and screen/LED paths — exactly the two death sites.
    Concurrency ruled out at the source: --wrap=malloc IS in the link
    flags (pla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
2026-10-28 4.5.27: THE ROOT CAUSE, FOUND AND FIXED — the boot-trail forensics were the killer (raw GPREGRET2 writes into the SD-restricted POWER peripheral); all retention access now routes through the sanction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
    Fable 5.1 second-opinion consult, with disassembly: every
    bootTrailStamp writes NRF_POWER->GPREGRET2 raw; POWER is
    SoftDevice-restricted; with the SD up the S140's memory-watch unit
    flags the write (APP_MEMACC 0x1001), and per nrf_sdm.h:283 the
    reported pc may sit up to 2 instructions past the store — at the
    callee's entry. The 'killers' the bench read (String ctors, blinkLed,
    NVIC_SystemReset) were bystanders; the stores before their bls were the
    stamps in the callers. The 4.5.6 fore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
2026-10-28 4.5.28: CONFIRMED WORKING ON HARDWARE — Bluetooth mode stable, discoverable, pairable, dual-mode with serial; fix the connected-transition LED race the bench reported
    Bench round 21: the 4.5.27 fix is confirmed — the BLE boot is fully
    stable (blue scan blink, pairs, serial protocol runs alongside the
    live link; settings, menu, restarts, CM round-trips all worked with
    the radio up). No SDFAULT, no reboots, no heartbeat. 22 rounds, one
    consult, one root cause.
    The only reported item, fixed: after pairing the LED went dark
    instead of solid blue (setLedDefault's second live isConnected()
    query transiently disagrees mid-handshake — the host connects/drops/
    re-bonds around the exchange —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
2026-10-28 4.5.29: release hygiene — the 'healthy boots print nothing' wire contract is restored; every bench instrument is now conditional, nothing deleted
    The 4.5.9-4.5.12 instruments carried their own expiry note:
    'deliberately breaking the contract until the BLE boot is
    bench-cleared' — cleared at 4.5.27. The contract stands again:
    - The first-host-byte BOOT forensics line prints ONLY when the
    previous boot ended abnormally (witness marker pm, captured fault
    page fp, failed BLE verdict pst=0..4, or LOCKUP bit — watchdog
    deaths already boot safe mode and the HB line reports them).
    Power-on, reset pin, deliberate CM/OM/SR/menu/UM resets, healthy
    BLE boots: silent.
    - The 30s repeating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
2026-10-28 4.6.0: minor bump + LED scan-blink timer deletion on BLE connect transition (fixes dark-until-event LED)
2026-10-28 4.6.1: PV,0:0 on a missing-pressure-sensor boot HardFaulted (null i2c_dev chain, pm=2 pt=7 fp=0xE000) — both sensor objects now gate all driver I/O on a _begun flag; baseline session proves the 4.5.6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
2026-10-28 ci: fix the firmware-binaries publish for committed-dist tag trees — the bench rounds commit dist/ into the tree, so the fresh release staging made the checkout dirty and switch --orphan refused (V4.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
2026-10-28 firmware: harden safety and robustness across core modules
    - Buffers/timers/inputs: null/empty/bounds guards, value-init, safe destructor
    - Sensors: pressure health/reprobe + offset gating; joystick read contracts, bus backoff, recovery, calibration bounds
    - Comms: non-blocking HID, BLE init guards, API parsing + ID fallbacks
    - Storage: stricter JSON validation, crash-safe writes, better errors
    - I/O/UI: LED bounds, menu text guards, switch remap bounds
    - Misc: watchdog/boot flow tweaks, no unsafe strcpy/sprintf/malloc
2026-11-01 Firmware 4.6.5: harden pressure sampling with P_DA freshness gate
    - Require a fresh P_DA conversion from both pressure sensors on every
    sample, so cooperative-timer catch-up cannot consume one 25 Hz
    conversion twice and satisfy the two-sample sip/puff qualifier.
    - Treat 500 ms without a complete fresh sensor pair as a conversion
    stall even while I2C still ACKs; cancel any active hold and enter
    the existing bounded re-probe recovery path.
    - Replace readAmbientPressure() with readFreshPressure(), a shared
    exact-length STATUS + 24-bit transaction used by both sensors.
    - Rebuild the 4.6.5 HEX/UF2/DFU artifacts and regenerate
    firmware-manifest.json with matching sizes and SHA-256 hash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
2026-11-02 4.6.6: the review-round fix set — three majors closed. (1) The 4.6.5 fault-suppression stranded the DRAG/SCROLL latch: a sensor fault mid-hold emits no RELEASED, so the held mouse button and canOutpu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
2026-11-03 4.7.0: Hub-menu pages for the hard sip/puff band (upstream #58, on-device half)
    The Hub's Sip & Puff submenu gains Hard Sip and Hard Puff rows (pages
    543/544), appended in front of '... Back' so every pre-4.7.0 row keeps
    its index; each opens the same coarse 10-level adjust page as the
    regular thresholds. A step can never land below regular + margin:
    Decrease clamps at the floor (the setter refuses below-floor writes)
    and a value stranded by a regular raise heals on page entry.
    healHardThresholds() also runs after every regular-threshold step, so
    the pair can never silently go out of order from the menu — the band
    the OLED shows is always the band that fires (same rule as the boot
    heal); e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
2026-11-03 #16 multi-host Bluetooth: Phase 1 design doc (peripheral-only bond switching; central ruled out with citations; no code)
2026-11-03 #16 multi-host BLE: pure host-switch decision layer + host tests (LSHostSwitch.h, the LSPressureClassify pattern) — 141/141 core under ASan/UBSan
2026-11-04 #16 multi-host BLE: Hub-menu pages — Bluetooth host list (page 62, More row 10, Back keeps its index), switch confirm + dwell execution, forget list with the hold-to-confirm gate, named refusal notes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
2026-11-05 4.8.0: multi-host Bluetooth switching (upstream #16) — version bump + CHANGES
2026-11-05 #16 multi-host BLE: numbered bench script (Q10) — B0-B11 pass/fail prompts, per-OS result log, B4 as the whitelist-contingency go/no-go
2026-11-05 4.8.0 release prep: refresh the tracked source ZIP to the branch tree — rebuilt with the workflow's exact recipe (rm + zip -r -X LipSync_Firmware Libraries, .DS_Store excluded); 185 files verified by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
2026-11-05 4.8.1: the review-round fix set — a full review/fix loop over the 4.8.0 tree (multi-host surface + hard-band evaluator + every module group), three major defect classes closed plus the round-2 harden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
    MAJOR, CURSOR RACE ON A DEGENERATE RADIUS (LSJoystick/LSMemory): mapFloatInt's zero/non-finite-range guard returned outputStart — FULL THROW for the only call shape (the symmetric cursor map) — so every radius-degeneration path (uncalibrated boot with a failed/refused center, a c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
2026-11-05 4.8.1 delta-verification: two comment-accuracy fixes from the adversarial pass over the fix set — the boot-baseline residual is now documented EXACTLY (an absorbed sub-3.0 hold with a lowered thresho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
2026-11-05 bench script: point the B0 identity check at the shipped version — the tree is 4.8.1 (4.8.0 prep + the review-round bump), so VN,0:0 answers SUCCESS,0:VN,0:4.8.1; B11's re-upgrade step follows
2026-11-06 4.8.2: the review-round fix set — dead config knob removed, upstream posture completed, bench identity gate de-hardcoded. Firmware source changes are comment/dead-code only (CONF_BLE_INIT_USB_ATTACH_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
2026-11-06 4.8.2 round-3 review: comment-accuracy + README release-state fixes (no behavioral delta). LSAPI.ino: doFactoryReset's witness-exemption comment still described the pre-4.5.7 ~22-sequential-writes sh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
2026-11-08 4.9.0: the review-loop fix set — production-ready release tree
    Full review/fix loop over the 4.8.3-4.8.18 bench work (switch window,
    HID watchdog, every module group, the paired LipSync_Connect tree).
    Majors closed:
    - RPA target admission in the switch-window bouncer (iOS privacy hosts
    no longer bounced for the whole window; IRK resolution via
    sd_ecb_block_encrypt with the ah() byte order host-pinned; bond grace
    only when the bond carries no IRK; decidable non-targets bounce in ms)
    - Stuck-neutral ERROR line now covers the post-recovery class (a re-seated
    mouthpiece could hold the primary input inert with zero wire trace);
    time-based one-per-real-minute reporting
    - DFU watchdog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
2026-11-08 4.9.0 round-3: delta verification closures
    - Deferred advertising restart after a window ending (the SD
    ADV_SET_TERMINATED event-pending gap could leave the radio silently
    off: stop() refused against a stale _runnning flag, the one-shot
    ensure probe fooled, the event then clears without restarting).
    lsHostServiceSwitchWindow services the pending flag per loop pass;
    armed by close/cancel, cleared by a new window or a host connect.
    - healHardThresholds gates both sides of each comparison (failed
    settings2 read's fabricated hard default -> FAIL,3 spam on every
    hard-page entry; failed settings read's fabricated regular default
    -> bogus persisted raise).
    - Doc corrections: pressur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
2026-11-10 4.9.1: the round-1 review fix set — read-truth getters, witness priority, adv-restart pending, safe-mode CH,1, atomic reseed + app fail-fast paths
    Eight parallel adversarial reviews over every firmware module group + the
    app protocol layer; closures in CHANGES.txt 4.9.1. Majors: failed settings
    reads no longer act live (SD/MA/LK/CF/WS/WL/WM/SS/ST/PT/HS/HP/IZ/OZ/SA-GC/
    HA-HB answer in-force values), hang-witness priority vs the leftover-SD USB
    boot, the adv-restart pending flag's stale isRunning() clear, CH,1 vs the
    safe-mode menu, the boot reseed's append trap, the app's 45 s calibration
    abort hang and the non-atomic BT table load. Compile clean at --warnings
    all (45%/24%); host 182/182 +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
2026-11-10 4.9.3: open-door window restored (the directed trial's verdict) + the ALREADY_ACTIVE blatant-case note — bench-green
    - The 4.8.17 directed experiment stayed in the tree when 4.9.0 committed; it failed with both hosts on the wire (Windows ignores directed packets; the iPhone cannot establish through a directed set). The window is stock open advertising + the 4.8.12 bouncer, with 4.9.0's RPA tick resolution doing the target decision — bench-proven 2026-11-10: an iPhone RPA admitted 1.1 s into an open window, and the same RPA excluded (bounced) when the Mac was the target.
    - finishBtSwitch distinguishes the ALREADY_ACTIVE causes via the render-time capture (_btSwitchTargetWasActive): the bl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
2026-11-11 4.9.4: the review-loop fix set — seven majors + two minors, all verified (188/188 core + 168/168 timer, --warnings all clean, ZIP 185/185) — 9 fix-set audit rounds + the full vendored-fork/script/CI/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
    FIRMWARE (7 majors, CHANGES.txt carries each in full): the switch window's keep-open was DEAD CODE (lsHostEnsureAdvertising refuses while a window is open — after one bounce the radio went dark for the window's remainder and the target could never connect; now starts the set directly); the UM,1 ack could be lost to the reset (4.9.1's drain never back-ported to enterUpdateMode's dwell — the app blocks on that ack); the bouncer's connect/drop storm was narrated as real host change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
2026-11-11 bench-16: B13-B15 — the 4.9.4 switch-window interaction steps on radio
    B13 bounce-then-target (the keep-open fix: a forced non-target reconnect must bounce, then the target must still be admitted INSIDE the same window; also observes the absence of bounce-storm narration — no LED scan-blink flicker, no BT,4/BT,5 flap). B14 calibration/window mutual exclusion both directions (CA,1 refused mid-window with the named ERROR line; BT,1 refused mid-calibration). B15 reset mid-window (CM/MP software reset and UM,1 with a window open: clean reset, no unattributed forensics, ack-before-port-drop for UM).
    These three steps put the code-proven-only seams of the 4.9.4 fix set on real radio — the s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
2026-11-12 dist: add the 4.9.4 DFU package (LipSync Connect 'Flash local file' artifact) — same clean build as the committed UF2 and hex; manifest verified (dfu 0.5, S140 6.1.1 req)
2026-11-12 bench-16 B13-B15: 4.9.4 interaction validation — ALL PASS on radio
    B13 the keep-open fix proven live (80 consecutive bounces with the window alive through every one; then target admitted 2.0 s into a window, immediately after a real racer bounce — the exact seam, now radio-proven). B14 both directions + the IN,1 twin (named refusals verbatim). B15 reset mid-window: ack-before-port-drop, silent healthy boot, bonds intact. Round-3 narration gate held through the 80-bounce storm (no LED flicker, no BT,4/BT,5 flap). The standing caveat from the 4.9.4 fix set is closed; UM variant noted covered-by-analogy.
2026-11-12 4.9.5: the final-diff-audit fix set — the mid-window latch crossing (minor) + 6 claim-accuracy corrections (nits)
    The fresh-context adversarial pass over the shipped 4.9.4 diff (4 reviewers + per-finding verification, 11 agents) confirmed 7 findings, zero majors.
    MINOR (real, fixed): the round-3 window gate reintroduced the latch-crossing class by a new route — the guard keyed on !tempIsConnected is suppressed for the whole window, the input polls stay live, so a gesture engaged MID-WINDOW armed the latch, and on the success path tempIsConnected never reads false again: the latch crossed into the new host and swallowed its first input (SCROLL half unguarded end-to-end — cursorScroll s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
2026-11-12 bench: 4.9.5 regression validation — 11/11 wire-settled steps PASS
    Full bench re-run on the released 4.9.5 (B0/B1/B2/B3/B5/B7/B8/B9/B11/B14/B15), driven over the wire with one process per the 2026-11-07 lesson. All pass: identity 4.9.5, three-row host table with one active, symmetric switch away and back (window opened, named bounces, target admitted with no host-side interaction), stable bond count across the round trip, EX,0 dump well-formed at 385/480 bytes, both calibration gates refusing with their named lines, and B15's reset-mid-window clean end to end (window open -> CM ack BEFORE the port drop -> silent healthy boot -> back in USB as commanded -> BLE return with all 3 bonds intact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
2026-11-12 4.9.6: the 4.9.5 latch guard is now host-tested — and the test found a real bug in it
    Closes the residual the 4.9.5 bench could not cheaply prove. outputAction has no wire readout, so radio-proving the mid-window latch guard needed a precisely timed physical SCROLL hold with only indirect proof (whether the next input emitted an IA,0 line). Instead the guard's decision is extracted as the pure lsHostLatchCrossedHost() (LSHostSwitch.h) and pinned by 9 host checks: no-latch is always a no-op, same-host keeps the hold, host-changed releases, none->host and host->none release, full-string not prefix equality, NULL-safe, plus the RPA-stability property the fix relies on.
    Writing those checks i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
2026-11-13 docs: README release status current (4.9.6 live) + tracker-count clarification
    Final pre-merge verification pass found the README still describing the 4.9.x line as 'pending its release tag' while V4.9.6 has been published (release assets + firmware-binaries branch verified live). Both stale sentences updated; one clarifying line added distinguishing the in-tree dist/ bench artifacts from the published release channel.
    CHANGES gains the 44/45 reconciliation note the verification pass flagged: the tracker's 45 open items are 44 issues plus PR #81; the posture lines' 'all 44' is exact.
    Docs only — no firmware source change, so no ZIP rebuild or re-tag (the source ZIP carries LipSync_Firmwa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
